keneth-urbizagastegui/S3G4-LAB/S3G4_LAB_rev2.1/03_simulaciones/DMM/AUDITORIA_CLAUDE_S11_1.md

# Auditoría de S11.1 (DMM, bloque 1: bornes y protección)

- Auditor: Claude Code, 7 oct 2026. Ejecutó: Codex. Contrato: `PLAN_SIMULACION_S11_1.md` (§3b, §3c y §7).
- Copia de trabajo: `C:\s11a`. No se ha tocado nada de Codex dentro de `DMM/`. Los scripts de la auditoría están en `DMM/chequeo_claude/` (`comparar_smoke.py`, `auditar_raw.py`, `extrapolar_nunca.py` y `extraer_hojas.py`). El lector `.raw` es propio y no usa `leer_raw_s11_1.py`.
- **Veredicto: el bloque NO se aprueba**, como dice el acta. Los fallos C1, C2 y C3 son físicos. El acta, además, se queda corta en tres puntos: no marca como fallo la TVS (potencia de pulso) ni la PTC (Imax), y C4 no es «orientativo», sino que no se cumple.

## 1. Reejecución

- La copia de `C:\s11a` es idéntica, byte a byte, a `ejecutar_s11_1.py`, `leer_raw_s11_1.py` y los dos `.inc`. Los modelos (OPA2188 y 74HC4051) se copiaron a `C:\s11a\models`, y la ruta se pasó con `S3G4_MODELS`.
- Resultado de `ejecutar_s11_1.py --smoke --keep-raw`: 14/14 casos `ok` en 71 s.
- `comparar_smoke.py`: en los 14 casos se compararon 3974 valores numéricos con `resultados/s11_1_smoke_mixta.csv` y con las mismas filas de `s11_1_campana_mixta.csv`. **Diferencia máxima: 0.** Ningún valor difiere más de 1e-3.
- Recálculo independiente desde el `.raw` con `auditar_raw.py`:

| Caso | Magnitud | Claude (.raw) | Codex |
|---|---|---|---|
| P3, R_S = 100 Ω, apertura a 20 ms, fase 0, 40 Ω | E de la TVS hasta 1 s | 1.8589 J | 1.85903 J (máx. del grupo) |
| P3, R_S = 330 Ω, ídem | E de la TVS / span máx. | 1.8590 J / 20.54 V | 1.85911 J / — |
| P3, R_S = 100 Ω, **nunca** (deck propio: `Brc` = 1) | E de la PTC / E de la TVS / disparo | 50.411 J / 3.2715 J / 35.67 ms | 50.4106 / 3.2715 J (`energias.csv`) / 35.67 ms (máx.) |
| P3 nunca | Extrapolación de 1 a 10 s (PTC / TVS) | 20.065 / 0.643 J | 20.065 / 0.643 J (rechazada) |
| P5, 0.5 Ω, R_S = 100 Ω, fase 0 | Pico de DF08S / I²t hasta 8.3 ms | 386.21 A / 603.68 A²s | 386.213 A / 603.676 A²s |

Todo coincide.

## 2. Netlists frente al plan (§1, §3b y §3c)

- **Valores.** Coinciden con el §1:
  - 3 × 33 kΩ y 3 × 3 MΩ – 900 kΩ – 100 kΩ;
  - 3.3 kΩ + 100 pF, 330 pF y 3 nF;
  - relé con Ron 0.1 Ω, Coff 1 pF y suelta a +3 ms;
  - fusible de 40 mΩ, derivador de 0.100 Ω y 10 MΩ hasta X5;
  - 1 µF por riel y 3 mA de carga total;
  - R_S ∈ {100, 330} Ω y PTC de 40 y 60 Ω.
- **Red.** La fuente es `325.269·sin(2π·60·t + fase)`, es decir, 230 Vrms a 60 Hz. ✔
  - En V/Ω, Rgrid vale 1 µΩ (red ideal, caso pesimista).
  - En el borne A, Rgrid vale 0.5, 1 y 2 Ω.
- **Modelo reducido.** Las páginas citadas se han comprobado:
  - OPA2188, p. 4: ±0.5 V y ±10 mA. ✔
  - 74HC4051, p. 5: VCC de 11 V, ±20 mA de sujeción y ±25 mA de canal. ✔
  - BSS84, p. 2: −50 V, ±20 V, −130 mA, −1.2 A y 300 mW. ✔
  - Las capacidades (OPA p. 5, HC p. 10) y la TLV2372 no se han comprobado una por una.
- **Reparo del modelo reducido.** Las protecciones internas se modelan como diodo ideal con Vfwd = 0.5 V y Ron = 1 Ω. Ese diodo es más «duro» que el BAV199, cuyo modelo tiene IS = 0.8 fA, así que **les roba la corriente a los BAV199 externos** (en P3, I(D2p) ≈ 0 e I(D2n) ≈ 1.3 mA). El reparto entre la protección interna y el BAV199 depende del modelo. Que haya inyección no depende de él (ver §6a).
- **Carga de los rieles en el modelo reducido.** Es solo resistencia entre rp y rn, 3 mA a 9.8 V. Los reguladores no absorben corriente: `REGSUP` es de un solo sentido, como un LDO real.

## 3. P3: estado del relé y de la fuente

Caso de R_S = 100 Ω con apertura a 20 ms:
- **Antes de la apertura**, |V(vin, ptin)| máx. = 0.77 V. Equivale a 7.7 A × 0.1 Ω: el relé está **cerrado** desde t = 0. ✔
- **A partir de t = 23 ms** (20 ms + 3 ms de suelta), I_PTC < 1.3e-7 A y la tensión en los contactos llega a 329.6 V: el relé **se abre**. ✔
- **Fuente.** I(Vsense)(0) = 1.000 mA, que es el estado declarado. Después, I(Vsense) se vuelve negativa (−5.8 mA a 1 ms): es el diodo de cuerpo del BSS84 conduciendo hacia el riel.

## 4. Energías

- Se integran sobre el tiempo simulado real, de 0 a 1 s. La parte extrapolada (de 1 a 10 s) va en columnas separadas. ✔
- **Desviación declarada:** no se corta en el disparo, sino que se simula siempre 1 s. Es aceptable y más conservador.
- **Artefacto en la validación de la extrapolación.**
  - Para el caso «nunca», Codex exige R_PTC ≥ 0.99 MΩ. El propio modelo autorregula en torno a R_PTC ≈ 21 kΩ (θ = 1.25, 10 mA rms).
  - Por eso **las 0/18 extrapolaciones válidas son un criterio inalcanzable**, no una falta de convergencia.
- **Mi extrapolación** (últimos 5 ciclos, dispersión del 5–9 %, así que solo es estimación):

| Pieza | Simulada 0–1 s | Extrapolada 1–10 s | Total en 10 s |
|---|---|---|---|
| TVS | 3.27 J | 0.64 J | 3.91 J (0.071 W medios, frente a 1 W continuo de la p. 2) |
| PTC | 50.4 J | 20.1 J | 70.5 J |
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
