keneth-urbizagastegui/S3G4-LAB/S3G4_LAB_rev2.1/03_simulaciones/DMM/ACTA_S11_1.md

# Acta S11.1 — DMM bloque 1

7 octubre 2026 · Codex · segunda reanudación, contrato PLAN_SIMULACION_S11_1.md §3b–§3c.

**Bloque no aprobado.** La finalización numérica no acredita supervivencia. No se cambiaron piezas ni se simularon remedios.

## Ejecución

Preflight P3: 1/1 ok en 38.044 s. Smoke inicial: 14/14 ok en 67.573 s; smoke tras corregir la carga externa apagada: 14/14 ok en 42.689 s; último smoke de estados con resume: 14/14 ok en 0.033 s, todos conservados por firma. Campaña final con resume: 570 casos, 536 ok, 1969.332 s de pared, diez trabajadores y límite 300 s/caso. `S3G4_MODELS`, `--resume`; prioridad P3, P2, P4, P5, P1, P6, P7. No se reintentaron los casos fallidos con otros ajustes.
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
