keneth-urbizagastegui/S3G4-LAB/hardware/Schematic_PFC-1_2026-07-04/POWER & BATTERY CIRCUITS.png

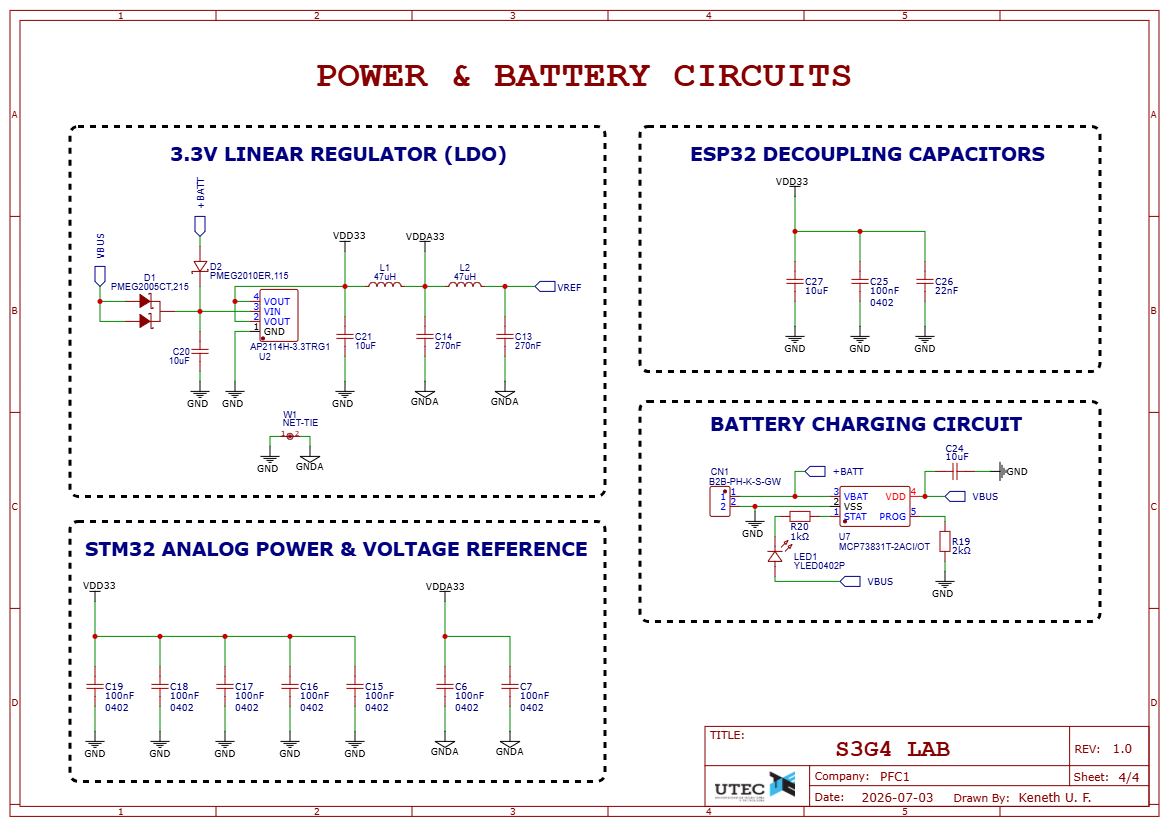
hardware/Schematic_PFC-1_2026-07-04/POWER & BATTERY CIRCUITS.png
