keneth-urbizagastegui/S3G4-LAB/S3G4_LAB_rev2.1/04_esquematicos/S8_CH1/vistas/ch1_1_entrada.png

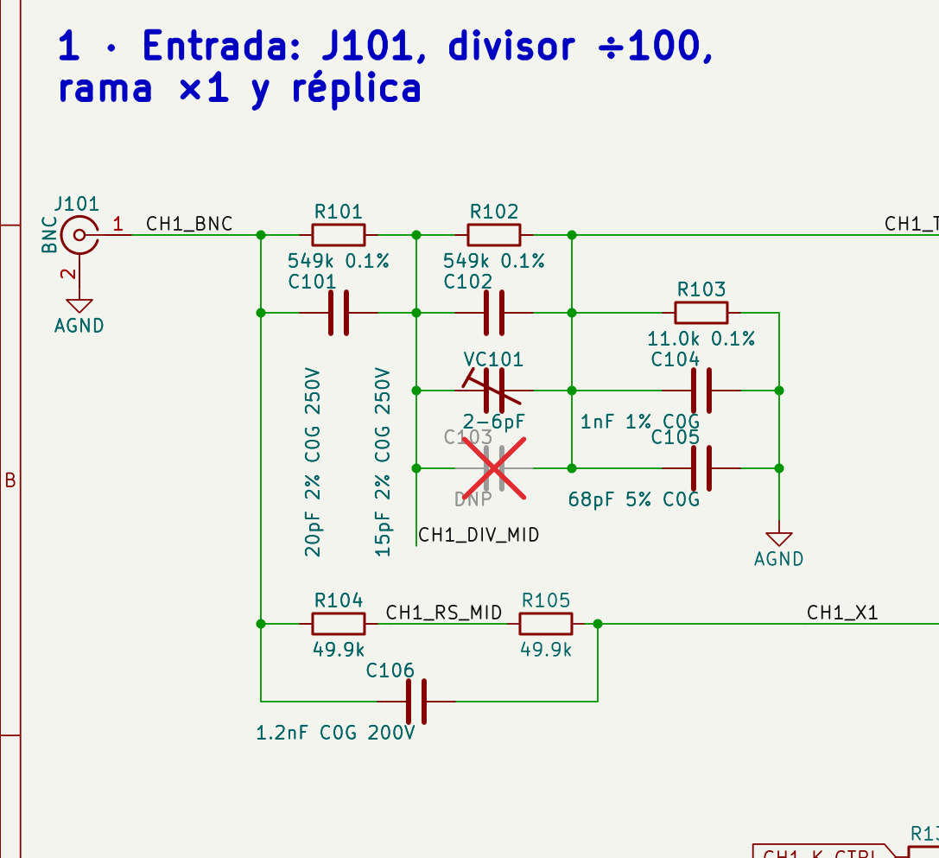
S3G4_LAB_rev2.1/04_esquematicos/S8_CH1/vistas/ch1_1_entrada.png
