keneth-urbizagastegui/S3G4-LAB/S3G4_LAB_rev2.1/04_esquematicos/S10_CH23/vistas/ch2_completa.png

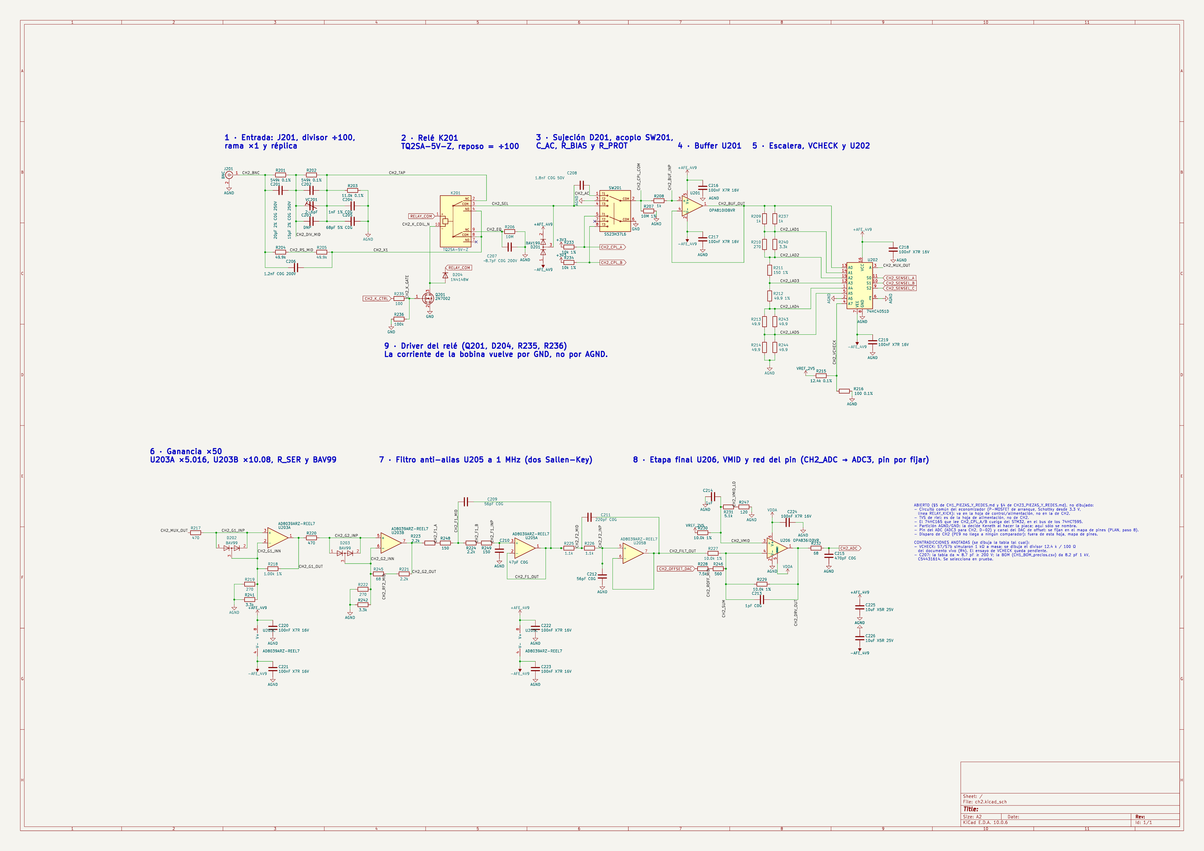
S3G4_LAB_rev2.1/04_esquematicos/S10_CH23/vistas/ch2_completa.png
