keneth-urbizagastegui/S3G4-LAB/TFT_8Bit_Capacitive/test_video_player/plan_antigravity/diseno_ui/referencia/png/AjustesAcercaDe.png

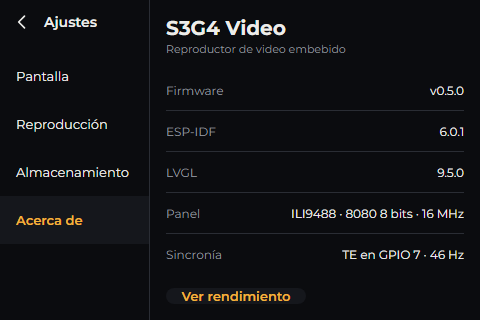
TFT_8Bit_Capacitive/test_video_player/plan_antigravity/diseno_ui/referencia/png/AjustesAcercaDe.png
