keneth-urbizagastegui/S3G4-LAB/S3G4_LAB_rev2.1/03_simulaciones/CH1_entrada/resultados/s1_criterios.csv

criterion | CT1_pF | POS | CPL | value | status
S1-C1 | 20 | 1 | DC | 0.999128 Mohm | PASA
S1-C2 | 20 | 1 | DC | Cin=26.707483 pF; delta=0.540300 pF | PASA
S1-C3 | 20 | 1 | DC | G=0.990260096; error=+0.014289% | PASA
S1-C4 | 20 | 1 | DC | [-0.172068, +0.023425]%; pico=+0.002034 dB | PASA
S1-C5 | 20 | 1 | DC | sobre=0.000000%; e2=-13.841978% | FALLA
S1-C1 | 20 | 1 | AC | 1.000288 Mohm | PASA
S1-C3 | 20 | 1 | AC | G=0.987201435; error=-0.294629% | PASA
S1-C4 | 20 | 1 | AC | fc=8.727515 Hz | PASA
S1-C1 | 20 | 100 | DC | 0.999119 Mohm | PASA
S1-C2 | 20 | 100 | DC | Cin=27.247783 pF; delta=0.540300 pF | PASA
S1-C3 | 20 | 100 | DC | G=0.00990807819; error=+0.000234% | PASA
S1-C4 | 20 | 100 | DC | [-0.153395, +0.040627]%; pico=+0.003528 dB | PASA
S1-C5 | 20 | 100 | DC | sobre=0.000000%; e2=-14.224288% | FALLA
S1-C1 | 20 | 100 | AC | 0.999120 Mohm | PASA
S1-C3 | 20 | 100 | AC | G=0.0098775801; error=-0.307578% | PASA
S1-C4 | 20 | 100 | AC | fc=8.802559 Hz | PASA
S1-C1 | 12 | 1 | DC | 0.999167 Mohm | PASA
S1-C2 | 12 | 1 | DC | Cin=22.747109 pF; delta=0.540305 pF | PASA
S1-C3 | 12 | 1 | DC | G=0.990260096; error=+0.014289% | PASA
S1-C4 | 12 | 1 | DC | [-0.172064, +0.023427]%; pico=+0.002035 dB | PASA
S1-C5 | 12 | 1 | DC | sobre=0.000000%; e2=-10.918397% | FALLA
S1-C1 | 12 | 1 | AC | 1.000348 Mohm | PASA
S1-C3 | 12 | 1 | AC | G=0.987201435; error=-0.294629% | PASA
S1-C4 | 12 | 1 | AC | fc=8.727515 Hz | PASA
S1-C1 | 12 | 100 | DC | 0.999159 Mohm | PASA
S1-C2 | 12 | 100 | DC | Cin=23.287415 pF; delta=0.540305 pF | PASA
S1-C3 | 12 | 100 | DC | G=0.00990806954; error=+0.000146% | PASA
S1-C4 | 12 | 100 | DC | [-0.128443, +0.063479]%; pico=+0.005512 dB | PASA
S1-C5 | 12 | 100 | DC | sobre=0.000000%; e2=-11.314979% | FALLA
S1-C1 | 12 | 100 | AC | 0.999159 Mohm | PASA
S1-C3 | 12 | 100 | AC | G=0.00987757396; error=-0.307639% | PASA
S1-C4 | 12 | 100 | AC | fc=8.802546 Hz | PASA
