keneth-urbizagastegui/S3G4-LAB/hardware/BOM_PFC-1_2026-07-04.csv

ID | Name | Designator | Footprint | Quantity | Manufacturer Part | Manufacturer | Supplier | Supplier Part | Price | Pins | Contributor | JLCPCB Part Class | link
1 | 100pF | C1,C2,C3,C4 | C0603 | 4 | CC0603KRX7R7BB101 | YAGEO(国巨) | LCSC | C519407 | 0.009 | 2 | LCSC | Extended Part
2 | 100nF | C5,C22,C23 | C0603 | 3 | CC0603KRX7R7BB101 | YAGEO(国巨) | LCSC | C519407 | 0.009 | 2 | LCSC | Extended Part
3 | 100nF | C6,C7,C15,C16,C17,C18,C19,C25,C28 | C0402 | 9 | FN15X104K500PKG | PSA(信昌电陶) | LCSC | C525226 | 0.009 | 2 | LCSC | Extended Part
4 | 270nF | C13,C14 | C0402 | 2 | TCC0402X5R274K250AT | CCTC(三环) | LCSC | C5448792 | 0.006 | 2 | lcsc | Extended Part
5 | 10uF | C20,C21 | C0603 | 2 | GRM188R61A106ME69D | muRata(村田) | LCSC | C90053 | 0.099 | 2 | LCSC | Extended Part
6 | 10uF | C24,C27 | C0603 | 2 | CC0603KRX7R7BB101 | YAGEO(国巨) | LCSC | C519407 | 0.009 | 2 | LCSC | Extended Part
7 | 22nF | C26 | C0402 | 1 | FN15X104K500PKG | PSA(信昌电陶) | LCSC | C525226 | 0.009 | 2 | LCSC | Extended Part
8 | 12pF | C29,C30 | C0402 | 2 | CC0402JRNPO9BN120 | YAGEO(国巨) | LCSC | C106201 | 0.003 | 2 |  | Extended Part
9 | 10pF | C31,C32 | C0402 | 2 | CC0402JRNPO9BN100 | YAGEO(国巨) | LCSC | C106199 | 0.003 | 2 |  | Extended Part
10 | 1uF | C33 | C0603 | 1 | FN15X104K500PKG | PSA(信昌电陶) | LCSC | C525226 | 0.009 | 2 | LCSC | Extended Part
11 | B2B-PH-K-S-GW | CN1 | CONN-TH_B2B-PH-K-S | 1 | B2B-PH-K-S-GW | JST | LCSC | C5251182 | 0.148 | 2 | lcsc | Extended Part | https://lcsc.com/eda_search?q=C5251182&%26type=1&ref=editor
12 | PMEG2005CT,215 | D1 | TO-236AB_L2.9-W1.3-P0.95-LS2.3-BR | 1 | PMEG2005CT,215 | Nexperia(安世) | LCSC | C282562 | 0.192 | 3 | LCSC | Extended Part
13 | PMEG2010ER,115 | D2 | SOD-123_L2.6-W1.7-LS3.5-RD | 1 | PMEG2010ER,115 | Nexperia(安世) | LCSC | C82288 | 0.28 | 2 | LCSC | Extended Part
14 | PZ | H2,H4 | HDR-TH_8P-P1.27-V-M-R2-C4-S1.27 | 2 | PZ127V-12-08-0720 | XFCN(兴飞) | LCSC | C541878 | 0.067 | 8 | LCSC | Extended Part
15 | ZX | H3 | HDR-TH_4P-P1.27-V-M-R2-C2-S1.27-2 | 1 | ZX-PZ1.27-2-2PZZ | Megastar(兆星) | LCSC | C41370753 | 0.046 | 4 | lcsc | Extended Part
16 | 47uH | L1,L2 | L0805 | 2 | LQM21DH470M70L | muRata(村田) | LCSC | C2046325 | 0.168 | 2 | lcsc | Extended Part
17 | YLED0402P | LED1 | LED0402-RD | 1 | YLED0402P | YONGYUTAI(永裕泰) | LCSC | C41366936 | 0.016 | 2 | lcsc | Extended Part
18 | 51Ω | R4,R9 | R0603 | 2 | RT0603DRE078K2L | YAGEO(国巨) | LCSC | C863265 | 0.012 | 2 | lcsc | Extended Part | https://lcsc.com/eda_search?q=C863265&%26type=1&ref=editor
19 | 8.2kΩ | R5,R6,R7,R8 | R0603 | 4 | RT0603DRE078K2L | YAGEO(国巨) | LCSC | C863265 | 0.012 | 2 | lcsc | Extended Part | https://lcsc.com/eda_search?q=C863265&%26type=1&ref=editor
20 | 10KΩ | R10 | R0603 | 1 | RT0603DRE078K2L | YAGEO(国巨) | LCSC | C863265 | 0.012 | 2 | lcsc | Extended Part | https://lcsc.com/eda_search?q=C863265&%26type=1&ref=editor
21 | 2.7kΩ | R11,R12,R13,R14 | R0603 | 4 | RT0603DRE078K2L | YAGEO(国巨) | LCSC | C863265 | 0.012 | 2 | lcsc | Extended Part | https://lcsc.com/eda_search?q=C863265&%26type=1&ref=editor
22 | 4.3kΩ | R15,R16,R17,R18 | R0603 | 4 | RT0603DRE078K2L | YAGEO(国巨) | LCSC | C863265 | 0.012 | 2 | lcsc | Extended Part | https://lcsc.com/eda_search?q=C863265&%26type=1&ref=editor
23 | 2kΩ | R19 | R0402 | 1 | RT0402BRE0710KL | YAGEO(国巨) | LCSC | C513708 | 0.025 | 2 | lcsc | Extended Part
24 | 1kΩ | R20 | R0402 | 1 | RT0402BRE0710KL | YAGEO(国巨) | LCSC | C513708 | 0.025 | 2 | lcsc | Extended Part
25 | 5.1kΩ | R21,R22 | R0603 | 2 | RT0603DRE078K2L | YAGEO(国巨) | LCSC | C863265 | 0.012 | 2 | lcsc | Extended Part | https://lcsc.com/eda_search?q=C863265&%26type=1&ref=editor
26 | 10kΩ | R23,R25,R26,R27 | R0402 | 4 | RT0402BRE0710KL | YAGEO(国巨) | LCSC | C513708 | 0.025 | 2 | lcsc | Extended Part
27 | 330Ω | R24 | R0402 | 1 | FRC0402J331 TS | FOJAN(富捷) | LCSC | C2906929 | 0.001 | 2 | lcsc | Extended Part
28 | K1 | SW1,SW2,SW5,SW6 | KEY-SMD_4P-L4.2-W3.2-P2.20-LS4.6 | 4 | SKRPAME010 | ALPSALPINE(阿尔卑斯阿尔派) | LCSC | C19724063 | 0.146 | 4 | lcsc | Extended Part
29 | STM32G473VET6 | U1 | LQFP-100_L14.0-W14.0-P0.50-LS16.0-BL | 1 | STM32G473VET6 | ST(意法半导体) | LCSC | C730122 | 5.285 | 100 | LCSC | Extended Part
30 | AP2114H-3.3TRG1 | U2 | SOT-223_L6.7-W3.5-P2.30-BR | 1 | AP2114H-3.3TRG1 | DIODES(美台) | LCSC | C150716 | 0.21 | 4 | LCSC | Extended Part
31 | ESP32-S3-WROOM-1(N16R8) | U3 | WIRELM-SMD_ESP32-S3-WROOM-1 | 1 | ESP32-S3-WROOM-1-N16R8 | ESPRESSIF(乐鑫) | LCSC | C2913202 | 5.411 | 41 | lcsc | Extended Part
32 | OPA4322AIPWR | U4 | TSSOP-14_L5.0-W4.4-P0.65-LS6.4-TL | 1 | OPA4322AIPWR | TI(德州仪器) | LCSC | C486027 | 1.313 | 14 | lcsc | Extended Part
33 | OPA2322AIDGKR | U5 | VSSOP-8_L3.0-W3.0-P0.65-LS5.0-BL | 1 | OPA2322AIDGKR | TI(德州仪器) | LCSC | C2058180 | 1.059 | 8 | LCSC | Extended Part
34 | I2C Capacitive TOUCHSCREEN, ILI9488 480X320TFT | U6 | COLOR 320X480 TFT TOUCHSCREEN, ILI9488-UNB | 1 | Color Touchscreen |  | PJRC |  |  | 18 | Megascott |  | https://www.pjrc.com/store/display_ili9341_touch.html
35 | MCP73831T-2ACI/OT | U7 | SOT-23-5_L3.0-W1.7-P0.95-LS2.8-BL | 1 | MCP73831T-2ACI/OT | MICROCHIP(美国微芯) | LCSC | C424093 | 0.855 | 5 | LCSC | Extended Part
36 | GSB1C41110SSHR | USB1 | USB-SMD_GSB1C41110SSHR | 1 | GSB1C41110SSHR | Amphenol | LCSC | C34260841 | 0.645 | 16 | lcsc | Extended Part
37 | NET-TIE | W1 | NET-TIE-2.00MM | 1 |  |  |  |  |  | 2 | isabellelimaa
38 | 32.768kHz-7pF | X1 | OSC-SMD_2P-L3.2-W1.5 | 1 | 3131M-32.768DT07NNL | HCI(杭晶) | LCSC | C46598421 | 0.144 | 2 | lcsc | Extended Part
39 | 8MHz-10pF | X2 | CRYSTAL-SMD_4P-L3.2-W2.5-BL | 1 | XC2EL89CMO-114YLC-8M | YXC(扬兴晶振) | LCSC | C20606311 | 0.236 | 4 | lcsc | Extended Part
