keneth-urbizagastegui/S3G4-LAB/S3G4_LAB_rev2.1/03_simulaciones/P4_P7_grueso/resultados/resultados.csv

design | test | measure | value | unit | criterion | pass
P4 | C1 | resumen_criterio | x1=0.9089 Mohm, d100=0.9991 Mohm |  | C1 | FAIL
P4 | C2 | resumen_criterio | x1=21.832 pF, d100=13.878 pF; delta=7.954 pF |  | C2 | FAIL
P4 | C3 | resumen_criterio | peor error=-1.190% |  | C3 | FAIL
P4 | C4 | resumen_criterio | peor planitud=9.419%, perdida1.5MHz=0.142 dB, pico=0.794 dB |  | C4 | FAIL
P4 | C5 | resumen_criterio | 5mV/div=0.366%, 500mV/div=15.826% |  | C5 | FAIL
P4 | C6 | resumen_criterio | 5mV/div=15.54uV (0.311%), 200mV/div=468.44uV (0.234%), 500mV/div=1533.04uV (0.307%) |  | C6 | PASS
P4 | C7 | resumen_criterio | THD=0.0000%, Zin_ef=999.01 kohm |  | C7 | PASS
P4 | C8 | resumen_criterio | low: Rt=16.50V/0.82mW c/u, Rs-base=44.02V/19.38mW, VinAmp=5.98V; safe: Rt=16.50V/0.83mW c/u, Rs-base=0.00V/0.00mW, VinAmp=0.50V |  | C8 | FAIL
P4 | C9 | resumen_criterio | Iclamp_pk peor=3.48mA, VinAmp peor=6.09V |  | C9 | FAIL
P4 | D100 | p4_d100_cin1m | 1.38780273504e-11 | SI
P4 | D100 | p4_d100_zin100 | 999140.222696 | SI
P4 | LOW | p4_low_ac_dhpmax | 0.00347560970113 | SI
P4 | LOW | p4_low_ac_dhpmin | -6.46865814247e-08 | SI
P4 | LOW | p4_low_ac_dlpmax | 0.00347560807131 | SI
P4 | LOW | p4_low_ac_dlpmin | -8.22057515393e-08 | SI
P4 | LOW | p4_low_ac_premax | 6.08832216263 | SI
P4 | LOW | p4_low_ac_premin | -6.08832216263 | SI
P4 | LOW | p4_low_ac_railnmax | 0.00347560807131 | SI
P4 | LOW | p4_low_ac_railnmin | -8.22057444338e-08 | SI
P4 | LOW | p4_low_ac_railpmax | 6.46865743192e-08 | SI
P4 | LOW | p4_low_ac_railpmin | -0.00347560970113 | SI
P4 | LOW | p4_low_ac_rele_d100max | 5.86508070305 | SI
P4 | LOW | p4_low_ac_rele_d100min | -5.85829956457 | SI
P4 | LOW | p4_low_ac_rele_x1max | 0.00034761428833 | SI
P4 | LOW | p4_low_ac_rele_x1min | -0.000348091125488 | SI
P4 | LOW | p4_low_ac_rs_p | 0.598037445785 | SI
P4 | LOW | p4_low_ac_rs_vmax | 347.464734077 | SI
P4 | LOW | p4_low_ac_rs_vmin | -347.464644432 | SI
P4 | LOW | p4_low_ac_rt_p | 0.0618749597336 | SI
P4 | LOW | p4_low_ac_rt_vmax | 350.017815828 | SI
P4 | LOW | p4_low_ac_rt_vmin | -350.017725468 | SI
P4 | LOW | p4_low_ac_tvsmax | 1.74454129365e-07 | SI
P4 | LOW | p4_low_ac_tvsmin | -1.74417749577e-07 | SI
P4 | LOW | p4_low_dc_dhpmax | 0.000439583847765 | SI
P4 | LOW | p4_low_dc_dhpmin | 0.000439583847765 | SI
P4 | LOW | p4_low_dc_dlpmax | -1.19744214544e-11 | SI
P4 | LOW | p4_low_dc_dlpmin | -1.19844871874e-11 | SI
P4 | LOW | p4_low_dc_premax | 5.97911882401 | SI
P4 | LOW | p4_low_dc_premin | 5.97911882401 | SI
P4 | LOW | p4_low_dc_railnmax | -1.19744214544e-11 | SI
P4 | LOW | p4_low_dc_railnmin | -1.19833032386e-11 | SI
P4 | LOW | p4_low_dc_railpmax | -0.000439583847765 | SI
P4 | LOW | p4_low_dc_railpmin | -0.000439583847765 | SI
P4 | LOW | p4_low_dc_rele_d100max | -5.47906452417 | SI
P4 | LOW | p4_low_dc_rele_d100min | -5.47906452417 | SI
P4 | LOW | p4_low_dc_rele_x1max | 4.38690185547e-05 | SI
P4 | LOW | p4_low_dc_rele_x1min | 4.38690185547e-05 | SI
P4 | LOW | p4_low_dc_rs_p | 0.0193783417793 | SI
P4 | LOW | p4_low_dc_rs_vmax | 44.020837307 | SI
P4 | LOW | p4_low_dc_rs_vmin | 44.020837307 | SI
P4 | LOW | p4_low_dc_rt_p | 0.00247499452129 | SI
P4 | LOW | p4_low_dc_rt_vmax | 49.4999457002 | SI
P4 | LOW | p4_low_dc_rt_vmin | 49.4999457002 | SI
P4 | LOW | p4_low_dc_tvsmax | 2.11229593816e-08 | SI
P4 | LOW | p4_low_dc_tvsmin | 2.11228243785e-08 | SI
P4 | PROBE | p4_probe_11p2_bncpk | 11.1852836478 | SI
P4 | PROBE | p4_probe_11p2_iinpk | -1.12011414179e-05 | SI
P4 | PROBE | p4_probe_11p2_salpk | 0.559004128797 | SI
P4 | PROBE | p4_probe_20_bncpk | 19.9737205244 | SI
P4 | PROBE | p4_probe_20_iinpk | -2.00020389564e-05 | SI
P4 | PROBE | p4_probe_20_salpk | 0.998221158981 | SI
P4 | PROBE | p4_probe_40_bncpk | 39.9474372864 | SI
P4 | PROBE | p4_probe_40_iinpk | -4.00040779127e-05 | SI
P4 | PROBE | p4_probe_40_salpk | 1.99643695354 | SI
P4 | PROBE | p4_probe_5_bncpk | 4.99343013109 | SI
P4 | PROBE | p4_probe_5_iinpk | -5.00050973909e-06 | SI
P4 | PROBE | p4_probe_5_salpk | 0.249555453863 | SI
P4 | R10K | p4_r10k_11_bncpk | 10.8909740448 | SI
P4 | R10K | p4_r10k_11_iinpk | -1.09026152434e-05 | SI
P4 | R10K | p4_r10k_11_salpk | 0.544282854421 | SI
P4 | R10K | p4_r10k_20_bncpk | 19.8017711639 | SI
P4 | R10K | p4_r10k_20_iinpk | -1.98229376217e-05 | SI
P4 | R10K | p4_r10k_20_salpk | 0.989604712351 | SI
P4 | R10K | p4_r10k_40_bncpk | 39.6035423279 | SI
P4 | R10K | p4_r10k_40_iinpk | -3.96458752434e-05 | SI
P4 | R10K | p4_r10k_40_salpk | 1.97920417949 | SI
P4 | R10K | p4_r10k_5_bncpk | 4.95044279099 | SI
P4 | R10K | p4_r10k_5_iinpk | -4.95573395692e-06 | SI
P4 | R10K | p4_r10k_5_salpk | 0.247401342 | SI
P4 | R50 | p4_r50_11_bncpk | 10.9994497299 | SI
P4 | R50 | p4_r50_11_iinpk | -1.10103830896e-05 | SI
P4 | R50 | p4_r50_11_salpk | 0.549701274259 | SI
P4 | R50 | p4_r50_20_bncpk | 19.998998642 | SI
P4 | R50 | p4_r50_20_iinpk | -2.00188773662e-05 | SI
P4 | R50 | p4_r50_20_salpk | 0.999456288067 | SI
P4 | R50 | p4_r50_40_bncpk | 39.9979972839 | SI
P4 | R50 | p4_r50_40_iinpk | -4.00377547325e-05 | SI
P4 | R50 | p4_r50_40_salpk | 1.99890721172 | SI
P4 | R50 | p4_r50_5_bncpk | 4.99974966049 | SI
P4 | R50 | p4_r50_5_iinpk | -5.00471934156e-06 | SI
P4 | R50 | p4_r50_5_salpk | 0.249864235929 | SI
P4 | S200 | p4_s200_f3 | 7946756.96317 | SI
P4 | S200 | p4_s200_g100 | 1.23512430637 | SI
P4 | S200 | p4_s200_g100k | 1.23270653 | SI
P4 | S200 | p4_s200_g1m5 | 1.21504899841 | SI
P4 | S200 | p4_s200_gmax | 1.23513347675 | SI
P4 | S200 | p4_s200_gmin | 1.23270653 | SI
P4 | S200 | p4_s200_peak | 1.23513347675 | SI
P4 | S500 | p4_s500_f3 | 9538421.95979 | SI
P4 | S500 | p4_s500_g100 | 0.499891401966 | SI
P4 | S500 | p4_s500_g100k | 0.546973086443 | SI
P4 | S500 | p4_s500_g1m5 | 0.540387583738 | SI
P4 | S500 | p4_s500_gmax | 0.546973086443 | SI
P4 | S500 | p4_s500_gmin | 0.499889438449 | SI
P4 | S500 | p4_s500_peak | 0.547759754213 | SI
P4 | S500 | p4_s500_v200us | 0.749835908413 | SI
P4 | S500 | p4_s500_v20us | 0.769177037382 | SI
P4 | S500 | p4_s500_v2us | 0.868506053161 | SI
P4 | S500 | p4_s500_vsettled | 0.749834358692 | SI
P4 | S5 | p4_s5_f3 | 8034859.48526 | SI
P4 | S5 | p4_s5_g100 | 49.4888742661 | SI
P4 | S5 | p4_s5_g100k | 49.3918160241 | SI
P4 | S5 | p4_s5_g1m5 | 48.6920999209 | SI
P4 | S5 | p4_s5_gmax | 49.4892425546 | SI
P4 | S5 | p4_s5_gmin | 49.3918160241 | SI
P4 | S5 | p4_s5_peak | 49.4892425546 | SI
P4 | S5 | p4_s5_v200us | 0.741954302413 | SI
P4 | S5 | p4_s5_v20us | 0.740021277667 | SI
P4 | S5 | p4_s5_v2us | 0.739566388288 | SI
P4 | S5 | p4_s5_vsettled | 0.742286503315 | SI
P4 | S5V | p4_s5v_f3 | 9257114.1702 | SI
P4 | S5V | p4_s5v_g100 | 0.0499541982119 | SI
P4 | S5V | p4_s5v_g100k | 0.0546591686104 | SI
P4 | S5V | p4_s5v_g1m5 | 0.0539728347297 | SI
P4 | S5V | p4_s5v_gmax | 0.0546591686104 | SI
P4 | S5V | p4_s5v_gmin | 0.0499540019892 | SI
P4 | S5V | p4_s5v_peak | 0.0547371916079 | SI
P4 | SAFE | p4_safe_ac_dhpmax | 8.64562033076e-10 | SI
P4 | SAFE | p4_safe_ac_dhpmin | -8.7508694735e-10 | SI
P4 | SAFE | p4_safe_ac_dlpmax | 8.64559979163e-10 | SI
P4 | SAFE | p4_safe_ac_dlpmin | -8.75084282814e-10 | SI
P4 | SAFE | p4_safe_ac_premax | 3.5355052948 | SI
P4 | SAFE | p4_safe_ac_premin | -3.53550505638 | SI
P4 | SAFE | p4_safe_ac_railnmax | 8.64559979163e-10 | SI
P4 | SAFE | p4_safe_ac_railnmin | -8.7508311708e-10 | SI
P4 | SAFE | p4_safe_ac_railpmax | 8.75086669794e-10 | SI
P4 | SAFE | p4_safe_ac_railpmin | -8.64562643699e-10 | SI
P4 | SAFE | p4_safe_ac_rele_d100max | 2.38418579102e-07 | SI
P4 | SAFE | p4_safe_ac_rele_d100min | -2.38418579102e-07 | SI
P4 | SAFE | p4_safe_ac_rele_x1max | 349.982530594 | SI
P4 | SAFE | p4_safe_ac_rele_x1min | -349.982440948 | SI
P4 | SAFE | p4_safe_ac_rs_p | 6.7344072557e-09 | SI
P4 | SAFE | p4_safe_ac_rs_vmax | 0.0367126464844 | SI
P4 | SAFE | p4_safe_ac_rs_vmin | -0.0367126464844 | SI
P4 | SAFE | p4_safe_ac_rt_p | 0.0618749845241 | SI
P4 | SAFE | p4_safe_ac_rt_vmax | 350.017869949 | SI
P4 | SAFE | p4_safe_ac_rt_vmin | -350.017780304 | SI
P4 | SAFE | p4_safe_ac_tvsmax | 1.0900285119e-09 | SI
P4 | SAFE | p4_safe_ac_tvsmin | -1.08994457904e-09 | SI
P4 | SAFE | p4_safe_dc_dhpmax | -5.49997070456e-12 | SI
P4 | SAFE | p4_safe_dc_dhpmin | -5.50008172687e-12 | SI
P4 | SAFE | p4_safe_dc_dlpmax | -6.49968967537e-12 | SI
P4 | SAFE | p4_safe_dc_dlpmin | -6.50087405782e-12 | SI
P4 | SAFE | p4_safe_dc_premax | 0.499995470047 | SI
P4 | SAFE | p4_safe_dc_premin | 0.499995470047 | SI
P4 | SAFE | p4_safe_dc_railnmax | -6.49968967537e-12 | SI
P4 | SAFE | p4_safe_dc_railnmin | -6.49968967537e-12 | SI
P4 | SAFE | p4_safe_dc_railpmax | 5.5004889532e-12 | SI
P4 | SAFE | p4_safe_dc_railpmin | 5.49871259636e-12 | SI
P4 | SAFE | p4_safe_dc_rele_d100max | 0 | SI
P4 | SAFE | p4_safe_dc_rele_d100min | 0 | SI
P4 | SAFE | p4_safe_dc_rele_x1max | 49.4950492382 | SI
P4 | SAFE | p4_safe_dc_rele_x1min | 49.4950492382 | SI
P4 | SAFE | p4_safe_dc_rs_p | 2.45507681161e-10 | SI
P4 | SAFE | p4_safe_dc_rs_vmax | 0.00495529174805 | SI
P4 | SAFE | p4_safe_dc_rs_vmin | 0.00495529174805 | SI
P4 | SAFE | p4_safe_dc_rt_p | 0.00247500052413 | SI
P4 | SAFE | p4_safe_dc_rt_vmax | 49.50000453 | SI
P4 | SAFE | p4_safe_dc_rt_vmin | 49.50000453 | SI
P4 | SAFE | p4_safe_dc_tvsmax | 3.76143560743e-13 | SI
P4 | SAFE | p4_safe_dc_tvsmin | 3.75588449231e-13 | SI
P4 | X1 | p4_x1_cin1m | 2.18323287956e-11 | SI
P4 | X1 | p4_x1_zin100 | 908917.116238 | SI
P4 | STEP | p4_noise_integrated[1] | 0.000768963690221 | SI
P4 | STEP | p4_noise_integrated[2] | 0.000578580939566 | SI
P4 | STEP | p4_noise_integrated[3] | 0.000766353820581 | SI
P4 | STEP | p4_wc_g100k[1] | 0.546973324706 | SI
P4 | STEP | p4_wc_g100k[2] | 0.546972921011 | SI
P4 | STEP | p4_wc_g100k[3] | 0.546973176428 | SI
P4 | STEP | p4_wc_g100k[4] | 0.546973060805 | SI
P4 | STEP | p4_wc_g100k[5] | 0.546973034953 | SI
P4 | STEP | p4_wc_g100k[6] | 0.546973229412 | SI
P4 | STEP | p4_wc_g100k[7] | 0.546972865835 | SI
P4 | STEP | p4_wc_g100k[8] | 0.546973340368 | SI
P4 | STEP | p4_wc_g100k[9] | 0.546972825387 | SI
P4 | STEP | p4_wc_g100k[10] | 0.546973349263 | SI
P4 | STEP | p4_wc_g100k[11] | 0.546972834469 | SI
P4 | STEP | p4_wc_g100k[12] | 0.546973284982 | SI
P4 | STEP | p4_wc_g100k[13] | 0.546972973532 | SI
P4 | STEP | p4_wc_g100k[14] | 0.546973113597 | SI
P4 | STEP | p4_wc_g100k[15] | 0.546973126541 | SI
P4 | STEP | p4_wc_g100k[16] | 0.546972975228 | SI
P4 | STEP | p4_wc_g100k[17] | 0.546973278268 | SI
P4 | STEP | p4_wc_g100k[18] | 0.54697282956 | SI
P4 | STEP | p4_wc_g100k[19] | 0.546973360913 | SI
P4 | STEP | p4_wc_g100k[20] | 0.54697282518 | SI
P4 | STEP | p4_wc_g100k[21] | 0.546973327881 | SI
P4 | STEP | p4_wc_g100k[22] | 0.546972873083 | SI
P4 | STEP | p4_wc_g100k[23] | 0.546973234834 | SI
P4 | STEP | p4_wc_g100k[24] | 0.546973032431 | SI
P4 | STEP | p4_wc_g100k[25] | 0.546973048826 | SI
P4 | STEP | p4_wc_g100k[26] | 0.546973189919 | SI
P4 | STEP | p4_wc_g100k[27] | 0.546972921996 | SI
P4 | STEP | p4_wc_g100k[28] | 0.546973316692 | SI
P4 | STEP | p4_wc_g100k[29] | 0.546972806727 | SI
P4 | STEP | p4_wc_g100k[30] | 0.546973366704 | SI
P4 | STEP | p4_wc_g100k[31] | 0.546972839544 | SI
P4 | STEP | p4_wc_g100k[32] | 0.546973293081 | SI
P4 | STEP | p4_wc_g100k[33] | 0.546972922897 | SI
P4 | STEP | p4_wc_g100k[34] | 0.546973177024 | SI
P4 | STEP | p4_wc_g100k[35] | 0.546973094459 | SI
P4 | STEP | p4_wc_g100k[36] | 0.546972985611 | SI
P4 | STEP | p4_wc_g100k[37] | 0.546973247565 | SI
P4 | STEP | p4_wc_g100k[38] | 0.546972878149 | SI
P4 | STEP | p4_wc_g100k[39] | 0.546973342531 | SI
P4 | STEP | p4_wc_g100k[40] | 0.546972798588 | SI
P4 | STEP | p4_wc_g100k[41] | 0.546973357493 | SI
P4 | STEP | p4_wc_g100k[42] | 0.546972867669 | SI
P4 | STEP | p4_wc_g100k[43] | 0.546973246701 | SI
P4 | STEP | p4_wc_g100k[44] | 0.546972981253 | SI
P4 | STEP | p4_wc_g100k[45] | 0.546973114721 | SI
P4 | STEP | p4_wc_g100k[46] | 0.546973156192 | SI
P4 | STEP | p4_wc_g100k[47] | 0.546972927366 | SI
P4 | STEP | p4_wc_g100k[48] | 0.546973296423 | SI
P4 | STEP | p4_wc_g100k[49] | 0.546972846055 | SI
P4 | STEP | p4_wc_g100k[50] | 0.546973354318 | SI
P4 | STEP | p4_wc_g100k[51] | 0.546972805608 | SI
P4 | STEP | p4_wc_g100k[52] | 0.54697333384 | SI
P4 | STEP | p4_wc_g100k[53] | 0.546972907987 | SI
P4 | STEP | p4_wc_g100k[54] | 0.546973191215 | SI
P4 | STEP | p4_wc_g100k[55] | 0.546973045039 | SI
P4 | STEP | p4_wc_g100k[56] | 0.546973051327 | SI
P4 | STEP | p4_wc_g100k[57] | 0.546973214219 | SI
P4 | STEP | p4_wc_g100k[58] | 0.546972877249 | SI
P4 | STEP | p4_wc_g100k[59] | 0.54697333391 | SI
P4 | STEP | p4_wc_g100k[60] | 0.546972827441 | SI
P4 | STEP | p4_wc_g100k[61] | 0.546973351349 | SI
P4 | STEP | p4_wc_g100k[62] | 0.546972827433 | SI
P4 | STEP | p4_wc_g100k[63] | 0.546973297084 | SI
P4 | STEP | p4_wc_g100k[64] | 0.546972958266 | SI
P4 | STEP | p4_wc_g100k[65] | 0.546973129595 | SI
P4 | STEP | p4_wc_g100k[66] | 0.546973110849 | SI
P4 | STEP | p4_wc_g100k[67] | 0.546972990299 | SI
P4 | STEP | p4_wc_g100k[68] | 0.546973265328 | SI
P4 | STEP | p4_wc_g100k[69] | 0.546972837981 | SI
P4 | STEP | p4_wc_g100k[70] | 0.546973358066 | SI
P4 | STEP | p4_wc_g100k[71] | 0.546972823292 | SI
P4 | STEP | p4_wc_g100k[72] | 0.546973333726 | SI
P4 | STEP | p4_wc_g100k[73] | 0.546972862913 | SI
P4 | STEP | p4_wc_g100k[74] | 0.546973249266 | SI
P4 | STEP | p4_wc_g100k[75] | 0.546973015727 | SI
P4 | STEP | p4_wc_g100k[76] | 0.546973065161 | SI
P4 | STEP | p4_wc_g100k[77] | 0.546973175178 | SI
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
P4 | STEP | p4_wc_step2us_proxy[180] | 9.57560648244 | SI
P4 | STEP | p4_wc_step2us_proxy[181] | 9.57558954226 | SI
P4 | STEP | p4_wc_step2us_proxy[182] | 9.57557844707 | SI
P4 | STEP | p4_wc_step2us_proxy[183] | 9.57560273682 | SI
P4 | STEP | p4_wc_step2us_proxy[184] | 9.57560230444 | SI
P4 | STEP | p4_wc_step2us_proxy[185] | 9.57558215785 | SI
P4 | STEP | p4_wc_step2us_proxy[186] | 9.5755857327 | SI
P4 | STEP | p4_wc_step2us_proxy[187] | 9.57560687248 | SI
P4 | STEP | p4_wc_step2us_proxy[188] | 9.57559553298 | SI
P4 | STEP | p4_wc_step2us_proxy[189] | 9.57557766005 | SI
P4 | STEP | p4_wc_step2us_proxy[190] | 9.5755960821 | SI
P4 | STEP | p4_wc_step2us_proxy[191] | 9.57560590543 | SI
P4 | STEP | p4_wc_step2us_proxy[192] | 9.57558782776 | SI
P4 | STEP | p4_wc_step2us_proxy[193] | 9.57557951026 | SI
P4 | STEP | p4_wc_step2us_proxy[194] | 9.57560409171 | SI
P4 | STEP | p4_wc_step2us_proxy[195] | 9.57560097315 | SI
P4 | STEP | p4_wc_step2us_proxy[196] | 9.57558083736 | SI
P4 | STEP | p4_wc_step2us_proxy[197] | 9.57558789677 | SI
P4 | STEP | p4_wc_step2us_proxy[198] | 9.57560710179 | SI
P4 | STEP | p4_wc_step2us_proxy[199] | 9.5755938446 | SI
P4 | STEP | p4_wc_step2us_proxy[200] | 9.57557747771 | SI
P7 | C1 | resumen_criterio | fina=0.9998 Mohm, gruesa=0.9998 Mohm |  | C1 | PASS
P7 | C2 | resumen_criterio | fina=18.609 pF, gruesa=18.609 pF; delta=0.000 pF |  | C2 | PASS
P7 | C3 | resumen_criterio | peor error=-0.199% |  | C3 | PASS
P7 | C4 | resumen_criterio | peor planitud=14.881%, perdida1.5MHz=1.429 dB, pico=3.203 dB |  | C4 | FAIL
P7 | C5 | resumen_criterio | 5mV/div=22.276%, 500mV/div=0.091% |  | C5 | FAIL
P7 | C6 | resumen_criterio | 5mV/div=44.52uV (0.890%), 200mV/div=906.04uV (0.453%), 500mV/div=3573.66uV (0.715%) |  | C6 | PASS
P7 | C7 | resumen_criterio | THD=0.0154%, Zin_ef=738.57 kohm |  | C7 | FAIL
P7 | C8 | resumen_criterio | low: rtf=14.71V/0.65mW c/u, rtg=16.58V/0.41mW c/u, VinAmp=5.86V; safe: rtf=14.71V/0.65mW c/u, rtg=16.58V/0.41mW c/u, VinAmp=5.86V |  | C8 | FAIL
P7 | C9 | resumen_criterio | Iclamp_pk peor=0.34mA, VinAmp peor=5.97V |  | C9 | FAIL
P7 | FINA | p7_fina_cin1m | 1.86088159917e-11 | SI
P7 | FINA | p7_fina_zin100 | 999806.927769 | SI
P7 | GRUESA | p7_gruesa_cin1m | 1.86088158845e-11 | SI
P7 | GRUESA | p7_gruesa_zin100 | 999806.927769 | SI
P7 | LOW | p7_low_ac_dhfmax | 0.000341607257724 | SI
P7 | LOW | p7_low_ac_dhfmin | -8.79933423903e-08 | SI
P7 | LOW | p7_low_ac_dlfmax | 0.000341606762959 | SI
P7 | LOW | p7_low_ac_dlfmin | -8.53889829955e-08 | SI
P7 | LOW | p7_low_ac_finomax | 5.96601295471 | SI
P7 | LOW | p7_low_ac_finomin | -5.96601295471 | SI
P7 | LOW | p7_low_ac_gruesomax | 1.76776683331 | SI
P7 | LOW | p7_low_ac_gruesomin | -1.76776683331 | SI
P7 | LOW | p7_low_ac_railnmax | -0.000126810744405 | SI
P7 | LOW | p7_low_ac_railnmin | -0.000999937648885 | SI
P7 | LOW | p7_low_ac_railpmax | 0.000999926938675 | SI
P7 | LOW | p7_low_ac_railpmin | 0.000126815939439 | SI
P7 | LOW | p7_low_ac_rtf_p | 0.0598568092827 | SI
P7 | LOW | p7_low_ac_rtf_vmax | 347.587362766 | SI
P7 | LOW | p7_low_ac_rtf_vmin | -347.587362766 | SI
P7 | LOW | p7_low_ac_rtg_p | 0.0310937372034 | SI
P7 | LOW | p7_low_ac_rtg_vmax | 351.785608411 | SI
P7 | LOW | p7_low_ac_rtg_vmin | -351.785608411 | SI
P7 | LOW | p7_low_ac_tvsmax | 4.89888840605e-08 | SI
P7 | LOW | p7_low_ac_tvsmin | -4.83423221453e-08 | SI
P7 | LOW | p7_low_dc_dhfmax | 3.8282632886e-05 | SI
P7 | LOW | p7_low_dc_dhfmin | 3.8282632886e-05 | SI
P7 | LOW | p7_low_dc_dlfmax | -1.18565894949e-11 | SI
P7 | LOW | p7_low_dc_dlfmin | -1.18577743111e-11 | SI
P7 | LOW | p7_low_dc_finomax | 5.85766458511 | SI
P7 | LOW | p7_low_dc_finomin | 5.85766458511 | SI
P7 | LOW | p7_low_dc_gruesomax | 0.25 | SI
P7 | LOW | p7_low_dc_gruesomin | 0.25 | SI
P7 | LOW | p7_low_dc_railnmax | -0.000500692171045 | SI
P7 | LOW | p7_low_dc_railnmin | -0.000500692171045 | SI
P7 | LOW | p7_low_dc_railpmax | 0.000461798656033 | SI
P7 | LOW | p7_low_dc_railpmin | 0.000461798656033 | SI
P7 | LOW | p7_low_dc_rtf_p | 0.00194854581338 | SI
P7 | LOW | p7_low_dc_rtf_vmax | 44.1423354149 | SI
P7 | LOW | p7_low_dc_rtf_vmin | 44.1423354149 | SI
P7 | LOW | p7_low_dc_rtg_p | 0.00124374996858 | SI
P7 | LOW | p7_low_dc_rtg_vmax | 49.75 | SI
P7 | LOW | p7_low_dc_rtg_vmin | 49.75 | SI
P7 | LOW | p7_low_dc_tvsmax | 2.02145500339e-09 | SI
P7 | LOW | p7_low_dc_tvsmin | 2.02144967432e-09 | SI
P7 | PROBE | p7_probe_11p2_bncpk | 11.2010353794 | SI
P7 | PROBE | p7_probe_11p2_iinpk | -1.12052652293e-05 | SI
P7 | PROBE | p7_probe_11p2_salpk | 0.559545094728 | SI
P7 | PROBE | p7_probe_20_bncpk | 17.4318406963 | SI
P7 | PROBE | p7_probe_20_iinpk | -2.02953059742e-05 | SI
P7 | PROBE | p7_probe_20_salpk | 0.870802033602 | SI
P7 | PROBE | p7_probe_40_bncpk | 31.3229213123 | SI
P7 | PROBE | p7_probe_40_iinpk | -4.09839247512e-05 | SI
P7 | PROBE | p7_probe_40_salpk | 1.56472394848 | SI
P7 | PROBE | p7_probe_5_bncpk | 5.01435371208 | SI
P7 | PROBE | p7_probe_5_iinpk | -5.00036616129e-06 | SI
P7 | PROBE | p7_probe_5_salpk | 0.250489560246 | SI
P7 | R10K | p7_r10k_11_bncpk | 10.8910293579 | SI
P7 | R10K | p7_r10k_11_iinpk | -1.08970439369e-05 | SI
P7 | R10K | p7_r10k_11_salpk | 0.544054687023 | SI
P7 | R10K | p7_r10k_20_bncpk | 19.7613373203 | SI
P7 | R10K | p7_r10k_20_iinpk | -2.38661804814e-05 | SI
P7 | R10K | p7_r10k_20_salpk | 0.987161339581 | SI
P7 | R10K | p7_r10k_40_bncpk | 39.4663238525 | SI
P7 | R10K | p7_r10k_40_iinpk | -5.33676046869e-05 | SI
P7 | R10K | p7_r10k_40_salpk | 1.97150266171 | SI
P7 | R10K | p7_r10k_5_bncpk | 4.95048522949 | SI
P7 | R10K | p7_r10k_5_iinpk | -4.95146312413e-06 | SI
P7 | R10K | p7_r10k_5_salpk | 0.247299417853 | SI
P7 | R50 | p7_r50_11_bncpk | 10.9994497299 | SI
P7 | R50 | p7_r50_11_iinpk | -1.10104197083e-05 | SI
P7 | R50 | p7_r50_11_salpk | 0.549470841885 | SI
P7 | R50 | p7_r50_20_bncpk | 19.9987888336 | SI
P7 | R50 | p7_r50_20_iinpk | -2.42169907396e-05 | SI
P7 | R50 | p7_r50_20_salpk | 0.999023318291 | SI
P7 | R50 | p7_r50_40_bncpk | 39.9972915649 | SI
P7 | R50 | p7_r50_40_iinpk | -5.41551251589e-05 | SI
P7 | R50 | p7_r50_40_salpk | 1.99802732468 | SI
P7 | R50 | p7_r50_5_bncpk | 4.99975013733 | SI
P7 | R50 | p7_r50_5_iinpk | -5.00006151877e-06 | SI
P7 | R50 | p7_r50_5_salpk | 0.249760389328 | SI
P7 | S200 | p7_s200_f3 | 4650699.10136 | SI
P7 | S200 | p7_s200_g100 | 1.24751873943 | SI
P7 | S200 | p7_s200_g100k | 1.08631003153 | SI
P7 | S200 | p7_s200_g1m5 | 1.05844810056 | SI
P7 | S200 | p7_s200_gmax | 1.24752670224 | SI
P7 | S200 | p7_s200_gmin | 1.08631003153 | SI
P7 | S200 | p7_s200_peak | 1.24752670224 | SI
P7 | S500 | p7_s500_f3 | 29517477.7586 | SI
P7 | S500 | p7_s500_g100 | 0.499868838319 | SI
P7 | S500 | p7_s500_g100k | 0.500285127447 | SI
P7 | S500 | p7_s500_g1m5 | 0.528373424711 | SI
P7 | S500 | p7_s500_gmax | 0.500285127447 | SI
P7 | S500 | p7_s500_gmin | 0.499868823347 | SI
P7 | S500 | p7_s500_peak | 0.722811063982 | SI
P7 | S500 | p7_s500_v200us | 0.749803245068 | SI
P7 | S500 | p7_s500_v20us | 0.749944984913 | SI
P7 | S500 | p7_s500_v2us | 0.750488620954 | SI
P7 | S500 | p7_s500_vsettled | 0.749803245068 | SI
P7 | S5 | p7_s5_f3 | 4689770.37936 | SI
P7 | S5 | p7_s5_g100 | 49.9854882187 | SI
P7 | S5 | p7_s5_g100k | 43.5109264142 | SI
P7 | S5 | p7_s5_g1m5 | 42.4026403834 | SI
P7 | S5 | p7_s5_gmax | 49.9858082006 | SI
P7 | S5 | p7_s5_gmin | 43.5109264142 | SI
P7 | S5 | p7_s5_peak | 49.9858082006 | SI
P7 | S5 | p7_s5_v200us | 0.749787211418 | SI
P7 | S5 | p7_s5_v20us | 0.714768224191 | SI
P7 | S5 | p7_s5_v2us | 0.582766233399 | SI
P7 | S5 | p7_s5_vsettled | 0.749787211418 | SI
P7 | S5V | p7_s5v_f3 | 26191584.4216 | SI
P7 | S5V | p7_s5v_g100 | 0.0499519472556 | SI
P7 | S5V | p7_s5v_g100k | 0.0499934296631 | SI
P7 | S5V | p7_s5v_g1m5 | 0.0527727052263 | SI
P7 | S5V | p7_s5v_gmax | 0.0499934296631 | SI
P7 | S5V | p7_s5v_gmin | 0.0499519457598 | SI
P7 | S5V | p7_s5v_peak | 0.0711687236184 | SI
P7 | SAFE | p7_safe_ac_dhfmax | 0.000341607286828 | SI
P7 | SAFE | p7_safe_ac_dhfmin | -9.14490883019e-08 | SI
P7 | SAFE | p7_safe_ac_dlfmax | 0.000341606821166 | SI
P7 | SAFE | p7_safe_ac_dlfmin | -8.77139783029e-08 | SI
P7 | SAFE | p7_safe_ac_finomax | 5.96601295471 | SI
P7 | SAFE | p7_safe_ac_finomin | -5.96601295471 | SI
P7 | SAFE | p7_safe_ac_gruesomax | 1.76776683331 | SI
P7 | SAFE | p7_safe_ac_gruesomin | -1.76776683331 | SI
P7 | SAFE | p7_safe_ac_railnmax | -0.000126814193209 | SI
P7 | SAFE | p7_safe_ac_railnmin | -0.0009999104077 | SI
P7 | SAFE | p7_safe_ac_railpmax | 0.000999855576083 | SI
P7 | SAFE | p7_safe_ac_railpmin | 0.000126819315483 | SI
P7 | SAFE | p7_safe_ac_rtf_p | 0.0598568092826 | SI
P7 | SAFE | p7_safe_ac_rtf_vmax | 347.587362766 | SI
P7 | SAFE | p7_safe_ac_rtf_vmin | -347.587362766 | SI
P7 | SAFE | p7_safe_ac_rtg_p | 0.0310937372034 | SI
P7 | SAFE | p7_safe_ac_rtg_vmax | 351.785608411 | SI
P7 | SAFE | p7_safe_ac_rtg_vmin | -351.785608411 | SI
P7 | SAFE | p7_safe_ac_tvsmax | 4.90038374323e-08 | SI
P7 | SAFE | p7_safe_ac_tvsmin | -4.83617093039e-08 | SI
P7 | SAFE | p7_safe_dc_dhfmax | 3.8282632886e-05 | SI
P7 | SAFE | p7_safe_dc_dhfmin | 3.8282632886e-05 | SI
P7 | SAFE | p7_safe_dc_dlfmax | -1.18565894949e-11 | SI
P7 | SAFE | p7_safe_dc_dlfmin | -1.18577743111e-11 | SI
P7 | SAFE | p7_safe_dc_finomax | 5.85766458511 | SI
P7 | SAFE | p7_safe_dc_finomin | 5.85766458511 | SI
P7 | SAFE | p7_safe_dc_gruesomax | 0.25 | SI
P7 | SAFE | p7_safe_dc_gruesomin | 0.25 | SI
P7 | SAFE | p7_safe_dc_railnmax | -0.000500692171045 | SI
P7 | SAFE | p7_safe_dc_railnmin | -0.000500692171045 | SI
P7 | SAFE | p7_safe_dc_railpmax | 0.000461798656033 | SI
P7 | SAFE | p7_safe_dc_railpmin | 0.000461798656033 | SI
P7 | SAFE | p7_safe_dc_rtf_p | 0.00194854581338 | SI
P7 | SAFE | p7_safe_dc_rtf_vmax | 44.1423354149 | SI
P7 | SAFE | p7_safe_dc_rtf_vmin | 44.1423354149 | SI
P7 | SAFE | p7_safe_dc_rtg_p | 0.00124374996858 | SI
P7 | SAFE | p7_safe_dc_rtg_vmax | 49.75 | SI
P7 | SAFE | p7_safe_dc_rtg_vmin | 49.75 | SI
P7 | SAFE | p7_safe_dc_tvsmax | 2.02145500339e-09 | SI
P7 | SAFE | p7_safe_dc_tvsmin | 2.02144967432e-09 | SI
P7 | STEP | p7_noise_integrated[1] | 0.0022254677289 | SI
P7 | STEP | p7_noise_integrated[2] | 0.00113029947031 | SI
P7 | STEP | p7_noise_integrated[3] | 0.00178636138899 | SI
P7 | STEP | p7_wc_g100k[1] | 0.500285350177 | SI
P7 | STEP | p7_wc_g100k[2] | 0.500284977319 | SI
P7 | STEP | p7_wc_g100k[3] | 0.50028520722 | SI
P7 | STEP | p7_wc_g100k[4] | 0.500285102085 | SI
P7 | STEP | p7_wc_g100k[5] | 0.500285083821 | SI
P7 | STEP | p7_wc_g100k[6] | 0.500285260021 | SI
P7 | STEP | p7_wc_g100k[7] | 0.50028491944 | SI
P7 | STEP | p7_wc_g100k[8] | 0.500285362906 | SI
P7 | STEP | p7_wc_g100k[9] | 0.500284890091 | SI
P7 | STEP | p7_wc_g100k[10] | 0.500285368387 | SI
P7 | STEP | p7_wc_g100k[11] | 0.500284891317 | SI
P7 | STEP | p7_wc_g100k[12] | 0.500285313872 | SI
P7 | STEP | p7_wc_g100k[13] | 0.500285025409 | SI
P7 | STEP | p7_wc_g100k[14] | 0.500285148872 | SI
P7 | STEP | p7_wc_g100k[15] | 0.500285163358 | SI
P7 | STEP | p7_wc_g100k[16] | 0.500285028751 | SI
P7 | STEP | p7_wc_g100k[17] | 0.500285304627 | SI
P7 | STEP | p7_wc_g100k[18] | 0.500284885966 | SI
P7 | STEP | p7_wc_g100k[19] | 0.500285382412 | SI
P7 | STEP | p7_wc_g100k[20] | 0.500284889668 | SI
P7 | STEP | p7_wc_g100k[21] | 0.500285348171 | SI
P7 | STEP | p7_wc_g100k[22] | 0.500284927384 | SI
P7 | STEP | p7_wc_g100k[23] | 0.500285267884 | SI
P7 | STEP | p7_wc_g100k[24] | 0.500285079353 | SI
P7 | STEP | p7_wc_g100k[25] | 0.500285088796 | SI
P7 | STEP | p7_wc_g100k[26] | 0.500285222467 | SI
P7 | STEP | p7_wc_g100k[27] | 0.500284979607 | SI
P7 | STEP | p7_wc_g100k[28] | 0.500285339597 | SI
P7 | STEP | p7_wc_g100k[29] | 0.500284864993 | SI
P7 | STEP | p7_wc_g100k[30] | 0.500285388261 | SI
P7 | STEP | p7_wc_g100k[31] | 0.500284902642 | SI
P7 | STEP | p7_wc_g100k[32] | 0.500285315596 | SI
P7 | STEP | p7_wc_g100k[33] | 0.500284973855 | SI
P7 | STEP | p7_wc_g100k[34] | 0.500285214759 | SI
P7 | STEP | p7_wc_g100k[35] | 0.50028513616 | SI
P7 | STEP | p7_wc_g100k[36] | 0.500285030225 | SI
P7 | STEP | p7_wc_g100k[37] | 0.500285276287 | SI
P7 | STEP | p7_wc_g100k[38] | 0.500284939056 | SI
P7 | STEP | p7_wc_g100k[39] | 0.500285362951 | SI
P7 | STEP | p7_wc_g100k[40] | 0.500284857678 | SI
P7 | STEP | p7_wc_g100k[41] | 0.500285380215 | SI
P7 | STEP | p7_wc_g100k[42] | 0.500284928269 | SI
P7 | STEP | p7_wc_g100k[43] | 0.500285272365 | SI
P7 | STEP | p7_wc_g100k[44] | 0.500285028264 | SI
P7 | STEP | p7_wc_g100k[45] | 0.500285157419 | SI
P7 | STEP | p7_wc_g100k[46] | 0.500285192675 | SI
P7 | STEP | p7_wc_g100k[47] | 0.500284976322 | SI
P7 | STEP | p7_wc_g100k[48] | 0.50028532198 | SI
P7 | STEP | p7_wc_g100k[49] | 0.500284909289 | SI
P7 | STEP | p7_wc_g100k[50] | 0.500285373341 | SI
P7 | STEP | p7_wc_g100k[51] | 0.500284864444 | SI
P7 | STEP | p7_wc_g100k[52] | 0.500285358786 | SI
P7 | STEP | p7_wc_g100k[53] | 0.500284965109 | SI
P7 | STEP | p7_wc_g100k[54] | 0.500285220772 | SI
P7 | STEP | p7_wc_g100k[55] | 0.500285087722 | SI
P7 | STEP | p7_wc_g100k[56] | 0.500285099003 | SI
P7 | STEP | p7_wc_g100k[57] | 0.500285245756 | SI
P7 | STEP | p7_wc_g100k[58] | 0.500284930007 | SI
P7 | STEP | p7_wc_g100k[59] | 0.500285357156 | SI
P7 | STEP | p7_wc_g100k[60] | 0.500284891902 | SI
P7 | STEP | p7_wc_g100k[61] | 0.500285370124 | SI
P7 | STEP | p7_wc_g100k[62] | 0.500284884959 | SI
P7 | STEP | p7_wc_g100k[63] | 0.500285325202 | SI
P7 | STEP | p7_wc_g100k[64] | 0.500285011109 | SI
P7 | STEP | p7_wc_g100k[65] | 0.500285163572 | SI
P7 | STEP | p7_wc_g100k[66] | 0.500285149074 | SI
P7 | STEP | p7_wc_g100k[67] | 0.500285042699 | SI
P7 | STEP | p7_wc_g100k[68] | 0.500285292444 | SI
P7 | STEP | p7_wc_g100k[69] | 0.500284893798 | SI
P7 | STEP | p7_wc_g100k[70] | 0.500285379991 | SI
P7 | STEP | p7_wc_g100k[71] | 0.50028488781 | SI
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
P7 | STEP | p7_wc_step2us_proxy[174] | 44.5225364613 | SI
P7 | STEP | p7_wc_step2us_proxy[175] | 44.5211823368 | SI
P7 | STEP | p7_wc_step2us_proxy[176] | 44.5692920786 | SI
P7 | STEP | p7_wc_step2us_proxy[177] | 44.549129138 | SI
P7 | STEP | p7_wc_step2us_proxy[178] | 44.5108249205 | SI
P7 | STEP | p7_wc_step2us_proxy[179] | 44.5428303118 | SI
P7 | STEP | p7_wc_step2us_proxy[180] | 44.5686533754 | SI
P7 | STEP | p7_wc_step2us_proxy[181] | 44.5343118471 | SI
P7 | STEP | p7_wc_step2us_proxy[182] | 44.5105553788 | SI
P7 | STEP | p7_wc_step2us_proxy[183] | 44.5617857509 | SI
P7 | STEP | p7_wc_step2us_proxy[184] | 44.5594320492 | SI
P7 | STEP | p7_wc_step2us_proxy[185] | 44.5195077355 | SI
P7 | STEP | p7_wc_step2us_proxy[186] | 44.5254048067 | SI
P7 | STEP | p7_wc_step2us_proxy[187] | 44.5701586777 | SI
P7 | STEP | p7_wc_step2us_proxy[188] | 44.5458995576 | SI
P7 | STEP | p7_wc_step2us_proxy[189] | 44.5096382532 | SI
P7 | STEP | p7_wc_step2us_proxy[190] | 44.5474943147 | SI
P7 | STEP | p7_wc_step2us_proxy[191] | 44.567289121 | SI
P7 | STEP | p7_wc_step2us_proxy[192] | 44.5309365686 | SI
P7 | STEP | p7_wc_step2us_proxy[193] | 44.5126239114 | SI
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
