keneth-urbizagastegui/S3G4-LAB/S3G4_LAB_rev2.1/03_simulaciones/CH1_entrada/resultados/s3b_smoke_resumen.md

# ACTA S3b — Protección diferencial de U103A

Código 0; 66 simulaciones; 198.970 s; diez trabajadores; errores 0; advertencias 0.

**Comprobación parcial, sin aceptación.**

## Criterios por variante

| variant | criterion | status | value |
| --- | --- | --- | --- |
| A | S3b-C1 | PARCIAL | A=0.293351027 V; B=3.54773599 V; margen B=0.452264015 V |
| A | S3b-C2 | PARCIAL | 4051=4.92183205 mA; diodo=4.92154377 mA |
| A | S3b-C3 | PARCIAL | 0.414362776 % div; exceso=0 puntos |
| A | S3b-C4 | PARCIAL | perdida=-0.0564674017 dB; pico=8.36227488 dB |
| A | S3b-C5 | PARCIAL | 0.209778228 us; sin recuperar=0 |
| A | S3b-C6 | PARCIAL | THD=0.00696880359 % |
| B | S3b-C1 | PARCIAL | A=0.27569716 V; B=3.53114849 V; margen B=0.468851512 V |
| B | S3b-C2 | PARCIAL | 4051=2.93498421 mA; diodo=2.93473764 mA |
| B | S3b-C3 | PARCIAL | 0.437762372 % div; exceso=0 puntos |
| B | S3b-C4 | PARCIAL | perdida=-0.10888775 dB; pico=8.34901146 dB |
| B | S3b-C5 | PARCIAL | 0.273889195 us; sin recuperar=0 |
| B | S3b-C6 | PARCIAL | THD=0.0069713798 % |
| C | S3b-C1 | PARCIAL | A=0.843716057 V; B=3.55808053 V; margen B=0.441919466 V |
| C | S3b-C2 | PARCIAL | 4051=4.20645493 mA; diodo=4.20620817 mA |
| C | S3b-C3 | PARCIAL | 0.40897479 % div; exceso=0 puntos |
| C | S3b-C4 | PARCIAL | perdida=0.00761783682 dB; pico=2.26364871 dB |
| C | S3b-C5 | PARCIAL | 0.0389307967 us; sin recuperar=0 |
| C | S3b-C6 | PARCIAL | THD=0.00696660508 % |
| D | S3b-C1 | PARCIAL | A=0.81693407 V; B=3.54581219 V; margen B=0.454187808 V |
| D | S3b-C2 | PARCIAL | 4051=2.51729876 mA; diodo=2.51708861 mA |
| D | S3b-C3 | PARCIAL | 0.423488991 % div; exceso=0 puntos |
| D | S3b-C4 | PARCIAL | perdida=0.00135053348 dB; pico=2.23800053 dB |
| D | S3b-C5 | PARCIAL | 0.058273699 us; sin recuperar=0 |
| D | S3b-C6 | PARCIAL | THD=0.00696683892 % |

## B0 y controles previos

| variant | gain_dc | minus3_Hz | peak_db | loss_2m_db |
| --- | --- | --- | --- | --- |
| A | 4.9994399002305325 | 32188525.934162885 | 8.362274876563157 | -0.07012093101245019 |
| B | 4.999119267339638 | 24164396.555408146 | 8.349011457770875 | -0.12507944520366396 |
| C | 4.99951024473808 | 63749811.20987373 | 2.263648708221728 | -0.009578955476671504 |
| D | 4.999245297085557 | 48548974.21639818 | 2.238000527893525 | -0.016415504927390676 |

| noise_model | noise_315m_uV | noise_315m_pct_div | noise_10m_pct_div |
| --- | --- | --- | --- |
| original | 32.216909315093915 | 0.6443381863018783 | 1.149459410737834 |
| sheet | 19.80647642774755 | 0.39612952855495104 | 0.7048881882269603 |

## Por escala y variante

| variant | scale_V_div | POS | tap | s3_gain_dc | s3_loss_2m_db | s3_peak_db | bnc_loss_2m_db | bnc_peak_db | noise_315m_uV | noise_315m_pct_div | noise_10m_pct_div |
| --- | --- | --- | --- | --- | --- | --- | --- | --- | --- | --- | --- |
| A | 0.005 | 1 | 0 | 50.058225173931326 | -0.05646740170275716 | 6.351323578749085 | -0.051000665268815 | 6.089563585591458 | 20.718138776684093 | 0.41436277553368184 | 0.8082597483322209 |
| A | 0.5 | 100 | 0 | 50.05822517400261 | -0.05646740171448801 | 6.351323578490829 | -0.049952314984737345 | 6.0885791959231605 | 2064.793524014416 | 0.4129587048028832 | 0.8054754198245062 |
| B | 0.005 | 1 | 0 | 50.0550371508126 | -0.10888775011951161 | 6.876053547126071 | -0.10342101431277198 | 6.721549436740769 | 21.888118597844485 | 0.4377623719568897 | 0.9678091442320202 |
| B | 0.5 | 100 | 0 | 50.05503715088387 | -0.10888775013070591 | 6.876053546667596 | -0.10237266403307549 | 6.72053793982469 | 2182.026187898519 | 0.4364052375797038 | 0.9651417694812996 |
| C | 0.005 | 1 | 0 | 50.05897108345057 | 0.007617836815923631 | 1.7846534609948827e-05 | 0.013084546222654987 | 1.7283477930359653e-05 | 20.44873951644427 | 0.40897479032888545 | 0.7309845817805799 |
| C | 0.5 | 100 | 0 | 50.05897108352222 | 0.007617836820067502 | 1.7846534608020177e-05 | 0.014132896496639945 | 1.7791430291650624e-05 | 2037.7951605545984 | 0.4075590321109197 | 0.7281011187174928 |
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
| NONE | 0.005 | 25 | 0.0037697987525384057 |  |  |
| NONE | 0.005 | 70 | 0.004445636571875623 |  |  |
| NONE | 0.2 | 25 | 9.407459134319519e-05 |  |  |
| NONE | 0.2 | 70 | 0.00011096643423181113 |  |  |

Archivos protegidos: 21318; cambios detectados: [].

## Método y dudas sin resolver

Fuentes completas leídas: encargo y contrato S3b; plan, acta y auditoría S3;
plan/acta/auditoría S2b; decisiones del 3 oct; revisión de entrada §6 E11–E15
y documento vivo C.3–C.6. No se modifican entregables previos ni modelos.
El ejecutor importa S3 sin escribirlo y reutiliza su lista de conexiones;
ch1_comun_s3b.inc incluye ch1_comun_s3.inc, que incluye S2b. Sólo se inserta
R_SER y dos diodos en sentidos opuestos entre IPA e IMA. CPCB sigue en COMMON.
VIA mide la corriente total que sale del común del 4051; VOUT101 mide toda la
corriente de salida del OPA810, incluida la escalera. Los sensores son fuentes
ideales de 0 V. U103A/B se miden en sus pines IPA/IMA, IPB/IMB.
Ocho SWI1 hc_tnomi reales, sin proxy. Modelos originales en AC/DC/TRAN/OP;
sólo NOISE usa AD8038_ltspice_ruido_hoja.sub. B0 es U103A aislada con
1 kohm paralelo 10 pF de carga como comprobación S3; su barrido llega a 1 GHz
para localizar -3 dB; el pico contractual se comprueba también en B1 a 100 MHz.
B1 informa función S3 OUT/BI y completa OUT/BNC; C4 mantiene el criterio S3
(pérdida de la parte añadida), sin ocultar la pérdida BNC. Rsource=50 ohm
en B1/B2/B5/B6; enlace ideal BNC en B3/B4 para imponer exactamente el estímulo.
Ruido inoise referido a Vsrc, integración del cuadrado de 1 Hz a 3.15/10 MHz
con interpolación del extremo, mismo método que S3. B3 -40 a +40 V, 50 mV;
extremos y número de puntos verificados; .meas y raw contrastados.
B4 flancos 10 ns, ancho 10 us, amplitud máxima 4.5 V; paso global máximo
0.5 ns comprobado en raw. Recuperación desde el FINAL del flanco descendente
a +/-25 mV del punto inicial; se busca última violación, no primer cruce;
30 us de registro, sin redefinir el objetivo por la cola. B5 amplitud del
estímulo calculada desde AC de la misma variante para 2 Vpp; armónicos 2–9,
20 ciclos coherentes y 65536 puntos interpolados, método inmutable de S3.
B6 .op real: extraído del raw, sin inventar una .meas TRAN con otro estado.
Offset añadido = (OUT protegido - OUT S3 sin protección) / 0.25 V por división.

1. No hay hoja local de BAT54S Vishay. El modelo contractual BAT54 de standard.dio
declara Iave=300 mA; el chequeo numérico C2 de A/B usa su mitad, 150 mA,
pero su estatus es CONDICIONAL hasta verificar IF continuo de la pieza dual
en su hoja. La hoja local onsemi BAT54T1G da 200 mA (mitad 100 mA), otra pieza
y otro encapsulado: NO se atribuye ese rating a BAT54S. Sin descargas.
BAV199 Nexperia p2 IF=160 mA con un diodo, 140 mA con ambos: se usa 70 mA,
conservador. 4051 p5 ISW=25 mA, criterio mitad 12.5 mA. Nota de esa página:
caída Y→Z >0.4 V puede sacar corriente de VCC; se informa como limitación
del criterio de corriente sin rediseñar la red. OPA810 p6 a +/-5 V: 52 mA
mín./75 mA típ. de drive lineal con VO=2.65 V, 100 mA típ. en cortocircuito;
son condiciones diferentes de B3, no un máximo absoluto ni garantía a saturación.
2. AD8038 simplificado no representa Ib real de 400 nA ni su deriva; B6 muestra
la contribución del par simétrico y de la resistencia en ESTE modelo, no
predice offset absoluto de placa. No se inyecta Ib artificial fuera del contrato.
BAT54 y BAV199 con mismo modelo en ambos sentidos tampoco incluyen mismatch.
3. BAV199 TT=1.023 us de fabricante; su recuperación puede dominar B4 aunque
proteja bien en DC. El modelo no simula destrucción ni temperatura de unión.
4. S3 conserva CS/CEQ derivados de S2b, no los valores resumidos 1.5 nF/12 pF;
no se retoca ningún valor. Documento vivo aún tiene candidatos/red/ruido antiguos;
mandan decisiones 3 oct y contratos S3/S3b. No se resuelven contradicciones.
5. Se respeta la recuperación aceptada de aproximadamente 0.6 ms tras conducción
de BAV199 de entrada: no se repite ese ensayo. Rieles ideales de S3 no validan
riel real ni prueba física. Sin selección de variante ni diseño S4.
CSV deterministas ordenados, .cir y .log retenidos; raw regenerable eliminado.
