keneth-urbizagastegui/S3G4-LAB/S3G4_LAB_rev2.1/03_simulaciones/CH1_entrada/resultados/s4_resumen.md

# ACTA S4 — OPA836 a 3.3 V, offset y VMID

Código 0; 199 simulaciones; 1869.041 s; diez trabajadores; errores 0; advertencias 0.

Intentos técnicos=204; fallidos/abortados iniciales=4; casos exitosos reutilizados con deck verificado=198.

## Criterios por variante

| variant | criterion | status | value | inherited |
| --- | --- | --- | --- | --- |
| M1-C0 | S4-C1 | FALLA | error G lineal=0.000262292304%; NL F0 completo=53.0660187% FS; offset +5.21090445/-4.85499123 div | True |
| M1-C0 | S4-C2 | FALLA | por debajo 0=0.484858466 V; exceso VDDA=0.485626199 V | True |
| M1-C0 | S4-C3 | FALLA | I=0.235293868 mA /0.43; exceso VS+-0.7=0.623434622 V; dif=0.682288059 V /1 | True |
| M1-C0 | S4-C4 | FALLA | S4 perdida=-0.0923969266 dB; pico=1.50369681; cadena pico=1.77212954e-05, perdida=0.585181126 dB | False |
| M1-C0 | S4-C5 | PASA | rec=0.221204365 us; sin recuperar=0 | False |
| M1-C0 | S4-C6 | INFORMADO | VMID durante max=0.00174761752 V; despues max=0.0017376428 V | False |
| M1-C0 | S4-C7 | FALLA | THD=10.1696882% | False |
| M1-C0 | S4-C8 | PASA | ruido=0.386022706% div; escalas=12/12 | False |
| M1-C1 | S4-C1 | FALLA | error G lineal=0.000262292304%; NL F0 completo=53.0660187% FS; offset +5.21090445/-4.85499123 div | False |
| M1-C1 | S4-C2 | FALLA | por debajo 0=0.484858466 V; exceso VDDA=0.485626199 V | False |
| M1-C1 | S4-C3 | FALLA | I=0.235293868 mA /0.43; exceso VS+-0.7=0.623434622 V; dif=0.682288059 V /1 | False |
| M1-C1 | S4-C4 | PASA | S4 perdida=0.0814283515 dB; pico=0; cadena pico=1.77212687e-05, perdida=0.758999632 dB | False |
| M1-C1 | S4-C5 | PASA | rec=0.22847365 us; sin recuperar=0 | False |
| M1-C1 | S4-C6 | INFORMADO | VMID durante max=0.00174720754 V; despues max=0.00173728179 V | False |
| M1-C1 | S4-C7 | FALLA | THD=9.90984885% | False |
| M1-C1 | S4-C8 | PASA | ruido=0.380349233% div; escalas=12/12 | False |
| M2-C0 | S4-C1 | FALLA | rango F1 +5.21090467/-4.85755013 div; F0 ganancia/NL solo M1 | True |
| M2-C0 | S4-C2 | FALLA | por debajo 0=0.48519571 V; exceso VDDA=0.485194101 V | True |
| M2-C0 | S4-C3 | FALLA | I=0.279889903 mA /0.43; exceso VS+-0.7=0.435138017 V; dif=0.687226582 V /1 | True |
| M2-C0 | S4-C4 | FALLA | S4 perdida=-0.0923969266 dB; pico=1.50369681; cadena pico=1.7743711e-05, perdida=0.585181446 dB | False |
| M2-C0 | S4-C5 | PASA | rec=0.220717898 us; sin recuperar=0 | False |
| M2-C0 | S4-C6 | PASA | interferencia=1.13881104e-07 div | True |
| M2-C0 | S4-C7 | FALLA | THD=10.1507028% | False |
| M2-C0 | S4-C8 | PASA | ruido=0.3860236% div; escalas=12/12 | False |
| M2-C1 | S4-C1 | FALLA | rango F1 +5.21090467/-4.85755013 div; F0 ganancia/NL solo M1 | False |
| M2-C1 | S4-C2 | FALLA | por debajo 0=0.48519571 V; exceso VDDA=0.485194101 V | False |
| M2-C1 | S4-C3 | FALLA | I=0.279889903 mA /0.43; exceso VS+-0.7=0.435138017 V; dif=0.687226582 V /1 | False |
| M2-C1 | S4-C4 | PASA | S4 perdida=0.0814283515 dB; pico=0; cadena pico=1.77436782e-05, perdida=0.758999944 dB | False |
| M2-C1 | S4-C5 | PASA | rec=0.228355618 us; sin recuperar=0 | False |
| M2-C1 | S4-C6 | PASA | interferencia=1.13881104e-07 div | False |
| M2-C1 | S4-C7 | FALLA | THD=9.89135732% | False |
| M2-C1 | S4-C8 | PASA | ruido=0.380350141% div; escalas=12/12 | False |

Valores derivados de resistencias: A_IN=1, A_OFF=1.24069478908, NG=3.24069478908, VMID ideal=0.858502954695 V, centro ideal=1.23127756534 V.

**Ecuación medida en región lineal:** V_ADC=2.78557477274 -0.999997377077·V_in -1.24069153483·V_DAC. Centro real=1.2347103542 V; rango de offset real=+1.30272611158/-1.21374780743 V (+5.21090445/-4.85499123 div).

## ISOAC: Comprobación aislada AC

| cf | scope | gain_dc | minus3_Hz | adc_minus3_Hz | amp_minus3_Hz | amp_peak_db | amp_loss_2m_db |
| --- | --- | --- | --- | --- | --- | --- | --- |
| C0 | iso |  |  | 5649671.985998263 | 19606006.474795558 | 1.50369680699552 | -0.09239692660717734 |
| C1 | iso |  |  | 4415340.387445749 | 10822354.918378957 | 0.0 | 0.0814283514514757 |
| C0 | follower | 0.9999992077266439 | 66253934.9190769 |  |  |  |  |

## ISODC: Comprobación aislada DC

| vdac_V | esd | adc_min_V | adc_max_V | diff_at_neg3p9_V | diff_at_pos3p9_V | ip1_current_peak_A | im1_current_peak_A |
| --- | --- | --- | --- | --- | --- | --- | --- |
| 0.2 | 0 | 0.0062719743198296875 | 3.291250708262074 | -0.926549062569995 | 0.4037193114693435 | 6.8250349637258875e-06 | 1.5889589709745364e-05 |
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
| F7 | M2 | 1.25 | -1 | ramp | 1 | 5.0000311361748715e-06 | 0.0010041384938716444 | 0.0005887157314125707 | 0.0005887157314125707 | 5.000013219056358e-06 | 0.0010111966285422963 | 4.146425549649491e-07 | 0.0001658186331948004 | 8.978693018709438e-05 |
| F7 | M2 | 2.3 | -1 | ramp | 1 | 5.000016948642385e-06 | 0.0010040236566238026 | 0.0005897438170757306 | 0.0005897438170757306 | 5.000013219056358e-06 | 0.0010111952364686581 | 4.1464255496497404e-07 | 0.00016581863319480207 | 0.00018669392593320656 |
| F7 | M2 | 0 | -3.9 | off | 1 | 5.000050491135416e-06 | 5.000050491135416e-06 | 5.000002354667793e-06 | 5.000002354667793e-06 | 5.000050450412307e-06 | 5.000050450412307e-06 | 1.0459921272482702e-06 | 1.0459921272482702e-06 | 0.0001408359822950959 |
| F7 | M2 | 0 | -3.9 | off | 1 | 5.0000504269279756e-06 | 5.0000504269279756e-06 | 5.000001828080944e-06 | 5.000001828080944e-06 | 5.000027138619205e-06 | 5.000027138619205e-06 | 0.00020906513790586414 | 0.00020906513790586414 | 0.00011532758431142477 |

Archivos protegidos=22075; cambios=[].

## Método y límites de interpretación

Fuentes: ENCARGO_CODEX_S4 y PLAN_SIMULACION_S4 completos; plan/acta/auditoría
S3b, plan/acta/auditoría S3; DECISIONS del 3 oct; revisión entrada §6 E16;
canal rápido bloques 7 y 9; G473 P14/P15; models/LEEME y OPA836 SLOS712J
pp.8 y 26. Sin descargas. Diez trabajadores incluso en controles.
S3b incluido sin cambios. BAV99HY y PROTECT_BAV99 copiados textualmente de
y_b3_g_s00_pos1_tap0_cpldc_nomi_bipolar_t25.cir; 470 ohm en ambos AD8039.
Se retiene RLOAD=1k y CLOAD=10p de S3b porque el contrato prohíbe cambiar
la cadena delante; era una carga sustituta de S4 en S3. Esta ambigüedad
se deja anotada: S4 se suma a ella, no se elimina silenciosamente.
OPA836 seis nodos, PD unido a VDDA. Sensores ideales de 0V miden corriente
TOTAL de cada entrada, incluyendo diodos diferenciales añadidos. DESD es
suposición contractual (Is=1e-15 N=1 Rs=10), no pieza ni validación física.
F1/F4 se repiten con el macro sin diodos para cuantificar la dependencia.
M2 siempre tiene tres S4 reales; entradas de CH2/3=0, DAC2/3=1.25 V.
Sólo NOISE usa AD8038_ltspice_ruido_hoja.sub; modelos intactos.
R_ADC68/C_ADC470p más C_SH5p estático. Sin filtro S5 ni kickback S6.

F0 incluye todas las 51 posiciones -1.25..1.25 por DAC; se informa la
no linealidad del barrido completo, incluida saturación, además de ajuste
lineal restringido al intervalo ideal 0.2..3.1V. C1 no oculta el recorte.
Rango de offset medido a Vin=0 respecto del centro a DAC1.25, no una
extrapolación ideal. F0 es M1-C1 por contrato; M1-C0 hereda su continua.
C1 de M2 usa el rango medido directamente en F1 a Vin=0; F0 no mide
ganancia/no linealidad de M2. F1/F7/F4 sólo C1; C0 hereda
C2/C3/C6 según el cruce definido en 2.3, no un transitorio C0 de arranque.
F2 aislada M1; M2 hereda esa respuesta aislada, pero su cadena se simula.
F2 separa O1 (antes del RC, cargada por él) y ADC1 (pin después del RC).
Frecuencias 200 puntos/década; pérdida positiva respecto de AC a1Hz;
pico hasta100MHz. Controles aislados hasta1GHz para localizar -3dB.
F1 -5..5V, 10mV, extrema por raw y .meas independientes.
F4 -3.9..3.9V sostenido con DAC extremos y nominal, variación respecto
de CH1=0 en el mismo circuito; sin redefinir la línea base por otro macro.
F3 flancos10ns, pulso10us, dt<=1ns, recuperación desde FINAL del flanco
de bajada hasta permanecer en +/-25mV del punto inicial; ventana30us.
Si no recupera se informa censura, no se toma el último valor como cero.
F5 seno2MHz, amplitud de fuente calculada desde F2 de la misma variante
para2Vpp en pin ADC; offset0,+/-2div, DAC calculado desde RF/ROFF.
THD armónicos2..9, 20ciclos coherentes, rejilla65536; se informa recorte.
F6 integra ONOISE en el PIN de1Hz a3.15MHz (no inoise/BNC), cuadrado
por trapecios con extremo interpolado; porcentaje respecto de0.25V/div.

F7(a) VDDA=0, +/-5 presentes, Vin=+/-3.9, DAC=0. Como el plan no fija
VREF apagada, se prueban VREF=0 y2.5V sin decidir su secuencia real.
F7(b) rampa VDDA0..3.3 en1ms; suposición explícita VREF sigue
VDDA*2.5/3.3; DAC sigue VREF en proporciones0.2/2.5,1.25/2.5,2.3/2.5.
La alimentación <2.5V está FUERA del rango recomendado del macro/hoja.
Resultados de arranque/apagado son diagnóstico del macro, no garantía
de silicio. Se comprueba ADC frente a VDDA instantánea, no sólo3.3V.
M2 usa .nodeset calculado desde resistencias y estímulo como estimación
inicial de Newton; no fuerza tensiones finales ni modifica componentes.
En F7 todos los DAC están a0V apagados; DAC2/3 siguen VREF/2 en rampa.
F6 M2 toma1/2 usa gminsteps=25 y srcstepmethod=1 para inicializar
el mismo circuito: source stepping0 se detuvo en esos cuatro casos.
Se conservan los intentos fallidos; --resume verifica cada deck exitoso
antes de reutilizarlo. La reejecución en copia se hace completa.
Consumo por sensor de alimentación por amplificador; RT es demanda de
VMID a VREF, no incluye ADC/DAC ni ruido real de REF3325/DAC idealizados.
Valores medios en barrido son medias de puntos, no consumo temporal.

Contradicciones no resueltas: E16 pide rizado sample-and-hold0.1LSB,
pero el contrato usa DAC con buffer continuo y no aporta modelo S/H;
no se certifica rizado. La ecuación positiva en la guía de CH1 es previa
a la sumadora inversora de este contrato. El rango ideal +/-5.21div no
asegura igual rango REAL con recorte contra masa. Ganancia de ruido3.24
no permite inferir63MHz de ancho de banda con resistencias10k y parásitas;
se mide. BAV99 de Nexperia se simula con modelo Rohm contractual.
Fuentes ideales no evalúan el power path, impedancia real ni REF/DAC
apagados. Sin selección M1/M2 o C0/C1, ni modificaciones a valores.
El intervalo0..VDDA de C2 es seguridad del pin; la conversión útil es
0..VREF+=2.5V. S4 no modela saturación de códigos del ADC, y el offset
con señal puede superar VREF incluso si permanece por debajo de VDDA.
CSV ordenados/deterministas; decks y logs retenidos; raw regenerables
se eliminan después de análisis correcto. Error eléctrico es válido;
código0 sólo indica campaña completa, no aceptación.

## Reproducción

Desde CH1_entrada: `python ejecutar_s4.py --controls`, luego
`python ejecutar_s4.py --smoke` y `python ejecutar_s4.py`.
En una copia, fijar S3G4_MODELS a la ruta Windows de
Simulation_LTSpice/models antes de ejecutar. S3G4_LTSPICE permite
indicar otro ejecutable LTspice instalado. No hay dependencias descargadas.
