keneth-urbizagastegui/S3G4-LAB/S3G4_LAB_rev2.1/03_simulaciones/CH23_entrada/resultados/s9_resumen.md

Código **0**; **14451 ejecuciones nativas de referencia**, **4313/4313 casos lógicos**, **6074.026 s** de sesiones finalizadas de campaña (sin huellas iniciales ni sesiones interrumpidas), 10 trabajadores, semilla 2026100371. Histórico: 14462 intentos terminados registrados, 17 fallidos de depuración; suma de tiempos de procesos paralelos 58811.348 s, no tiempo de pared. Interrupciones en console/diario. Código 0 significa ejecución completa, no aprobación eléctrica. Cambios protegidos: [].

La ejecución completa original devolvió código 1 tras 5989.700 s: detectó modificaciones externas de STATE.md y DECISIONS.md, conservadas con huellas antes/después en `S9/campaign/guard_concurrencia_2026-10-04/`. CH1 y modelos permanecieron idénticos. El código actual corresponde a reanudación y revisión de una nueva ventana sin modificar esos archivos; se reutilizan los mismos resultados.

Auditoría Codex: código 0, 14409 decks y 4313 casos verificados; 0 errores. Auditoría externa de Claude pendiente.

| criterio | A | B |
| --- | --- | --- |
| S9-C1 | 0.005 V/div MC: 500/500 (100.0%); 0.05 V/div MC: 500/500 (100.0%); 0.5 V/div MC: 500/500 (100.0%); 5.0 V/div MC: 500/500 (100.0%) — PASA | NO EVALUADA: detenida por K0 (modelo incompatible con hoja) |
| S9-C2 | 0.005 V/div MC: 500/500 (100.0%); 0.05 V/div MC: 500/500 (100.0%); 0.5 V/div MC: 500/500 (100.0%); 5.0 V/div MC: 500/500 (100.0%) — PASA | NO EVALUADA: detenida por K0 (modelo incompatible con hoja) |
| S9-C3 | 0.005 V/div MC: 500/500 (100.0%); 0.05 V/div MC: 500/500 (100.0%); 0.5 V/div MC: 500/500 (100.0%); 5.0 V/div MC: 500/500 (100.0%) — PASA | NO EVALUADA: detenida por K0 (modelo incompatible con hoja) |
| S9-C4 | 0.005 V/div MC (100): 100/100 (100.0%); 0.5 V/div MC (100): 100/100 (100.0%); 12 escalas nominales: 12/12 (100.0%) — PASA | NO EVALUADA: detenida por K0 (modelo incompatible con hoja) |
| S9-C5 | 0.005 V/div MC: 500/500 (100.0%); 0.05 V/div MC: 500/500 (100.0%); 0.5 V/div MC: 500/500 (100.0%); 5.0 V/div MC: 500/500 (100.0%) — PASA | NO EVALUADA: detenida por K0 (modelo incompatible con hoja) |
| S9-C6 | K4 compartido, P/Z/R, dos frecuencias: 6/6 (100.0%) — PASA | NO EVALUADA: detenida por K0 (modelo incompatible con hoja) |
| S9-C7 | 36 barridos deterministas, rieles extremos: 36/36 (100.0%) — PASA | NO EVALUADA: detenida por K0 (modelo incompatible con hoja) |
| S9-C8 | recuperaciones nominales sin BAV199: 0/10 (0.0%) — FALLA | NO EVALUADA: detenida por K0 (modelo incompatible con hoja) |
| S9-C9 | 0.005 V/div MC: 484/500 (96.8%); 0.05 V/div MC: 488/500 (97.6%); 0.5 V/div MC: 484/500 (96.8%); 5.0 V/div MC: 488/500 (97.6%) — PASA | NO EVALUADA: detenida por K0 (modelo incompatible con hoja) |
