keneth-urbizagastegui/S3G4-LAB/TFT_8Bit_Capacitive/test_video_player/plan_antigravity/11_paquete_F6a_it4.md

# 11 — F6a iteración 4: lógica de pantallas, capas y botones (17/09/2026)

> Rama `video-player/fase-6`, desde `1ecbabf`. Antes de F6b. Viene de la prueba de Keneth con el dedo
> y de la revisión del auditor sobre `main/ui_glue/actions.c`, `main/main.c` y `main/player.c`.
> **Aprobado por Keneth en la it3:** aspecto de la barra (salvo L6), controles de golpe, reproducir,
> anterior/siguiente, ±10 s, aleatorio y repetir (salvo L4), EEZ con Checks = 0. **No lo rompas.**
>
> Recordatorio: en la it3 se revirtió un re-anclaje PTS a 60 ms que anulaba los descartes
> (`informes/FASE_6a.md` §6). Umbrales y métricas intocables.

## Modelo de navegación (lo que debe quedar)

```
             ┌──────────── tocar tarjeta ─────────────┐
             │   (si hay posición guardada:            │
             │    hoja «Continuar / Desde el principio»)│
             ▼                                          │
  scr_player ──── ‹ atrás (PAUSA y guarda posición) ──▶ scr_library
      │  ▲                                              │  ▲
      │  └──── fin de video con repetir OFF ────────────┘  │
      │                                                    │
      └── cola (F6a: aviso «Próximamente»; F6b: scr_queue)  └── ajustes (aviso en F6a)
  Capas de scr_player: osd_top + osd_bottom (auto-ocultar), ovl_lock, toast.
  Capa de scr_library: hoja «reanudar», toast.
```
Reglas:
- **El video solo se pinta en el panel si la pantalla activa es `scr_player`.** Nada fuera de
  `scr_player` puede fijar un `video_rect` distinto de `{0,0,0,0}`.
- **Al salir de `scr_player` el video se pausa** (y se guarda la posición). Al volver con la misma
  tarjeta, se reanuda donde estaba.
- Un único punto de verdad para la vista: `ui_glue_set_view_mode()`. `action_open_library`,
  `action_play_index` y `ui_glue_init` lo usan; nadie más llama a `loadScreen`/`lv_screen_load` ni a
  `lcd_bus_set_video_rect` directamente.

## Defectos

### L1 — La biblioteca «vuelve al video» a los 3 s (CAUSA ENCONTRADA)
`action_open_library` pone la vista en biblioteca pero **no pausa el video** ni desactiva el auto-ocultar
de la OSD. A los 3 s, `ui_glue_tick` llama a `ui_glue_set_osd_visible(false)`, que manda
`PCMD_SET_VIDEO_RECT {0,0,480,320}` y `lcd_bus_set_video_rect(0,0,480,320)`: **el video vuelve a
pintarse encima de la biblioteca**, aunque la pantalla activa sea `scr_library`.
Arreglo: auto-ocultar y `ui_glue_set_osd_visible` solo actúan con la vista en `scr_player`; al abrir
la biblioteca, `PCMD_PAUSE` + guardar posición. Criterio: quedarse 60 s en la biblioteca sin que
aparezca video (log `VIEW` cada cambio) y confirmación de Keneth.
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
