keneth-urbizagastegui/S3G4-LAB/ai-context/journal/2026-10-08-codex-s13.md

# S13 — Codex

Inicio: 2026-10-08 19:39:24 (America/Lima, hora de creación del diario). Agente: Codex.

Encargo: ejecutar PLAN_SIMULACION_S13.md y ESTUDIO_BLOQUE3.md con c1 y las decisiones indicadas en el contrato. Sin modificar piezas, archivos anteriores, modelos, 01_diseno, STATE ni DECISIONS; sin descargas. MCP s3g4-context no conectado: fuentes locales y context-mode genérico para análisis.

Estado: trabajo de simulación terminado. Cierre documental: 2026-10-08 20:22 (America/Lima).

## Fuentes y cambios

Leídos AGENTS, START y STATE (solo lectura), PLAN_SIMULACION_S13 y ESTUDIO_BLOQUE3 íntegros, decks/scripts del estudio, PLAN/ACTA_S11_4, ACTA_S12d, ENCARGO_CODEX_S11_1, LEEME de modelos y ejecutores/includes de S11.4 y sus dependencias. Autoridad para los valores elegidos: contrato S13 del usuario; ninguna decisión permanente nueva.

Creado en S3G4_LAB_rev2.1/03_simulaciones/DMM: comun/dmm_bloque3.inc, ejecutar_s13.py, analizar_s13.py, ACTA_S13.md, directorio S13 de trazas/decks/cachés y resultados/s13_*.csv/json. Diez trabajadores, límite de 900 s, smoke y resume por firma. STATE y DECISIONS no se actualizaron por la prohibición expresa del encargo. No se modificaron piezas, firmware, 01_diseno, models ni archivos de campañas anteriores. No hubo descargas ni pruebas físicas.

## Evidencia y pruebas

- Preflight P43 convergente; confirmación final con --preflight --resume: 1/1, reutilización por firma, 0.015 s.
- Smoke definitivo: 10/10 completos, 182.413 s.
- Campaña: 502/502 completos, cero errores, 10 reutilizados y 492 lanzamientos nuevos, 1252.115 s. Smoke+campaña: 1434.528 s (23 min 54.528 s), 502 estados únicos. Los preflights/smokes de depuración interrumpidos quedan fuera: no se conservó un historial íntegro de sus tiempos/lanzamientos.
- Distribución: C2 210 (100 Monte Carlo, 80 AC, 15 asiento, 15 térmicos); C1 216 (144 ESD,72 de60V); C3 6; C5 54; C6 12; diodo adicional C7 4. C4 es cálculo de seis rangos, no LTspice.
- C1: R1 0.4837 W/pieza continuo, TVS0.3907W, R_S0.02845W, zéner0.01449W, sujeción continua4.8595mA, rieles10.5692V, BAT54 inversa14.5887V, BSS84 Vds19.707V. ESD358.465V/pieza: rating de trabajo200V no demuestra impulso; pendiente curva HoCR2512. Modelo reducido S11.4, no certificado del lazo P43 durante ESD.
- C2: 97/100 con margen≥0.3V,97/100 con corriente inicial±1%; PM mínimo74.445°, asiento máximo77.84% del límite. SWI1 tiene Ron efectiva178–246Ω, fuera del ideal60–130Ω del estudio: limitación de modelo documentada. Deriva de pasivos RSS217ppm frente a suma lineal399ppm; no se declara garantía determinista300ppm.
- C3: cierre máximo30.558µs, apertura0.298µs,2transiciones por caso sin rebotes. P41/umbral real pendientes. Seis FIND .meas al instante final fallan por redondeo; RAW completo y medidas de respuesta extraídas correctamente de la traza, notas separadas.
- C4: peor garantizado91.266% de tolerancia; proxy calibrado78.124%, por debajo de100/85%. INL2.1/3.2LSB de hoja; curva medida ausente.
- C5:4/18 combinaciones pasan deriva de corriente,2/18 al invertir el divisor. Fallos de1nA marginales de criterio;10nA incompatibles en el supuesto inyectado. No se cambió nada.
- C6: P34 funciona en el modelo con umbral conservador16cuentas, ruido±3 y X2×10.1; a60V se cambia a×1 para leer. ADC ideal y puerta de fuente ordenadaOFF; secuencia EN/INH real pendiente. P33 excluida. No se escribió firmware.
- Diodo:1.00194mA a0.65V;99.900/99.881/99.841µA a3.0/3.2/3.6V con riel4.8V; lectura X2×10.1. DUT de tensión fija como S11.4, no curva de LED concreto.

## Clasificación y pendientes

P43 completo falló numéricamente en el frente ESD (xb2:D17); se retuvo el modelo reducido de S11.4 en C1, y el completo en C2. Apagado extremo del macromodelo TLV2372 tampoco convergía: C6 representa la condición ordenadaOFF, con BSS84/BAT54 y las rutas de lectura. Son límites de modelo, no daños físicos demostrados. Sin persecución de fallos marginales ni cambio de componentes.

Pendientes del prototipo/hojas: fugas de4051/TVS/BAV199 y limpieza/guarda, curva ADC5 y linealización, P41/COMP/DAC, capacidad real de TVS/cables, MPN BSS138/BSS84, curva de impulso HoCR2512 y GDT real, secuencia EN/INH. Acta con tabla C1–C6, lista de piezas y dudas; no se registra aprobación del bloque ni acuerdo nuevo. Sincronización local del contexto al cierre mediante context.mjs sync.
