keneth-urbizagastegui/S3G4-LAB/ai-context/journal/2026-10-08-codex-s12c.md

# S12c — Codex — 8 oct 2026

Sesión abierta para ejecutar PLAN_SIMULACION_S12c.md: confirmación sin toma ÷10. Hora de apertura registrada por el manifiesto de ejecución. No hay hardware conectado ni descargas. MCP s3g4-context/context-mode no disponible; consulta local de fuentes rectoras. STATE.md y DECISIONS.md están protegidos por la instrucción expresa del usuario.

Leídos AGENTS.md, START.md, STATE.md, contratos S12c/S12b/S12, encargo S11.1, estudio y actas/auditorías S12/S12b. Preceden los cambios S12c: X1 a COM, 20 V por X2 ×10.1 (91k/10k conservados), un único buffer X0, CD(ON) repartida y corriente de conducción de pinza para E8. Las métricas de modelo no prueban IEC ni fabricación.

Hora de apertura del archivo: 2026-10-08 12:26:07 -05:00 (ctime local). Se usa la habilidad SPICE como guía de interpretación; el contrato específico sustituye su flujo de extracción KiCad y no requiere esquema ni descargas.

Preparación y smoke: se corrigieron la retirada del main al importar S12b, una expresión de capacidad capturada por el sustituidor de parámetros y la inserción de .save sobre .ends. No afectan archivos previos. Smoke ampliado inicial 15/15 en 98.095 s; incluyó 50 Vrms, lazo Ron400 y X2×10.1. La campaña inicial se detuvo al comprobar 10 procesos atascados en el punto DC del SWI1 (modelo sólo transitorio); se adoptó UIC para transitorios NXP con intervalo de preacondicionamiento intacto, y se repite smoke/campaña con firma nueva. Se conservarán sólo métricas válidas con los decks finales, sin presentar intentos preliminares como cumplimiento.

Hallazgos preliminares: presupuesto X0 0.6nA →3.162 cuentas; X2/20V fuga agregada tolerable≈0.866nA. Mux dentro de rieles en smoke a50Vrms, pero entrada del buffer X0≈5.53V durante sujeción (contradicción con modo común±4.9V). Nuevo20V deja≈2.12cuentas a1.5ms y≈0.14a3ms; informar ambas esperas heredadas, sin alterar firmware ni piezas. CD(ON) repartida sólo en casos de lazo.

Estado: ejecución; evidencia final, pruebas y pendientes se completarán al cerrar.

## Cierre — 2026-10-08 13:42 −05:00 — Codex

Creado dmm_bloque2c.inc y ejecutar_s12c.py a partir de S12b, sin toma/clamp/100Ω/buffer X1;X1 aCOM,20V porX2×10.1,OPA2192doble paraX0+A. Conservadas piezas,modelos yfuentes. Añadidos analizar_s12c.py,verificar_s12c.py yverificar_s12c_extra.py;ACTA_S12c.md yresultados s12c_* documentan evidencia,contradicciones yBOM pendiente.

Pruebas:smoke15/15 en91.8916s;campaña1215/1215 finales,10trabajadores,900s/caso,prioridadE3,E8,E2,E1,E6,E5,E4,E7. Inicial1490.3851s;reparaciones189.4263+127.1958+39.4896s,total1846.4968s de fases principales. Dos recuperacionesOPA2188 requerían inicializaciónDC coherente sinUIC;seis intentos fallidos antes del resultado final quedan contabilizados. No se cambiaOPA2192 final. Reanálisis prueba deckguardado idéntico yconserva firmas anteriores;corrige el RMS de entrada sobrescrito por .meas yla inferenciaIV equivocada de la pinzaTI.

13comprobaciones adicionales:4válidas,9agotaron900s. DosE3 con100ns ydosE8 con corrientes de interruptoresTI son válidos;otrosE3 quedan inconclusos. Tiempos de verificadores900.3921/900.2154s,solapados. Total1228estados intentados=1219válidos+9inconclusos;1234lanzamientos desde el smoke definitivo incluyendo6reintentosE4. Preparación previa separada arriba.

Hallazgos finales sustituyen las cifras preliminares: E1P95conjunto0.15067%/0.25053%;50Vrms nominalsin recorte modelado,E5PMmín43.598°,E4recuperación15.52µs,E7máx0.03595cuentas,E8pinzamáx2.99773mA<5mA. PinzaTI±50Vdirecta0.432264mA concuerda con separacióncapacitiva a5.66nA;no aplicarIV0.5V/1Ωdelmodelo reducido alTI.

E2/20V no cumple4cuentas con1.85nA agregados:presupuesto8.044,SPICE7.496. Fuga tolerableX2≤0.8656nA en20V y9.6567nA en50V;X0máxteórico0.8040nA en200mV condecisión≤0.6nA. E3entradaX0buffer5.5244V no cumpleliteral±4.9V. A100ns,20V/borne0/0pC conserva1.81309cuentas a1.5ms y0.10814a3ms;5pC baja0.69256/0.10037. No dar por físicos todos los excesos gruesos:4excesos pequeños de rielsin convergencia fina;no se aprueban tampoco. No se altera espera defirmware ni se inventa acuerdo por3ms.

E6régimen cumple;impulso8kV por3.3k:1112.32V/2.321µJ,RT1.5M556.54V/40.77nJ. FaltanMPN/curvas/ΔR≤1%. Capacitor330pF47.681V, ratingpendiente. CSVimpulsos1628filas ycapacitores740filas. Consumo nominaldoble≈2mA es estimación delmodelo,sin medida delbloque completo. PCB,hardware,IEC,Ib/fuga real yacoplo deldoble siguenpendientes.

Validación de integridad:167fuentes protegidasSHA256sin cambios;1215firmas/decks y nombres.meas coinciden con estado real. Evidencia s12c_integridad_final.json. STATE.md/DECISIONS.md intactos por instrucción explícita. No descargas,no firmware,no01_diseno,noS11/S12/S12b editados. Diario cerrado;S12c ejecutado/documentado,sin conformidad general de diseño. Se sincroniza la memoria local al finalizar.
