keneth-urbizagastegui/S3G4-LAB/ai-context/journal/2026-10-08-codex-s12b.md

# S12b — Codex — 2026-10-08

Sesión abierta para PLAN_SIMULACION_S12b.md. Lectura de AGENTS, START, STATE, contrato S12b y fuentes de S12; entorno local de ENCARGO_CODEX_S11_1. Sin hardware ni descargas. MCP s3g4-context/context-mode no expuesto: se usa buscador local y análisis con salida reducida.

Restricciones expresas: no editar S11.x/S12, 01_diseno, models, STATE ni DECISIONS. Esta instrucción prevalece sobre la actualización genérica de STATE. Cada resultado nuevo se guarda bajo S12b y resultados/s12b_*.

Trabajo en curso: seguidores OPA2192 en X0/X1, campaña E3→E8→E2→E1→E6→E5→E4→E7; diez trabajadores, límite 900 s por caso, smoke y resume. Las 3.3 kΩ mantienen valor y se describen como antipulso sin inventar referencia/rating.

Pendientes: construir, smoke, campaña, acta con contradicciones y evidencia, cierre del diario y sync local.

## 10:16 Lima — ejecución

Implementados include y ejecutor aislados. **1191 casos previstos** (800 E1, 48 E3, 150 E8, 148 E6 y otros); el recuento inicial1291 fue una suma manual incorrecta, corregida por `len(cases())`. Se conserva el cálculo/calibración de S12 mediante carga de su código en un namespace propio; S12 no se escribe. Nombres de .meas de protección incorporan el estado S11.4 completo y la cadena/tau nuevos.

Incidencias de desarrollo: punto de operación extremo no convergente (dos intentos interrumpidos); `solver=normal` heredado es inválido, corregido a `norm`; rampa de entrada y 20 ms de preacondicionamiento para E3. Error de inserción de `.save` en `.ends` corregido antes de campaña. Se conservan los logs. Smoke final 11/11, 112.4439833 s; prueba auxiliar anterior de entradas inversoras 11/11. El smoke final es el que precede a `--resume` de campaña.

E8 usa ±10 mA absolutos de OPA2192, SBOS620E p6, por lo que el umbral contractual es 5 mA. Modelo reducido de entrada: pinza ±0.5 V con Ron 1 Ω, Cin 6.4 pF y C diferencial 1.6 pF; IV supuesto sin limitación artificial de corriente. Modelo TI de transferencia de los dos buffers con alimentación aislada en la prueba de protección para mantener la contabilidad de rieles heredada. Se miden también sus entradas inversoras. No certifica daño ni silicio.

Smoke muestra 5.70 mA en entrada de buffer con ESD −4 kV: fallo del criterio E8 bajo el modelo. Presupuesto conservador E2 de 200 mV: 4.189 cuentas a 0.85 nA de fuga de entrada del buffer (dos reservas de deriva Vos); fuga límite calculada 0.804 nA. Pendiente confirmación de toda la campaña y acta.

## Ajustes numéricos y contradicción de consumo

Dos campañas preliminares de E3 se interrumpieron para resolver coste y exactitud, sin continuar con una firma mezclada. A 100 ns, primeros diez casos terminan sin errores (314–364 s por caso en paralelo, frente a ≈80 s individual). Se conserva `S12b/e3_referencia_paso100ns.json` para nueve referencias a100ns; una fila de smoke ya es a1µs y se excluye del contraste por su elapsed<100s.

A1µs global aparecieron picos4.9069/4.9030V en X0 saturado con5pC; las referencias a100ns dan4.8966/4.8972V. Se añade una fuente de tiempo **desconectada del circuito físico**, con breakpoints cada100ns entre20.9 y21.1ms. No es una pieza de diseño. Smoke del caso sensible−20V/5pC: X0=4.896598282V, frente a4.896598319V de100ns; recupera el veredicto dentro del riel. Smoke final de esta versión:11/11 en50.5285527s.

Contradicción heredada de S12: `Riqother` conserva el total contractual3mA, pero los OPA actualizados a2×1mA más TLV2×550µA yHC16µA suman3.116mA; resulta una resistencia negativa. En el reducido **S12b solamente** se elimina esa rama residual no física; con los buffers nuevos el presupuesto de ICs es5.116mA a9.8V. No se modifica S12 ni se añade/cambia una pieza física. La exposición eléctrica se sigue señalando como aproximación.

La duración por encima de rating se calcula con interpolación lineal de la señal firmada y cruces de±rating (también correcto si una muestra cambia de signo).

## 12:01 Lima — cierre, Codex

Campaña1191/1191 válida: E1=800,E2=12,E3=48,E4=8,E5=8,E6=148,E7=2,E8=150,C2=6,C3=7,Q0=2. Smoke de la versión final11/11,17.036s (10reutilizados). Fases válidas:1625.140s previa,1391.217s campaña final,11.103s reparación±50V,33.353s reauditoría; suma3060.813s. Cuatro verificaciones auxiliares326.427s. No incluye intentos de desarrollo ni auditorías previas; no confundir ejecuciones válidas con conformidad eléctrica.

E2 usa21plateaus20ms y media final2ms para evitar OP extremo; se incluyen fuga OFF deYn2 sobreX1 y entrada delbufferX1 sobreX2. Dos E8±50V tenían señales de corriente sin guardar: se repitieron con `.save` explícito. Reauditoría reusaRAW únicamente si deck exacto coincide con el actual, conservando historial de firmas.1191fichas finales válidas; ningún archivo deS12/S11 se escribe.

Resultados enACTA_S12b yCSV/JSON: E1p95conjunto0.180711%/0.248881%; E2presupuesto200mV4.188685cuentas y fuga límite0.804034nA a23°C condicional; E3canales no seleccionados≤4.896546V pero4/28fallos de error absoluto±50V/X2; E4recuperación≤15.5184µs; E5mínimo38.4594° falla40°; E6Rc hasta1111.430V sin curva/rating confirmado; E7≤0.0359458cuentas; E8ESD≤22.031969mA y48/144fallos del umbral5mA.

Verificaciones100ns: pico grueso4.907789V baja4.896918V; pico corriente grueso10.312440mA baja2.147622mA para+50V/X0/0pC. No se usan artefactos gruesos para afirmar exceso físico. El fallo de asentamientoX2 permanece a100ns. ESD usa modelo reducido de pinza no validado y corriente total incluye desplazamiento; no demuestra daño ni certificaciónIEC.

Ficheros nuevos: include/ejecutorS12b,analizador,refrescador,reparador±50V,verificador,ACTA_S12b,deck/log/RAW/fichasS12b,resultadoss12b_* y este diario.64fuentes protegidas verificadasSHA256 sin cambios. STATE/DECISIONS preservados por instrucción expresa. Sin descargas, hardware ni cambios de piezas. Pendientes: auditoría independiente, prototipo, modeloIV/pinzas, aireIEC, dispersión/fugas garantizadas yMPN/curvas de impulsoRc/capacitores. Se sincroniza memoria local al cierre; no se registra ninguna propuesta como decisión aceptada.
