keneth-urbizagastegui/S3G4-LAB/ai-context/journal/2026-10-08-codex-s12.md

# S12 — Codex — 2026-10-08

Sesión iniciada en la raíz del proyecto. Contrato: PLAN_SIMULACION_S12.md.
Se respetan las exclusiones explícitas: S11.x, 01_diseno, models, STATE y DECISIONS.
MCP s3g4-context/context-mode no expuestos; se usan fuentes locales y análisis con salida acotada. Sin descargas.

Fuentes leídas: AGENTS, START, STATE (arranque), plan S12, ESTUDIO_BLOQUE2, encargo S11.1, bloque1 HTML, decisiones DMM 7/8 oct, modelos y ejecutores S11.4 (solo lectura).
Contradicción: HTML bloque1 conserva divisor 3×3M/900k y etiqueta 630V; prevalece contrato S12 6×1.5M/910k y 2kV.
Validación OPA2192 pendiente: seguidor, Ib, GBW, modo común; orden declarado IN+ IN− VCC VEE OUT, OPAx192 TI versión 1.7 (26-08-2022).

08:00 local, prechequeo: LTspice 26.0.2, seguidor converge; Vout(1V)=0.999999225V, Vout(4.5V)=4.499999046V. Ib(0)=5.05675pA, Ib(4V)=24.8452pA (27°C por defecto; etiqueta t25 incorrecta detectada, se corregirá). Hoja SBOS620E pp8–9: Ib típico 5pA/máximo20pA a25°C; máximo5nA en toda temperatura; entrada −0.1V/+0.1V fuera de rieles, GBW10MHz. −3dB cerrado16.769MHz no se identifica con cruce de lazo; pendiente medir éste. Primer deck mezclaba DC/AC, LTspice lo rechazó; separado y repetido, sin interpretar la corrida fallida.
Yageo RT1206 hoja C728673 p5: trabajo200V/sobrecarga400V; p8 ensayo sobrecarga5s, no certificación IEC ESD.
TMUX4053 hoja SCDS445E p10: Ron60Ω típ/400Ω máx a±5V y25°C; fuga0.3nA típ/100nA máx (ensayo24V); p11 Con10pF a±5V. Se usa modelo paramétrico, sin afirmar garantía de fuga1nA.

Validación repetida a25°C explícitos: Ib(0)=5.06075pA, Ib(4V)=24.8492pA; seguidor1V=0.999998808V y4.5V=4.499998569V. −3dB cerrado16.769MHz. Se conserva la discrepancia con el GBW de hoja y se mide el lazo por separado.
Implementados comun/dmm_bloque2.inc y ejecutar_s12.py. Un caso E4 del frontal converge. AC usa equivalente Ron/C de hoja, porque SWI1 es solo transitorio. RAW complejo dispone de lector propio: el lector S11 se limita a datos reales.
Incidencias de smoke: mezcla inicial AC/DC; expansión de .if no admitida por LTspice; sustitución de .end alcanzaba .ends, corregida con anclaje; V(x2,0) en .meas sin guardar V(0), cambiado por V(x2). Todas quedan como errores del banco, no fallos del circuito.
SWI1 no converge al conmutar con flancos1ns/20ns; se probó gear/alt y cshunt1f numérico. Caso autocero converge con trap/normal, flancos1µs y apertura antes del cierre (2µs), 148.28s de ejecución. Estos estímulos son supuesto del banco, no dato garantizado del HCT4051. Recuperación final200mV:21.5µs hasta media cuenta.
E2 distingue MC resistivo de10000 muestras y presupuesto de fuga agregado COM (se duplica/10°C, supuesto). LSB referido al nodo seleccionado; no confundir cuenta del borne20V/50V con la salida de A. Límite200mV≈0.866nA si se reservan derivaVos máximaSOIC y fugaTMUX típica; no garantía de fabricación.

## Cierre — 2026-10-08 08:42:36 -05:00, Codex

Campaña principal:927/927 ejecuciones válidas,976.339s,1reutilizado. Smoke10/10,163.504s. Complemento GDT+MOV aprobado:148/148,268.307s,1reutilizado; smoke1/1,12.316s. Las campañas se solaparon. Total1075casos de campaña; intentos de banco y validaciones previas no están en ese total. Límite900s y10trabajadores; sin timeout en campañas finales.

Evidencia: comun/dmm_bloque2.inc; ejecutar_s12.py; ejecutar_s12_e6_actual.py; S12/ y S12/e6_actual/ (cir/log/raw/json); resultados/s12_*.csv/json; ACTA_S12.md. Sintaxis Python comprobada y927RAW reanalizados; también10smoke. No se relanzó LTspice para corregir el análisis.

Corrección importante del propio banco: un tiempo de asiento respecto a una cola equivocada no prueba adquisición correcta. E3 parecía pasar; las ondasX1/X2 terminan2.79254/4.87857V frente a2.01798/0.49950V. Ahora se rechazan explícitamente (7677/43834cuentas), sin afirmar causalidad en silicio. Posible relación con X0 no seleccionado fuera de riel y falta de fidelidad del SWI1; pendiente de cualificación. X0 sí asienta:22.50/20.29µs (200mV/2V). También se corrigió media cuenta en retorno de ganancia a×1: recuperaciónE5máxima11.45µs, no7.6µs.

Resultados: E1p95conjunto0.20825% (cal0.05%)/0.27093% (cal0.1%), con hipótesis AC pequeño. E2 falla200mV con1nA:4.008cuentas modelo/4.552presupuesto. Fuga tolerable23°C:0.866/9.657/1.046/9.657nA para200mV/2V/20V/50V, condicionada a las reservas. E3 fallaX1/X2. E4 modeloOPA2192sin puntosengañosos y18.66/22.63µs recuperación, con umbralOL supuesto. E5 falla:40.46° en×1cornerRTMUX400Ω (ruta401Ω); nominal49.11°. E6 falla vigente:558.07V por1.5MΩ a+8kV yGDT100ns, frente400V;3.3kΩ ve1115.39V sinrating definitivo. E7autoceroindependiente0.02708/0.004495cuentasrms.

Contradicción adicional: modelo reducido S11.4 tiene GDT solo; cadena aprobada7oct esGDT+MOV. Se ensayan ambas sin editar fuentes históricas. C(v)efectivaSWI1≈0.886…0.900pF contrasta con25pF dehoja; no se usa como sustituto ni para aprobarE3. THD20kHz2Vpk0.01837%; consumoX0≈10.3mW, no delDMM entero.

No se cambiaron piezas ni fuentes rectoras. **No aceptación de S12.** Pendientes: auditoría; cualificar el mux completo/sobreexcursión; Ron/C/fase delTMUX; fuga/Ib18…28°C; driver/OL/controlreal; datos de pulso de amortiguación y GDT. STATE y DECISIONS permanecen excluidos por instrucción expresa. Se solicita sync local de este diario y fuentes; MCP sigue sin exponerse en la sesión.

Sync local comprobado:273fuentes indexadas,0retiradas y0ausentes. Sin descargas. Se repite sync tras registrar esta evidencia y hora de cierre.
