keneth-urbizagastegui/S3G4-LAB/ai-context/journal/2026-10-07-codex-s11-4.md

# S11.4 — Codex

Inicio del diario: 2026-10-07 21:42:52 America/Lima (CreationTime local). Agente: Codex.

Encargo: confirmación final del bloque 1 DMM según PLAN_SIMULACION_S11_4.md. Leídos AGENTS, START, STATE (sólo lectura), contrato y referencias precedentes. MCP s3g4-context/context-mode no expuestos; se usa búsqueda local y análisis acotado. Sin descargas.

Protegidos por instrucción actual: S11.1–S11.3, 01_diseno, models, STATE y DECISIONS. No se actualizarán estos dos últimos aunque AGENTS lo prescribe en general.

Plan: include final con GDT, ejecutor derivado de S11.3; smoke y T2,T1,T3,T4,T5; acta con D1–D7. Datos sin hoja local se marcarán como supuestos. No se infiere ensayo físico ni aprobación.

## Avance, 22:03 America/Lima

- Include final y ejecutor derivados en lectura de S11.3; sin RX2 físico, RX0/RX1=100 Ω, Rs=2.7 kΩ y bloqueo BAT54 de standard.dio.
- GDT: catálogo sin hoja local; DC420/780 V, impulso1000 V compartido, C0.5 pF. Arco20 V+1 Ω, mantenimiento10 mA y tiempo1 ns asumidos. Primer control reveló conducción parcial sin arco; corregida la memoria y repetido. Smoke preliminar invalidado; su T5 fue interrumpido. No se cambió solver.
- Smoke definitivo:9/9 ok,287.202 s. Confirmación223 estados:144 T2,16 T1,18 T3,36 T4,9 T5. Campaña --resume en curso; T1–T4 completos,8 T5 aún integrando,el noveno reutilizado por firma.
- Evidencia vigente:resultados/s11_4_campaign_audited.csv y s11_4_findings.json; sólo firmas actuales. D1/D2 incompletos por ratings de pulso ausentes; D3:325.269 V frente a336 V,sin arco. D4:1.177005 mA frente a10 mA. D5 compliance de fuente:3.606262 V con riel−2%; DUT a3.5 V:98.084527 µA. D7:10.569051 V frente a11 V.
- Contradicción BAT54: pieza elegida Nexperia; modelo solicitado LTspice identificado Vishay. No se descarga modelo sustituto. Otras incertidumbres conservadas en el acta.

## Cierre, 2026-10-07 22:13 America/Lima

- Confirmación terminada: **223/223 válidos, 0 timeout**, 853.807 s de pared; 214 invocaciones nuevas y 9 reutilizadas del smoke por firma. Smoke+campaña=1141.009 s (19 min 1.009 s). Historial: 233 invocaciones terminadas ok y una preliminar interrumpida; 234 lanzamientos. La duración completa del smoke interrumpido no consta y no se inventa.
- Los nueve T5 integran directamente 12 s. **D6 no se acredita:** X0≤27.943987 ms; N2 alimentado≤0.129069 ms, pero seis N2 apagados siguen derivando al terminar 2 s, con variación final de hasta 1.407976 mV/100 ms y nivel ~−45.36 mV. La salida heredada 2.0 s es censura, no tiempo de recuperación. Se corrige la interpretación en el CSV de criterios/acta, sin modificar el solver ni reensayar remedios.
- **Bloque no aprobado:** D1/D2 no certificados por ratings de pulso/sobrecarga ausentes; ESD Rohm≤543.070 V y Rprot≤366.030 V superan márgenes de trabajo. Relé abierto≤38.594 V frente a1200 V, condicionado al GDT supuesto. D3,D4,D5(fuente),D7 cumplen en modelo; no se declara cumplimiento físico.
- ESD: ambos extremos DC420/780 V tienen casi el mismo resultado porque comparten dato de impulso1000 V, sin tolerancia de impulso dada. Retardo1 ns, arco20 V+1 Ω y mantenimiento10 mA son supuestos sin hoja. No es generador RLC IEC calibrado.
- Acta cerrada: `S3G4_LAB_rev2.1/03_simulaciones/DMM/ACTA_S11_4.md`; incluye D1–D7, corrientes reales LED/silicio, ESD min/max, energías simuladas/extrapoladas, lista final, contradicciones y pendientes. Modelo: `comun/dmm_bloque1_final.inc`; ejecutor: `ejecutar_s11_4.py`; consolidación: `analizar_s11_4.py`; evidencia: `resultados/s11_4_campaign_audited.csv`, criterios/diodo/ESD/esfuerzos y findings JSON.
- Validación final: 223 filas firmadas, 0 ausentes/stale, 7 criterios, sin marcadores pendientes en acta; comprobación V²/R de energía del smoke y nombres .meas/estados únicos. Git rastreado limpio; sin captura completa de hashes iniciales, no se certifican cambios concurrentes ajenos.
- No se modificaron S11.1–S11.3, 01_diseno, models, STATE ni DECISIONS; no hubo descargas, ensayo físico ni cambios de firmware/PCB.

Pendientes: hoja/ratings de pulso de cada MPN, respuesta real del GDT, modelo BAT54 del fabricante elegido, referencia/recuperación N2 apagado y fugas reales. No se registra propuesta como acuerdo. Estado: **cerrado**, con limitaciones técnicas abiertas. Sincronización local a continuación, sin editar STATE/DECISIONS.

Sync local completado: 265 fuentes indexadas, 0 retiradas, 0 ausentes. Se repite después de esta anotación y de la precisión final de D6 en el acta para dejar ambas fuentes actualizadas.
