keneth-urbizagastegui/S3G4-LAB/ai-context/journal/2026-10-07-codex-s11-3.md

# S11.3 — Codex

- Inicio: 2026-10-07 19:43:13 America/Lima (creación del diario), agente Codex.
- Encargo: simulación de cierre DMM bloque 1 O4; contrato PLAN_SIMULACION_S11_3.md.
- Restricciones: no modificar S11.1/S11.2, 01_diseno, models, STATE.md ni DECISIONS.md; sin descargas; cambios de piezas limitados a R_X0/R_X2.
- MCP s3g4-context/context-mode no expuestos en esta sesión: consulta por herramienta local y fuentes rectoras.
- Preflight: R3 +60 V DC, relé cerrado, fuente 1 mA, riel -2 %, modelo reducido: convergió, 1.923 s LTspice / 1.991 s pared (19:46 hora local). Dos intentos previos fallaron por generación de deck (reemplazo de .ends y falta de salto de línea), corregidos sin cambiar solver ni piezas.
- Contradicción: DECISIONS prescribe sujeción de N2 a COM; contrato S11.3 prescribe ambos rieles. Se ejecuta el contrato actual y se conserva la diferencia.
- Modelo TVS: restaurada la ley continua exacta de S11.1 (TVRD y TVKNEE calculados desde la hoja pp2–3; fuga lineal 5 µA/12 V, supuesto pesimista). El primer smoke con el traslado discontinuo terminó 4/7 ok y 3 timeout, 312.009 s; se excluye de la evaluación.
- Smoke corregido: 7/7 ok, 274.353 s; R7 integra 12 s y retira tensión a 10 s, con 2 s de observación. No se cambiaron tolerancias ni solver. La extracción posterior añade esfuerzos de puente/capacitores y corriente real del DUT, sin modificar ese circuito.
- Campaña: 630 casos previstos, prioridad R3/R6/R2/R5/R1/R7/R3b, 10 trabajadores, 300 s/caso. R_X0/R_X2: referencia sin resistencia (1 µΩ numérico) y ensayo 100/100 Ω, sin adoptar la variante.
- Campaña parcial: R3 144/144 ok y R6 216/216 ok. Span R3 10.497647 V; ESD 10.673145 V. Con 100 Ω en X0/X2, X1 sigue alcanzando 11.832 mA en aire a 8 kV; no se modifica R_X1 ni se adopta una variante.
- Incidencias de R1: seis nombres de .meas llevan '+' por cargas 2e+06/2e+07 y LTspice los rechaza; el extractor heredado divide ppm por fuente=0 en los 36 casos de tensión. Se corregirá sólo generación/extracción de R1 tras finalizar la campaña en curso, conservando los intentos. No se cambiará solver ni circuito.
- Cierre: 2026-10-07 20:40:58 America/Lima, agente Codex. Acta escrita en S3G4_LAB_rev2.1/03_simulaciones/DMM/ACTA_S11_3.md; ejecutor ejecutar_s11_3.py, extractor analizar_s11_3.py e include comun/dmm_bloque1_o4.inc.
- Correcciones completadas: nombres .meas seguros, división por cero con fuente apagada y signo de corriente absorbida por DUT; sólo generación/extracción, sin cambio de solver ni piezas. R1 queda 54/54 válido. Se conservan los intentos y CSV iniciales; resultado definitivo resultados/s11_3_campaign_audited.csv y s11_3_hallazgos.json.
- Evidencia final: 630 estados, 621 válidos y nueve timeout R7 tensión antes de retirada a 10 s. R3 144, R6 216, R2 18, R5 162, R1 54, R7 nueve ohmios y R3b 18 válidos. Historial 717 invocaciones: 661 ok, 12 timeout (tres preliminares excluidos), ocho errores sintácticos, 36 errores del extractor corregidos.
- Tiempos pared: campaña inicial 1422.777 s; correcciones R1 143.690 s y DUT 124.257 s; smoke válido 274.353 s, adicionales 7.278/4.607 s. Integraciones R7 válidas completas hasta 12 s, sin extrapolación.
- Conclusión: bloque no aprobado. C1/C3/C6 fallan, C2/C8 pasan en modelo, C4 sin certificación, C5 informativo, C7 parcial. Diodo 1 mA: DUT 0.527647–0.562716 mA a 0.65 V; 100 µA: compliance de fuente 3.046638–3.241967 V. R3b Rohm 1.068445 J/100 ms y 21.914220 W pico; no hay modelo destructivo para afirmar qué rompe ni cuándo.
- Pendientes: nueve R7 tensión, ratings/MPN de pulso, modelo físico de sujeción y fuga, especificación BZT, selección RX0/RX2 y validación física. No se convierten propuestas en decisiones aceptadas.
- Protección: hashes agregados iniciales (~19:50) y finales iguales en S11.1/S11.2, models y STATE/DECISIONS. Agregado de 01_diseno distinto; dmm_bloque1.html tiene modificación a 20:01:37. Ninguna operación propia escribió ese directorio; autoría desconocida, sin revertir. STATE y DECISIONS no se editan por prohibición expresa.
- Sincronización local completada: node tools/ai-context/context.mjs sync, salida 260 fuentes indexadas, cero retiradas, ninguna faltante; sin descarga. Verificación de entrega: CSV definitivo de 630 filas y tabla de ocho criterios en el acta.
