keneth-urbizagastegui/S3G4-LAB/ai-context/journal/2026-10-07-claude-auditoria-s11-2.md

# 2026-10-07 — Claude (Opus) — auditoría S11.2 (DMM bloque 1, O2)

- Cambio: nueva `S3G4_LAB_rev2.1/03_simulaciones/DMM/AUDITORIA_CLAUDE_S11_2.md` y scripts en `DMM/chequeo_claude/s11_2/`. No se tocaron archivos de Codex, STATE, DECISIONS, modelos ni hojas.
- Evidencia: smoke reejecutado en C:\s112, 5/5, diferencia 0 en 894 valores; recálculo propio desde .raw (Q3, Q5, Q6, Q1) coincide.
- Hallazgos: no aprobado. Físicos: ESD sobre O2 (V_GS = I·R_LIM; HBM clase 0), C3 vía compensación del divisor (x1), ventana R_LIM inexistente (725 vs 1125 Ω), Tj a 70 °C ≈126 °C con Zth(10 s)≈155 K/W + rizado (no 135.7), C6 a 100 µA por D_blk. Criterio mal puesto: C8 por pico (I²t 6.6 % de 166 A²s), C2 en Q3/Q4 (span 10.68 V cumple). C6 a 1 mA es informativo.
- Pendientes: C7 sin dato; decisión de Keneth sobre TVS/sujeción de puerta, D_blk y R_LIM por banda.
