keneth-urbizagastegui/S3G4-LAB/ai-context/journal/2026-10-07-codex-s11-2.md

# S11.2 — Codex — diario abierto 2026-10-07 18:05:44 America/Lima

- Encargo: ejecutar PLAN_SIMULACION_S11_2.md, sin modificar S11.1, diseño, models, STATE ni DECISIONS.
- Inicio: lectura de AGENTS, START, STATE y contrato. MCP s3g4-context/context-mode no disponible; se emplean fuentes locales y buscador local.
- Q0 antes de seguir: BSS126 Infineon rev2.1 p1: 600 V, 0.5 W, Tj150 C, ID admisible21 mA (NO IDSS max); p2 IDSS>=7 mA sin típico/máximo, VGS(th)=-2.7/-2/-1.6 V a8uA, Ron320 típico/700 máximo a3mA y VGS0, RthJA250 K/W; p3 Ciss21/Coss2.4/Crss1 pF típicos; p4 SOA y Zth; p6 deriva gráfica Vth aprox -3.7mV/C, Ron no lineal. No modelo del fabricante encontrado en models.
- Modelo previsto: MOS nivel1 ajustado IDSS y umbral a8uA, RD para Ron a3mA; capacidades constantes p3, diodo cuerpo p3, BV600 V mediante avalancha explícita (no certifica energía). Deriva aproximada de gráficas, sin garantías ni auto calentamiento eléctrico. IDSS21 mA solo sensibilidad, no máximo de hoja.
- R_LIM: ninguna garantizable. Aproximación Shockley exige R<=700.374 ohm para >=1.3mA con IDSS7mA/Vp1.6; IDSS sin cota superior exige R>=1125 ohm para <=2.4mA con Vp2.7. Se usa R=700 ohm SOLO diagnóstico; no elección válida de diseño. Corrección umbral a8uA se comprobará en Q0.
- GBU808 local Diodes DS21227 rev8 p2: IFSM200A e I2t166A2s (8.3ms), VF1V a4A, 800V. Contradice 175A/127A2s del rediseño; se conservan ambas cifras, comparaciones con hoja local.
- Littelfuse216 p2: 3.15A,250Vac,1500A corte, Rfría nominal0.0368ohm, I2t fusión nominal6.7A2s; p1 tiempos IEC; p2 curva promedio. Se mantiene Rfusible contractual0.04ohm; k1/2/3 es supuesto de arco. No se simula limitación de pico del arco.
- Q3 previo convergió: 1/1 ok, ejecución30.732s, pared31.425s, caso IDSS7mA/Vth-1.6V/0C/riel-2%/fase0. Raw completo hasta1s, relé cerrado todo el tiempo; corriente1.30683mA, span10.4246V. Potencias periódicas FET1/2=0.130677/0.134135W; Tj estimada32.67/33.53C con250K/W. Dispersión últimos5ciclos<0.046%. Se autoriza seguir según contrato; no es aprobación física.
- Q0 verificado en LTspice:12/12 ok, pared2.721s; a25C los cuatro casos dan IDSS7/21mA, I(Vth)=8.00173uA y Ron699.99985..699.99998ohm. 21mA sigue siendo sensibilidad supuesta.
- Smoke:5/6 ok en308.949s, Q7 timeout300.691s. Su raw llega a11s (2,800,219puntos), pero el proceso no cerró en300s; conserva status timeout y no se promueve a ok. Q3 previo ok permanece como condición para campaña. No se cambian ajustes del simulador.
- Campaña inicial lanzada18:17; detenida18:22 aproximadamente para corregir dos defectos del ejecutor, con registro de intentos conservado: I(*) no guarda corrientes jerárquicas (las columnas cero no eran evidencia); fusible ideal sin histéresis tenía impulsos numéricos después de abrir. Se añaden .save jerárquicos y switch Schmitt con histéresis2mA2s y apertura en q=6.7*k. No se cambian piezas ni topología ni parámetros del solver. Nuevas firmas; smoke corregido en marcha (Q3/Q5/Q4/Q1/Q6). Q7 original queda timeout, no se cambia su integración11s.
- Smoke corregido final:5/5 ok en41.419s (Q3/Q5/Q4/Q1/Q6). .save I(Xinst:Dhi) guarda26corrientes; I(D:Xinst:Dhi) no era sintaxis válida (diagnóstico verificar_save.cir). Q5 abre0.769081ms, qfinal6.700159A2s y después<0.651nA: impulsos eliminados. Corriente puente107.50A en fase0 (frente100A del margen). Q3 corregido completo34.094s antes de relanzar. Smoke intermedio41s aproximadamente; todos los intentos quedan en s11_2_attempts.jsonl.
- Cierre numérico 2026-10-07 19:12 America/Lima: campaña498 casos en2563.108s,486ok y12Q7timeout300s;5reutilizados con firma actual. Q3/Q5/Q4/Q1/Q6 completos. Q7 tuvo ventana de extracción vacía; no se publica recuperación0 ni se aprueba C7. Dos prefijos vistos independientemente aún en marcha llegaban8.041797/7.975390s, antes de retirar red a10s. El raw11s del primer smoke no es evidencia de la versión final.
- Auditoría de apertura:53/53ok en156.407s, decks idénticos, diferencias de pico/I2t puente0. Las162aperturas quedan registradas; intervalo total20.307us–4.013857ms, después<0.651nA. GBU808 pico423.592A e I2t10.9303A2s: falla100A, pasa83A2s dentro del modelo de arco supuesto.
- Evidencia final: ACTA_S11_2.md, Q0_BSS126_MODELO_S11_2.md, S11_2_REPRODUCCION.md, include O2, modelo BSS126 de ingeniería, ejecutor y auxiliares; resultados/s11_2_campaign_audited.csv y tablas BSS126/borneA/ESD.559intentos registrados por ejecutor (546ok/13timeout), más12Q0 y53auditoría=624ejecuciones registradas, aparte de diagnósticos/procesos interrumpidos. Campaña final no mezcla versiones previas.
- Hallazgos: R_LIM700ohm sólo diagnóstico, sin resistencia garantizable; IDSS21mA sólo sensibilidad. IlimQ3 hasta2.568752mA, P FET2=0.262652W, Tj135.659C. Inyección riel+5.831mA Q3/+5.884mA Q4 frente3mA. Q1 a100uA3.374266–3.576939V y a1mA1.270904–1.523384V. ESDsinTVS hastaVDS2897.871V,VGS1592.008V,span11.174V yclampHC.431992A: no aprobado. C5 informativo,C7no certificado; C1/2/3/4/6/8fallan.
- Integridad: hashes agrupados de STATE,DECISIONS,6archivos01_diseno,94models y14fuentesS11.1 coinciden con captura18:44. Ninguno editado. No descargas ni hardware ni remedios simulados. MCPs3g4-context apareció conectado tras la compactación; consultas de cierre usan sourceS3G4/sorttimeline. Pendientes: auditoría externa, datos IDSSmáximo/modelo garantizado, hojas zéner/resistencias/derivador, arco real y recuperación física; no son decisiones aceptadas.
- Diario cerrado. Se sincroniza la memoria mediante context.mjs sync; STATE y DECISIONS permanecen intactos por instrucción explícita del encargo.
