keneth-urbizagastegui/S3G4-LAB/ai-context/journal/2026-10-07-codex-s11-1.md

# S11.1 — Codex — 7 octubre 2026

Inicio: sesión del 7 octubre 2026 (America/Lima). Contrato leído íntegro: PLAN_SIMULACION_S11_1.md. Alcance: bloque 1 del DMM; no modificar STATE.md, DECISIONS.md, diseño, modelos ni otros canales. Sin descargas.

MCP s3g4-context/context-mode no expuestos en esta sesión: recuperación mediante CLI local y procesamiento de salidas acotadas. P0 precede a las simulaciones. No se ha ejecutado todavía ninguna prueba.

Pendientes: fuentes rectoras, hojas y ajuste térmico PTC; implementación, smoke, campaña, acta y cierre.

## Reanudación — 7 octubre 2026

Keneth detuvo la primera campaña por tiempos límite. Releídos íntegros el diario, el plan incluido §3b y el encargo antes de modificar el ejecutor. Se aplicará red de 60 Hz, PTC de 40/60 Ω, simulación hasta disparo o 1 s y extrapolación explícita hasta 10 s; ESD de 10 µs con paso ≤1 ns inicialmente. Se conservan P0 y resultados ok compatibles mediante --resume. Orden: P3, P2, P4, P5, P1, P6, P7. C4 sigue orientativo por falta de curva térmica. MCP de contexto no expuesto; se usa CLI local. No se modifican STATE.md ni DECISIONS.md por prohibición expresa del contrato.

## P0 antes de continuar

Hojas presentes: ptctl.pdf (Vishay 29070), SMAJ12CA.pdf (Diodes DS19005), y las restantes del contrato. ptctl.pdf p.1: PTCTL4MR500SBE = 50 Ω ±20 %, 600 Vrms/DC, Int 50 mA a 70 °C, It 140 mA a 25 °C, máximo 1 s a 1 A, Imax 1 A a Vmax. No existe curva de disparo ni R(T) ni enfriamiento en sus 3 páginas técnicas (p.4 es aviso legal). Contradicción: el plan indica 35 Ω mínimos. Se conserva 35 Ω contractual; no se cambia el valor para ocultar la contradicción.

Modelo térmico provisional, sin ajuste a curva inexistente: coordenada normalizada theta; dtheta/dt = P/Ecrit - theta/tau. R(theta) por tramos: Rfrio hasta theta=1, aumento exponencial a 1 MΩ entre 1 y 1.4, saturación a 1 MΩ. Se define disparo al inicio del aumento, theta=1. Se impone equilibrio a 140 mA y disparo a 1 s con 1 A constante: G=Rfrio*(0.14 A)^2; Ecrit=-G/log(1-(0.14/1)^2); tau=Ecrit/G. La elección del aumento y Rcaliente no está respaldada por la hoja. Solo reproduce el punto máximo 1 A/1 s y el umbral supuesto; NO identifica masa térmica física, temperatura ni recuperación garantizada. Se calcularán los parámetros por Python. El resultado PTC será orientativo y C4 no podrá certificarse aunque un transitorio converja.

P0 adicionales: TVS p.2: 400 W pulso no repetitivo, 1 W continuo con terminal a 75 °C; p.3: 12 V standoff, 13.3–14.7 V a 1 mA, 19.9 V a 20.1 A, fuga máxima 5 µA a 12 V (no garantiza la fuga a 4 V). BAV199 p.2: 75 V DC/85 V repetitivo, 140 mA ambos cargados, 250 mW; p.3: 5 nA máx a 75 V/25 °C, no límite específico a 4 V. TQ p.6: 125 Vac de conmutación, 1000 Vrms aislamiento contactos abiertos (no equivalente a conmutar 230 Vac), suelta máx 4 ms sin diodo frente a 3 ms contractual. DF08S p.2: 800 V, 50 A/8.3 ms, I²t 10.4 A²s solo t<8.3 ms. Falta MPN/hoja de resistencias, capacitores, fusible y derivador: sus márgenes de energía no se certifican por formato.

## Evidencia del relanzamiento — campaña en curso

Matriz de 546 casos: P3 216, P2 18, P4 72, P5 18, P1 108, P6 96, P7 18. Red 60 Hz; PTC parametrizada 40/60 Ω, con Ecrit y G recalculados para cada extremo. Red hasta 1 s, paso 50 µs; ESD 10 µs con paso 1 ns. Resume verifica las firmas originales de P1 de tensión compatibles; red a 50 Hz se repite.

Smoke completo final: 3/14 ok, 84.065 s, diez trabajadores, límite 60 s; salida 1. P5 termina, P4 falla numéricamente y los demás representantes agotan límite. El fallo dominante de P3 sucede al buscar el punto de operación, antes del transitorio; acortar el tiempo simulado no lo resuelve. Pruebas de uic (fallo en nodos internos TI), nodeset, regularización de rieles, gshunt y gmin no resolvieron el problema y se descartaron. El include final conserva los rieles originales y solo cambia la función RPTC para recibir RCOLD. Modelos parciales input/external siguen marcados como diagnósticos, sin sustituir al completo.

Prueba de integración con raw sintético: 6 J integrados en 1 s + 54 J extrapolados = 60 J, y un raw incompleto no extrapola. Campaña completa en ejecución con --resume, diez trabajadores y límite 30 s/caso, prioridad contractual. Los 216 P3 agotaron límite, sin transitorio válido ni tiempo de disparo.

Primer P5 completo (60 Hz, fase cero, riel 0.98): DF08S por diodo ≈386.203 A pico e I²t≈603.659 A²s hasta 8.3 ms; derivador 15.5376 J simulados en 10 ms; span local ≈21.6932 V. Ambas R_S coinciden. Son resultados del modelo, cuyo ajuste del DF08S a 1 A no valida extrapolación a cientos de amperios. No hay energía extrapolada en ese ensayo corto. El acta recogerá las limitaciones y el bloque no se dará por aprobado.

Pendientes de cierre: terminar campaña, generar CSV de energías/acta y resumir cobertura. P7 auxiliar usa retirada a 1 s y observación hasta 2 s, sin estado inicial validado tras 10 s extrapolados; no certifica C7. Tampoco se implementó corte dinámico exacto al disparo ni régimen caliente aparte: cualquier caso que converja debe comprobarse antes de considerar cumplido §3b.

## Segunda reanudación — 7 octubre 2026

Releídos íntegros el diario, el plan con §3c y el encargo antes de tocar modelos o ejecutor. Keneth detuvo la campaña por ausencia de convergencia inicial de P3 y fallos numéricos de P4. Se prepararán modelos reducidos de protección/capacidad/consumo para P2–P7, conservando completos solo en P1; límite 300 s/caso y P5 con 0.5/1/2 Ω. Se exige convergencia de un P3 antes del smoke y campaña; si falla se detiene y se levanta acta. Se mantienen 60 Hz, PTC 40/60 Ω y separación de energía simulada/extrapolada. Sin descargas, cambios de piezas ni remedios. MCP s3g4-context y context-mode no disponibles; recuperación local. STATE.md y DECISIONS.md quedan fuera por prohibición expresa vigente.

### Modelo reducido y comprobación previa (14:06 America/Lima)

`comun/dmm_reducido_s11_1.inc`: OPA2188 pp.4/5/6 (±10 mA, diodos a rieles, 9.5 pF común/6 pF diferencial, 415 µA por canal); TLV2372 pp.8/11/13 (±10 mA, margen ±0.2 V, 8 pF, 550 µA a 5 V por canal, usado como aproximación a 9.8 V); 74HC4051 pp.1/5/9/10 (60 Ω típico, ±20 mA sujeción, 25 mA canal, 16 µA a 10 V, 5/25 pF). Diodos con Ron=1 Ω aproximado, sin limitar artificialmente corriente. BSS84 p.2: 24.6/4.7/2.8 pF típicos y diodo de cuerpo; NO hay diodos de puerta a rieles especificados, no se inventan. Fuente P43 abstraída por fuente de corriente con cumplimiento; terminales TLV de sentido a ms/msource, sin resolver el lazo real. No certifica el lazo TLV ni transferencia/recuperación OPA. Carga equivalente total 3 mA entre rieles incluye consumo de los integrados y residual, sin doble cuenta. Resistencias equivalentes también consumen con riel apagado: aproximación, no caracterización de alimentación inversa.

Comprobación obligatoria P3: `s11_1_preflight_mixta.csv/json`, 1/1 ok, 38.044 s, límite 300 s. R_S 100 Ω, PTC 40 Ω, riel 0.98, fase cero, fuente 1 mA y apertura efectiva 23 ms. Gmin automático encontró el punto inicial; raw completo hasta 1 s. No se reintentó con ajustes del simulador. Se autoriza técnicamente seguir al smoke; esto no es aceptación eléctrica del bloque.

Smoke §3c: 14/14 ok, 67.573 s, diez trabajadores, 300 s/caso, salida 0; `segundo_smoke.log` y `s11_1_smoke_mixta.csv/json`. P4 ahora completa. Primer P3 alcanza 24.117 V entre rieles (fallo del límite contractual 11 V), sin disparo antes de abrir a 23 ms. TVS: 1.85886 J integrados en 1 s + 0.0000707162 J estimados hasta 10 s (apertura ya producida; comprobación periódica válida en este modelo). Campaña mixta lanzada con --resume y S3G4_MODELS, diez trabajadores, límite 300 s y prioridad P3/P2/P4/P5/P1/P6/P7. Solo firmas actuales ok se conservan; reuso legado desactivado.

Verificación auxiliar: `validar_relanzamiento_s11_1.py` pasa con 570 casos únicos, tres impedancias P5, 60 Hz, extremos PTC y paso ESD; integración sintética 6 J + 54 J = 60 J y rechazo de raw incompleto. Se consultaron decisiones D1–D8/B2, H §3 ①–②, §5 y §7, plan/acta S2b. H todavía describe DF10S y P42: prevalece DF08S/B2 del contrato actual, sin editar H.

Durante campaña: casos P3 sin apertura disparan, pero RPTC al segundo queda en transición (≈14–22 kΩ para los primeros R_S=100 Ω), con potencia y rieles todavía variando; la extrapolación es rechazada. No presentar estas estimaciones rechazadas como energía total a 10 s. Sigue pendiente el corte dinámico exactamente al disparo y un régimen caliente separado; el ejecutor conserva el límite de 1 s y el acta debe declarar esta desviación, no dar por cerrado C4. La masa térmica y el enfriamiento siguen sin validación de hoja.

### Corrección de carga apagada — 14:43 America/Lima

Se detectó que `Riqother` (residuo de carga externa de 1.054 mA a 9.8 V) seguía conectada en P4, contra §1.4 «sin carga». Se detuvo únicamente el Python de esta campaña (PID 25044) y sus LTspice hijos, sin tocar otros procesos. Primer tramo de campaña: aproximadamente 2102 s de pared, por CreationTime del log y hora de parada. No fue un cambio del simulador ni un remedio de protección: se corrigió el estado apagado del banco.

El generador elimina `Riqother` solo con POWER=0; mantiene las resistencias equivalentes de consumo de los integrados exigidas por §3c. Las netlists encendidas quedan byte por byte iguales; comprobada la firma actual del P3 inicial. Se repite smoke con resume: P4 debe recalcularse, los otros representantes se conservan solo por firma exacta. P3 216/216 y P2 18/18 ya completos mantienen sus firmas. Los P4 anteriores con carga externa residual NO son resultados válidos de esta campaña corregida; el resumen final se hará exclusivamente con el CSV y firmas actuales. Los intentos se conservan para trazabilidad.

Smoke corregido: 14/14 ok, 42.689 s, salida 0 (`segundo_smoke_corregido.log`), conservando 12 casos por firma exacta y recalculando 2 P4. Campaña corregida en `segundo_campana_corregida.log`, mismo orden y límite de 300 s. Tabla de picos por pin HC/OPA: se derivarán de Vexceso y la IV del clamp reducido (Vf=0.5 V, Ron=1 Ω), sin sumar máximos no simultáneos. La medida de inyección heredada solo suma BAV externos. No se dará por validada una corriente total por riel a partir de esa suma incompleta.

### Corrección del estado de relé en P1 — 15:01 America/Lima

Los primeros P1 de fuga revelaron un error heredado: opening=0 abría el relé a los 3 ms y desconectaba el DUT antes de la lectura final. Se detuvo el ejecutor de campaña PID 4952 y sus hijos, tras aproximadamente 1006 s adicionales (hora/CreationTime del log). Se cambió solo P1 diodo/fuga a opening=100 (no abre): los 36 casos afectados tienen nuevas firmas y deben repetirse; los resultados con apertura a 3 ms se excluyen de C5/C6. No se cambió el circuito de protección ni los ajustes del simulador. P2/P3/P4/P5 y P1 de tensión conservan netlist y firma. Smoke de estados: 14/14 conservados por firma con resume, salida 0.

Ya había cuatro P1 de tensión agotados a 300 s. Al relanzar con resume solo se conservan ok, como pide §3c; esos fallos podrán repetirse con los mismos ajustes, no con ajustes distintos ni remedios. Los intentos previos quedan registrados. P5 cerrado ya completo: 36/36; picos por diodo de 386.213/196.709/92.7964 A e I²t hasta 8.3 ms de 603.676/153.149/32.5599 A²s para 0.5/1/2 Ω, ambos R_S. Todos exceden máximos de la hoja; ajuste IV a 1 A no validado a cientos de amperios.

## Cierre — 2026-10-07 15:47:46 -05:00 — Codex

Campaña final terminada: 570 casos, 536 ok, 33 timeout y 1 fallo numérico, salida 1. Todos los fallos son P1 (74/108 ok). P3 216/216, P2 18/18, P4 72/72, P5 42/42, P6 96/96 y P7 18/18 completos. Diez trabajadores, 300 s/caso, S3G4_MODELS y resume por firma exacta. Última ejecución 1969.332 s; acumulado aproximado de campaña 5077.332 s (84.62 min), más preflight/smokes. Se excluyen los P4 con carga residual externa y los P1 diodo/fuga con apertura a 3 ms. No se ajustó el simulador para los casos fallidos.

Verificación final: 570 firmas actuales comprobadas, nombres únicos y relé P1 de diodo/fuga permanentemente cerrado. Se corrigió el lector raw: 34 P1 ok tienen el último punto entre 0.10 y 8.72 µs después del stop y cubren el intervalo; no son prefijos incompletos. CSV `s11_1_campana_auditada.csv` conserva la clasificación anterior en raw_endpoint_exact y anota raw_overrun_s; ninguna medida numérica cambió. 536/536 ok cubren su endpoint. Energías integradas sobre el intervalo observado real, incluido ese pequeño excedente en P1. Prueba sintética pasa: 6 J simulados + 54 J extrapolados, prefijo abortado sin extrapolar, y excedente temporal cubierto clasificado completo. Importación en ruta corta C:/S11 con S3G4_MODELS verificada sin lanzar LTspice; raíz del proyecto y decks físicos sin cambios.

Resultados: C1–C3 fallan en ambos R_S. Span máximo P2–P4: 24.2002 V (100 Ω) / 20.7141 V (330 Ω). Apagado: 9.08277 V sin cuerpo y 6.24358 V con cuerpo, dentro del modelo resistivo; los máximos de rp/rn no son simultáneos. PTC dispara entre 33.8135 y 77.9019 ms en los casos que lo alcanzan; apertura efectiva a 23 ms no llega al disparo. C4 permanece orientativo: falta curva térmica, corte exacto en θ=1 y régimen caliente validado. Los 72 P3 sin apertura no tienen extrapolación válida. Los 144 P3 que abren sí cumplen la comprobación periódica de extrapolación del modelo. P7 es diagnóstico 1 s + 1 s, sin estado tras 10 s ni enfriamiento de hoja: C7 no certificado.

C5 falla en el modelo de fuga lineal de TVS: máximos ≈735230 ppm a 0.2 µA y ≈409827 ppm a 1 µA; no son fuga real garantizada a 4 V. C6 supera 3.5 V en los casos completos: mínimos 4.11264 V (100 Ω, 4/6 completos) y 3.90401 V (330 Ω, 1/6), corriente fuente ≈0.995 mA, no exactamente 1 mA. No se certifica el criterio completo ni se oculta la cobertura faltante.

P5: tabla DF08S por diodo en el acta y `s11_1_df08s.csv`, con ambos R_S y 0.5/1/2 Ω. Energía máxima del derivador en 10 ms: 19.5787/6.81903/2.57721 J simulados, sin extrapolación; I²t del derivador = E/0.100 Ω, sin rating de hoja disponible. X5 con fusible abierto: corriente máxima por Rwarn ≈31.997 µA y tensión pico ±5.49652 V. IV del DF08S solo ajustada a 1 A; no validada a cientos de amperios. No se eligió una nueva protección ni un R_S.

Entregados: ACTA_S11_1.md, modelo reducido citado, ejecutor/lector corregidos, resumir_s11_1.py, P0 ampliado y CSV de campaña/auditoría, energía separada, pines reducidos, pieza más cargada por caso y DF08S. Diario cerrado documentalmente; bloque NO APROBADO. Pendientes explícitos en el acta: curvas/rating/fuga no disponibles, cumplimiento del tramo exactamente hasta disparo y estado de recuperación a 10 s, modelos sin caracterización de daño/latch-up/alimentación inversa y lazo TLV/P43 abstracto. No se tocaron STATE.md, DECISIONS.md, diseño, modelos del fabricante, firmware ni otros canales. Después del cierre se sincroniza la memoria con el CLI local, sin MCP disponible.
