keneth-urbizagastegui/S3G4-LAB/ai-context/journal/2026-10-07-claude-dmm-34401a.md

# R9 Agilent 34401A: anatomía (7 oct 2026, Claude Opus 5.5)

Referencia 9 de 9 del estudio del DMM. Con ella terminan las referencias; lo siguiente es la síntesis.

## Cambio

- Página nueva `S3G4_LAB_rev2.1/02_referencias/dmm_34401a.html` → https://claude.ai/artifact/Gd8rGXutjjVU3zHBf2p9LY.
- Scripts `herramientas/calc_dmm_34401a.py`, `draw_dmm_34401a.py` (dibujos `ohmios` y `alterna`, 0 solapes) y `build_dmm_34401a.py`.
- Actualizados `ARTEFACTOS.md`, `herramientas/LEEME.md`, el plan (7b hecho), STATE, el diario de retomada y la memoria.

## Evidencia

- `research_and_tests/Agilent_34401A/34401A_Service_Guide.pdf` (Keysight, ed. 9, 2014): especificaciones (pp. 20–23), teoría (pp. 100–115), autopruebas (pp. 128–132) y esquemas vectoriales (pp. 157–160) renderizados por zonas.
- **Leído en los esquemas:**
  - HI: descargador E100 en serie con RV100 ∥ C109 de 10 nF ∥ 2 MΩ;
  - corriente: RV102, F101 de 3 A, F102 de 7 A y el puente CR100 con U110 haciendo de bootstrap a través de R150 (10 kΩ) y R151 (316 Ω);
  - fuente de ohmios: IREF = 7 V / 40 kΩ (o 400 kΩ) en 28.57 kΩ, U201B fuerza la misma caída sobre 5 k / 50 k / 500 k / 1 M, U101E con fuerza y sentido, JFET Q202, escalera Q203–Q210 polarizada por Q211 y R203–R206 de 196 kΩ, y CR202;
  - ganancia: 180 k / 18 k / 2 k con tomas elegidas por U101C hacia la puerta del FET;
  - alterna: C301 de 0.22 µF, 2 × 500 kΩ, R304 de 200 kΩ, C302 de 1.8 pF, C304 de 6.8 pF + R313 de 6.19 kΩ, y C306 de 5.6 pF con el pie movido por U303 desde el AD7524.
- **74HC4051 (Nexperia, rev. 12, p. 10):** Csw de 25 pF en el común y 5 pF por canal; fuga en apagado de ±0.1 µA por canal (25 °C) y ±1 µA (−40 a 85 °C).
- **LCSC:** MMBTA92 C20069146 (300 V, preferente, 0.029 USD); 1N4007W C18199088 (1 kV, preferente, 0.009 USD).

## Cifras propias (calc_dmm_34401a.py)

- Corrientes de ohmios de 1 mA a 0.5 µA. La lectura de ohmios no cambia con la deriva de la referencia (es ratiométrica).
- Alterna: con un 1 / 2 / 5 % de desajuste de τ en ÷10 con τ = 60 µs, el error a 20 kHz es de −0.9 / −1.7 / −4.2 %.
- Rechazo de 60 Hz: 16 dB integrando 20 ms, 40 dB con 16.67 ms (±1 %) y 40 dB con 100 ms para 50 y 60 Hz.
- Autocero: al volver de X3, salto del 33 % en ÷10 y del 4.8 % en ÷100; hasta 1 cuenta en 0.79 y 0.43 ms.
- Fuga en la toma ÷10: 0.3 cuentas en el 34401A, 8.5 con el OPA2188 (máx.) y ~1000 con el 74HC4051 (máx.).

## Propuestas (sin aplicar)

- **P38** Autocero con tiempo de asiento y precarga.
- **P39** Corrección de alterna por firmware.
- **P40** Integración ligada a la red de 60 Hz.
- **P41** Autoprueba al encender.
- **P42** Protección de la fuente de ohmios con semiconductores, frente a la PTC de P30.

## Correcciones registradas

- Sección H §3: la fuga «unos nA» del 4051 no está garantizada.
- La red de Perú es de 60 Hz.

## Pendientes

- La síntesis: las nueve referencias, la lista P17–P42 para Keneth, la revisión de la sección H y el encargo S11.
- Se pueden adelantar en el banco la INL del ADC5 (P36) y la fuga del 74HC4051 (P37).
