keneth-urbizagastegui/S3G4-LAB/ai-context/journal/2026-10-07-claude-plan-referencias-dmm.md

# Plan de estudio de referencias del DMM (7 oct 2026, Claude Opus 5.5)

- Pedido de Keneth: estudiar a fondo las referencias del DMM como se hizo con el osciloscopio, una página por referencia, buscar más en internet y sin módulos.
- Inventario local:
  - Micro-DMM: 399 MB, unas 35 variantes de placa y firmware Arduino;
  - TIDA-01012: guía de 75 p y esquemático de 6 p;
  - HydraMeter 0.4: KiCad de 6 hojas, PDF, código y bitácora de hackaday;
  - Analog_: dos artículos de ADI sobre 7.5 dígitos.
- EEWorld 77845: el texto se leyó con el navegador integrado. Es un STM32F1 con el ADC interno, LM324 + CD4052, MAX4080 + relés y ohmios por divisor con MOSFET; ≈ 1 % frente a un UT71C. Solo trae el diagrama de bloques y fotos, sin esquemático.
- En la web: TIDA-00879 (MSP430F6736 con ΣΔ interno, archivos de diseño en ti.com), EEVblog 121GW (esquemático publicado; protección con HRC + TVS + PTC + MOV + puente) y el Open Source Multimeter de Martin (STM32F1, EmbedBlog; repositorio por localizar).
- No se descargó nada. Plan escrito en `S3G4_LAB_rev2.1/06_plan/PLAN_REFERENCIAS_DMM.md`.
