keneth-urbizagastegui/S3G4-LAB/ai-context/journal/2026-10-06-claude-s10-esquema-ch23.md

# 2026-10-06 — Claude Code (Sonnet 5.5, Konnect) — S10 esquema CH2/CH3

- **Cambio:** `ch2.kicad_sch`, `ch3.kicad_sch` y dos símbolos de hoja en `s3g4.kicad_sch` (rama `ai/s10-ch23-esquema`, commits 7a0ef73, 1cbd594, 9afa016; sin push). Antes se commiteó la raíz guardada por Keneth (88151ab).
- **Evidencia:** `S10_CH23/INFORME_S10.md`, `s10_ch23.net`, `erc_s10.json`, `s10_ch2/3.pdf`, `vistas/`.
- **Pruebas:** `verificar_ch23.py` código 0 (89/87/87, 0 diferencias); ERC 31 = 7+9+15 sin otros tipos; comprobador de textos 0 solapes en las tres hojas.
- **Pendientes:** Keneth abre/guarda ch2 y ch3 en KiCad (limpia la ruta de instancia obsoleta de ch2) y rellena cajetín; auditoría de Claude; dudas del informe (C207 8.7 vs 8.2 pF, RFILT1 −0.84 %). No se tocó firmware, PCB ni CH1.
