keneth-urbizagastegui/S3G4-LAB/ai-context/journal/2026-10-03-0210-codex-s2-ch1.md

# 2026-10-03 02:10 America/Lima — Codex: S2, protección de CH1

Agente: Codex. Encargo actual de Keneth: cumplir ENCARGO_CODEX_S2.md y
PLAN_SIMULACION_S2.md íntegros, sin confirmaciones ni límite de sesión.
Fuentes: START/STATE y AGENTS; planes S1/S1b/S2, actas S1/S1b y auditorías
Claude de S1/S1b/P4-P7; DECISIONS 2/3 oct; revisión de entrada §4/§6 y
documento vivo C.6/G.3/G.5/G.6; LEEME de modelos; hojas locales OPA810 p.4,
AD8065 p.9/21 y BAV199 p.2. No descargas ni ensayos físicos.

## Cambio

Nuevos entregables en `S3G4_LAB_rev2.1/03_simulaciones/CH1_entrada/`:
- `comun/ch1_comun_s2.inc`: P4b con parámetros derivados de CJ real,
  BAV199 Nexperia sin .ENDS huérfano; envoltorios con orden correcto para
  OPA810/AD8065, rieles de entrega unilateral y cargas/descargas del contrato.
- `ejecutar_s2.py`: pool de 10 desde el primer lote, --smoke separado,
  umbrales en LIMITS, CSV deterministas, conservación de .cir/.log y lectura
  de .raw antes de eliminarlo. Código distinto de cero por error de simulación,
  no por fallos de criterio eléctrico.
- `S2/` con netlists, logs, reproducibilidad y verificador independiente.
- 12 CSV `resultados/s2_*.csv`, manifiesto JSON, resumen y `ACTA_S2.md`.

## Evidencia y pruebas

Smoke válido: 21 simulaciones, código 0, sin errores/advertencias, 35.789 s.
Campaña: 119 simulaciones, código 0, sin errores/advertencias, 61.026 s.
Reejecución: 119, código 0, sin errores/advertencias, 61.264 s; 12 CSV idénticos
byte a byte. Verificador código 0: 119 estados únicos, 5068 medidas etiquetadas
con estado real; paso E7 ≤0.1 ns, contraste de 0.05 ns con cambio máximo
0.147 %. 19839 archivos protegidos sin cambios; hashes en
`S2/verificacion_entrega.json`, ligada al manifiesto y a los dos códigos fuente.

OPA810: C1 falla (ΔCin 2.839881 pF y error de ganancia 0.536898 %), C2 falla
(R_EQ 99.012 V frente a 75 V reducidos; C_S 94.256 V frente a 80 V), C3 y
C6 fallan (excursión sobre riel de hasta 1.688 V; BAV cerca de 24 A vs
4 A/1 µs), C4/C5/C7/C8 pasan en los modelos del alcance declarado.
C4: rieles 4.975668–4.980100 V. C5, referencia sin macro encendido:
sin descarga 0.449344 V, 10k 0.170160 V, 100Ω 0.00310446 V.
C7: 0.076053 mV referido a BNC. C8: THD 0.000003581 % y BAV 0.002707 µA.
E8 OPA810 (+40/−40): ±5mV en 1002.727/1007.045 µs; ±0.5mV en
1311.927/1355.045 µs, frente a objetivo orientativo de 10 µs.

AD8065 pasa C1 (ΔCin 1.483685 pF) y C7 (0.403697 mV); no corrige C2/C3/C6.
Su diferencial llega a 4.00243 V frente a 1.8 V de máximo. E8 (+40/−40):
±5mV en 1015.705/992.912 µs y ±0.5mV en 1558.405/1247.112 µs; el modelo
declara no representar overload recovery, por lo que no demuestra esos
tiempos del silicio. Comparación completa por estado en s2_segunda_fuente.csv.

## Dudas y pendientes

- Se conserva CIN_BUF explícita de 5pF por contrato además de la capacidad
  interna del macro; C_SEL_EST contractual no incluye toda esa carga real.
- C_EQ recibe unos 99 V, pero su rating está sin definir. R/C no tienen MPN
  con autoridad para pulse rating/derating térmico. No se han elegido piezas.
- Macro OPA810 apagado conserva fuentes internas y llega a invertir rieles.
  Se conservó la variante REAL y se añadió OFF_LOAD_ONLY con 1MΩ por riel;
  C5 se evalúa en esa referencia, sin afirmar seguridad de la entrada del
  buffer sin alimentación. Es una limitación de simulación, no una decisión
  de modificar hardware.
- La red ESD 150pF/330Ω de descarga por contacto, sin inductancias/arco,
  no reproduce la subida IEC ni valida ±8kV en aire. La energía integrada de
  entrada no tiene rating admisible de fabricante. No se certifica supervivencia.
- TVS genérica y cargas agregadas más consumo del macro son las del contrato;
  sus aproximaciones se explican en el acta. AD8065 no modela distorsión ni
  recuperación de sobrecarga.
- Auditoría Claude y decisiones sobre los fallos eléctricos quedan pendientes.

No se tocaron S1/S1b, modelos, chequeo_claude, firmware, PCB ni documentos de
diseño. Se respetó la prohibición expresa del encargo de cambiar STATE.md y
DECISIONS.md; no se registraron propuestas como acuerdos. El MCP específico
s3g4-context no estaba conectado; se usó el buscador local y context-mode
genérico para análisis. Se sincroniza el diario con context.mjs sync.
