keneth-urbizagastegui/S3G4-LAB/ai-context/journal/2026-10-03-0247-codex-s2b-ch1.md

# 2026-10-03 02:47 -05:00 — Codex — S2b de la entrada CH1

Agente: Codex. Encargo: `ENCARGO_CODEX_S2b.md`; contrato:
`PLAN_SIMULACION_S2b.md`, en `S3G4_LAB_rev2.1/03_simulaciones/CH1_entrada/`.
No se modifica STATE ni DECISIONS por prohibición expresa del encargo.
MCP s3g4-context y herramientas context-mode ausentes en esta sesión; se
consultó el buscador local `node tools/ai-context/context.mjs search` y las
fuentes puntuales completas, procesando las salidas con Python.

## Cambio

Archivos nuevos: `comun/ch1_comun_s2b.inc`, `ejecutar_s2b.py`, `S2b/` con
netlists/logs y verificador, `resultados/s2b_*.csv`, resúmenes y `ACTA_S2b.md`.
Se reutilizan auxiliares de ejecutar_s2.py sólo en memoria, sin editar S2.
CIN_BUF=0; C_SEL_EST usa capacidad común de hoja: OPA810 2.5pF y OPA828 9pF.
Se recalculan sólo CB/CS/CEQ autorizados; los límites de R_EQ/C_EQ/C_S pasan
a 200V. No se ajustan piezas tras observar fallos ni se eligen protecciones.

Generador pasivo propio de dos ramas RLC, calibrado en LTspice sobre 2ohm
antes de E7b/c. Aire: mismo generador con resistencia serie de 300ohm.
I2t independiente por diodo con integral sobre 2ms y control a 4ms;
contraste .meas/raw, ventana de primeros 100ns comprobada sobre el raw.
E9 se repite también con OPA810 para comparar ambos buffers en los mismos
estados. Segunda fuente OPA828 local, sin descargar ni modificar modelos.

## Evidencia y pruebas

- Smoke final: código 0, 26 simulaciones, 0 errores/advertencias, 18.544s.
- Campaña: código 0, 120 simulaciones, 0 errores/advertencias, 69.206s,
  pool de 10 trabajadores, un hilo por LTspice.
- Verificador: código 0; 120 estados únicos, 5270 nombres de medidas;
  máximo paso observado de primeros 100ns: 26.667ps, menor que 50ps.
- Copia en ruta temporal distinta con S3G4_MODELS: código 0, 120 simulaciones,
  50.931s; los 14 CSV completos coinciden byte a byte. Evidencia:
  `S2b/verificacion_entrega.json` y logs de reejecución.
- 20179 archivos protegidos, ningún cambio detectado; incluye S1/S1b/S2,
  modelos, chequeo_claude, STATE y DECISIONS. Nada de firmware ni PCB.
- Generador 4kV: 14.985868A, subida 0.805105ns, I30 7.926374A, I60 4.046079A.
  A 8kV: 29.971736A, 0.805105ns, 15.852747A y 8.092158A. Los cuatro puntos
  cumplen en ambos niveles. I30/I60 desde el cruce inicial del 10%; también
  se conservan medidas desde cierre del switch.

## Resultados y pendientes

OPA810: C1/C2/C4/C5 pasan según el contrato; C3 falla en continuo, con
100Vpk/1kHz, POS1/AC: la entrada supera el riel en 0.838447V, frente a 0.5V.
Esto contradice la atribución de la auditoría S2 de ese exceso sólo a ESD;
se conserva el hallazgo y no se cambia el circuito.

I2t máximo por diodo con OPA810 (unidades 10^-6 A²s): ±4kV contacto,
DHP 3.413014 y DLP 3.413015; ±8kV contacto, DHP 13.673702 y DLP 13.673701;
+8kV aire, DHP 6.964604 y DLP 4.861422e-7. Límite reducido: 8 por diodo.
OPA828: ±4kV 3.587430/3.587491, ±8kV 14.374942/14.375008,
+8kV aire 7.320702/4.878234e-7. Todos los estados individuales en CSV.

OPA828 tiene diferencial dentro de su hoja en los estados medidos, pero falla
C1 (Cin 30.879–31.297pF, error de ganancia 0.541745%) y C3 (0.544754V fuera
del riel). Se informa la comparación, sin decidir segunda fuente comercial.

Pendientes: auditoría de Claude; macro apagado no validado; C5 del plan usa
±7V para OPA810 incluso apagado, mientras su hoja pide min(7V, span de rieles).
En apagado se mide exceso diferencial sobre ese span de 0.606629V. Por tanto
el pase contractual C5 no valida supervivencia física. Falta rating de pulso
de piezas concretas y ensayo IEC real; aire +8kV es orientativo y no cubre
la polaridad negativa del requisito. Cuatro puntos de calibración no fijan
de forma única la impedancia de la pistola. C.6 aún conserva ratings/valores
antiguos; no se editó para resolver la contradicción.

Incidencias del ejecutor corregidas: parámetro CBUF_EST duplicado en el primer
smoke; contraste relativo de I2t casi nulo en el diodo inactivo. Se documenta
piso absoluto de 1ppm del límite de C5, sin cambiar estímulos o piezas.
Tras la verificación se añadieron sólo explicación de resultados, lectura y
documentación; CSV y configuración numérica no se cambiaron.
