keneth-urbizagastegui/S3G4-LAB/ai-context/journal/2026-10-03-claude-s3-u103.md

# 2026-10-03 — Claude Code: elección de U103 y encargo S3 de CH1

## Cambio

- **U103 = AD8039** (decisión de Keneth, `DECISIONS.md` 3 oct) y **E12 relajado a ≤ 0.45 %** de división.
- Escritos `S3G4_LAB_rev2.1/03_simulaciones/CH1_entrada/PLAN_SIMULACION_S3.md` y `ENCARGO_CODEX_S3.md`, con el patrón de S2b: 10 trabajadores, `--smoke`, `S3G4_MODELS`, sin tocar entregables anteriores. Criterios S3-C1…C8 sobre E11–E15.
- **Codex no se ha lanzado.** Falta la §0 del plan.

## Evidencia

- Búsqueda en LCSC de dobles con GBW ≥ 90 MHz (pcbparts, 54 resultados). Con alimentación de ±5 V y stock útil quedan AD8039, AD8056, ADA4896-2, LM6172, LMH6643, THS4082 y ADA4851-2. Los de 5.5 V de alimentación máxima (GS8052, OPA2836, OPA2357…) no sirven con ±5 V.
- **Hoja del LM6172 (TI, descargada):** a ±5 V el ancho de banda unitario es 70 MHz, con −3 dB a ×2 de 75 MHz (D) y diferencial ±10 V. A ±15 V llega a 100 MHz. **No cumple el GBW ≥ 100 MHz de CH1** con nuestros rieles.
- Las hojas de ADI no se pueden descargar desde aquí: analog.com y Mouser devuelven HTML o una descarga del navegador, y el espejo de LCSC sólo da una página. Las cifras del AD8039 y del AD8056 son las de LCSC/pcbparts y las que recuerdo de la hoja; **sin verificar**.
- Ruido de C.5 a 5 mV/div en CH1 (toma 1, 3.15 MHz de ancho de ruido; OPA810 6.3 nV/√Hz + R_PROT + Ron del 4051 de 70 Ω + U103A + U103B/5.02):

| U103 | R_PROT / red | Delante (nV/√Hz) | U103 (nV/√Hz) | % div |
|---|---|---|---|---|
| LM6172 | 1 k / 1 k | 7.6 | 11.9 | 0.50 |
| AD8039 | 1 k / 1 k | 7.6 | 9.0 | **0.42** |
| AD8039 | 470 / 499 | 7.0 | 8.6 | 0.39 |
| AD8056 | 1 k / 1 k | 7.6 | 7.2 | 0.37 |
| AD8056 | 470 / 499 | 7.0 | 6.7 | 0.34 |
| ADA4896-2 | 1 k / 1 k | 7.6 | 4.6 | 0.31 |

  Con un U103 ideal, el suelo es ≈ 0.27 %: lo pone el buffer. Para 0.35 % hace falta en ≤ 5.6–6.4 nV/√Hz, y eso sólo lo dan piezas de 6 mA o de Ib alto.
- El ruido propio del ADC (0.16–0.24 %) se suma en cuadratura. 0.42 % rms equivale a ≈ 0.2 px rms con 40 px por división.

## Pruebas

Sólo el cálculo de ruido (Python) y la lectura de la hoja del LM6172. Ninguna simulación.

## Pendientes

1. **Keneth:** dejar el macromodelo del AD8039 en `Simulation_LTSpice/models/AD8039/` y su hoja en `datasheet - componentes/AD8038_8039.pdf`. Si puede, también la hoja del 74HC4051 de Nexperia.
2. **Claude:** comprobar el modelo (nodos, −3 dB a ×5.02 y ×10.09, excursión, diferencial de 4 V), completar la tabla §2.2 del plan, anotar el modelo en `models/LEEME.md` y lanzar Codex.
3. **Riesgo:** si la diferencial máxima del AD8039 es baja (≈ ±1.8 V, como el AD8065) o la hoja no la permite en saturación, S3-C7 fallará. Entonces habrá que decidir entre limitar con resistencias en serie y cambiar de pieza. Se ve en E14.
4. Actualizar U103 en C.6 del documento vivo (`rediseno_afe_rev21.html`) y C.5 con la cifra de 0.42 %, junto con el resultado de S3.

## Continuación (13:20–13:40): modelos comprobados y S3 lanzado

- Keneth dejó la hoja del AD8039, la del 74HC4051 y el paquete HCMOS de Nexperia. El "modelo" del AD8039 era el `.asc` de ejemplo de ADI. El subcircuito real está en `ADI.lib` de LTspice: lo extraje a `Simulation_LTSpice/models/AD8039/AD8038_ltspice.sub` y moví el `.asc` a esa carpeta.
- Hoja del AD8039: **diferencial máxima ±4 V** (p. 5), salida ±4 V con 2 kΩ, 8 nV/√Hz, 600 fA/√Hz, 1.0 mA por amplificador.
- Comprobación (`S3G4_LAB_rev2.1/03_simulaciones/CH1_entrada/chequeo_claude/s3_*.cir`): la ×5 con 4.02 k / 1 k, 1 pF y 10 pF tenía +3.7 dB de pico. **Keneth eligió R_G = 249 Ω** (1.00 k / 249 y 2.26 k / 249, sin pico). En saturación, la diferencial de la ×5 llega a 4.28 V: Keneth decidió **medirla en E14** antes de elegir la protección.
- SWI1 de Nexperia: cierra con el control a nivel bajo; RON de 69–125 Ω entre 0 y ±4 V.
- Plan §0/§1/§2.2 actualizado, `models/LEEME.md` ampliado y DECISIONS ampliado.
- **Codex S3 lanzado a las 13:36** (PID 20000, gpt-6.1-sol medium). Respuesta final en el scratchpad de la sesión de Claude: `codex_s3_final.txt`.

## Auditoría de S3 (15:10–16:10)

- Codex terminó: 245 simulaciones, código 0. Mi reejecución en ruta corta da **14/14 CSV idénticos**.
- Ruido: el modelo `AD8038` de LTspice da 16 nV/√Hz (la hoja, 8). Con una copia de auditoría con `en=4n` (8.04 nV/√Hz), E12 da **0.30–0.40 %** en las 12 escalas (control 0.644 % con el original, igual que Codex).
- Los 551 µs de E14 a 200 mV/div son la descarga de C_S tras conducir los BAV199 (τ ≈ 150 µs). Los amplificadores se recuperan en 20–38 ns.
- **Barrido estático propio** (`chequeo_claude/s3_e14/sobrecarga_5mV_dc.cir`): la diferencial de U103A llega a **4.10 V** con |BNC| ≥ 4.92 V a 5 mV/div. E14 no lo veía porque 10 × FS da siempre 0.2 V en U103A (error de mi plan). Un primer intento en transitorio con ±40 V se atascó en convergencia y lo paré.
- E15: `SWI1` no converge al conmutar; el glitch sin inyección de carga no es concluyente.
- Pendientes de Keneth en `AUDITORIA_CLAUDE_S3.md` §8.

## S3b (16:00)

- Keneth: protección opción (a) y ≈ 0.6 ms aceptados (DECISIONS).
- Nuevo `Simulation_LTSpice/models/AD8039/AD8038_ltspice_ruido_hoja.sub` (`en=4n`, 8 nV/√Hz), sólo para `.noise`.
- `PLAN_SIMULACION_S3b.md` y `ENCARGO_CODEX_S3b.md`: 4 variantes (470 Ω / 1 kΩ × BAT54S / BAV199); límites con `.dc` y transitorio hasta ±4.5 V; criterios de diferencial ≤ 2 V, 4051 ≤ 12.5 mA y ruido ≤ 0.45 %. BAV199 entra como comparación, aunque Keneth eligió Schottky.
- Codex S3b lanzado a las 16:01 (PID 10352).

## Auditoría de S3b (17:00)

- Codex: código 0, 162 simulaciones, 10/10 CSV idénticos en su reejecución. Ninguna variante pasa todo: BAT54S tiene pico (+8 dB en U103A sola) y BAV199 es lento (1.1 µs, con +2.2 dB en U103A sola).
- Mi comprobación (`chequeo_claude/s3b/`): el control C reproduce a Codex. **BAV99 (Rohm BAV99HY) con 470 Ω pasa todo:** +0.33 dB, 0.41 %, 0.69 V, 4.4 mA y 50 ns. Recomendado: C2500.
- Abierto: U103B con 3.56 V frente a ±4 V (11 % de margen).
- Keneth pregunta por separar la alimentación (jack de 9–12 V con power path) de la comunicación USB. Respondido como propuesta para la sección G, sin decidir.

## Cierre (17:15)

- Keneth: sí a 470 Ω + BAV99 en U103A, **también en U103B**, y la propuesta del jack de 9–12 V para la sección G.
- Variante G comprobada (`chequeo_claude/s3b/y_*.cir`): diferencial de U103B de 3.56 → 0.68 V; sin pico; ruido 0.41 %; recuperación < 50 ns.
- Pendiente: actualizar C.5 (0.30–0.41 %) y C.6 (AD8039, redes de 249 Ω, R_SER y BAV99) en `rediseno_afe_rev21.html`. Luego S4.

## Documento vivo y S4 (17:30)

- `rediseno_afe_rev21.html`: C.4 (callout con el resultado de S3), C.5 (resultado del ruido: 0.30–0.41 %) y C.6 (U103 = AD8039; R_F/R_G de 249 Ω; nuevas filas R_SA/R_SB y D_A/D_B con BAV99) y la tabla del BOM. Republicado en el mismo enlace como **versión 15**: el publicado era HEAD (30 sep) más el envoltorio de publicación; el local lo contenía todo.
- Keneth: P8 a 3.3 V, offset por el DAC del G473 con buffer y OPA836.
- Hoja del OPA836 descargada (`datasheet - componentes/opa836.pdf`): **diferencial máxima de 1 V, 0.85 mA de entrada** y diodos internos entre las entradas (p. 26). En saturación, la corriente del nodo sumador va a VMID: por eso hay dos variantes (M1, divisor por canal; M2, seguidor común).
- `PLAN_SIMULACION_S4.md` y `ENCARGO_CODEX_S4.md` escritos, sin lanzar: falta el modelo de TI (SLOM218/219).

## S4 lanzado (17:15)

- Keneth autorizó la descarga del modelo del OPA836: TI SLOM218 → `Simulation_LTSpice/models/OPA836/opa836_a.lib` (6 nodos, con Vnot_pd).
- Comprobación (`chequeo_claude/s4/`):
  - ruido de 4.74 nV/√Hz;
  - ganancia −1.000, centro de 1.235 V y offset de +5.2 / −4.9 div (recortado en 0 V);
  - pin del ADC entre 0.004 y 3.29 V;
  - **pico de +1.5 dB a 11 MHz**, que C_F = 1 pF elimina;
  - **el modelo no trae los diodos de entrada**.
- Plan actualizado: variantes C0/C1 de C_F y diodos `DESD_OPA836` como suposición de modelado.
- Codex lanzado a las 17:15 (PID 5768).

## Auditoría de S4 (19:30)

- Codex hizo F0–F7 (199 simulaciones, código 0) y se quedó sin cupo de ChatGPT («usage limit», 18:34) antes de su respuesta final, su diario y su reproducción.
- Mi reejecución en `Temp\claude\s4a` da los mismos valores (diferencia relativa ≤ 4·10⁻¹⁴). Los CSV no son idénticos byte a byte por el orden de columnas (`--resume`) y por mi registro dentro de la carpeta vigilada.
- Hallazgos:
  - la no linealidad del acta es un error de cálculo (mi ajuste da < 1 µV);
  - el 10 % de THD viene de un caso mal planteado en mi plan (offset de −2 div más 8 div de señal);
  - F7 muestra ±0.49 V en el pin con el AFE encendido y VDDA apagado → regla de secuencia con EN del LM27762;
  - C_F = 1 pF quita el pico de +1.5 dB;
  - M1 basta;
  - offset de +5.21 / −4.85 div.
- Pendiente de Keneth: las cuatro decisiones de §6 de `AUDITORIA_CLAUDE_S4.md`.

## S5 lanzado (19:00)

- Keneth aceptó las cuatro decisiones de S4 (C_F, M1, secuencia y offset de −4.85 div) y eligió para el filtro **U105 = AD8039 doble** (dos Sallen-Key).
- Mi cálculo previo (scipy, con los polos fijos de 4.98 y 10.8 MHz) a 4.5 MHz: Bessel 16 dB / 0.3 % de sobreimpulso; intermedio 21 dB / 2.9 %; Butterworth 30 dB / 9.4 %.
- `PLAN_SIMULACION_S5.md` y `ENCARGO_CODEX_S5.md`: criterios de −3 dB en 2.0 MHz ± 10 %, Monte Carlo (≥ 95 %), sin rebote, subida de 175 ns ± 20 %, ruido ≤ 0.45 % y recuperación ≤ 1 µs.
- Codex lanzado a las 19:00 (PID 18504). Se le pidió abrir el diario al principio, por el corte de cupo de S4.

## Auditoría de S5 (20:15)

- Codex: código 0, 708 simulaciones; mi reejecución da 13/13 CSV idénticos byte a byte.
- Resultados:
  - BE: −3 dB en 1.82 MHz, 17.5 dB, Monte Carlo 67.5 % → falla;
  - TR: 1.95 MHz, 22.6 dB, 3.2 %, pasa todo;
  - BU: 1.92 MHz, 30.9 dB, 8.8 %, recuperación 1.08 µs → falla.
- Causa del corte bajo: redondeo E12 (BE con Q = 0.500) y un 4–6 % de pérdida de la cadena real.
- Reescalado comprobado (`chequeo_claude/s5/`): TR con 1.11 k / 499 Ω → 2.011 MHz y 21.7 dB.
- Carga ficticia de 1 kΩ ∥ 10 pF en U103B heredada de S3: se quita en S7.

## S6 lanzado

- Keneth: filtro TR reescalado; su verificación queda para S7.
- `PLAN_SIMULACION_S6.md`:
  - modelo del ADC con C_S = 5 pF, C_pad = 5 pF y R_SW deducida (≈ 825 Ω) y barrida {400, 825, 1500 Ω};
  - ventana de 67.3 ns, 307.7 ns por ADC y 153.8 ns de desfase;
  - estado previo P/Z/R;
  - el error se mide contra una copia sin carga y se descompone en parte lineal y no lineal;
  - margen de fase del OPA836.
- Mi estimación: a 2 MHz a fondo de escala, unos 2–3 mV (≈ 4 LSB), casi todo lineal. E18 (≤ 0.5 LSB) probablemente falla tal cual; se separa con S6-C3/C4.

## Auditoría de S6

- Codex: código 0, 67 simulaciones; mi reejecución da 11/11 CSV idénticos.
- C1, C3, C4 y C5 pasan: residuo no lineal de 0.0009 LSB, −0.043 dB y margen de fase del OPA836 de 77.9° (U105, 61–62°).
- C2 (E18) da 86.6 LSB, pero es el retraso de R_SW·C_S: el error de 26.7 / 52.8 / 93.9 mV con 400 / 825 / 1500 Ω equivale a 2.1 / 4.2 / 7.5 ns = R_SW · 5 pF. Retraso puro, igual en los dos ADC. **Mi criterio E18 estaba mal planteado**; los criterios válidos son el no lineal y la ganancia.
- Si C_S se descargara antes de cada muestra (Z/R), el error en continua sería de hasta 5.3 mV como ganancia y offset; se mide en placa.

## S7 y revisión completa (21:15–22:00)

- S7 lanzado a las 21:16 (PID 14292), con criterios de integración S7-C1…C9 y la tabla de calibración por escala.
- Revisión completa (`REVISION_CLAUDE_CH1.md`):
  - escalas a 0.249 V/div (−0.2 a −0.6 %);
  - Zin de 999.27 kΩ en las dos posiciones;
  - ruido total de 0.41–0.45 %;
  - consumo de 7.7 mA por riel y canal.
- Hallazgos R1–R6. El más importante: **C_S = 1.17 nF y C_EQ = 8.7 pF en todas las simulaciones desde S2b, pero C.6 dice 1.5 nF y ≈ 12 pF.**
- Datos de hoja comprobados:
  - OPA810: 3.7 mA, Vos 715 µV en SOT-23, 200 V/µs;
  - REF3325: ±5 mA;
  - LM27762: VFB ±1.5 %;
  - 74HC4051: VCC − VEE recomendado ≤ 10 V.

## S7 auditado y S7b lanzado (22:41)

- S7: 8/9 criterios. −3 dB en 2.007 MHz, 0.25–0.32 % de ruido y Monte Carlo 100 % / 96 %. Las protecciones con ±40 V están dentro (diferencial ≤ 0.88 V; pin de 0.007 a 3.29 V). Codex no hizo reproducción; la mía queda pendiente.
- Keneth: R1 sí, R2-A (±4.9 V) y el criterio «que funcione»: tolerancias reales y ≥ 95 % de placas.
- `PLAN_SIMULACION_S7b.md`:
  - Monte Carlo de 500 casos con R ±1 %, C ±5 %, rieles ±2 %, VREF ±0.2 % y offsets de hoja;
  - ajuste del trimmer;
  - protecciones con los rieles en sus extremos;
  - criterios de 2 MHz ± 15 %, pico ≤ 1 dB y ruido ≤ 0.5 %.
- Lanzado a las 22:41 (PID 7504).

## Sincronización de la memoria (22:50)

- `node tools/ai-context/context.mjs sync` fallaba: S7 de Codex creó `S7/reorder_validation/a/resultados`, más hondo que el límite de 5 niveles de `sync.mjs`.
- Arreglo pequeño: `sync.mjs` admite `excludeDirs` en cada regla, y `ai-context/index.json` excluye en `S3G4_LAB_rev2.1` las carpetas de salida de simulación (`generados`, `reorder_validation`, `smoke`, `controles`, `diagnostico`). La sincronización vuelve a funcionar.

## S7b sin cupo de Codex (23:10)

- Codex escribió `ejecutar_s7b.py` y la verificación previa: con ±4.9 V y C_S 1.2 nF, K1 da 2.008 MHz y 0.32 % a 5 mV/div; trimmer en rango en 8/10 placas del reparto inicial. Se quedó sin cupo («usage limit» hasta el 4 oct a las 00:00) durante la prueba rápida.
- Claude lanza con el mismo script la prueba rápida (`--resume`) y la campaña. Los registros van en `Temp\claude\s7b_logs` (fuera de la comprobación de ficheros protegidos). La auditoría tendrá en cuenta que esta vez ejecutó Claude.
- Keneth preguntó por CH2/CH3 a 1 MHz: la misma cadena, con el filtro TR escalado (sección 1 ≈ 2.49 kΩ y sección 2 ≈ 1.10 kΩ, mismos C; ≈ 25 dB a 2.47 MHz), muestreo de 2.5 ciclos (48 ns) por comprobar y disparo de CH2/CH3 todavía abierto. Propuesto un S9 corto después de S7b.

## Índice de la memoria compartida acotado (4 oct, ~02:20)

- Keneth aprobó acotar el índice. Antes había 233 fuentes, cerca del límite de 250 de `sync.mjs`.
- `tools/ai-context/sync.mjs`: nueva opción `excludeFiles` (expresiones regulares sobre el nombre del fichero) en cada regla de `ai-context/index.json`; el límite sube de 250 a 400.
- `ai-context/index.json`, regla `S3G4_LAB_rev2.1`: excluye `ENCARGO_CODEX_*.md`, `RESPUESTA_FINAL_*.md` y `*_resumen.md` (repetidos en los planes y las actas). Ya excluía las carpetas de salida (`generados`, `reorder_validation`, `smoke`, `controles`, `diagnostico`).
- Resultado: 195 fuentes indexadas, 38 retiradas y 0 ausentes. `verify.mjs` pasa sus 12 comprobaciones.
- Pendiente opcional: juntar los diarios de cada mes cerrado.

## S7b terminado (4 oct, 02:31)

- Codex, reanudado, reparó la convergencia (punto a punto, tiempo límite y reintento) y terminó: 4 416 / 4 416 casos y 0 errores finales.
- Resultados: C1–C4 al 100 %, C6/C7 al 100 % y C8 ≈ 97 %. **C5 (trimmer) en el 83.2 %**: necesita de 0.9 a 7.8 pF con la mediana en el centro. Causa: el trimmer en paralelo con media capacidad de arriba (sensibilidad ¼) y Cb al ±5 %.
- LCSC: no hay trimmer de 3–10 pF; JZ300 (5.5–30 pF) a 4.4 USD con 123 ud.
- Propuestas A–D en `AUDITORIA_CLAUDE_S7b.md`; recomendada A (tolerancias de 1–2 % y un hueco DNP).
- Reproducción de muestra pendiente.

## S7c (4 oct, ~02:50)

- Keneth eligió la opción A. Claude hizo S7c como Monte Carlo analítico (20 000 placas) con la misma fórmula de S7b; la validación da 81.2 % frente a 83.2 % de Codex.
- Solución con piezas de LCSC: Ct1 20 pF ±2 % 250 V (C3845779); Ct2 fijo 15 pF ±2 % 250 V (C3836120; no hay 16 pF ±2 % de alta tensión); Cb 1 nF ±1 % (C507408) + 68 pF ±5 %. Trimmer necesario de 3.47 a 4.95 pF: 100 % en rango. Hueco DNP en paralelo con Ct2 como seguro.
- Detalle: C.6 decía «1 nF + 68 pF» con Ct2 de 16 pF, lo que suma 1068 pF frente a los 1088.5 pF de la fórmula; con Ct2 de 15 pF vuelve a quedar centrado.
- **CH1 cerrado en simulación** (S0–S7c). Pendiente: documento vivo, reproducción de muestra de S7/S7b, S8 y S9.
