keneth-urbizagastegui/S3G4-LAB/ai-context/journal/2026-10-03-codex-s3-1504.md

# S3 CH1 — ejecución Codex

- Fecha: 2026-10-03, inicio aproximado 13:38, registro 15:04, America/Lima (UTC−05).
- Agente: Codex. Encargo vigente: `S3G4_LAB_rev2.1/03_simulaciones/CH1_entrada/ENCARGO_CODEX_S3.md`; contrato `PLAN_SIMULACION_S3.md`.
- Alcance: simulación S3 de hardware rev. 2.1, continuación de S2b. Sin pruebas físicas, firmware ni cambios de diseño. El encargo prohíbe editar STATE y DECISIONS; se respeta esa excepción explícita.

## Cambios y fuentes

Nuevos `comun/ch1_comun_s3.inc` (incluye S2b), `ejecutar_s3.py` (LTspice, diez trabajadores, smoke y S3G4_MODELS), auxiliares de repetición E15, verificación y respuesta final, decks/logs S3, CSV/JSON, ACTA y respuesta final. Se leyeron completos el encargo, plan y sus fuentes rectoras: S2b/acta/auditoría, decisiones de 3 oct, §6 de revisión CH1, C.3–C.6 del rediseño, LEEME de modelos, modelos y decks Claude. Hojas locales AD8038_8039 Rev. G, OPA810 y 74HC_HCT4051 Rev. 12. No descargas.

Se corrigieron exclusivamente condiciones del banco: fuente ideal del pulso E14 para que llegue al nivel contractual; ventana de recuperación de 1 ms, con reloj aislado que garantiza pasos de 0,5 ns durante el pulso y primeros 5 µs; objetivo de recuperación igual al equilibrio inicial, no a la cola; estímulo E15 con ganancia DC E11 y offset E11b para +2 div. No se ajustaron escalera, amplificadores, resistencias ni compensaciones.

## Evidencia y pruebas

- Smoke: código 0, 52 casos, 268,312 s; versión anterior a la última corrección de offset E15, validada luego en sus 168 casos completos.
- Campaña final: 245 casos únicos (243 utilizables y dos diagnósticos nativos fallidos de compatibilidad SWI1), código 0, sin errores/advertencias de campaña. Fase completa 765,637 s más repetición E15 270,377 s: 1036,014 s y 413 intentos en estas fases finales; no es el tiempo total de la sesión ni incluye exploraciones previas.
- U103A/B aislados: ganancia 4,999745/10,011555; −3 dB 85,201/32,481 MHz. Tomas derivadas de 997,7 Ω y comprobadas; RON nativo −2/0/+2 V: 71,66/69,13/75,04 Ω; control activo bajo.
- C1/C2/C5 cumplen; C3 es informativo (error máximo 0,956279 %). C4 falla: 0,644338 % div frente a 0,45 %. C6 falla: 551,21675 µs frente a 1 µs, 200 mV/div y ambas polaridades. Todos los E14 terminan recuperados en la ventana.
- C7 falla bajo el límite estricto VS±0,5 V del OPA810: exceso del riel 0,919680 V, corriente 2,186270 mA <10 mA, diferencial 4,362027 V <7 V. AD8039A/B diferencial pico 0,059170/0,614658 V <±4 V y entradas comunes dentro de rieles. La auditoría S2b admite la excursión con corriente limitada: contradicción conservada, no se adopta una decisión nueva.
- SWI1 nativo colapsa el paso al conmutar incluso aislado, con evidencia de ocho pasos consecutivos <1 fs. Reemplazo permitido sólo E15: RON100 Ω, CY5 pF y CZ25 pF, sin inyección real de carga. Ambas etiquetas de proceso usan 100 Ω en esta aproximación.
- E15: 168 casos, seis permutaciones con desfase 10 ns y cambio simultáneo; asentamiento máximo 0,093255 µs, glitch 5,28057e−6 div, 28 casos con indicios de saturación, llegada a +0,5 V dentro de 1,7 µV. C8 cumple sólo en esa aproximación.
- Diagnósticos nativos de ruido: AD8039 16,18 nV/√Hz a 100 kHz frente a 8 de hoja; OPA810 5,77 nV/√Hz. Modelos intactos; no se corrige artificialmente el ruido. La falla del modelo no demuestra por sí sola falla física.
- Comprobación por SHA256: 20562 archivos protegidos sin cambios durante la fase final. Modelos, entregables S1/S1b/S2/S2b, chequeo_claude, STATE y DECISIONS intactos.

## Reproducción independiente

Completada a las 15:16 UTC−05 en `C:\Users\Keneth\AppData\Local\Temp\s3-replay-20261003\rev\sim\CH1_entrada`, con S3G4_MODELS. Código 0, 245 casos, 700,7408813 s, diez trabajadores; sin errores/advertencias de campaña. **14/14 CSV idénticos byte a byte y 8/8 fuentes idénticas**; hashes y rutas en `resultados/s3_reproducibilidad.json`.

La primera comparación tenía todos los valores de los 245 casos iguales; dos archivos diferían sólo en orden de columnas, porque la recarga parcial omitía una clave vacía de corte en los casos AC. Se corrigió el auxiliar para conservar claves vacías y se restauró el orden original de esa columna sin alterar ningún campo medido. Evidencia en `resultados/s3_serializacion.json`. Los diagnósticos/exploraciones quedan identificados en S3/README.md y no alimentan aceptación.

## Pendientes

Auditoría Claude del paquete ejecutado. Validación física del ruido y consumo, modelo de conmutación/inyección de carga y tiempos reales del 4051, criterio de excepción de corriente OPA810. El contrato impone 30 ns/20 ns, pero la hoja local no declara esos tiempos así; se documenta sin resolver. El límite de estímulo 40 V no fuerza saturación en todas las escalas altas. No se declara S3 aceptado ni hardware ensayado.
