keneth-urbizagastegui/S3G4-LAB/ai-context/journal/2026-10-03-codex-s7-integracion.md

# S7 — integración CH1

- Agente: Codex, 2026-10-03, America/Lima. Diario abierto a las 21:17:39 (CreationTime del archivo).
- Encargo: ENCARGO_CODEX_S7.md y PLAN_SIMULACION_S7.md; integración de valores decididos, sin remedios ni descargas.
- Inicio: leídos START.md, STATE.md, encargo y contrato completos. MCP s3g4-context no disponible; acceso por CLI local y fuentes puntuales. STATE.md y DECISIONS.md protegidos por instrucción específica.
- Fuentes: auditorías S1, S1b, S2, S2b, S3, S3b, S4, S5 y S6 leídas completas; decisiones del 3 oct, revisión de entrada §6 (E19), LEEME de modelos y fuentes de S2b–S6 consultadas. G.3 todavía cuenta un amplificador de filtro, mientras S5 fija dos para CH1; contradicción anotada.
- Comprobación rápida (3 simulaciones, código 0, 5.44 s): 5 mV/div, corte 2.0070859 MHz, ganancia -49.498308; 0.5 V/div, corte 2.0068175 MHz, ganancia -0.49532661; reposo, pin 1.2309724 V, canal 63.92855 mW. Diez trabajadores disponibles desde el inicio. Primer intento rechazado por nombres de medidas con guion en mc-1; corregidos a mcnom, sin cambios eléctricos.
- Evidencia: S7/s7_quick.json. Primer smoke: 42 simulaciones, 27 procesadas correctamente, código 1, 806.264 s; errores de implementación en los 6 MC (redefinición de parámetros) y 9 offsets (barrido DC de un solo punto). Corregido sin cambios de valores: MC por instancia con copias de la misma topología y offset medido en 0 V de un barrido de ±1 nV. Seis comprobaciones puntuales de MC/offset corregidos pasan. Repetición completa de smoke en marcha.
- Primer smoke, J7: SFDR mínimo 107.4494 dB, residuo no lineal máximo 0.0056064 LSB rms; amplitud muestreada de 1.99016–1.99437 Vpp para 2 Vpp en el pin. Son resultados de macromodelo sin ruido/quantización ADC, no medición de silicio.
- Hallazgos conservados: FRONT_S2B deriva CS=1.1691034 nF, CEQ=8.6676517 pF, CB=1.0885401 nF, frente a 1.5 nF y aproximadamente 12 pF citados en resúmenes. Se mantiene el include intacto. La corriente capacitiva del BAV199 no equivale a conducción directa; la clasificación de J6 se hace por polarización directa >0.4 V.
- Protección verificada en primer smoke: SHA256 de 12404 archivos, ninguno cambiado. Código 1 no implica fallo eléctrico.
- Segunda ejecución smoke: 38 ensayos iniciales pasan sin errores de ejecución, pendientes los cuatro J7. Estructura validada por verificar_s7.py --structure: conexiones heredadas de FRONT_S2B y 66 tolerancias independientes por realización, incluyendo desacoplos de riel. J6 sin conducción de entrada: 0.5484–0.6978 us. J8: centros de 2.5336985 V y 0.0207729 V, con centro nominal 1.2309724 V; rango útil +5.21/-4.84 div. S7-C8 conserva el fallo literal de linealidad en los nueve puntos por recorte del último, ya aceptado en S4; no se redefine como lineal sólo quitando ese punto.
- Segunda ejecución smoke terminada: 42/42 simulaciones correctas, 787.9295 s; código 1 exclusivamente por cambios externos de STATE.md (21:41:28) y DECISIONS.md (21:41:19). Codex no escribió esos archivos. Se leyeron las nuevas entradas: decisiones de ±4.90 V y C_S 1.2 nF/C_EQ ≈8.7 pF, tolerancias reales y ≥95 % de placas, con S7b pendiente. Se conserva S7 congelado en su contrato ±5 V y FRONT_S2B sin cambios; no se traslada la decisión nueva a la campaña en curso. Evidencia de smoke: S7/s7_smoke_run.json y s7_smoke_registro.json; primer intento conservado en s7_initial_smoke_*.
- Campaña completa iniciada con el estado documental actualizado como línea base para la comprobación de integridad. Se guardan los SHA256 antes y después en S7/campaign/. No se omiten cambios futuros ni se atribuyen a Codex sin evidencia.
- J5: las escalas de 10 mV/div y 200 mV/div no encontraban el punto inicial de -40 V tras varios niveles de source stepping; se interrumpieron sólo esos procesos propios, verificando PID y línea de comando, y se mantuvo el registro de error. Prueba Gmin de dos casos tampoco dio una solución rápida. La continuación desde 0 V resuelve 200 mV/div; para 10 mV/div, reducir el paso de 50 mV a 1 mV resuelve las dos polaridades (hasta ±40 V). El ejecutor ya permite dos barridos desde 0, fusión de 80001 puntos y --resume para completar sólo esos dos casos. No se modificó un componente ni un modelo. Los JSON de diagnóstico de medias barridas no se usan en el acta: sus etiquetas genéricas de extremos pertenecían al analizador del barrido completo; los decks/.meas describen los estados reales.
- Campaña completa: 12/12 ganancias DC pasan con error entre -0.8276 y -1.1733 %. Ruido de las 12 escalas: 0.25242–0.32182 % de división. Monte Carlo de 600 ejecuciones en curso, sin errores de ejecución hasta el último control.
- Cierre, 2026-10-03 22:38–22:40 America/Lima, agente Codex: campaña original de 690 intentos terminó con 688 casos válidos y dos inicializaciones J5 interrumpidas (código 1, 2268.1285 s). Se conservó íntegra en S7/s7_attempt1_run.json, s7_attempt1_registro.json y s7_attempt1_data.json. Reparación DC: cuatro ejecuciones nativas, código 0, 203.2102 s, hashes protegidos invariantes; se obtuvo en paralelo mientras terminaba la campaña.
- Consolidación con --resume: importó sólo los dos casos J5 faltantes tras comparar los SHA256 de fuentes/modelos y decks. Resultado código 0, 690 casos completos, 694 ejecuciones nativas acumuladas (692 válidas y dos intentos interrumpidos), 2275.5371 s de pared para campaña y consolidación. La reparación paralela está dentro de ese intervalo. Smoke/diagnósticos conservan tiempos separados. Evidencia final S7/s7_run.json, s7_registro.json, s7_completed_data.json; no faltan J1–J9.
- Comprobación final verificar_s7.py --reorder, código 0: conexiones y valores correctos; 66 variables físicas independientes por realización; cobertura y CSV fijos; extremos J5; aperturas de 4096 muestras; 12404 archivos protegidos sin cambios; 20 CSV byte-idénticos entre orden normal, invertido y entrega. Primer control de orden detectó que save_results mutaba filas usadas en informes; corregido trabajando con copias, regenerado con --reports-only sin repetir LTspice y verificación completa repetida correctamente.
- Resultados: S7-C1…C7 y C9 pasan; C8 falla literal por recorte del punto VDAC=2.3 V, con linealidad interior y rango +5.2109/-4.8408 div. Monte Carlo: 300/300 dentro de banda en 5 mV/div y 288/300 en 0.5 V/div; once realizaciones de la segunda escala tienen pico >0.5 dB (máximo 0.66145 dB), informado por separado del criterio C2. Subida 182.063–182.142 ns; J5 pin ADC 0.006878–3.288984 V; J6 recuperación máxima 0.697757 us sin conducción directa BAV199; J7 SFDR mínimo 107.449 dB y residuo máximo 0.0056064 LSB rms. Canal: 63.92855 mW en reposo y 66.31747 mW con seno de 2 MHz. Fuentes: CSV resultados/s7_*, ACTA_S7.md y RESPUESTA_FINAL_S7.md.
- Pendientes explícitos: auditoría de Claude y placa; límites de macromodelos (diodos OPA836 supuestos, BAV99 Rohm/Nexperia y ADC idealizado); discrepancias de parámetros derivados y recuento G.3; S7b para las decisiones concurrentes de ±4.90 V, C_S=1.2 nF y tolerancias reales. No se eligieron remedios ni se modificaron modelos, firmware, PCB, S1–S6, chequeo_claude, STATE o DECISIONS. El MCP s3g4-context apareció disponible al cierre y se consultó; al inicio se usó la alternativa CLI autorizada.
- Sincronización: la CLI rechazó la profundidad de S7/reorder_validation/a/resultados (código 1). Se usa la alternativa explícita ctx_index por archivos en s3g4-context, con etiquetas S3G4/ruta_relativa, para el diario, scripts, include y entregables narrativos; no se altera el sincronizador ni las fuentes protegidas.
