keneth-urbizagastegui/S3G4-LAB/ai-context/journal/2026-10-04-codex-s9.md

# S9 — Codex, 4 octubre 2026

Inicio: 2026-10-04, America/Lima. Encargo: ENCARGO_CODEX_S9.md y PLAN_SIMULACION_S9.md, CH2/CH3 a 1 MHz, variantes A AD8039 y B LM6172. Sin decisión de variante ni remedios.

Se leen START/STATE y fuentes rectoras. MCP s3g4-context y herramientas context-mode no expuestos en esta sesión; se usa búsqueda local context.mjs y análisis local con salida reducida. No se pide repetir contexto.

Archivos protegidos: CH1_entrada, models, STATE.md y DECISIONS.md. Sólo diario propio y entregables CH23_entrada. Sin descargas ni prueba física.

Pendiente inicial: K0 hoja/modelo LM6172; luego preflight K1 y distribución de diez placas antes de campaña, smoke, campaña completa, acta y sincronización.

## K0 — 09:53 Lima

Hoja local SNOS792E diciembre 2024 extraída y citada en ACTA_S9. Pinout validado con 9 ejecuciones: +IN −IN V+ V− OUT. Seguidor offset2.986mV, Ib1.219/1.200µA, consumo1.698/1.696mA a±4.9V frente a2.2mA por amplificador de hoja. BW seguidor181.984MHz frente130MHz; cruce unitario inferido112.851MHz frente70MHz. Modelo funcional pero no fiel a su tabla de±5V: se conserva la incertidumbre paraB.

Ruido nativo6.587nV/√Hz a100k y51.496nV/√Hz a1MHz: ruido artificial de resistencias internas, no ruido de entrada de hoja. Copia propia fuera de models: núcleo con resistencias noiseless y en11n/in1p blancos (tabla±5V,p8). Validación11.03684nV/√Hz en ambas frecuencias. Los intentos de sintaxis noiseless en D/Q fueron rechazados y no se usan. Núcleo con sólo R noiseless deja <0.004nV/√Hz. Se conservan diagnósticos.

Preflight inicial detectó sintaxis de selección condicional no soportada porLT26; se cambia sólo el generador, con una instancia seleccionada al emitir el deck. Solución inicial heredada de MC0 S7b como .loadbias (recomendación, nunca tensión impuesta), necesaria frente a source stepping lento; se vuelve a resolver todo con los valores reales. Datos K1 y reparto de diez casos pendientes antes de campaña.

## Preflight cerrado — antes de campaña

Código0, 98 ejecuciones nativas contabilizadas en barrido/preflight (incluye filas reutilizadas), 52.147s de ejecución sin tiempo de huellas; 26367 protegidos sin cambios. E96 elegidoA: F1=2370Ω/F2=1100Ω; se aplica igualB. B no necesita reoptimización (1.0285MHz nominal dentro±10%).

| Variante | EscalaV/div | −3dBHz | Pico dB | A1.73dB | A2.47dB | Ganancia con signo |
| --- | --- | --- | --- | --- | --- | --- |
| A | .005 | 1001223.864 | .0000174184 | 13.664136 | 25.227570 | −49.4798894 |
| A | .5 | 1000876.997 | .0000177126 | 13.667279 | 25.230712 | −.495142291 |
| B | .005 | 1028519.771 | .0000174158 | 13.340218 | 24.975542 | −50.0148393 |
| B | .5 | 1028177.606 | .0000177104 | 13.343359 | 24.978683 | −.500495414 |

MC10: riel+4.824809…4.990171V; magnitudriel−4.814335…4.950163V; VREF2.499191…2.503873V. VO101−.633324…+.385192mV; VOA−2.310457…+2.830759mV; VOB−.397372…+2.981115mV; VOFA−2.822422…+1.354050mV; VOFB−2.339762…+2.958981mV; VO836−.382992…+.357366mV. Fuentes dentro límites. Componentes/factores y semilla2026100371 guardados en S9/preflight/s9_mc_10*.csv; mismo reparto enA/B. No se vuelve a certificar trimmer.

Smoke lanzado después de registrar este preflight; campaña aún no lanzada.

## Depuración del smoke

Smoke inicial:48casos,42finalizados,102invocacionescontabilizadas,354.554s,código1. B falló en transitorios por límite deiteraciones enmux. DECISIONS cambióexternamente paraañadir S8/desacoplo/cuerpoBNC, sin incidenciaencontratoS9; Codexnoescribióesearchivo. Seconserva concurrency, noseatribuyecambioaesteagente.

Reintentoitl4=1000 completó B positivo .2V:1.113631µs, dosadvertenciasenintervalodepicosegundos. A recupera1.331497…1.414448µs en smoke (falloeléctricoC8). B negativosseguíanconpasopatólogicoenmux, sin terminar. Ensayosnuméricosnormal/trapynormal/gearagotaron90s; nosemuevenpiezas.

Gmin1e−12 enB negativo .2V (mismonetlist/stimulus, gear/alt,itl4=1000):completoen49.577s,sinadvertencias, recuperación1.357288µs. K0 comparó gmin1e−12 frente1e−16 enseguidor0/±.1V:Ib cambia≤0.814pA,Vout≤40.020pV; quedanfilasens9_k0_gmin.json. Regularizaciónnumérica sólotransitorioB; AC/DC/ruido/K0 mantienen1e−16. Noesunremedioeléctrico.No seañade cshunt ni pieza.

Seinterrumpió elproceso propio21228 y sus3LTspice, queestabanenpasospatológicos; archivosdefallos/transitoriospreservadosenS9/smoke_historico_gmin16/. Elsmokefinal se reanuda conCSVdurables. Corriente LM6172 deK6 ahora medidaenRINA/RINB delcore; VIA/VIB soncorrientedelaredconBAV99, no pin. Los barridos±40/±100 llevan límite enID, evitando colisiones deestados.

## Corrección de la puerta K0 antes de la campaña completa

La condición literal del punto 3 del encargo manda detener B si el modelo no cuadra con la hoja. El consumo y el ancho nativo no cuadran; por tanto B se detiene y las pruebas posteriores ya ejecutadas se conservan sólo como diagnóstico. La interpretación anterior de continuar con una limitación no cumplía esa condición y se corrigió. No se sustituye ni corrige el modelo nativo. La copia de ruido fuera de models queda validada, sin usarla para aprobar B.

Diagnóstico numérico final de B: abstol=1e−10/gmin=1e−12 resolvió −40 V en 28.438 s, recuperación 1.412050 µs; −0.2 V en 24.912 s, 1.358298 µs, frente 1.357288 µs con abstol=1e−12. No se convierte en un remedio de circuito. Proceso propio 22956 y su LTspice se interrumpieron; los registros se conservan.

Smoke A: código 0, 27/27 casos lógicos, 63 ejecuciones nativas, 374.169 s acumulados de sesiones reanudadas; protegidos sin cambios. Auditoría de 59 decks: código 0, sin errores. Se corrigió el auditor para excluir decks históricos de calibración anteriores, sin alterar resultados. Campaña A completa lanzada con diez trabajadores y salida en S9/campaign_console.log. MCP s3g4-context disponible después de compacción; consulta vigente realizada, fuentes autoactualizadas.

2026-10-04 10:45 Lima: K1 completo A, 12 escalas; K3 completo, 12 escalas. Para tomas sin bias histórico (4/5/10), el generador conserva una copia propia de las recomendaciones .nodeset de toma 0 y permuta los nodos iniciales de la rama SWI1, D/C y código hacia la toma real. No impone nodos ni cambia fuentes/componentes; Newton vuelve a resolver el circuito. Ensayo toma 4 terminó nativamente en 1.807 s. Reanudación de campaña completó las tres tomas pendientes. El primer ensayo de extracción posterior dio AttributeError porque ac_metrics no existe; no fue un error de simulación y el registro nativo dio código 0. Las interrupciones de procesos propios 13700/2376/13148 y los timeouts anteriores se conservan en native_history y console. No se tocó CH1.

2026-10-04 10:59 Lima: K4 completo, 18 casos. Todos los seis casos R_SW=825 Ω cumplen C6 con el modelo idealizado. Monte Carlo AC lleva más de 1000/2000 casos; cohorte de 5 mV/div completa: f3 916034.878…1071758.211 Hz, pico máximo 0.01379254 dB, atenuación mínima 23.85616 dB. C1/C2/C3 pasan 500/500 en esa escala. Ruido/gain/posición y otros criterios pendientes de campaña, no inferidos. Runner --preflight/--optimize también respeta la puerta K0; los datos B anteriores permanecen sólo históricos. No se simulará B nuevamente fuera de K0 sin un modelo que cumpla la puerta.

2026-10-04 11:06 Lima: MC AC 2000/2000 completo; C1/C2/C3 pasan en 500/500 por cada escala (.005/.05/.5/5 V/div). Extremos globales de esos 2000 resultados sobre las mismas 500 placas: f3 913493.404…1078944.669 Hz, atenuación a 2.47 MHz mínima 23.84808890 dB. K4 R_SW=825 Ω: seis casos, SFDR mínima 142.6447036 dB, residual no lineal máximo 0.0004886712 LSB rms. MC ruido >125/200, sigue continua/posición; no se declaran cerrados los otros criterios.

MC ruido cerrado: 100/100 placas en .005 y .5 V/div cumplen C4, máximo 0.2439585743 %div (AFE); el nominal de las doce también cumple. Continua primera cohorte .005 V/div: 500/500 C5, error de ganancia −4.367324…+1.978273 %; 484/500 C9 (96.8 %), mínimo posición positiva/negativa 4.294670/4.477508 div. C9 supera 95 % pero hay 16 placas individuales que fallan. Las otras cohortes OP siguen ejecutándose con seis puntos independientes, timeout 60 s y un reintento; no se adelanta su fracción final.

Continua .05 V/div cerrada: C5 500/500, C9 488/500 (97.6 %). Continua .5 V/div cerrada: C5 500/500, C9 484/500 (96.8 %). La última cohorte activa es 5 V/div, ya >125 casos. LSB de S6 comprobado en ejecutar_s6: 2.5/4096 = 0.6103515625 mV; medio LSB 0.30517578125 mV. ln(2¹³) del cálculo R_SW es asentamiento a medio LSB, no ADC de 13 bits.

Se archivaron seis archivos históricos K4 de nomenclatura anterior en S9/smoke_historico_k4_nombre/, preservándolos. Auditoría smoke posterior: código 0, 59 decks/27 casos, sin errores. Los archivos individuales B previos se separan en S9/smoke_historico_B_K0/; checkpoint y tablas activos son A. No se elimina evidencia ni se mezclan diagnósticos B con campaña.

## Continuación S9-B — nueva sesión, 4 octubre 2026

Encargo vigente: ENCARGO_CODEX_S9_B.md, leído completo junto con PLAN_SIMULACION_S9.md, ENCARGO_CODEX_S9.md, ACTA_S9.md y este diario. A terminada: no repetir ni modificar sus resultados. Keneth aclara que el código 1 original vino de modificaciones de Claude a STATE/DECISIONS durante A. Se conserva ese registro histórico.

MCP s3g4-context y context-mode no expuestos en esta conexión; búsqueda local context.mjs utilizada. Sin descargas, confirmaciones ni cambios a STATE/DECISIONS/CH1/modelos originales. Primero copia mínima LM6172 a ±4.9 V y K0; sólo si cumple todos los márgenes se habilita B. No se adopta variante.

### K0 y preflight B ajustada — antes de campaña

Copia comun/lm6172_hoja.lib, derivada de la copia de ruido de S9: C1 100→200 pF; GPWR 0.0014→0.001913; resistencias internas noiseless y fuentes blancas 11 nV/√Hz/1 pA/√Hz independientes en las entradas. Entrada y saturación National intactas. Prueba inicial con C1=215 pF: ×10 6.668 MHz pero seguidor 93.829 MHz, insuficiente; corregida a 200 pF. No se rehace topología ni se añade polo.

K0 final: 8 simulaciones, código 0, 1.848 s; ×10 7.196743 MHz (=71.96743 MHz inferidos), seguidor 101.067259 MHz y pico 0.008607 dB; consumo +2.211235/−2.209468 mA; ruido 11.036838…11.036840 nV/√Hz de 10 kHz a 1 MHz. Offset 2.986006 mV; Ib 1.218954/1.200027 µA; salida +3.460945/−3.362725 V con 1 kΩ a ±5 V. Dentro de todos los márgenes del encargo. SHA256 528255c3715877f0668bbd35548ca9401ff2906b6079d9e5433ec79af62c8d6b. La copia no es un modelo validado por TI; el consumo se ajusta a esta alimentación, no a toda su gama.

Runner nuevo ejecutar_s9_b.py importa el motor S9 sin cambiarlo, usa sólo B, directorios S9/B_hoja y s9b_*; no reejecuta K4 ni escribe resultados A. --resume exige registros/CSV completos y mismo hash de modelo. Preflight código0,22/22 simulaciones,21.765s,26403 protegidos sin cambios. Mismo filtro A: RFILT1=2370Ω y RFILT2=1100Ω; no necesita reoptimización. Nominal 5mV/div: f3=1026275.098Hz, pico0.000017416dB, A2.47=25.574232dB, ganancia−50.0148393. 0.5V/div: f3=1025943.384Hz, pico0.000017710dB, A2.47=25.577374dB, ganancia−0.500495414. MC10 emparejado con A, semilla2026100371, f3=971270.920…1061724.317Hz. Las diez realizaciones y offsets son los mismos registrados arriba para A. Smoke lanzado; campaña aún no lanzada.

### Refinamiento del ruido de corriente — copia definitiva

La prueba adicional K0 con 100 kΩ noiseless midió 1.183329 pA/√Hz: había ruido residual de corriente de National además de las fuentes añadidas. Se conserva su topología y se reduce la fuente externa a sqrt(1²−(1.183328643756²−1))=0.774425 pA/√Hz. RINP/RINM=27454.902706Ω; GINP/GINM=1/R. Es corrección de ruido, no cambio de Ib/offset/entrada/saturación. K0 definitivo mide +0.998656/−0.990918 pA/√Hz a10kHz; 11.036838nV/√Hz de10k a1MHz; resto de K0 igual. Diez simulaciones, código0,2.235s. LT ejecuta a25°C (tnom27°C), dato confirmado en log; se corrige la nota anterior. Hash definitivo4fb5d82e3319553113ba8ff7c8ff5bc4b7fa65e9a13b59dea2173140fe90d31b.

El smoke con ruido anterior se interrumpió sólo en procesos propios (Python8128 y LT9532/22552) y se conserva en S9/B_hoja/smoke_hist_ruido_inicial; preflight anterior en preflight_hist_ruido_inicial. No se reutiliza en la campaña definitiva. Nuevo preflight22/22,código0,30.840s,26403 protegidos sin cambios. El nuevo smoke usa para transitorios la solución nominal propia de B como recomendación inicial .loadbias, igual que el método de reintento previsto; Newton vuelve a resolver, no se impone tensión. Campaña pendiente del smoke definitivo.

### Smoke definitivo cerrado y campaña B lanzada

Smoke código0,25/25 casos,57 ejecuciones nativas,304.549s,10 trabajadores; 26403 archivos protegidos sin cambios. Auditoría final código0,57 decks/25 casos,0 errores. Una comprobación de auditoría previa se lanzó antes de finalizar el proceso y detectó tres casos aún pendientes; no era un fallo de simulación, quedó reemplazada por la auditoría tras el cierre completo.

Recuperaciones del smoke: +0.2/−0.2V en5mV/div,1.389981/1.417311µs; +40/−40V en0.5V/div,1.454257/1.466870µs. Fallan C8 frente1µs, con saturación/recuperación heredadas de National, no silicio. Consumo de canal109.103273mW, corriente +10.803533/−10.801916mA. No se elige remedio.

Se amplió K0 sin cambiar el modelo con dos puntos de excursión a±4.9V (además de los de±5V): cumple,12 simulaciones. La puerta mantiene el hash definitivo. Campaña completa B lanzada con --resume, salida fuera de la carpeta vigilada en TEMP/s9b_campaign_console.log. Prioridad y casos según encargo; K4 reutilizado de A, no reejecutado. Resultados nuevos s9b_*, campaña S9/B_hoja/campaign; A permanece de sólo lectura.

### Reanudación numérica y primera cohorte AC cerrada

Se interrumpió sólo el runner propio23944 y sus diez LTspice para preferir la recomendación nominal de B también en AC/ruido/OP cuando aún no existe la de la placa propia. Se conservaron303 casos AC completos; --resume recuperó sus CSV/JSON y dejó1697 pendientes. Se guarda lock del modelo al comienzo para impedir reanudar con otra copia. No cambia componente, estímulo ni tolerancia; .loadbias sólo recomienda Newton. Consolas en TEMP/s9b_campaign_console_resume.log y anterior. Intentos interrumpidos sin registro final no se confunden con fallos eléctricos ni se cuentan como intentos terminados.

Diagnóstico aparte comprobar_numerica_s9_b.py: mismos casos MC0/200 en5mV/div con gmin1e−12 frente1e−16. Diferencia máxima f3=0.197Hz, pico0.000001691dB, atenuación0.000001782dB, ganancia0.000010909. No aceleró (8.817/9.287s frente7.416/7.175s), no se aplica a campaña. Se corrigió antes de ejecutar el diagnóstico la inicialización de filtros que buscaba IDs2490Ω en vez de2370Ω; sin incidencia en campaña. Evidencia resultados/s9b_numerica.json.

Cohorte AC5mV/div completa500/500: C1/C2/C3 cumplen todos. f3=941057.665…1097227.498Hz; pico máximo0.013826602dB; atenuación2.47MHz mínima24.19229495dB. Smoke nominal offset−0.173559V, DAC centrado1.110111V y posición+4.51667/−4.93535div. La fracción poblacional de C9 todavía no se ha medido; no se infiere del nominal. Campaña sigue con las otras cohortes.

### 4 octubre, checkpoint AC/ruido y continua en curso (Codex)

MC AC completo2000/2000: C1/C2/C3 pasan500/500 por escala. Extremos globales f3=938606.293…1102889.510Hz; pico máximo0.239067892dB; atenuación2.47MHz mínima24.18236738dB. Ruido MC completo100/100 por escala:5mV/div0.274278537…0.298749481%div,0.5V/div0.274297960…0.298972099%div; C4 pasa en ambas y en12 nominales. Continúa MC OP, sin fallos de campaña. C5/C9 todavía pendientes.

Diagnóstico adicional de convergencia OP (comprobar_op_s9_b.py), mismo MC0/DAC2.3V: srcstepmethod1 tarda38.263s y da exactamente el mismo pin0.015087257063V; gminsteps100 agota60s y se termina sólo su proceso propio. No se aplica ninguna opción a la campaña. Son diagnósticos numéricos, excluidos de aceptación y del contador de campaña. La guía nominal transformada a jerarquía MC también se probó en MC0/200 AC (s9b_numerica_biasmc.json): diferencias ≤5.2e−8Hz y ≤2.6e−12 de ganancia, sin aceleración sustancial; no se cambia otra vez el método de campaña.

ACTA_S9 conserva A y agrega un bloque identificado S9_B_CODEX_BEGIN/END con K0 definitivo y límites, para no perderlos durante la campaña. El informe final sólo sustituirá ese bloque propio y conservará texto añadido por otro agente fuera de él. Scripts de auditoría revisan selección B/hash, valores realizados, offsets, seis OP y extremos. Pendientes: completar OP y K6/K2/K8, auditoría final, repetición de smoke con el generador definitivo, tablas finales y sync.

### 2026-10-04, checkpoint OP de 5 mV/div (Codex)

Primera cohorte OP completa: 500/500 ganancia dentro de ±5%, 500/500 offset centrable; C9 pasa267/500 (53.4%). DAC de centrado0.938942…1.271681V, recorrido positivo mínimo3.671130div y negativo mínimo4.904176div. No se confunde centrado con recorrido±4.5div. Restan las otras tres cohortes y las pruebas finales; no se selecciona variante ni remedio.

Diagnósticos propios OP finalizados: gmin1e−12 tarda35.422s y cambia el pin sólo−1.005e−8V; OP escalonado de seis estados tarda47.385s y reproduce exactamente ganancia, centro, DAC y posición, sin ventaja temporal. No se adopta ninguno (resultados/s9b_numerica_op_gmin12.json y s9b_numerica_op_stepped.json). Campaña mantiene seis OP individuales y ajustes numéricos originales. El MCP s3g4-context vuelve a estar disponible; consulta timeline/source S3G4 recupera las fuentes vigentes.

### 2026-10-04 17:25−05:00, cambio externo de criterio C8 (Codex)

Comprobación intermedia de231 archivos protegidos por hash: sólo DECISIONS.md difiere del snapshot de la campaña; mtime16:21:44.673−05:00. Su entrada S9 incorpora criterio vigente C8≤2µs, autoridad Keneth («lo que te parezca») registrada por Claude. PLAN_SIMULACION_S9.md y ACTA histórica conservan1µs. Conforme a la precedencia del proyecto, el informe B aplicará2µs, señalará el conflicto y reevaluará en memoria las medidas de A para la tabla vigente, sin modificar ningún resultado de A. Los fallos C8 narrados antes pertenecen al límite histórico1µs, no al vigente. No se repite ninguna simulación por este cambio de umbral. La metadata original preservará el eventual código1 por guard externo; no se oculta ni se confunde con fallo eléctrico. STATE/DECISIONS no se editan en esta sesión.

### 2026-10-04 17:35−05:00, segunda cohorte OP cerrada (Codex)

50mV/div: ganancia500/500, centro compensable500/500, recorrido±4.5div287/500 (57.4%, C9 falla). DAC0.965698…1.268201V; posición positiva mínima3.807424div y negativa4.902146div. Las otras dos cohortes continúan. Comprobación intermedia completa mediante el mismo guard de campaña:26403 archivos, sólo cambia DECISIONS.md; CH1, modelos originales y resultados de A intactos. Referencia smoke final guardada en resultados/s9b_smoke_baseline{,_meta}.json para comparar al repetir sólo B con el generador definitivo. Pendientes permanecen: OP restante, K6/K2/K8, auditoría, informe y sync.

### 2026-10-04 18:06−05:00, tercera cohorte OP cerrada (Codex)

0.5V/div: ganancia500/500, centro compensable500/500, recorrido±4.5div267/500 (53.4%, C9 falla). DAC0.938935…1.271674V; posición positiva mínima3.671094div y negativa4.904179div. Empieza5V/div. Ningún fallo nativo observado en el último checkpoint; no se repite A ni se selecciona variante. Pendientes: última cohorte OP, K6/K2/K8, smoke del generador definitivo, auditorías, tablas y sync.
