keneth-urbizagastegui/S3G4-LAB/ai-context/journal/2026-09-30-claude-entorno-kicad10-ia.md

# Entorno KiCad 10.0.6 + IA para la rev 2.1

- Fecha: 2026-09-30, noche.
- Agente: Claude Code (Sonnet 5.5).
- Pedido de Keneth: configurar, paso a paso, el entorno del informe «KiCad 10.0.6 + IA» (kicad-happy, Konnect, plugins de fabricación, MCP de componentes y SPICE) para dejar Altium y diseñar la rev 2.1 en KiCad.
- Rama de trabajo: `ai/prueba-konnect` (creada desde `rev2.1`).

## Cambio

- **Entorno:** `C:\Program Files\KiCad\10.0\bin` añadido al PATH de usuario; `uv` 0.12.21 instalado con winget. Ya estaban Git, Python 3.12, Java 21, `gh` y `claude`. Node no se instaló (no hace falta).
- **KiCad:** API IPC habilitada (Preferencias → Complementos), intérprete Python de KiCad 3.11.5.
- **Plugins del PCM:** Interactive Html BOM 2.12.0, Fabrication Toolkit **5.3.0** (la 5.3.1 corrige «duplicate footprint» de KiCad 10; el PCM no ofreció otra) y KiKit plugin 1.6.0.
- **KiKit backend:** `pip install --user kikit` con el Python de KiCad → 1.8.1, en `Documents\KiCad\10.0\3rdparty\Python311\site-packages`. Resuelve el aviso «KiKit installation not found». `kikit.exe` queda fuera del PATH.
- **Claude Code:** plugin `kicad-happy` 2.2.1 (alcance usuario). MCP de alcance usuario: `pcbparts` (HTTP, https://pcbparts.dev/mcp) y `ltspice` (`ltspice-mcp` 0.6.1 ya instalado con uv). LTspice está en `AppData\Local\Programs\ADI\LTspice`.
- **Konnect 0.12.1:** no está en el catálogo del PCM; se instaló con «Instalar desde archivo» usando `konnect-pcm-v0.12.1-windows.zip` (15,1 MB, SHA-256 coincide con el digest de la release de GitHub). MCP de alcance proyecto en `S3G4_LAB_rev2.1/04_esquematicos/kicad/.mcp.json` (pendiente de que Keneth lo apruebe al abrir `claude` en esa carpeta).
- **Esqueleto del proyecto** `S3G4_LAB_rev2.1/04_esquematicos/kicad/`: `.gitignore`, `AGENTS.md`/`CLAUDE.md` con reglas para IA, `s3g4.kicad_dru` (vacío a propósito), `lib/s3g4.pretty/`, `lib/3d/` y el proyecto `s3g4` creado por Keneth en KiCad.
- Commits en `rev2.1`: `890ed1a` (esqueleto) y `a880570` (MCP de Konnect).

## Evidencia y pruebas

- `kicad-cli version` = 10.0.6; ERC del esquemático vacío: 0 violaciones; DRC del PCB vacío: 1 (`invalid_outline`, sin contorno en Edge.Cuts, esperable).
- Konnect, hablado por stdio sin pasar por el cliente MCP: `initialize` correcto (0.12.1), 21 herramientas base, 21 toolsets bajo demanda (incluye `pcb_board`, `verification`, `design_review`, `manufacturing`). `get_installation_info` ve KiCad 10.0.6, `kicad-cli` y el socket IPC. `get_project_info` y `get_board_info` (vía IPC, `source: ipc`) leen el proyecto `s3g4`. Ningún archivo cambió.
- `get_layer_list` falla con «No (layers) section» porque el `.kicad_pcb` recién creado no tiene sección de capas; es esperable hasta que se guarde con contenido.
- El PCB nuevo es de **2 capas de cobre**. Las 4 capas y el stackup son decisión de Keneth y se fijan a mano en KiCad (Configuración de la placa); Konnect no debe tocar el stackup.
- Keneth aprobó el servidor `konnect` en una sesión de `claude` abierta en `04_esquematicos/kicad/`; desde ahí Claude cargó `pcb_board` y `get_board_info` devolvió 2 capas de cobre, 0 redes, `source: ipc`. Solo lectura.
- Pruebas de humo (hablando por MCP directamente; las herramientas no estaban cargadas en la sesión de escritorio):
  - `ltspice` 0.6.1: filtro RC 10 kΩ/10 nF con LTspice real; `analyze_results`/`bode_filter` mide fc = 1587,7 Hz (teórico 1591,5 Hz, −0,24 % con 20 pts/década) y −19,96 dB/dec. Solo opera dentro del directorio desde el que arranca; arrancado en `03_simulaciones/` dejó `ltspice-mcp.toml` y `.ltspice-mcp/` (borrados; reaparecerán si se usa ahí).
  - `pcbparts` 3.4.3 (14 herramientas): `jlc_search` TPL7407LADR → C2149826, SOIC-16, 1053 en stock, 0,40 USD, extended; OPA313IDBVR → C2057303, SOT-23-5, 635 en stock, 0,47 USD, extended (datos de ese momento, no vigentes).
  - `kicad-happy` 2.2.1: `analyze_schematic.py` y `analyze_pcb.py` procesan el proyecto vacío sin errores; no aportan hallazgos hasta que haya diseño.

## pcb-inspector (instalado, sin MCP)

- Instalado con `uv tool install` desde el `.whl` de la release **v0.1.0** (06/09/2026) de `github.com/takzen/pcb-inspector` (MIT), no desde `main`. Ejecutable: `C:\Users\Keneth\.local\bin\pcb-inspector.exe`.
- **El README y el informe dicen `uv pip install pcb-inspector`, pero ese nombre no existe en PyPI (404).** No instalar por nombre: si alguien lo registra más adelante sería otro paquete. El extra `[live]` del README tampoco existe en v0.1.0; `kicad-python` ya viene como dependencia normal.
- Prueba: `version` detecta `kicad-cli` 10.0.6; 7 reglas registradas; `drc` sobre `s3g4.kicad_pcb` da 1 crítico (`invalid_outline`, el mismo de `kicad-cli`); `analyze`, 0 hallazgos. El repo no cambió.
- **No usar `check` ni `vision` sin decidirlo:** la capa de visión envía imágenes de la placa a un proveedor externo. No hay ninguna API key configurada, así que hoy no puede hacerlo. Para auditar, usar `drc` y `analyze`.
- No se registró como servidor MCP de Claude Code (`pcb-inspector mcp --transport stdio`); se hará cuando exista una placa.

## Pendientes

1. Decidir número de capas y stackup; dibujar el contorno (Edge.Cuts).
2. Escribir las reglas DRC reales (clearance/creepage de la entrada según RF-xx) y las clases de red en `s3g4.kicad_dru`.
3. Decidir el punto de partida del diseño: importar la rev 2.0 desde Altium como referencia o dibujar la rev 2.1 desde cero (RF-01…RF-19).
4. No probado aún: escritura con Konnect. Incidencia #610 (`set_active_layer` puede dejar la placa ilegible en 10.0.6): no usar esa herramienta.
5. Elegir una sola herramienta de BOM/CPL para JLCPCB: Fabrication Toolkit 5.3.0 (instalado) o JLCPCB Tools de Bouni (no instalado). No tener las dos.
6. Remoto privado en GitHub (`gh auth login` pendiente) y KiBot en CI con la imagen `dev_k10` anclada; ambos dependen de que haya placa.
7. Opcional: añadir `Scripts` de KiKit al PATH.
