keneth-urbizagastegui/S3G4-LAB/ai-context/journal/2026-10-08-codex-s12d.md

# S12d — Codex — 2026-10-08

Inicio: lectura de AGENTS.md, START.md, STATE.md y contrato PLAN_SIMULACION_S12d.md con sus fuentes encadenadas. Encargo: confirmación corta E2/E3/E5/E8, OPA4192 (buffers X0/X2, A y seguidor libre a masa), 10 kΩ ante buffers. Sin descargas ni cambios de piezas fuera del contrato.

MCP s3g4-context y context-mode no expuestos; respaldo local y fuentes puntuales. STATE.md y DECISIONS.md son solo lectura por orden expresa, que prevalece sobre la regla general de memoria. Se preservan campañas previas, 01_diseno y modelos.

Contradicciones iniciales: DECISIONS cita ±100 nA de fuga del mux, mientras S12d exige fuga ON ±0.4 µA a 25 °C; se aplica S12d. DECISIONS indica 3 ms en X2 y entre paréntesis 1.5 ms con buffer; se aplica 3 ms. Ganancia llamada ×10 es realmente ×10.1 (91k/10k). No se interpreta el modelo monocanal como evidencia de acoplo interno del cuádruple.

Estado: implementación y pruebas pendientes. El cierre añadirá evidencia, duración, resultados y pendientes.

Preparación 16:30–16:40 -05:00: include/ejecutor derivados de S12c en memoria; 234 casos (E2 24, E3 56, E5 4, E8 150), 10 trabajadores y timeout 900 s. E2 aplica ON agregado ±0.4 µA a 25 °C en COM, con ley térmica heredada ×2/10 °C (supuesto), y ±0.6 nA a 23 °C ante ambos buffers. No se duplica el ON por canal. Presupuesto conservador preliminar ~4.4 cuentas en 200 mV y 20 V, límite de fuga ~0.50 nA; pendiente de contraste SPICE.

Preparación: primer build falló por eliminar también el guard dentro del string del cargador heredado; corregido a rsplit del guard final. Smoke preliminar 7 casos: 6 válidos/1 error en 74.259 s. Error de generador al sustituir .end dentro de .ends de protección; corregido con expresión anclada, sin tocar fuentes anteriores. Segundo smoke 7/7 válido en 99.755 s. Se añadió comprobación AC con el evento X3→señal y se corrigió el nombre físico heredado rx100_none_none a rx10000_none_10000. Smoke definitivo en marcha tras fijar fuentes; las fases preliminares no se confunden con la campaña definitiva.

Integridad inicial: 18286 archivos protegidos (fuentes previas, includes, resultados previos excepto RAW/log/net, modelos y 01_diseno; STATE/DECISIONS), SHA256 agregado 9645fd7ea830a00c9186f3d923924b4f998e57b5275c75ae948ce549b2a0fada. Se verificará la misma selección al cierre.

Smoke definitivo: 7/7 válidos, 96.808 s, iniciado 16:40:29 -05:00. Campaña posterior --resume en ejecución. E2 completado 24/24: deriva nominal máxima ~3.9 cuentas; presupuesto conservador ~4.4 en 200 mV/20 V. Clasificación marginal: criterio/presupuesto y supuestos térmicos, sin fallo físico demostrado ni margen de fabricación validado. No se buscan decimales ni se cambian piezas.

Campaña inicial completa: 234/234 válidos, 1238.672 s, inicio16:42:17 -05:00, siete reutilizados del smoke. E3/E5/E8 cumplen. Verificación posterior:234 decks exactos y234 firmas, pero226/234 prefijos .meas correctos; los ocho AC conservaban kind=zero del constructor heredado. Se corrige solo el prefijo .meas, sin modificar circuito, y se reejecutan ocho casos para que también los logs identifiquen el estado real. Las226 fichas con deck idéntico se revalidan/re-firman conservando historial de firma. CSV/JSON iniciales conservados en s12d_campaign_inicial.*; smoke inicial también conservado.

Integridad protegida: la primera selección final incluyó por error el nuevo comun/dmm_bloque2d.inc (su nombre no contiene s12d). Al excluir ese archivo autorizado, vuelve a18286 y al SHA256 inicial9645fd7ea830a00c9186f3d923924b4f998e57b5275c75ae948ce549b2a0fada. Ninguna fuente protegida cambió.

## Cierre — 2026-10-08 17:10 -05:00 — Codex

Corrección de trazabilidad terminada: ocho reejecuciones válidas en 239.510 s; 226 decks idénticos conservados con historial. `analizar_s12d.py` sale 0: 234/234 válidos, 234 decks exactos, 234 firmas y 234 nombres .meas reales. Hash final protegido igual al inicial, 18286 archivos. Evidencia en resultados/s12d_integridad.csv, s12d_protegidos.json, s12d_resumen.json y CSV/JSON de campaña; acta ACTA_S12d.md cerrada.

Resultados: E2 nominal máximo 3.92 cuentas, TC de ganancia p95 máximo 235 ppm; presupuesto 4.44 en 200 mV/20 V, fuga externa conservadora ≈0.50 nA por entrada a 23 °C. E3 DC≤0.42 cuentas, AC≤0.13, riel del mux≤4.900 V y pinza después del arranque≤40.1 µA. E5 PM mínimo 43.6°. E8 máximo 0.461 mA (+8 kV, apagado, buffer X2), 150/150 bajo 5 mA. E1/E4/E6/E7 heredados, no repetidos; E6 continúa con calificación de impulso pendiente.

Contabilidad: 234 estados finales; 242 lanzamientos desde el smoke definitivo, porque se repitieron 8 para nombres .meas. Smoke 96.808 s + campaña 1238.672 s + corrección 239.510 s =1574.991 s (26 min 15 s); campaña + corrección 24 min 38 s. Incluidos los dos smokes preliminares: 256 lanzamientos y 1749.005 s (29 min 09 s) de fases medidas. Cero timeouts en las fases definitivas; un error de generador en preparación, registrado arriba.

Conclusión: encargo ejecutado y documentado. E3/E5/E8 cumplen el modelo. E2 es marginal de criterio/presupuesto; no demuestra cierre con margen en ≥95% de fabricación. No hay cambio nuevo de piezas ni decisión inventada. Pendientes: auditoría independiente, Ib/fuga/Vos reales a 18…28 °C, acoplo del cuádruple, IV de pinzas/GDT/ESD aire, MPN/curvas/ΔR y ensayo físico cuando exista PCB. STATE/DECISIONS permanecen sin editar por orden expresa. Sincronización local completada: 289 fuentes indexadas, 0 retiradas, ninguna ausente; se vuelve a sincronizar esta nota final.
