keneth-urbizagastegui/S3G4-LAB/ai-context/journal/2026-10-02-1925-codex-s1-ch1.md

# S1 — entrada pasiva P4b de CH1

- Fecha/hora: 2026-10-02 19:25, America/Lima (UTC−05:00).
- Agente: Codex, modelo elegido por Keneth; no se aplica la recomendación de modelo del encargo.
- Encargo vigente: `S3G4_LAB_rev2.1/03_simulaciones/CH1_entrada/ENCARGO_CODEX_S1.md` y su contrato `PLAN_SIMULACION_S1.md`, leídos enteros. Auditoría P4/P7 leída; fuentes de diseño y memoria S3G4 consultadas.

## Cambio

Construidos en `S3G4_LAB_rev2.1/03_simulaciones/CH1_entrada/`: include P4b, bancos E1–E4 de LTspice, ejecutor Python, acta, resumen corto de entrega, resultados CSV y manifiestos. Se ejecutaron las medidas nominales, barrido físico de CCOMP, Monte Carlo de 200 muestras con ambas CT1 y todos los estados E1/E2, E3 MC en POS1, y sensibilidad de 19 factores en ambos extremos. Valores derivados mediante `.param`/Python; las piezas de compensación permanecen nominalmente fijas durante las tolerancias. No se seleccionan ajustables ni se cambian valores para que pase un criterio.

Sólo se escribieron la carpeta CH1_entrada y este diario. Por instrucción explícita del encargo, no se editan STATE ni DECISIONS. Tampoco se editan fuentes de diseño, chequeo_claude, P4/P7, firmware, PCB ni esquemáticos. Las modificaciones ajenas que ya estaban presentes no se revierten.

## Evidencia y pruebas

- Ejecución final de `python S3G4_LAB_rev2.1/03_simulaciones/CH1_entrada/ejecutar_s1.py`: código **0**; **494 simulaciones**, **23 796 medidas**, **0 simulaciones con error y 0 con advertencia**. LTspice local 26.0.2, Windows.
- Dos campañas completas: `s1_resultados.csv` y `s1_resultados_primera.csv` son idénticos byte por byte; **2868 filas y 0 diferencias**. La reejecución final añade generación automática de ACTA y rangos MC, parámetros explícitos de sonda y control de que estén todas las medidas declaradas; no cambia los valores medidos.
- Auditoría de nombres de las 23 796 medidas: POS/CPL/CT1 coinciden con las instancias reales, sin discrepancias.
- Verificación independiente por análisis nodal AC: 32 comparaciones, diferencia relativa máxima **2.2167965374464416e-6** frente a LTspice, con capacidad de unión calculada a −5 V.
- Convergencia temporal: paso máximo de 200 ns frente a 50 ns; cambio máximo del error a 2 µs **3.8154953715618944e-5 puntos porcentuales**; cambio del sobreimpulso 0.
- En desarrollo se corrigieron la implementación de contactos para evitar directivas condicionales rechazadas por LTspice y el lector de `.meas` (cruces WHEN y una cabecera Options parecida a una medida). Las cifras anteriores corresponden a la campaña final, sin esas incidencias.

## Hallazgos

- Nominalmente pasan S1-C1, C2, C3 y C4 en los casos aplicables. **Falla C5** en ambos POS y ambas CT1: CCOMP óptimo físico ensayado = **0 pF**; error a 2 µs entre −10.918397 % y −14.224288 % de la altura del escalón. Sobreimpulso nominal = 0.
- E4: peor ΔCin **4.141175691224982 pF**, `mc_059`, CT1=12 pF, DC. Peor desviación a 1 MHz **−8.677442213281806 %**, `mc_095`, POS100, CT1=12 pF, DC.
- Sensibilidad individual: domina **CIN_BUF** para el desplazamiento de ΔCin (3 pF: ΔCin=2.5011595438109246 pF, desplazamiento +1.9608598855704327 pF), y **COFF_RELE** para 1 MHz (0.5 pF, POS100/CT1=12 pF: −6.980299692538927 %, desplazamiento −6.99741480295375 puntos porcentuales). Los peores casos MC combinan varias variaciones, no se atribuyen a una única pieza.
- Dudas, sin resolver: estimación CJO frente a capacidad polarizada; redondeos/chequeo simplificado frente al contrato; contabilidad COFF_SW; Ron/fugas de contactos no especificados; convenciones de compensación/medición de E3 y límite CCOMP=0; estados y correlaciones de E2/E4; contradicción entre decidir ajustables en E4 y prohibirlo en §7. Detalle en ACTA_S1 y RESPUESTA_FINAL_S1.

## Pendientes

Auditoría de Claude sobre la entrega S1 y sus dudas. No se ejecutan S2–S8, ensayos físicos de ±100 V/ESD ni decisiones de ajustables. Esto no es una aceptación del diseño por Keneth.

## Sincronización

Este diario y las fuentes de entrega se indexan mediante MCP **s3g4-context** con prefijo `S3G4/`, sin modificar el índice de fuentes ni los archivos compartidos STATE/DECISIONS.
