keneth-urbizagastegui/S3G4-LAB/ai-context/journal/2026-10-02-2115-codex-s1b.md

# S1b — trimmer, sonda compensable y C_EQ seleccionado en prueba

- Agente: Codex.
- Apertura: 2026-10-02 21:15, America/Lima.
- Fuentes rectoras: `S3G4_LAB_rev2.1/03_simulaciones/CH1_entrada/ENCARGO_CODEX_S1b.md`, `PLAN_SIMULACION_S1b.md`, `PLAN_SIMULACION_S1.md`, `ACTA_S1.md` y `AUDITORIA_CLAUDE_S1.md`; revisión de entrada CH1 y auditoría P4/P7 consultadas.
- Encargo vigente: completar A con 200 casos en cada uno de R1/R2/R3 y B con 200 casos en el menor rango que cumpla C6. No cambiar valores de diseño, no modificar STATE/DECISIONS ni entregables S1.

## Cambios y evidencia de implementación

Se crean `comun/ch1_comun_s1b.inc`, `ejecutar_s1b.py`, netlists y registros bajo `S1b/`, resultados `s1b_*` y acta propia. C_SEL_EST usa CJ polarizada y dos COFF_SW; CT2 se separa en CT2F derivado y CTRIM. Los criterios usan medidas LTspice, con búsqueda de trimmer/CTIP verificada en el circuito completo. Los componentes de compensación sólo reciben su propia tolerancia durante el MC.

Se conserva semilla 20261003, muestras A comunes a los tres rangos, resolución de CTRIM ±0.1 pF y selección CEQ por bisección LTspice a 1 MHz y redondeo E24. Se amplía E1 de las campañas a DC/AC/GND y se mide E3 de B antes y después de seleccionar CEQ. GND es informativo.

E3 usa una fuente numérica PWL aislada para forzar pasos reales ≤2 ns durante los 5 µs posteriores al flanco. Cada .raw se comprueba antes de eliminarlo; fuera de esa ventana, máximo 100 ns. Nominal contrastado con 2 ns globales y convergencia con 1 ns global. Fuente cuadrada ±1 V, 1 kHz, subida 5 ns, 50 Ω; sonda 9 MΩ ∥ CTIP y cable 80 pF, sin CCOMP.

## Incidencias de ejecución

La primera sesión se cortó por un límite externo después de una prueba de humo correcta; esa evidencia no certifica los 200 casos. En la continuación, la muestra A/c022/R2 alcanzó el timeout interno de 300 s. Se retiró ese límite y se confirmó `solver=alt` (Alternate) con la misma netlist, sin modificar componentes. La ejecución completa se reinició uniformemente con Gear/Alternate y un proceso LTspice por defecto para evitar problemas de concurrencia. Los intentos parciales no cuentan como campaña completa.

## Estado al abrir este diario

Ejecución completa en curso. No hay todavía resultado final ni decisión de trimmer comercial. El acta y los CSV finales deberán distinguirse explícitamente del humo (`smoke=false`, 200 casos por campaña). Pendientes: completar A/B, verificar cobertura, registrar valores C1…C9/topes/selección CEQ, cerrar este diario e indexar fuentes.

No se han conectado placas ni repetido ensayos físicos. No se certifican ±100 V/ESD ni amplificadores reales; S2 y la auditoría de Claude siguen pendientes.

## Continuación: paralelización solicitada por Keneth

Keneth informa que detuvo deliberadamente la ejecución y pide un pool de 10 trabajadores. Se implementa ThreadPoolExecutor: todos los casos/rangos de A comparten el pool; B espera el rango que cumpla C6. Las búsquedas dentro de cada caso permanecen secuenciales. Las respuestas se reúnen por orden de envío (campaña/rango/caso), no por orden de finalización. Fallos de caso y de simulación quedan registrados sin cancelar los demás casos; el código de salida sigue siendo 1 por error, no por fallo eléctrico.

Prueba del pool con un fallo inyectado: las cuatro tareas terminan y las tres respuestas válidas conservan el orden, aun terminando en orden inverso. Smoke secuencial: 104 simulaciones, código 0, cero errores/advertencias. El primer smoke paralelo mostró competencia entre instancias: cada LTspice solicitaba hasta 12 hilos. Se detuvo sólo ese proceso y sus hijos, y se fija `.options threads=1` en cada instancia; no modifica componentes ni ajustes eléctricos. Fuente primaria: respuesta de Mathias Born (ADI), 2025-07-14, https://ez.analog.com/design-tools-and-calculators/ltspice/f/q-a/592257/option-to-limit-the-maximum-number-of-threads . No se descargan archivos ni se cambia la configuración global de LTspice.

Se repiten ambos smokes con un hilo interno por instancia y se comparan los CSV byte a byte antes de lanzar la campaña completa. La semilla permanece 20261003. La cola finalmente intercala caso/rango para que R1/R2/R3 avancen juntos; se conservan los índices originales para reunir respuestas por campaña/rango/caso. Se detuvo el primer arranque completo para aplicar esta intercalación y se repitió el smoke paralelo antes del arranque definitivo.

## Cierre — 2026-10-02 22:43, America/Lima

Campaña completa concluida con 10 trabajadores y un hilo LTspice interno por instancia: 200 A en cada uno de R1/R2/R3 y 200 B en R1. Código de salida 0; 9 375 simulaciones, cero errores, advertencias o casos fallidos. Tiempo de ejecución completo: 2 047.451 s (34.124 min). El smoke secuencial tardó 96.586 s y el paralelo definitivo 61.975 s: los 14 CSV son idénticos byte a byte, 104 simulaciones por variante, código 0 y sin incidencias. Copias y evidencia bajo `S1b/smoke_secuencial`, `S1b/smoke_paralelo` y `S1b/paralelizacion_verificacion.json`.

ACTA_S1b.md y los 14 CSV/JSON/resumen s1b_* se regeneraron con datos completos (`smoke=false`). Todos los criterios C1…C9 pasan. C1: 0.999128…1.000287 MΩ; C2: Cin 26.292419…26.691674 pF, Δ 0.399255 pF; C3: error 0.324191 %; C4: planitud 0.239715 %, pico 0.001353 dB, corte 8.802472 Hz; C5: sobreimpulso 0.017252 %, |e2| 0.338975 %, convergencia máxima 4.070e-7 pp. C6: máximos R1/R2/R3 0.376486/0.375144/0.382238 %, topes 0/200 en los tres. R1 (2–6 pF) es el mínimo que cumple, sin seleccionar una pieza comercial. C7: |ΔCin| máximo 1.414737 pF; C8: sobreimpulso máximo 0.505098 %, |e2| máximo 1.500587 %; C9: error Zin máximo 0.256254 %, planitud ×1 máxima 0.293357 %.

B informativa: |ΔCin| antes 0.012508…3.474681 pF (mediana 1.087545); después de E24 0.000542…0.962840 pF (mediana 0.263917). Hubo 29/200 topes; planitud ÷100 máxima 2.644086 % antes y 2.648992 % después. Se conservan todos los casos. Reparto E24 en pF: 7.5×4, 8.2×14, 9.1×28, 10×41, 11×41, 12×46, 13×24, 15×2.

Verificación independiente: 6 006 filas con claves únicas y cobertura completa DC/AC/GND en ambos POS; orden MC por campaña/rango/caso; .cir/.log presentes para las 9 375 simulaciones. 131 499 nombres de medidas contrastados con POS/CPL/RANGO reales. Los 9 375 logs confirman un hilo interno. Las 1 003 ventanas finas cumplen ≤2 ns; máximo observado 1.066639 ns. El ejecutor comprueba que 993 archivos protegidos conservaron su hash. Evidencia ligada al manifiesto por SHA-256 en `S1b/verificacion_campana_completa.json`.

No se cambian valores primarios de diseño ni se adoptan decisiones permanentes. Se mantienen las dudas del acta: tolerancias de producción supuestas, dos COFF_SW en la estimación frente a su retorno explícito, banda C9 no definida y elecciones metodológicas de CTIP/resolución/correlaciones. Pendientes externos al encargo: auditoría de Claude, caracterización del prototipo, selección comercial de trimmer y S2 con modelos/protecciones reales. Este diario y las fuentes de entrega se indexan en s3g4-context; STATE/DECISIONS quedan intactos por instrucción explícita del encargo.
