keneth-urbizagastegui/S3G4-LAB/ai-context/journal/2026-10-03-1619-codex-s3b.md

# S3b — protección diferencial de U103A

- Agente: Codex, sesión iniciada el 3 oct 2026, UTC−05 (America/Lima).
- Encargo: `S3G4_LAB_rev2.1/03_simulaciones/CH1_entrada/ENCARGO_CODEX_S3b.md` y contrato `PLAN_SIMULACION_S3b.md`.
- Registro inicial a las 16:19; cierre de simulación y reproducción a las 16:32.

## Alcance y fuentes

Leídos START/STATE, AGENTS, encargo/plan S3b, plan/acta/auditoría S3,
plan/acta/auditoría S2b, decisiones del 3 oct, LEEME de modelos y rev 2.1,
PLAN general, revisión de entrada §6 y documento vivo C.3–C.6.
No están disponibles los MCP s3g4-context/context-mode: se informó y se
consultó `node tools/ai-context/context.mjs search "S3b U103A 3 oct"`.
Las salidas grandes se procesan localmente y se devuelven hallazgos.

El encargo prohíbe modificar STATE/DECISIONS y entregables anteriores:
prevalece esa prohibición específica. Este diario no registra una selección
de variante ni una decisión nueva. No hubo descargas ni ensayos físicos.

## Cambios propios

En CH1_entrada: `comun/ch1_comun_s3b.inc` incluye S3 y añade únicamente
las redes R_SER + diodos antiparalelo BAT54/BAV199; `ejecutar_s3b.py`
reutiliza S3 sin editarlo, con diez trabajadores en todos los lotes,
`--smoke`, `--controls` y `S3G4_MODELS`. Genera S3b/, CSV y acta nuevos.
Sensores ideales de 0 V miden corriente del común y toda la salida OPA810.
Auxiliares nuevos: `generar_respuesta_s3b.py` y
`verificar_reproduccion_s3b.py` (copia temporal de ruta corta).

## Evidencia previa

- Controles: código 0, 6 casos, 16.017 s. Ruido sin protección:
  corregido 0.39612952855495104 % div; original 0.6443381863018783 % div.
- B0 A/B/C/D: picos 8.3623/8.3490/2.2636/2.2380 dB con carga aislada.
- Smoke: código 0, 66 simulaciones, 198.970 s, cero errores/advertencias;
  21318 archivos protegidos, cero cambios.
- No existe hoja local BAT54S Vishay: C2 A/B queda condicional al verificar
  IF de la pieza dual; no se confunde Iave=300 mA del modelo ni la hoja de
  BAT54T1G onsemi con una hoja BAT54S. BAV199 usa mitad de 140 mA.
- B6 del AD8038 simplificado no incluye Ib real/deriva ni mismatch del par.

## Cierre

Campaña completa terminada: código 0, 162 simulaciones, 449.605 s,
diez trabajadores, cero errores y advertencias; 21318 archivos protegidos,
ningún cambio. Cobertura contrastada desde los decks y CSV:
B0=4, B1=48, B2=50 (incluidos dos controles), B3=8, B4=24, B5=8, B6=20.
Temperaturas, relé, tomas, modelo de ruido y estados .meas coherentes;
todo SWI1 nativo. B3 completo de −40 a +40 V, 1601 puntos por caso,
con picos raw contrastados contra .meas. B4 hasta ±4.5 V y paso ≤1 ns.

Resultados: C1 y C3 pasan todas; C2 pasa C/D y queda condicional A/B por
la hoja BAT54S ausente; C4 falla todas por los picos de B0. En la cadena
B1 C/D no tienen pico relevante y A/B sí (6.3513/6.8761 dB).
C5 pasa A/B (0.276770/0.359135 µs); falla C/D (1.108423/1.155029 µs,
excesos 0.108423/0.155029 µs). C6 pasa todas. Ninguna pasa todo;
no se elige variante ni se rediseña S4.

Ruido máximo A/B/C/D: 0.414363/0.437762/0.408975/0.423489 % div.
Tabla B3 por escala, B6 por temperatura y offset añadido frente a S3:
`ACTA_S3b.md`, `resultados/s3b_*.csv` y `RESPUESTA_FINAL_S3b.md`.
El offset añadido máximo absoluto de B6 es 1.952973e−5 div, variante B
a 70 °C/5 mV/div; no certifica el offset real del AD8039.

Reproducción completa: código 0, 162 simulaciones, 549.250 s, diez
trabajadores. Copia: `C:\Users\Keneth\AppData\Local\Temp\s3b-replay-tkyf8n48\rev\sim\CH1_entrada`,
S3G4_MODELS apuntando a los modelos locales de sólo lectura.
Los 10 CSV coinciden byte a byte; las fuentes de simulación comparadas
también coinciden. SHA256 y ruta en `resultados/s3b_reproducibilidad.json`.
Sin cambios en los archivos protegidos de la reproducción.

Entregados B0–B6, acta, CSV, ejecutor y respuesta final solicitada.
Pendientes de ingeniería: ninguna variante cumple todo bajo el contrato
B0+B1; hoja BAT54S para cerrar C2 A/B; auditoría de Claude y decisión
de Keneth. No se convierte ningún resultado en aceptación de hardware.
Se sincroniza el índice con `node tools/ai-context/context.mjs sync`.
