keneth-urbizagastegui/S3G4-LAB/ai-context/journal/2026-10-03-codex-s5.md

# S5 — filtro anti-alias CH1

- Agente: Codex. Inicio del diario: 2026-10-03T19:01:09-05:00 (America/Lima, hora de creación del archivo).
- Encargo: `S3G4_LAB_rev2.1/03_simulaciones/CH1_entrada/ENCARGO_CODEX_S5.md`; contrato: `PLAN_SIMULACION_S5.md`.
- Se leen fuentes rectoras antes de implementar. MCP s3g4-context y context-mode no disponibles en esta conexión; alternativa local.
- Alcance: síntesis BE/TR/BU y campaña LTspice G0–G6 con diez trabajadores. Sin elegir candidato, cambiar polos fijos ni S1–S4, modelos, STATE o DECISIONS. Sin descargas.
- Estado: trabajo de simulación terminado; selección de candidato y auditoría de Claude pendientes.

## Síntesis y controles iniciales

- Cálculo scipy de prototipos BE/TR/BU reproducido: A(3.25 MHz)=8.35436/10.89480/17.12185 dB; A(4.5 MHz)=16.04133/21.44658/29.67545 dB. Coincide con §2 del contrato.
- Archivos nuevos: `sintesis_s5.py`, `ejecutar_s5.py`, `comun/ch1_comun_s5.inc`; únicamente S5.
- Síntesis: C2 E12 de 47–220 pF, C1 redondeado E12 y R E96 499–2490 Ω; minimiza error de Q, luego f0. Sección Q bajo primero.
- G0 inicial: código 0; seis simulaciones aisladas, diez trabajadores, 6.074 s, cero errores/advertencias y cero archivos protegidos cambiados. Modelo real desplaza f0; se informa ajuste de biquad, no se retocan piezas.
- `--smoke` en curso. Se conservan RLOAD1k/CLOAD10p heredados y 5p del muestreo estático; la ambigüedad de la carga sustituta se documenta sin resolverla.

## Smoke completo y campaña

- Smoke: código 0; 57 simulaciones; 334.692 s; cero errores/advertencias; protegidos sin cambios. Valores parciales: BE corte 1.821–1.822 MHz; TR 1.951 MHz; BU 1.917 MHz. BU recuperación 1.08148 µs, por encima de 1 µs. Monte Carlo smoke sólo tres casos por candidato: no aceptación.
- Se corrigieron etiquetas de G0 para indicar escala/POS/toma no aplicables; se añadió pico aislado hasta 200 MHz y C5 considera escalón y cuadrada. No se modificó el circuito integrado ni la síntesis. `sintesis_s5.py` ahora ejecuta sus seis comprobaciones LTspice automáticamente: código 0; 5.643 s.
- Campaña completa lanzada: 708 casos previstos, diez trabajadores, prioridad G1/G2/G3/G5/G6/G4; semilla 20261003, 200 casos independientes por candidato con factores pareados entre candidatos.

## Campaña completa terminada

- Código 0; 708 simulaciones; 624.939 s; diez trabajadores; cero errores y advertencias según lector de logs; 11439 archivos protegidos comprobados, sin cambios.
- BE: C1 y C3–C8 pasan; C2 falla con 135/200 (67.5 %) en 1.8–2.2 MHz.
- TR: C1–C8 pasan; C2 da 199/200 (99.5 %).
- BU: C1–C7 pasan; C8 falla por recuperación 1.08147861 µs (límite 1 µs), con diferencial 0.123698631 V (límite 2 V).
- No se eligió candidato ni se retocaron piezas/polos después de medir.
- Acta y CSV completos generados. Reproducción completa en curso en `C:/Users/Keneth/AppData/Local/Temp/s5codex20261003/CH1_entrada`, con S3G4_MODELS a los originales. Se añade `verificar_s5.py` para comparar CSV byte a byte y contrastar estados/valores Monte Carlo contra decks.

## Cierre — 2026-10-03T19:41:32-05:00

- Reproducción completa: código 0; 708 simulaciones; 548.763 s; diez trabajadores; cero errores/advertencias y protegidos sin cambios.
- Verificador: código 0; 13/13 CSV idénticos byte a byte; 708 decks auditados sin discrepancias. Evidencia y SHA256: `resultados/s5_reproducibilidad.json`.
- Smoke actualizado sin repetir circuitos integrados idénticos: 57 casos finales; 51 reutilizados con deck verificado; 6 G0 ejecutados de nuevo; 63 intentos nativos acumulados; 346.855 s acumulados. El historial inicial se conserva en JSON. Los estados no aplicables de G0 están corregidos en todos los decks activos.
- Archivos finales: scripts de síntesis/ejecución/verificación S5, include S5, decks/logs en S5, 13 CSV completos y manifiestos en resultados/s5_*, acta, resumen y RESPUESTA_FINAL_S5.md. Acta/resumen incluyen prueba de reproducción.
- Dudas sin resolver: E17 antiguo (BU5º) frente al contrato S5 (4º activo); carga sustituta RLOAD1k/CLOAD10p retenida; polo S4 ideal frente a macro real; retardo medido desde1kHz, no0Hz; ruido de referencias/DAC idealizado y límites del modelo de entrada AD8039.
- No se modificó firmware/PCB, S1–S4, modelos, STATE ni DECISIONS. No hubo descargas ni selección de candidato. Pendientes: auditoría de Claude y decisión de Keneth.
- Memoria local sincronizada con `node tools/ai-context/context.mjs sync`: código 0, 209 fuentes indexadas, cero ausentes. Se repite la sincronización tras registrar esta evidencia.
