keneth-urbizagastegui/S3G4-LAB/ai-context/journal/2026-10-03-codex-s6.md

# S6 — Codex

Inicio: 2026-10-03 (America/Lima). Agente: Codex.

Encargo: ENCARGO_CODEX_S6.md y PLAN_SIMULACION_S6.md. Campaña ADC
entrelazado con circuito fijo S4 y filtro TR reescalado sólo para H3.
MCP s3g4-context/context-mode no expuestos; se usa lectura local acotada.
No cambiar STATE, DECISIONS, modelos, S1–S5 ni chequeo_claude.

Estado al inicio: lectura de fuentes obligatorias, H0 y construcción de
herramientas nuevas con diez trabajadores, antes de ejecutar simulaciones.
Las actas previas son evidencia histórica, no ensayos físicos actuales.

20:28 Lima: fuentes obligatorias leídas. H0: RSW=824.8045133903614ohm;
LTspice confirma ventana67.3076923077ns, período307.692307692ns,
desfase153.846153846ns. Seis controles, código0,8.145s. Primer intento
detectó limitación del lector heredado: TRIG/TARG usa nombre=valor;
se añadió lectura de ese formato sólo en runnerS6. No fallo eléctrico.
Creado includeS6, analisis_s6.py y ejecutar_s6.py con10 trabajadores.
Pendientes smoke/campaña, controles de precisión y reproducibilidad.

20:38 Lima: smoke corregido código0,25simulaciones,177.251s;
auditoría25decks/4672muestras sin defectos. Se corrige análisis del cierre
enZ/R: límite izquierdo de tracking, no interpolación a través del reset5fs.
Se corrige punto de inyecciónU105 a salida para incluir ambas rutasSK;
retorno por dos inyeccionesTian/Middlebrook. PM: OPA83677.930°,
U105A60.681°/U105B61.730°. Smoke inicial178.960s archivado como diagnóstico
previo a estas correcciones; no se usa como resultado eléctrico final.
En curso campaña67simulaciones H1/H2/H4/H3, con piezas sin cambios.

20:49 Lima: campaña principal terminada, código 0, 67 simulaciones,
455.122 s; cero errores/advertencias y cero cambios protegidos.
Auditoría de 67 decks, 55 casos de muestreo y 30,400 muestras sin defectos;
ambos ADC: ventana 67.3076923 ns y período 307.6923077 ns.
C1/C3/C4/C5 pasan. C2 falla: 52.829068 mV máximos (86.555145 LSB),
37.355809 mV rms; lineal −0.042571 dB y −3.021645°, residuo mucho menor.
Se entregan ACTA_S6.md y 11 CSV de campaña, más resumen/manifest.

Precisión: 4 simulaciones nuevas a paso 0.25 ns, código 0, 149.486 s;
máximo cambio de error pico 0.822544 µV. Criterios sin cambio.
SFDR H3 cargado cambia +0.352 dB; SFDR de H2 sin carga y Z aumenta
20–30 dB al bajar el paso: suelo numérico, no rendimiento de silicio.
Reproducción de 67 simulaciones en ruta corta iniciada con S3G4_MODELS.
Pendiente en ese momento: comparación byte a byte, cierre y sync.

Cierre de ejecución (3 oct, noche, Lima): reproducción completa código 0,
67 simulaciones, 436.704 s; 11/11 CSV idénticos byte a byte. Auditoría de
la copia: 67 decks y 30,400 muestras sin defectos. Huellas en
`CH1_entrada/resultados/s6_reproducibilidad.json`; precisión en
`s6_precision.json`. Acta y resumen incluyen ambos controles.
Respuesta solicitada en `CH1_entrada/RESPUESTA_FINAL_S6.md`.
Sin modificaciones de circuito, modelos, S1–S5, chequeo_claude, STATE
ni DECISIONS. El resultado no se marca como acuerdo ni como aprobación
de C2. Pendiente externo: auditoría de Claude y caracterización real;
sin remedio seleccionado. Trabajo autorizado terminado.

20:58 Lima: `node tools/ai-context/context.mjs sync` terminó con código 0:
217 fuentes indexadas, cero ausentes. Entregables comprobados: 67 decks
de campaña, 25 de smoke y 4 de precisión; ACTA y resumen idénticos.
Se vuelve a sincronizar esta última anotación. Diario cerrado.
