keneth-urbizagastegui/S3G4-LAB/ai-context/journal/2026-10-03-codex-s7b.md

# S7b — Codex

Inicio: 2026-10-03 (America/Lima). Agente: Codex.

Encargo: ejecutar ENCARGO_CODEX_S7b.md y PLAN_SIMULACION_S7b.md. Lectura inicial de AGENTS, START, STATE y contrato realizada. MCP s3g4-context no disponible; se consultan fuentes locales. Se preservan STATE, DECISIONS, modelos, entregables anteriores y chequeo_claude. No se descarga nada.

Lecturas: contratos S7b/S7, acta S7, revisión CH1, auditorías S1–S6 y complementarias, decisiones del 3 oct, E19, includes y ejecutor S7; LEEME de modelos. Hoja local OPA836 SLOS712J pp.10/12: máximo offset ±400 µV a 25 °C; no se descargó nada.

Implementación nueva: comun/ch1_comun_s7b.inc y ejecutar_s7b.py. Diez trabajadores desde preflight, perfiles preflight/smoke/campaign separados, S3G4_MODELS heredado del ejecutor base, CSV con columnas fijas. Circuitos S7 importados sólo en memoria; entregables anteriores no editados.

Verificación previa: 19 simulaciones completadas, código 0 tras corregir el parser de sufijos SI (confundía CT2F con sufijo f al evaluar la dispersión; ninguna topología eléctrica afectada). Evidencia en S7b/preflight/. K1 5 mV/div: 2.007647 MHz, 182.058 ns, ruido 0.321644 %div, ganancia DC −49.498204; 0.5 V/div: 2.006843 MHz, 182.086 ns, 0.321823 %div, −0.495325568. Pico <0.00002 dB. Reparto MC de diez placas guardado, semilla 2026100371: trimmer 8/10 dentro del rango. Se comunicaron números antes de campaña.

Pendiente: smoke, campaña K1/K3/K2/K5/K4, acta, cierre y sincronización. No hay ensayos de placa ni aceptación nueva.
