keneth-urbizagastegui/S3G4-LAB/ai-context/journal/2026-10-04-2135-codex-pausa-s9b.md

# S9-B — pausa solicitada y entrega de contexto

Fecha: 4 octubre 2026, 21:35, America/Lima (UTC−05:00). Agente: Codex.

## Instrucción vigente del usuario

Keneth pidió parar la tarea **cuando termine la corrida actual** y dejar constancia suficiente para otra IA. Esta pausa sustituye la continuación automática anterior. No lanzar la continua corregida, nuevas campañas ni adoptar una variante hasta que el usuario retome el trabajo.

## Alcance y fuentes

Este frente es **S9, CH2/CH3 del AFE rev. 2.1**, no firmware de producción, no banco físico ni CH1. Carpeta de trabajo: `S3G4_LAB_rev2.1/03_simulaciones/CH23_entrada/` (las rutas siguientes son relativas a ella).

Consultar `PLAN_SIMULACION_S9.md`, `ENCARGO_CODEX_S9_B.md`, `ACTA_S9.md`, `ai-context/DECISIONS.md`, `ai-context/journal/2026-10-04-codex-s9.md` y `ai-context/journal/2026-10-05-claude-retomar-s8b-s9b.md`. El bloque B del acta aún dice «en curso»; este diario recoge el cierre de ejecución, **no una aceptación final**.

## Campaña principal terminada

La reanudación `ejecutar_s9_b.py --resume` terminó el 4 oct a las **21:28:09, Lima** (2026-10-05T02:28:09Z). Metadatos preservados en `S9/B_hoja/campaign/s9b_meta.json`:

- 4 295 / 4 295 casos ejecutados correctamente; 14 391 simulaciones nativas contabilizadas; diez trabajadores; semilla 2026100371.
- Tiempo de esa reanudación: 2 854.1365833 s (≈47.6 min), no tiempo total de todas las sesiones históricas.
- Código de salida **1**, por el guard de archivos protegidos: detectó cambio externo en `ai-context/STATE.md`. Los casos terminaron todos; no interpretar ese código como fallo eléctrico ni borrar la evidencia. El cambio detectado precede a las ediciones de memoria de esta sesión.
- Filtro A/B: 2.37 kΩ y 1.10 kΩ. K4 heredado de A, sin repetirlo.
- Modelo propio ajustado `comun/lm6172_hoja.lib`; SHA256 `4fb5d82e3319553113ba8ff7c8ff5bc4b7fa65e9a13b59dea2173140fe90d31b`. No modificar el original del fabricante.

Auditoría estructural `verificar_s9_b.py` ya ejecutada por el coordinador: **código 0, cero errores**, 14 391 decks y 4 295 casos esperados/encontrados. Evidencia: `S9/B_hoja/campaign/s9b_auditoria_codex.json`; etapa guardada en `resultados/s9b_cierre.json` (16.288 s). Esto verifica generación y resultados, **no equivale a auditoría independiente ni aceptación de todos los criterios funcionales**.

Distribución de casos: K1 12, K3 12, K5AC 2 000, K5NOISE 200, K5OP 2 012 (2 000 MC + 12 nominales), K6 36, K6REC 10, K2 12, K8 1. Los resultados de A permanecen como referencia, sin repetir A.

## Hallazgos y limitaciones que siguen abiertos

- AC Monte Carlo: C1/C2/C3 pasan 500/500 por escala. f3 global 938606.293–1102889.510 Hz; pico máximo 0.239067892 dB; atenuación mínima a 2.47 MHz 24.18236738 dB (checkpoint previo y resultados preservados).
- Ruido: 100/100 por cada una de las dos escalas MC; ≈0.274–0.299 % de división. No confundir con aceptación del canal completo.
- Continua **original sesgada**: en las cuatro cohortes la ganancia dentro de ±5 % y el centro compensable pasan 500/500. El recorrido ±4.5 div (C9) pasa **267/500, 287/500, 267/500, 287/500**, respectivamente a 5 mV/div, 50 mV/div, 0.5 V/div y 5 V/div. Estas cifras no son el resultado corregido.
- El LM6172 de National conserva +2.986 mV de offset nativo y el MC añade ±3 mV: hay doble contabilización. Queda pendiente repetir **sólo las cuatro cohortes de continua B** con offset total bien contado; no repetir AC, ruido, A ni K0 por ello.
- Recuperación medida de los diez casos K6REC: 1.389981–1.466870 µs. Comparar con **C8 vigente ≤2 µs**, registrado en DECISIONS el 4 oct; los documentos históricos que dicen 1 µs conservan el criterio antiguo. Saturación, protección y recuperación del macromodelo siguen sin validación contra silicio.
- La copia LM6172 ajustada no está validada por TI; ruido blanco sin curva 1/f, sin dispersión de GBW/Ib/temperatura. El ajuste de consumo corresponde a esta alimentación. No certificar hardware ni autonomía.
- No se ha elegido LM6172 frente a AD8039. Sigue pendiente la comparación final, auditoría de Claude y consumo G.3/G.4. Conservar las contradicciones ya registradas entre S7b/S7c y la base U105; no resolverlas por suposición.

## Cómo se efectuó la pausa

Al recibir la instrucción, la campaña principal ya había acabado. El coordinador externo había auditado B e iniciado una repetición `ejecutar_s9_b.py --smoke`.

Para impedir el siguiente lanzamiento automático se verificó la identidad por línea de comandos y se detuvieron **sólo** el Codex externo PID 11660 y `finalizar_s9_b.py --wait-pid 6756` PID 14228. La envoltura PID 15148 ya no existía al comprobarla. Se dejó terminar el smoke PID 20496 y sus LTspice, sin interrumpir sus simulaciones. No se detuvieron servidores MCP ni otras tareas.

El pipeline `finalizar_s9_b.py` contiene pasos posteriores que **no deben ejecutarse automáticamente durante la pausa**: auditar/comparar smoke, correr OP corregida, auditarla y generar informe.

**Smoke terminado a las 21:34:04, Lima** (mtime de `S9/B_hoja/smoke/s9b_meta.json`, 2026-10-05T02:34:04Z): código 0, **25/25 casos**, 57 simulaciones nativas, 333.506009 s, sin cambios en los 26 403 archivos protegidos. Mismo hash de modelo. El diario nuevo de pausa no pertenece al conjunto protegido del smoke. La auditoría de este smoke repetido y la comparación numérica con baseline **quedan pendientes**; no confundirlas con la auditoría del smoke anterior ni con la auditoría de la campaña principal.

**Comprobación de procesos a las 21:35, Lima:** ningún `ejecutar_s9*`, `finalizar_s9*`, Codex externo `codex_s9b2_final` ni LTspice ligado a `S9/B_hoja` activo. Directorio `S9/B_hoja/op_corregido` ausente. **Tarea pausada efectivamente**, no campaña incompleta ni trabajo final aceptado. Las anotaciones históricas «en curso» quedan superadas por este punto de retomada.

## Retomada concreta (cuando Keneth la solicite)

1. Leer este diario y STATE actual. Comprobar ausencia de procesos S9 y archivos vigentes; no reutilizar PIDs históricos como identidad.
2. Consultar `S9/B_hoja/campaign/s9b_meta.json`, `s9b_checkpoint.json`, `s9b_auditoria_codex.json`, guard antes/después y `resultados/s9b_cierre.json`. No relanzar la campaña principal: ya está completa.
3. Auditar el smoke final y compararlo con `resultados/s9b_smoke_baseline.json` usando la lógica de comparación en `finalizar_s9_b.py` (tolerancias absoluta/relativa 1e−9). El coordinador se detuvo antes de registrar esa etapa, por lo que su JSON de cierre puede seguir mostrando sólo la primera auditoría.
4. Revisar `ejecutar_s9_b_op_corregido.py`: desplaza +2.986e−3 V los parámetros de fuentes `VOA`, `VOB`, `VOFA`, `VOFB`, equivalente al signo efectivo −2.986 mV. Verificar signo y requisito antes de ejecutar. Genera sólo seis OP por placa, 500 placas × cuatro escalas, misma semilla/pasivos/rieles. Destino separado `S9/B_hoja/op_corregido/`; `--resume` conserva lo completado. Al comprobar la pausa, ese directorio **no existía**.
5. Ejecutar la continua corregida sólo tras reanudar; después `verificar_s9_b_op_corregido.py`. Auditor empareja los seis decks con los originales restaurando las cuatro fuentes, sin simular A.
6. `informar_s9_b.py` exige 2 000 casos corregidos y auditoría correcta; todavía no ejecutado. Debe cerrar sólo el bloque propio B de ACTA, preservar texto ajeno, tabla A/B con criterio C8 vigente y explicación del guard. Revisar la inspección estática del modelo AD8038 prevista en ese script: la evidencia aún no está emitida, no presentar esa conclusión como comprobada hoy.
7. Auditoría independiente y decisión de Keneth sobre variante; después actualizar consumo/documentos pertinentes, STATE/diario y sincronizar contexto. S8b sigue separado, sin modificar ni unir su rama en esta pausa.

## Evidencia adicional y conservación

Consolas actuales en `%TEMP%`: `s9b_campaign_console_resume_20261004b.log`, `s9b_cierre_pipeline.log`, `s9b_cierre_verificar_s9_b.log`, `s9b_cierre_ejecutar_s9_b.log`. Los CSV, JSON, decks, hashes y resultados esenciales están en el proyecto, no dependen de conservar TEMP. `resultados/s9b_smoke_baseline{,_meta}.json` guarda la referencia anterior.

La copia de trabajo contiene cambios previos de otras sesiones (documentos, memoria y scripts). No se ha hecho commit, push, reset ni limpieza. No se ha modificado firmware, PCB, esquema, parámetros de banco ni modelos para pausar. No hay pruebas físicas nuevas. Se añade un punto de pausa en STATE sin reemplazar su contenido anterior; no hay decisión permanente de diseño nueva que añadir a DECISIONS. `node tools/ai-context/context.mjs sync` terminó con código 0: 216 fuentes indexadas, ninguna ausente. Consulta posterior en MCP **s3g4-context**, `sort: timeline`, recuperó este diario y la instrucción de pausa. Se sincroniza de nuevo esta anotación final antes de entregar.
