keneth-urbizagastegui/S3G4-LAB/ai-context/journal/2026-10-04-codex-s7b-reanudacion.md

# S7b — reanudación por Codex

Inicio: 2026-10-04, America/Lima. Fuentes: diario 2026-10-03-codex-s7b, REANUDACION_S7b de Claude, contratos S7b/S7, acta S7, revisión CH1, decisión del 3 oct y LEEME de modelos. START y STATE consultados. MCP s3g4-context conectado.

Solicitud: reparar convergencia numérica sin alterar circuito, tiempo límite por simulación, repetir smoke y completar campaña. Se preservan modelos, entregables previos, STATE y DECISIONS conforme al contrato específico.

Diagnóstico inicial: K2DC usa barrido anidado con saltos DAC de 1.05 V y gminsteps=0. Claude documentó diez errores y dos procesos colgados. Se ensaya separar los tres ajustes DAC, activar ayudas numéricas y limitar cada proceso. Pendiente: validar, campaña, acta y cierre.

00:13 aprox.: separar ajustes y activar gmin no resolvió los casos. Continuación desde cero por sí sola tampoco. Evidencia nueva: `S7b/bias_check/`, mc0 escala 50 mV/div. AC converge en 15.23 s; `.savebias internal` + `.loadbias` permite los cuatro recorridos DC (ganancia positiva/negativa desde cero y DAC desde 1.25 a ambos extremos en pasos 5 mV) en 0.86–1.07 s. Son recomendaciones `.nodeset`, no restricciones permanentes; ver ayuda local LTspice 26 `savebias--saveoperatingpointtodi.htm` y `loadbias--loadapreviouslysolvedd.htm`. Ningún valor eléctrico ni modelo cambia.

Control de procesos: Popen sin pipes, espera acotada y taskkill /T /F al vencer. Se detectaron procesos retenidos tras subprocess.run(capture_output); experimentos propios detenidos por ruta. Límites: 120 s AC/DC/ruido; 600 s protecciones; 900 s transitorios, porque logs históricos exitosos documentan hasta 281 s K3 y 635 s transitorio. Primer reinicio smoke detenido durante arranque para aplicar límites válidos; smoke original preservado en smoke_20261003. Se reinicia completo.

00:14 aprox.: verificación forzada `S7b/verificar_timeout.py`: límite 2 s, terminación en 2.16 s, sin proceso propio restante. Smoke nuevo registra 28 éxitos/28 ejecutados, sin errores en ese checkpoint. Se añade persistencia parcial cada 50 casos y progreso por caso para la campaña, además de orden estable de filas auxiliares CSV. Consultada guía kicad-happy:spice para interpretación; se conservan los bancos y macromodelos del contrato, sin KiCad ni modelos sustitutos.

Durante smoke: evaluación independiente de la distribución completa (sin LTspice) confirma 500 realizaciones distintas, semilla 2026100371 y límites de rieles/VREF/offset respetados. Trimmer requerido 0.9069…7.8043 pF, percentiles 2.5/97.5 % 1.5195/7.1131 pF; 416/500 (83.2 %) dentro de 2–6 pF. C5 falla por cálculo de ajuste; no se cambia ningún valor para remediarlo. Pendiente confirmar con entregables de campaña. K1 y K3 ±40 del nuevo smoke completos sin errores; ±100 todavía en ejecución.

Smoke: 58 casos (K1/K3/K2 AC/ruido) nuevos completados, 781.97 s registrados hasta ese checkpoint, sin errores nativos. Los 48 recorridos K2DC terminaron pero el agregador intentó concatenar el eje `vsrc` con barridos cuyo eje es `vdac` (KeyError); corregido para concatenar exclusivamente V(BNC), V(PIN), V(DAC). Se reanuda el mismo smoke desde sus 58 éxitos, repitiendo K2DC y haciendo K4. Los estados en nombres de las medidas explicitan ahora fuente cero/dirección y rango DAC reales.

Smoke cerrado: código 0; 80/80 casos lógicos; 128 ejecuciones nativas registradas; 890.3135 s acumulados en checkpoints (14.84 min); diez trabajadores; 13319 archivos protegidos y cero cambios. Hay además 48 recorridos K2DC del intento abortado por agregador, preservados como logs, fuera de ese contador de checkpoint. Las doce combinaciones K2DC válidas convergen y C8 pasa en las tres placas del smoke. K4 terminó los diez casos. Evidencia `S7b/smoke/s7b_checkpoint.json`, `s7b_registro.json`, CSV.

Campaña completa iniciada después de smoke código 0: 4416 casos lógicos previstos; 10452 ejecuciones nativas previstas sin reintentos (K3 dos polaridades; K2DC cuatro recorridos). 500 placas emparejadas en cuatro escalas, subconjunto de ruido de 100 en dos escalas, semilla fija. Checkpoints parciales cada 50 casos y estado breve por caso. Pendiente: cierre de campaña, comparación/protección, acta y respuesta final.

Campaña K1: AC y DC nominales completos en las doce escalas. Cortes 2.006204…2.007647 MHz; pico máximo 0.000017714 dB; error de ganancia DC −1.1733…−0.8276 %. J2 tuvo seis fallos de arranque del 4051 (time step too small/iteration limit) en escalas adicionales que smoke no cubre. Diagnóstico `S7b/tran_check`: dos casos resueltos con bias AC de la misma escala + itl4=1000, manteniendo excitación, paso máximo y tolerancias; 22.35/39.27 s, subidas 182.114/182.110 ns. Se implementa reintento automático registrado y opción --resume --retry-numerical para pendientes. La campaña ya iniciada sigue con su código cargado; se repararán sólo los fallidos por reanudación tras terminarla, preservando registros y éxitos. Sin modificaciones eléctricas.

K1 completo en primera pasada: 161/170 casos válidos, nueve pendientes (6 J2, 3 J8). Límite de 120 s actuó en los J8 difíciles. Verificado reintento automático J2 en `S7b/auto_retry_check`: código 0, 182.11371664 ns; conserva advertencias/intento previo de arranque bajo hijos. Verificado J8 20 mV/div, DAC 0.9875 V en `S7b/offset_retry_check`: código 0, dos ejecuciones (guía AC + recorrido DAC), centro 1.239939802 V. J8 usa paso calculado ≤5 mV para llegar exactamente a cada tensión solicitada. Se añade reintento automático J8 y posibilidad de aplicarlo directamente a pendientes por --resume --retry-numerical. Campaña entra en K3; no se detiene.

2026-10-04 01:01 (Lima): K3 ±40 primera pasada, 18/20 casos válidos; dos pendientes en 20 V/div, rieles +4.80/−5.00 y +5.00/−5.00, agotaron 600 s tras fallo de source stepping inicial. Campaña entra K3E5 ±100 (DC y AC). Se prepara reintento con guía AC del mismo estado y rieles exactos, presupuesto itl1/itl2=1000, preservando paso 1 mV/extremos. Diagnóstico en `S7b/protection_retry_check` en curso. Se añaden checkpoints atómicos para nuevas ejecuciones/reanudación; la primera pasada en curso conserva su código cargado anterior.

2026-10-04 01:07 (Lima): diagnóstico K3 reintentado +4.80/−5.00 V, 20 V/div, completo con código 0 y cuatro ejecuciones (guía nominal, guía exacta y dos barridos); ADC 0.744161512…1.733114512 V, seis etapas analizadas. Las recomendaciones no fijan tensiones en la solución final. K3E5 lleva 8/16 éxitos a 01:08, cero errores en ese bloque. Los once casos pendientes de primera pasada siguen identificados para reanudación.

2026-10-04 01:12 (Lima): K3E5 cerrado, 16/16 éxitos. Checkpoint: 195 casos válidos, 240 ejecuciones nativas, 2525 s registrados. Once pendientes numéricos anteriores (9 K1 + 2 K3). Inicia K2 AC de 2000 casos; primeros 28 sin error. Se conservan 500 placas emparejadas y el subconjunto de ruido prescrito.

2026-10-04 01:31 (Lima): arranque frío K2 empezó a fallar en escala 50 mV/div. Se valida guía numérica en placa mc499/50 mV/div (`S7b/warm_mc_check/comparison.json`): frío 44.328 s, guiado 3.256 s; diferencia −3 dB 1.676e−6 Hz, pico 7.010e−12 dB, ganancia 3.938e−12 V/V y rechazo 7.027e−12 dB. No se cambian circuito, distribución, semilla ni tolerancias; la guía sólo inicializa Newton y se liberan los nodos.

Se captura checkpoint válido y se detiene únicamente el árbol del ejecutor propio para cargar el método corregido. `preservar_reinicio.py` conserva snapshot, comprobación original de protegidos y logs de los 18 intentos entre checkpoints (8 nativos terminados sin espectro durable, 10 interrumpidos); todos cuentan como ejecuciones y se repetirán. No se aceptan mediciones perdidas. Evidencia `S7b/restart_snapshot.json`, `S7b/campaign_before_warm_restart/harvest.json`. Checkpoint tras cosecha: 838 éxitos, 908 ejecuciones nativas, 3704.727 s registrados. Siete K2 fallidos previos + once pendientes K1/K3; 18 intentos cosechados también pendientes. Se reanuda `python ejecutar_s7b.py --resume --retry-numerical` con diez trabajadores, guías por escala y checkpoints atómicos. Pendiente completar todos los casos, acta, auditoría de archivos y respuesta final.

2026-10-04 01:49 (Lima): AC MC completo 2000/2000; ruido 200/200. C1/C2 pasan 500/500 en cada una de cuatro escalas; C3 100/100 en cada una de dos escalas. Extremos AC globales 1.819301…2.171390 MHz, pico máximo 0.243221 dB; ruido 0.307499…0.335959 %div. C6 ya tiene 36 casos válidos tras recuperar los dos fallidos. K2DC en ejecución sin errores nuevos; todos los errores previos tienen último intento válido.

Revisión de informes detecta un error de adaptación J8: el analizador heredado usaba y[1] suponiendo tres puntos de entrada, pero en reintentos el eje es DAC. La simulación y su medida .meas del extremo son correctas. Por ejemplo, DAC 0.9875 V mide 1.55947639556 V en el log, no el 1.239939802 V intermedio citado antes. Corregido analizador nuevo para el extremo exacto y reconstrucción de las tres filas J8 reintentadas a partir de medidas nativas. Al terminar esta ejecución cargada anterior hay que ejecutar --reports-only con código actualizado, que además guarda el checkpoint corregido. Ganancia, offset y C8 MC usan analizador distinto y no están afectados. Pendiente cierre/QA.

2026-10-04 02:08 (Lima), Codex: K2DC guardado 1050/2000, sin errores nuevos. Escalas 5 mV/div y 50 mV/div completas, ganancia 500/500 en ambas; margen C8 484/500 y 488/500 respectivamente. No se extrapola aún el resultado a las dos escalas pendientes. QA de protección confirma 36 casos con seis etapas cada uno (216 filas). Se conserva el requisito de regenerar informes tras finalizar, para incorporar los tres extremos J8 nativos corregidos.

2026-10-04 02:27 (Lima), Codex: K2DC completo 2000/2000 sin errores nuevos. Ganancia C4 500/500 en cada escala, error global −4.573899…+2.862849 %. Offset compensable en 2000/2000; margen ±4.5 div C8: 484/500, 488/500, 484/500, 488/500; cumplimiento simultáneo en las cuatro escalas 481/500 (96.2 %). K4 en curso. Creado `S7b/verificar_cierre.py` para auditar cobertura completa, medidas finitas, seis etapas por protección, extremos J8 contra .meas nativos, monotonicidad DAC y hashes de la copia protegida anterior al reinicio. Pendientes K4, regeneración y auditoría final.

## Cierre — 2026-10-04 02:31, America/Lima — Codex

Campaña completa, código 0, 4416/4416 casos lógicos, 10496 ejecuciones nativas y 6912.067 s (115.201 min) de tiempo acumulado registrado, diez trabajadores. Las ejecuciones cuentan intentos fallidos/repetidos y los preservados en el reinicio; diagnósticos y smoke quedan separados. Cero errores finales. Historial conservado: 36 intentos lógicos fallidos o sin resultado durable, todos recuperados, incluidos los 18 preservados entre checkpoints. Un caso final J2 cuadrada/50 mV/div conserva 69 advertencias de relajación automática del solver al arranque, t ≈1.16e−14 s; no se cambiaron tolerancias explícitas del netlist. No se omiten advertencias ni se afirma ausencia de ellas.

`python ejecutar_s7b.py --reports-only` terminó con código 0 y corrigió los tres extremos J8 de las medidas nativas, conservando checkpoint. `python S7b/verificar_cierre.py` terminó con código 0, PASS: 500 placas emparejadas, 100 muestras de ruido por escala prescrita, 216 filas de protección, 15 CSV, valores finitos y columnas sin duplicados; tres J8 coinciden exactamente con .meas y las nueve posiciones de cada escala son monótonas. Auditoría durable: `S7b/campaign/s7b_auditoria_cierre.json`. Comparación con la copia protegida ORIGINAL anterior al reinicio: 13319 archivos, cero cambios. No quedan procesos LTspice de S7b activos.

C1/C2: 500/500 en las cuatro escalas; C3: 100/100 en ambas; C4: 500/500 en las cuatro; C5 FALLA, 416/500 (83.2 %), trimmer requerido 0.906933…7.804264 pF, P2.5/P97.5 1.519531/7.113128 pF. C6: 36/36 casos deterministas; C7: 10/10 sin conducción BAV199, recuperación máxima 0.671635626 µs; C8: 96.8/97.6/96.8/97.6 % por escala y 96.2 % simultáneamente. C6/C7 no se presentan como Monte Carlo poblacional. ADC 0.006878…3.288984 V, alimentación real máxima 4051 9.954115 V. Consumo total simulado 62.724264 mW reposo /65.065475 mW seno; limitación del consumo OPA810 de macromodelo conservada.

Entregados `ACTA_S7b.md`, `RESPUESTA_FINAL_S7b.md`, `resultados/s7b_*.csv` y registro completo. Resumen final incluye tablas C1–C8, doce escalas K1, extremos/P2.5/P97.5 de MC, trimmer, protecciones, tiempo, código, advertencias, método y dudas. Sin cambios eléctricos para reparar convergencia; sin remedios de diseño ni decisiones de aceptación. STATE, DECISIONS, modelos, entregables anteriores y chequeo_claude permanecen intactos conforme al contrato. Pendientes técnicos declarados: insuficiencia del trimmer C5, discrepancia C_EQ 8.7/8.67 pF, límites de modelos/offset/temperatura/ESD y verificación física; no bloquean la entrega de esta simulación y no se resuelven fuera del encargo. Se sincronizan las nuevas fuentes y el diario en s3g4-context.
