keneth-urbizagastegui/S3G4-LAB/TFT_8Bit_Capacitive/test_video_player/CHANGELOG.md

# Registro de versiones — Reproductor de video S3G4

Una entrada por etiqueta, con las cifras **medidas** de esa versión (no estimadas). Detalle por fase en
`plan_antigravity/informes/` y datos en bruto en `plan_antigravity/mediciones/`.

Leyenda: **presentados** = fotogramas que llegan de verdad al panel · **descartes** = fotogramas que el
reloj de reproducción salta por llegar tarde, sobre el total · ambos con la pantalla completa.

---

## `vp-v0.7` — Interfaz nueva en EEZ Studio (F6a) · 17/09/2026
- **Interfaz rehecha en EEZ Studio** (reemplaza a la UI provisional): reproductor, biblioteca y
  pantalla sin videos, con los 25 iconos del diseño, tildes en las fuentes y 0 errores en EEZ.
- Botones del reproductor probados con el dedo por Keneth: reproducir/pausa, anterior/siguiente,
  ±10 s, barra de progreso, repetir (off/todo/uno), aleatorio, atrás (pausa y va a la biblioteca).
- Biblioteca con miniaturas, tarjetas no compatibles y hoja «Continuar / Desde el principio».
- Los controles aparecen de golpe (una sola ventana de envío sincronizada con TE).
- Ya no se queda colgada con un video que no se ve: vuelve a la biblioteca.
- Rendimiento: **descartes 0,18 % / 0,19 %** (controles ocultos / visibles), ~30 fps.
- Corregido en auditoría: un cambio que anulaba los descartes (el 0 % era falso).
- **Pendiente para F6b:** cola, fin de video sin repetir, tarjeta de bloqueo, mejoras de repetir uno,
  y la línea vertical al final.

## `vp-v0.6` — Biblioteca dinámica y posición guardada · 16/09/2026
- **Los videos se leen de la tarjeta**, sin lista en el código: título y subtítulo del `.json`,
  miniatura del `.jpg`. Escaneo de 4 videos en 0,8 s. Un quinto video aparece sin recompilar.
- **Formatos no compatibles** detectados por contenido, con su motivo, sin colgar la placa
  (probado con ficheros truncados y de otra resolución).
- **Posición guardada en NVS**: al reiniciar vuelve al mismo video, con hasta 5 s de pérdida.
- Rendimiento intacto: **29,3–30,0 fps**, **descartes 0,31 %**.
- Código muerto movido a `legacy/`.

## `vp-v0.5` — Sincronía con el panel y fin del corte diagonal · 16/09/2026
- **Presentados: 29,4–30,0 fps** sin controles · **29,6–30,0** con controles · **descartes 0,10 %**.
- **Sin corte diagonal**, confirmado por Keneth. Causa: escribíamos perpendicular al barrido del panel.
  Solución: **videos girados en origen** (320×480, `transpose=1`) y panel en orientación nativa
  (`MADCTL 0x48`), con **una sola ventana por fotograma**.
- Sincronía con la señal **TE** del panel (cable del pin 22 de JP1 al GPIO 7) y refresco del panel
  a **44,6 Hz** (`FRMCTR1 = {0x80,0x12}`), sin parpadeo.
- **La microSD ya no se cuelga al reiniciar en caliente**: CMD12 y pulsos de reloj antes de montar.
  20 de 20 reinicios aleatorios con el video en marcha.
- Descartado: girar dentro del chip (F5c), 27,8 fps.

## `vp-v0.4` — E/S de la microSD y lector adelantado · 15/09/2026
- **Presentados: 30,01 fps** sin controles · **30,02** con controles · **descartes 0,00 %** (0 de 2100).
- Lector de la tarjeta en el núcleo 0 con 3 huecos en PSRAM: el hilo de video ya no espera (0,1 ms).
- Frecuencia de la microSD fijada en 20 MHz: a 26 y 40 MHz no monta (0 de 10 intentos, error 0x108).
- PSRAM a 80 MHz. Búfer JPEG que crece hasta 128 KB. Índice `idx1` sin tope fijo.
- **Pendiente:** la prueba de extracción en caliente nunca llegó a ejecutarse.

## `vp-v0.3` — El video se pinta directo en el panel · 15/09/2026
- **Presentados: ~29,5 fps** sin controles · **~29,4** con controles (antes 13 y 7).
- Decodificación por franjas de 16 líneas: mientras el bus envía una, la CPU decodifica la siguiente.
- LVGL deja de tocar la zona del video; su repintado se recorta alrededor.
- **Descartes 1,53 %**, por encima del 1 % permitido: causa localizada en picos de lectura de 25 ms.

## `vp-v0.2` — Reloj de reproducción y cadencia · 15/09/2026
- Tick del sistema a 1 ms y reloj basado en la marca de tiempo del video, con descarte de tardíos.
- El video pasa a ir **a velocidad natural**, confirmado en la placa.
- **Pero solo 13 de cada 30 fotogramas llegaban a la pantalla**: el cuello de botella era LVGL.
- Corregido el toque en pantalla completa (el lienzo no era pulsable).

## `vp-v0.1` — Concurrencia y respuesta táctil · 15/09/2026
- Cola de comandos entre interfaz y reproductor; ninguna llamada a LVGL fuera de su tarea.
- Táctil en tarea propia: lectura de 0,7–0,9 ms y como mucho 10 ms de antigüedad (antes iba a remolque
  del dibujado del video).
- 20 cambios de pista y 50 saltos seguidos sin desincronizar el título.

## `vp-v0.0` — Instrumentación y línea base · 15/09/2026
- Se separa por primera vez **decodificados** de **presentados**: el acta decía 30 fps y en pantalla
  llegaban **15,1–15,4** (8,2 con la barra visible).
- Inventario de los AVI de la tarjeta: los 4 están a 30 fps, 480×320, 4:2:0, con 7,7–12,8 KB por
  fotograma.

## `vp-v0.0-base` — Punto de partida · 15/09/2026
- Código tal como lo entregó Antigravity, más el plan de trabajo y la revisión.

---

## En curso (sin etiquetar)

- **F6b** — cola, ajustes, gestos, estadísticas, bloqueo y marquesina.
