keneth-urbizagastegui/S3G4-LAB/hardware/Schematic_PFC-1_2026-07-04.pdf

PB11 50 | PB12 51 PB13 52 PB14 53 PB15 54 PD8 55 PD9 56 PD10 57 PD11 58 PD12 59 PD13 60 PD14 61 PD15 62 VSS 63 VDD 64 PC6 65 PC7 66 PC8 67 PC9 68 PA8 69 PA9 70 PA10 71 PA11 72 PA12 73 VSS 74 VDD 75 PA13 76 PA14 77 PA15 78 PC10 79 PC11 80 PC12 81 PD0 82 PD1 83 PD2 84 PD3 85 PD4 86 PD5 87 PD6 88 PD7 89 PB3 90 PB4 91 PB5 92 PB6 93 PB7 94 PB8-BOOT0 95 PB9 96 PE097 PE198 VSS 99 VDD 100 | VDD33 MCU CORE & MISC

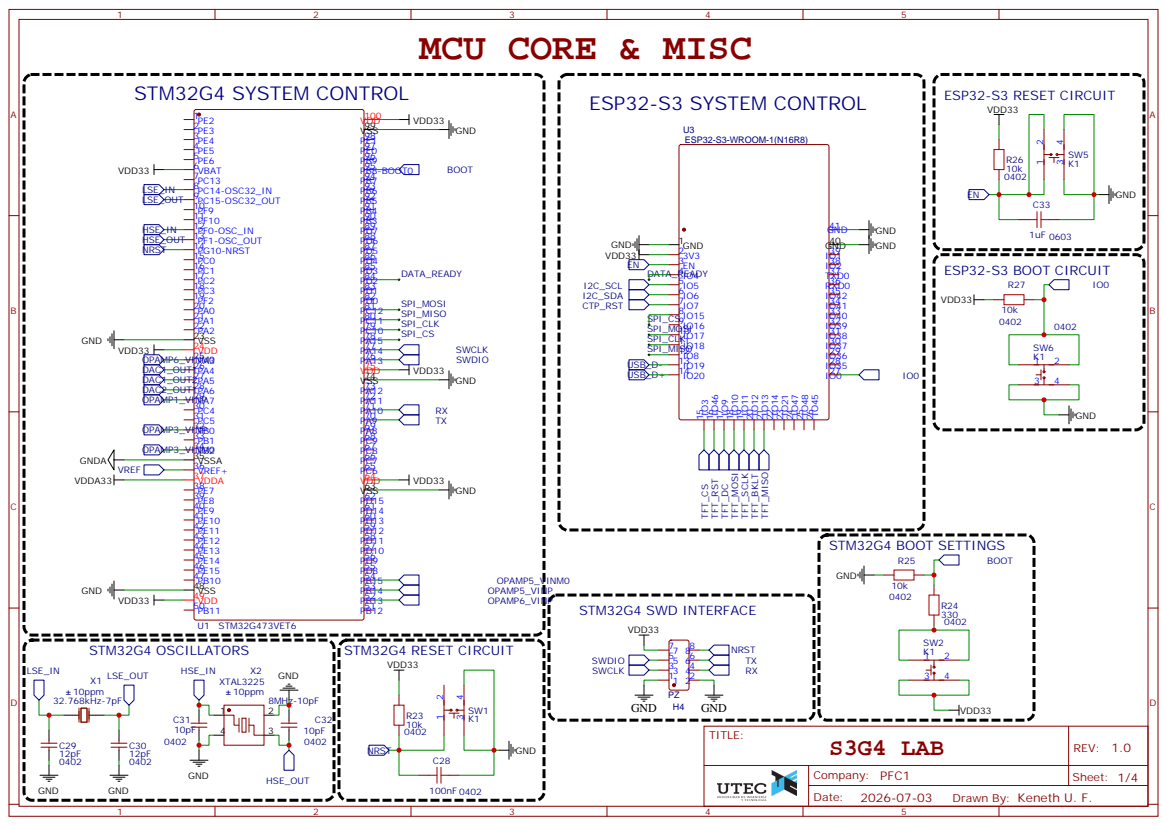
[picture p37: page 1]

# POWER & BATTERY CIRCUITS

3.3V LINEAR REGULATOR (LDO) | ESP32 DECOUPLING CAPACITORS

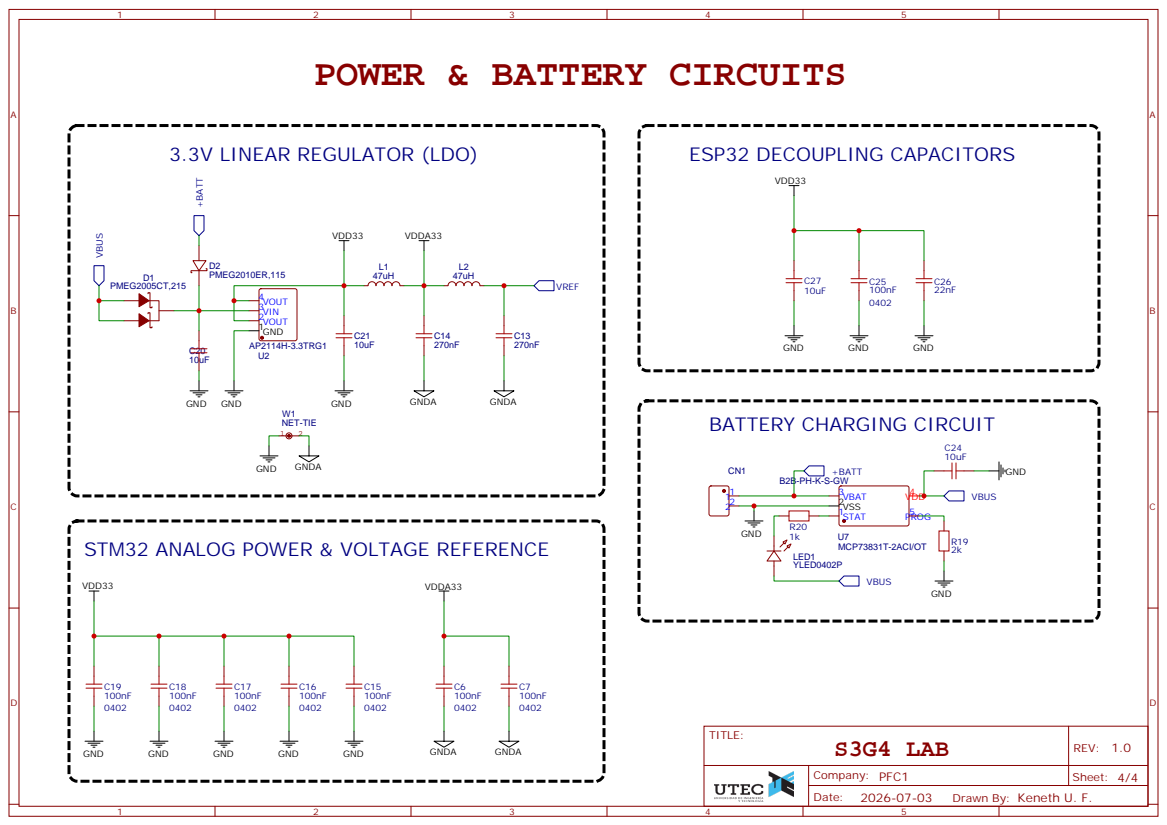
[picture p38: page 2]

STM32 ANALOG POWER & VOLTAGE REFERENCE

# SIGNAL ACQUISITION & FUNCTION GENERATION

# OSCILLOSCOPE ATTENUATOR & BUFFER

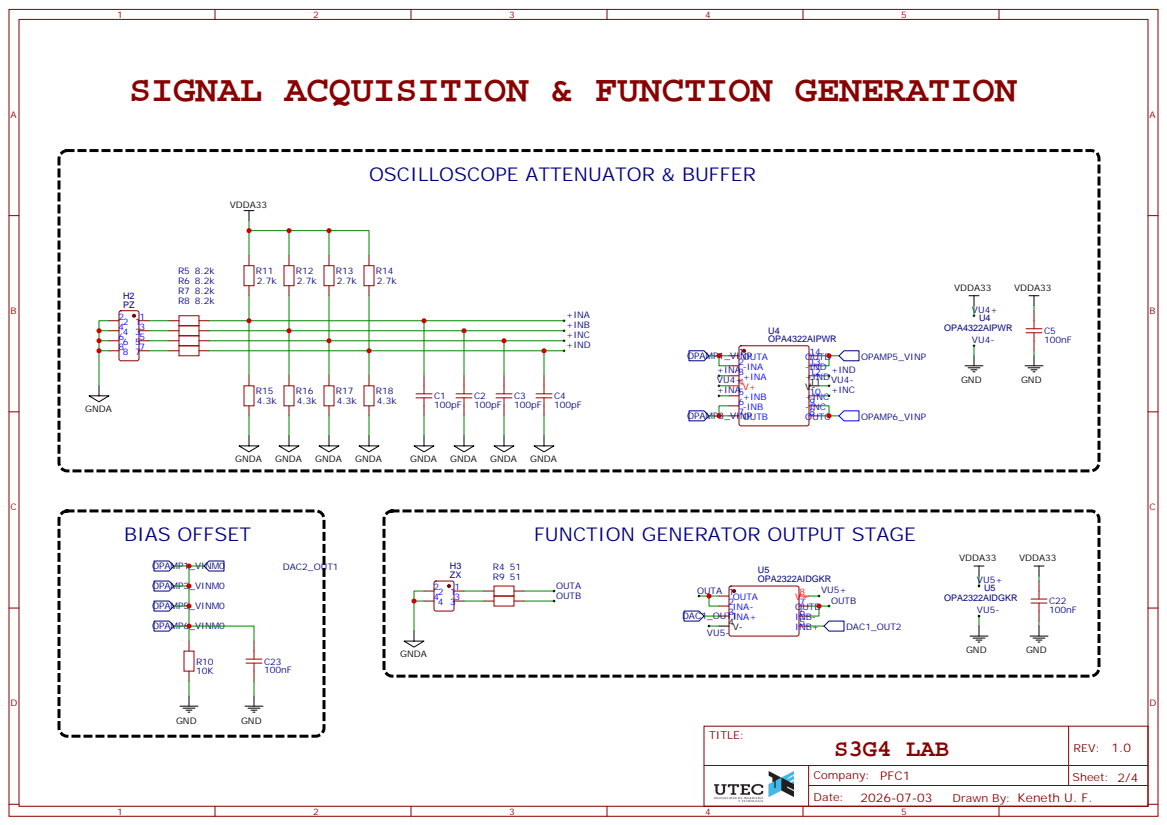
[picture p39: page 3]

+INC 10 V-11 +IND 12 -IND 13 OUTD 14
+IND

## COLOR 320X480 TFT Capacitive TOUCHSCREEN, ILI9488 FT6236

# DISPLAY & USER INTERFACE

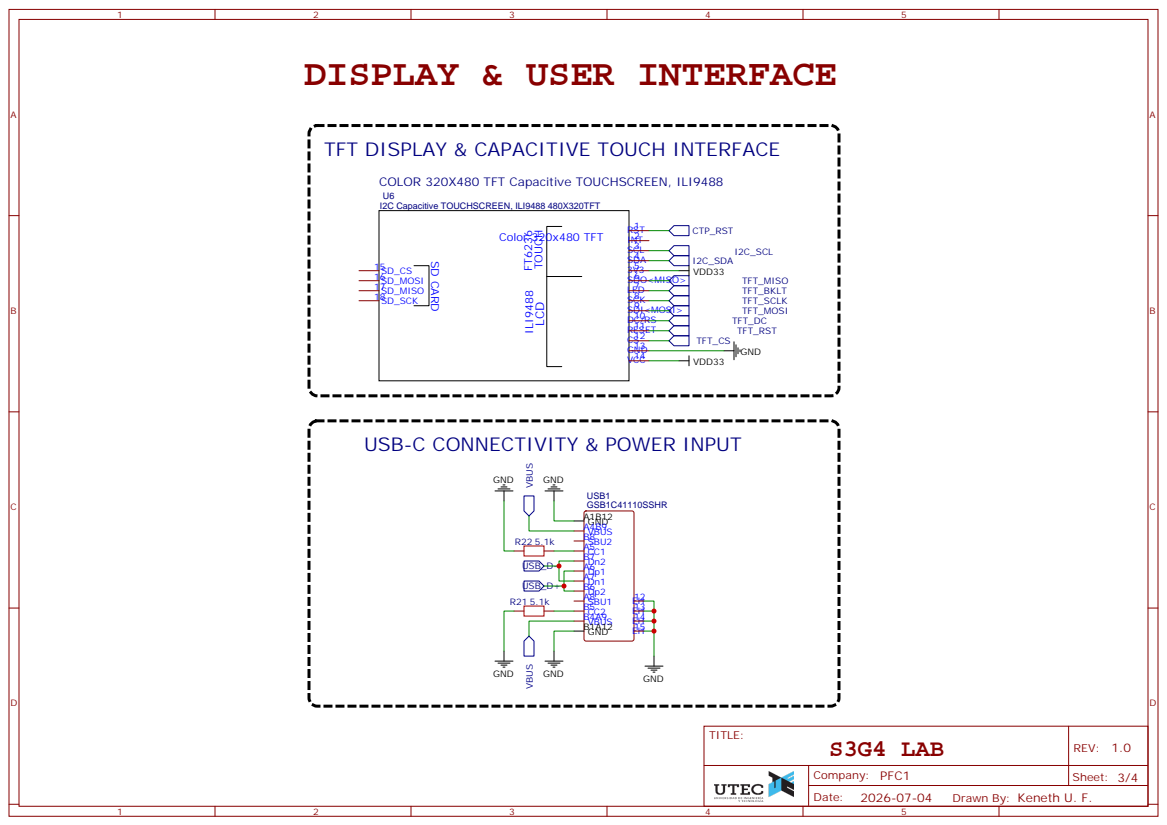
[picture p40: page 4]

TFT DISPLAY & CAPACITIVE TOUCH INTERFACE

USB-C CONNECTIVITY & POWER INPUT
