keneth-urbizagastegui/S3G4-LAB/S3G4_LAB_rev2.1/04_esquematicos/S10_CH23/s10_ch3.pdf

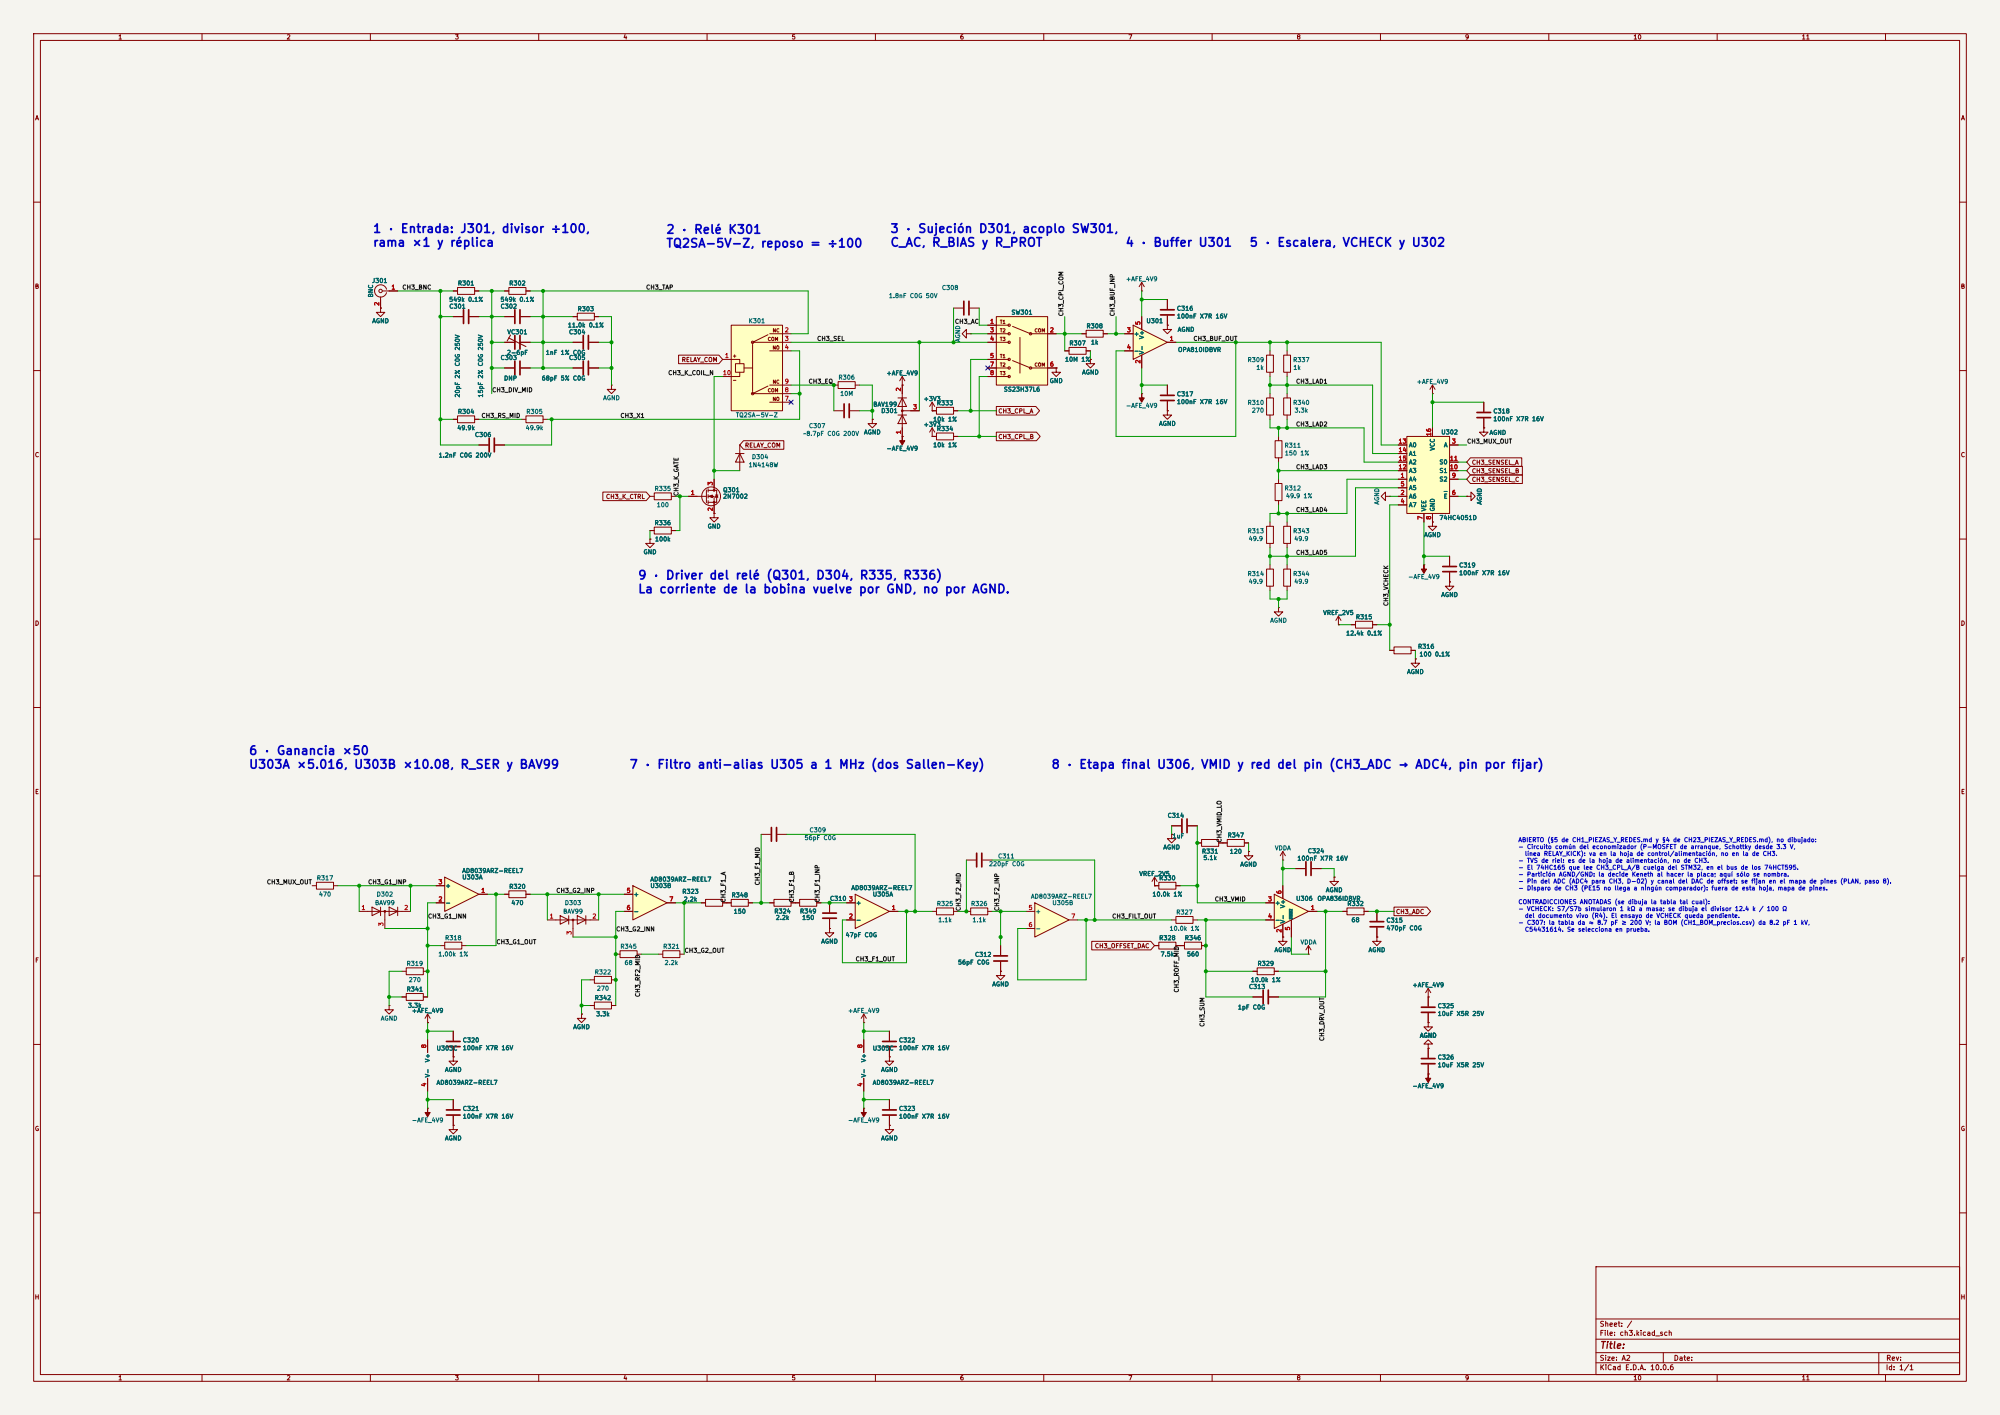
[picture p42: page 1]

T3 1 T1 T2 | COM

9 · Driver del relé (Q301, D304, R335, R336)
La corriente de la bobina vuelve por GND, no por AGND.

8 · Etapa final U306, VMID y red del pin (CH3_ADC → ADC4, pin por fijar)

ABIERTO (§5 de CH1_PIEZAS_Y_REDES.md y §4 de CH23_PIEZAS_Y_REDES.md), no dibujado: - Circuito común del economizador (P-MOSFET de arranque, Schottky desde 3.3 V, línea RELAY_KICK): va en la hoja de control/alimentación, no en la de CH3. - TVS de riel: es de la hoja de alimentación, no de CH3. - El 74HC165 que lee CH3_CPL_A/B cuelga del STM32, en el bus de los 74HCT595. - Partición AGND/GND: la decide Keneth al hacer la placa; aquí sólo se nombra. - Pin del ADC (ADC4 para CH3, D-02) y canal del DAC de offset: se fijan en el mapa de pines (PLAN, paso 8). - Disparo de CH3 (PE15 no llega a ningún comparador): fuera de esta hoja, mapa de pines. CONTRADICCIONES ANOTADAS (se dibuja la tabla tal cual): - VCHECK: S7/S7b simularon 1 kΩ a masa; se dibuja el divisor 12.4 k / 100 Ω

del documento vivo (R4). El ensayo de VCHECK queda pendiente. - C307: la tabla da ≈ 8.7 pF ≥ 200 V; la BOM (CH1_BOM_precios.csv) da 8.2 pF 1 kV, C54431614. Se selecciona en prueba.

Size: A2 | Rev:
KiCad E.D.A. 10.0.6 | Id: 1/1
