keneth-urbizagastegui/S3G4-LAB/S3G4_LAB_rev2.1/04_esquematicos/S8_CH1/s8_ch1.pdf

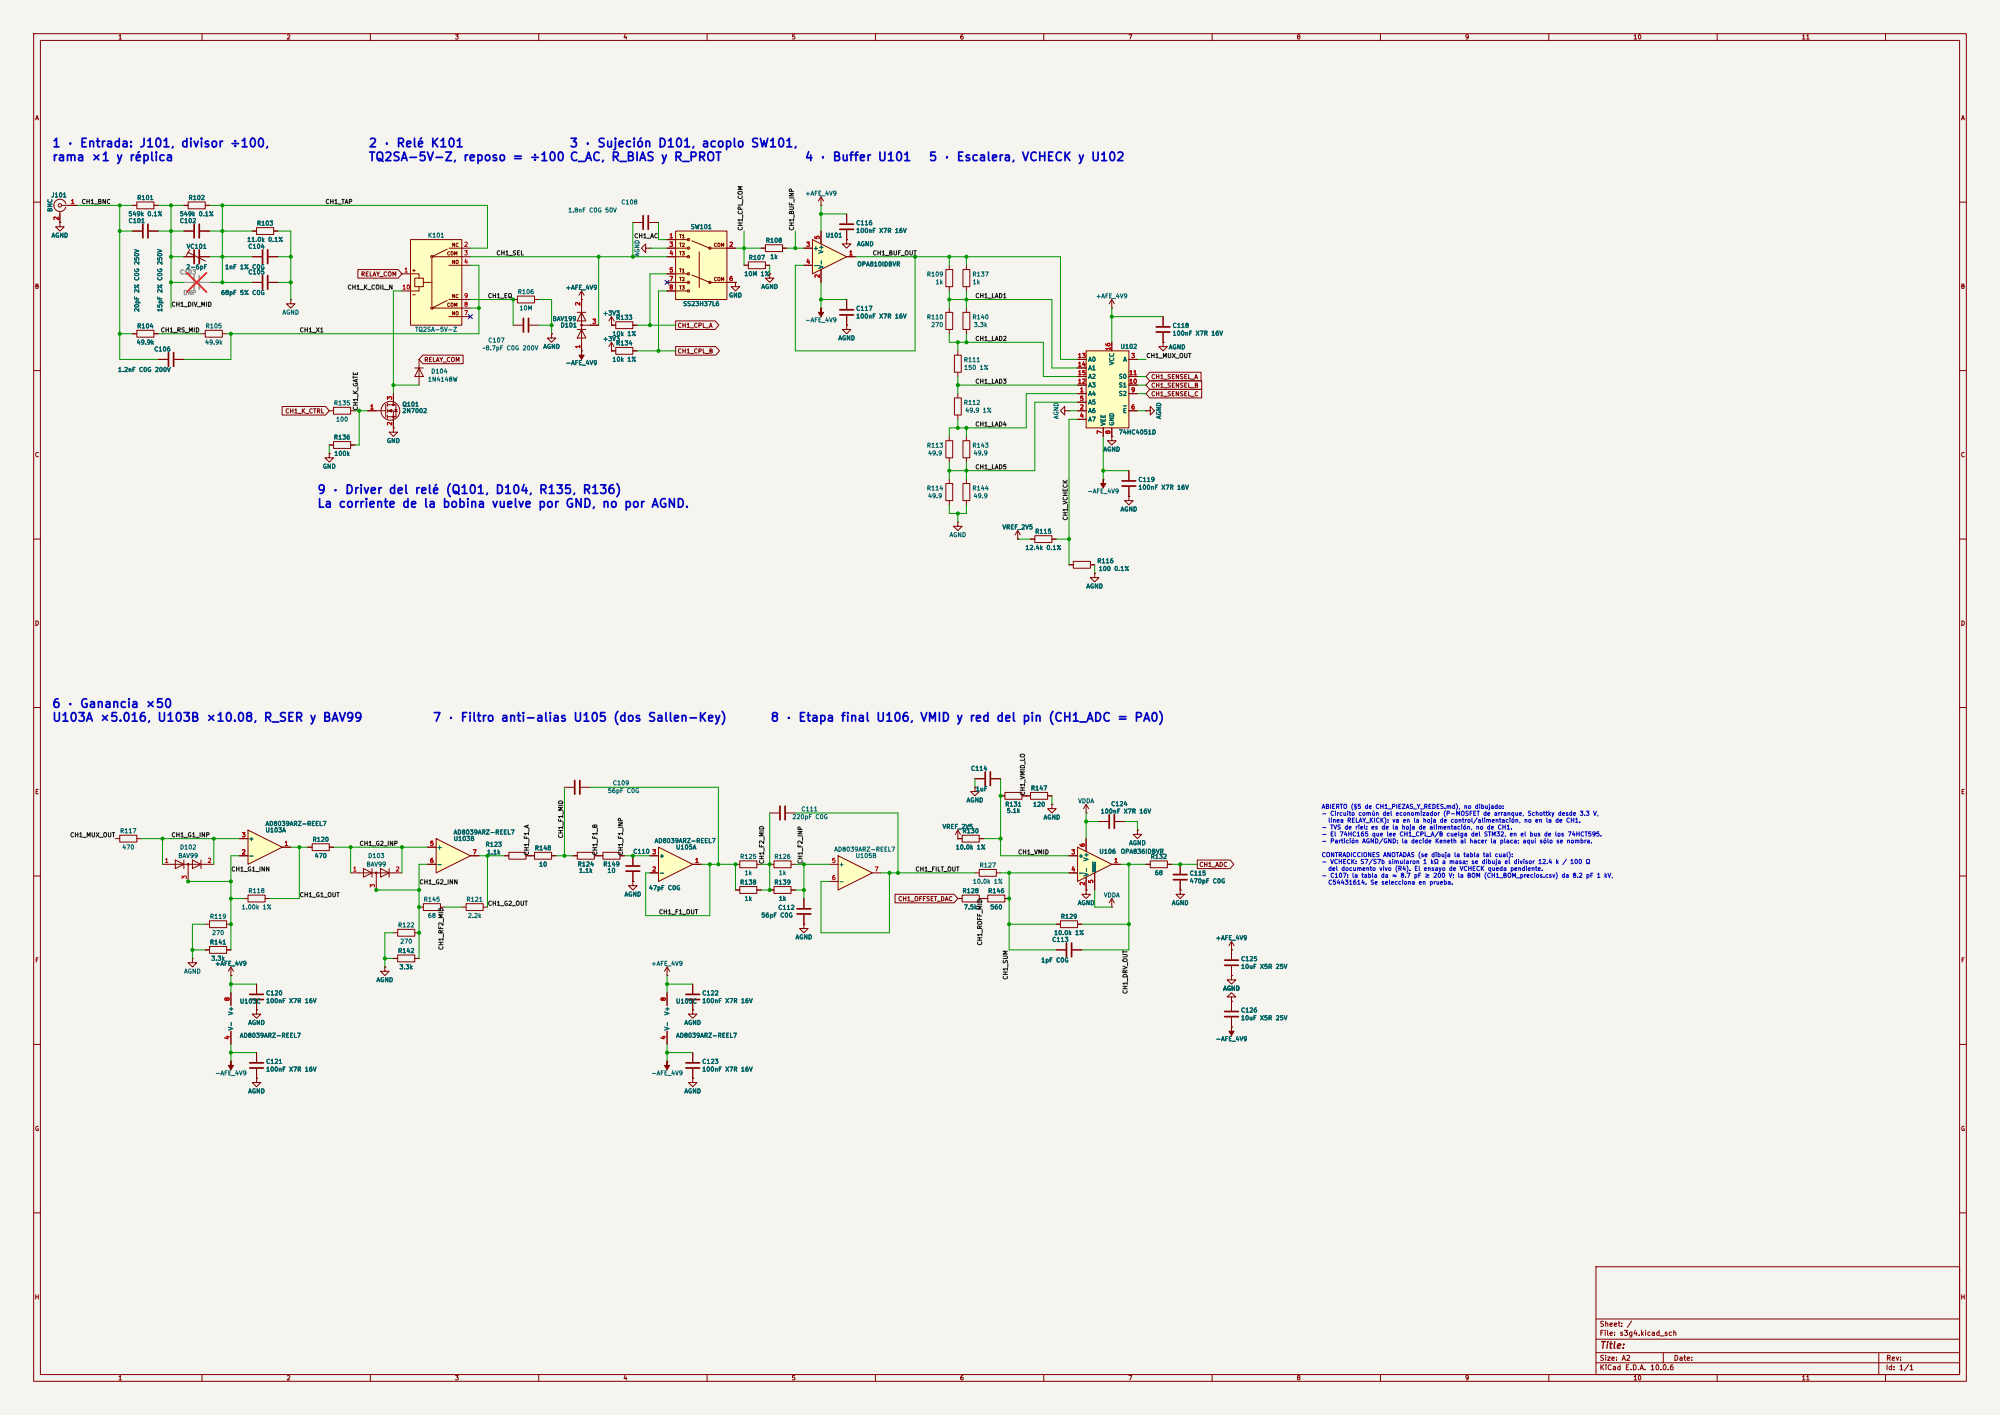
[picture p43: page 1]

GND
9 · Driver del relé (Q101, D104, R135, R136)
La corriente de la bobina vuelve por GND, no por AGND.

ABIERTO (§5 de CH1_PIEZAS_Y_REDES.md), no dibujado: - Circuito común del economizador (P-MOSFET de arranque, Schottky desde 3.3 V, línea RELAY_KICK): va en la hoja de control/alimentación, no en la de CH1. - TVS de riel: es de la hoja de alimentación, no de CH1. - El 74HC165 que lee CH1_CPL_A/B cuelga del STM32, en el bus de los 74HCT595. - Partición AGND/GND: la decide Keneth al hacer la placa; aquí sólo se nombra. CONTRADICCIONES ANOTADAS (se dibuja la tabla tal cual): - VCHECK: S7/S7b simularon 1 kΩ a masa; se dibuja el divisor 12.4 k / 100 Ω

del documento vivo (R4). El ensayo de VCHECK queda pendiente. - C107: la tabla da ≈ 8.7 pF ≥ 200 V; la BOM (CH1_BOM_precios.csv) da 8.2 pF 1 kV, C54431614. Se selecciona en prueba.

Size: A2 | Rev:
KiCad E.D.A. 10.0.6 | Id: 1/1
