keneth-urbizagastegui/S3G4-LAB/S3G4_LAB_rev2.1/04_esquematicos/kicad/ch2.kicad_sch

## KiCad design S3G4_LAB_rev2.1/04_esquematicos/kicad/ch2.kicad_sch (2026-10-07, an earlier design)

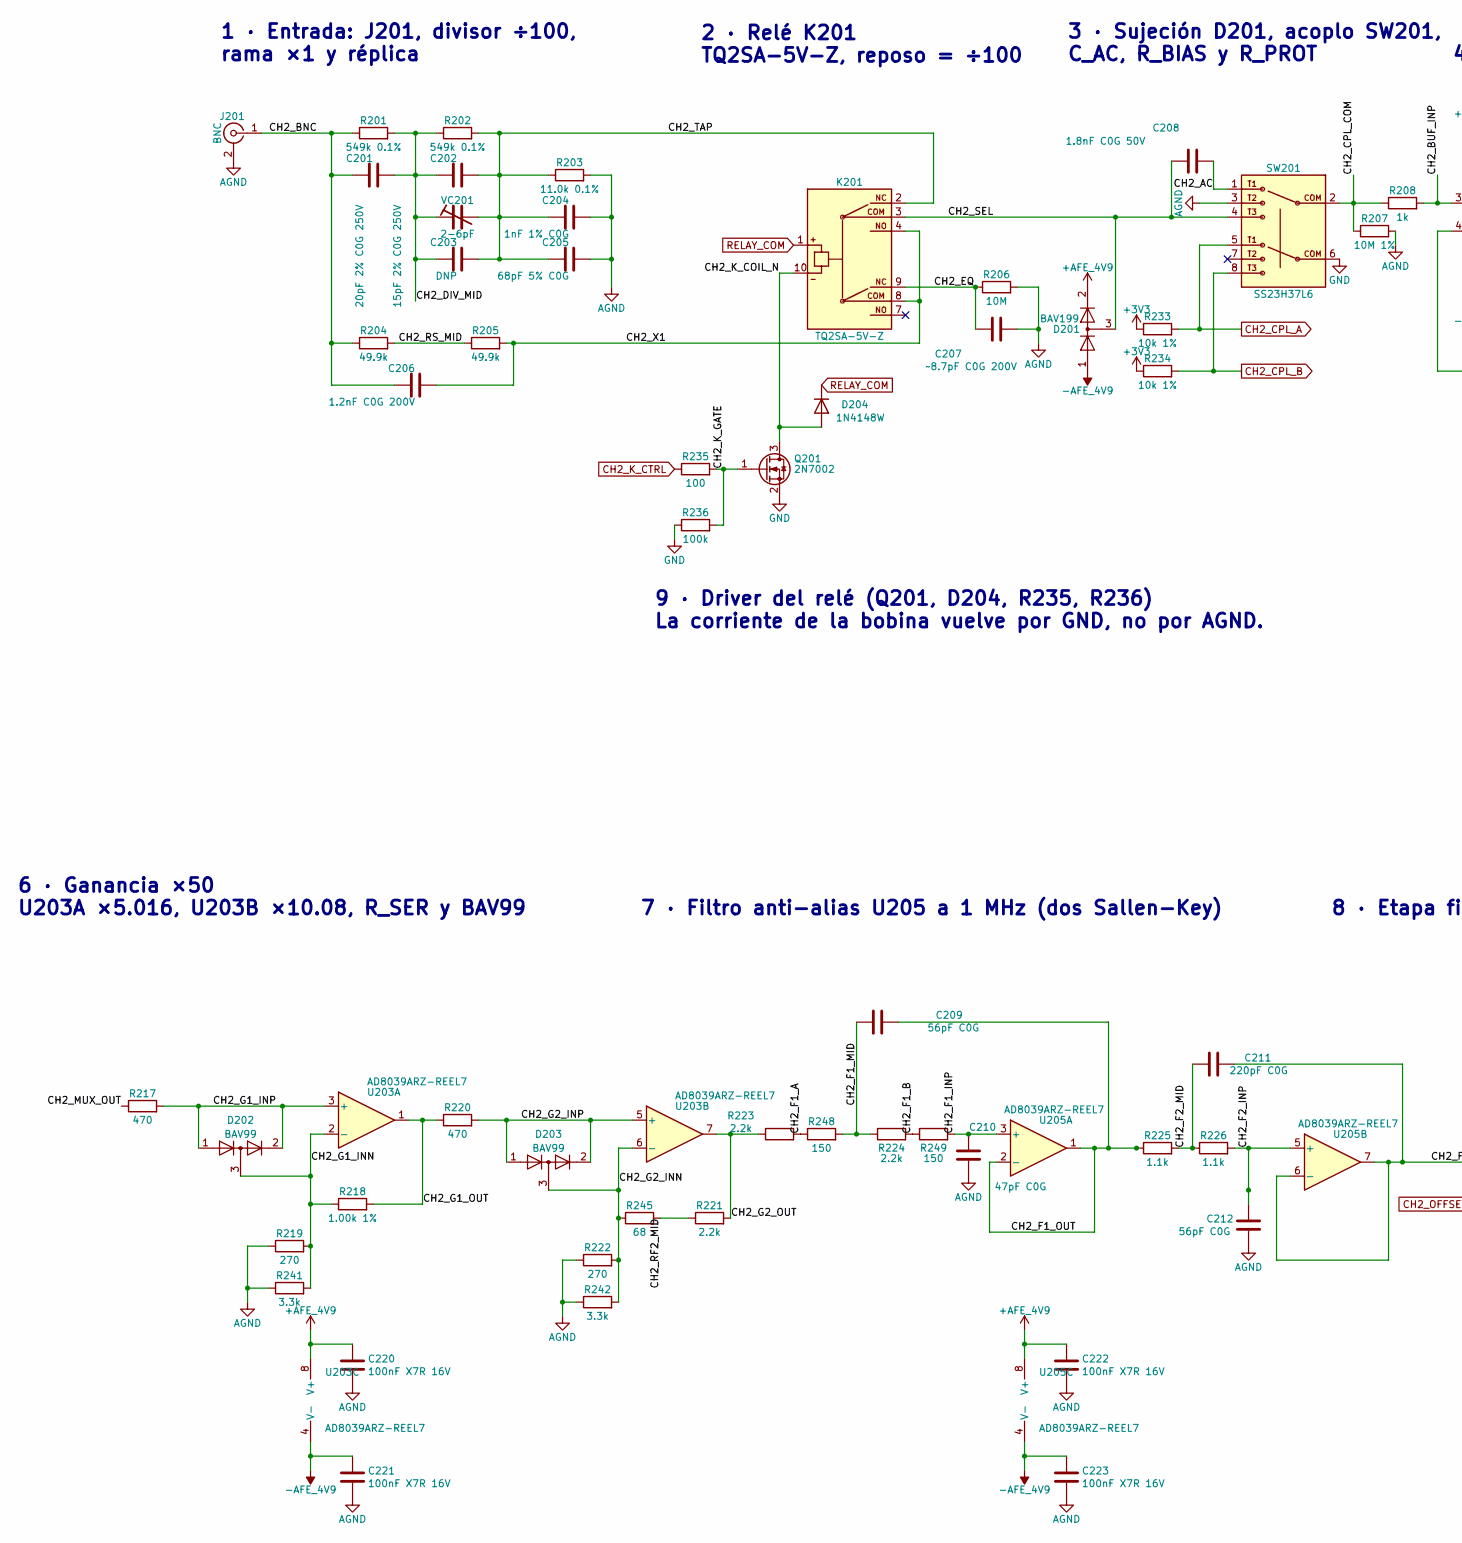
[picture p44: schematic ch2.kicad_sch, part in row 1, column 1]

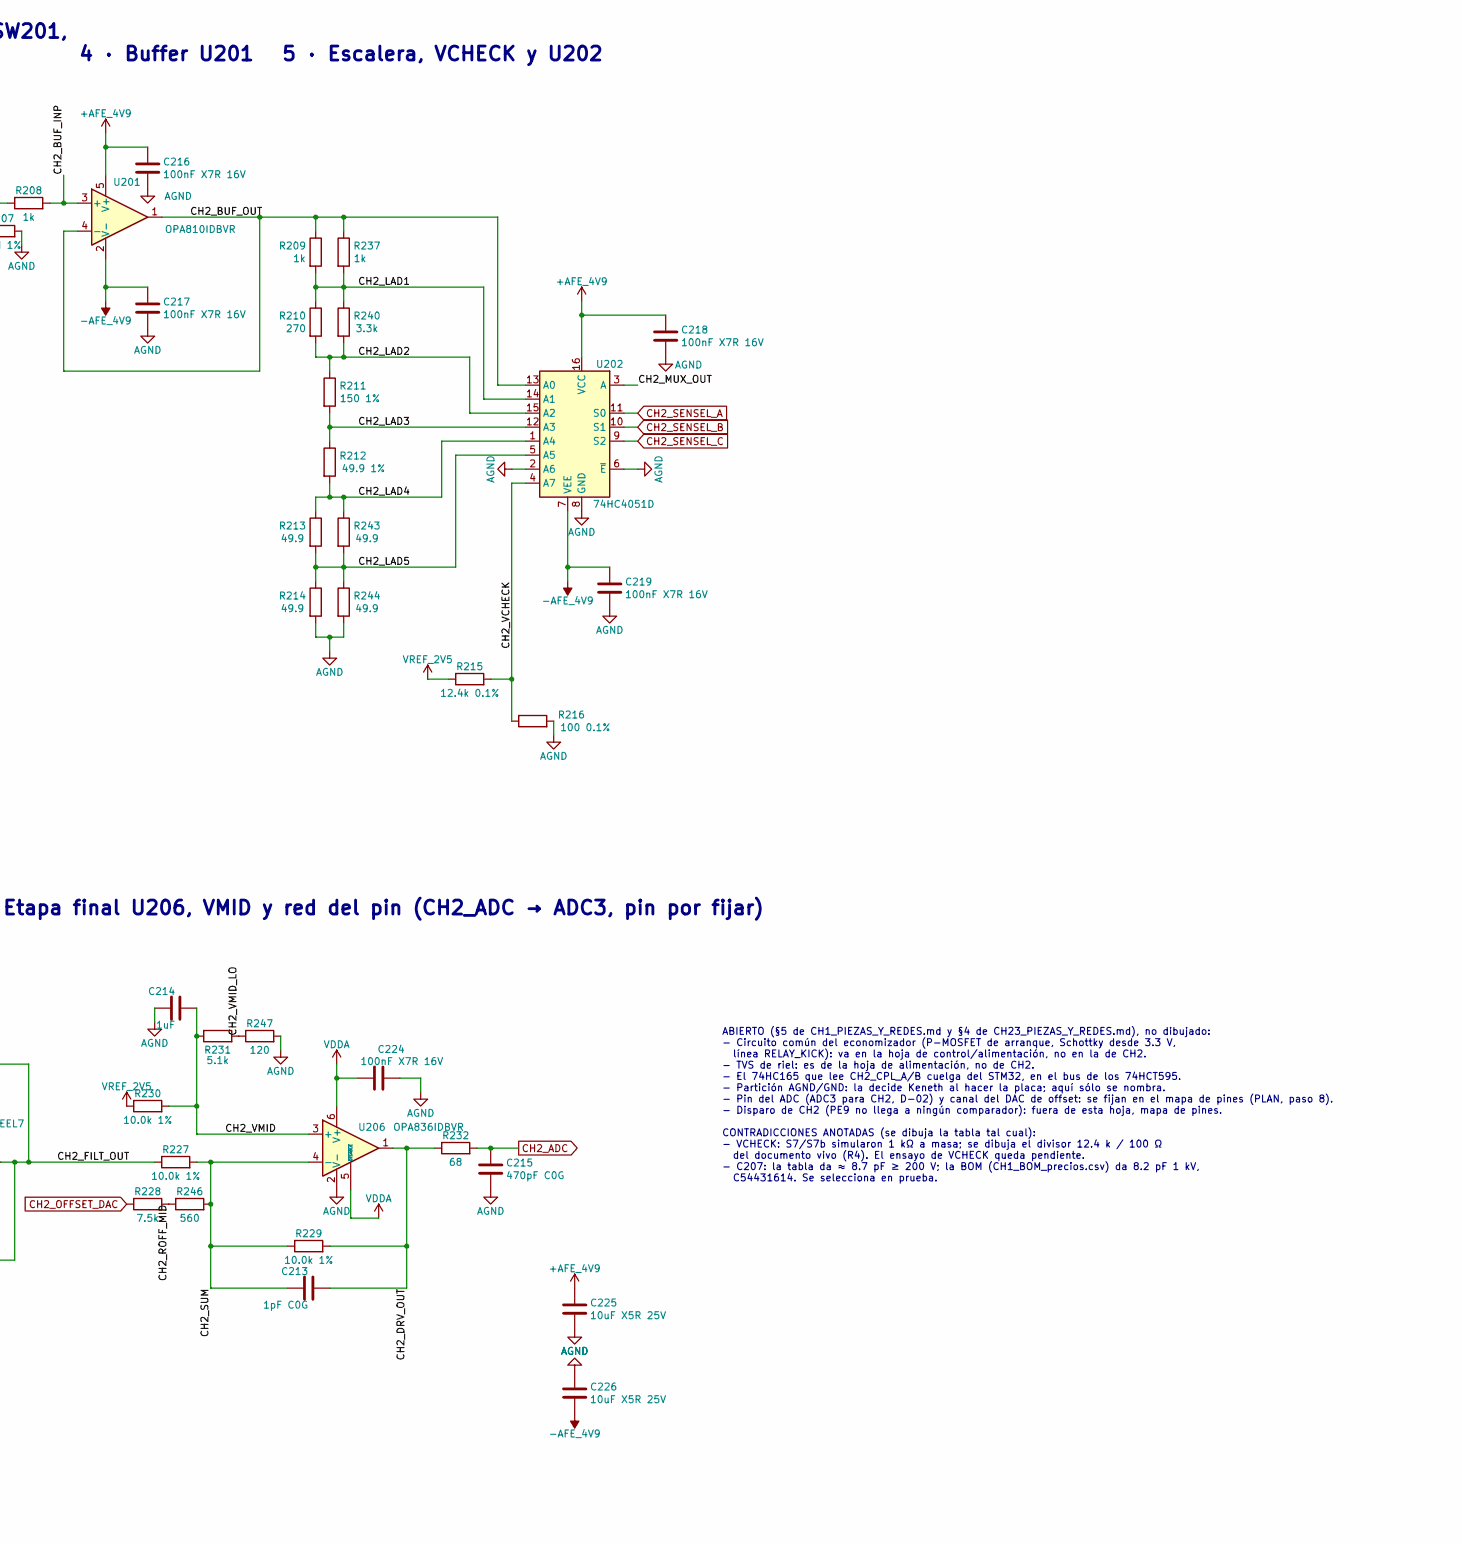
[picture p45: schematic ch2.kicad_sch, part in row 1, column 2]

Parts:
C201: 20pF 2% C0G 250V; C_0603_1608Metric; LCSC C3845779
C202: 15pF 2% C0G 250V; C_0805_2012Metric; LCSC C3836120
C203: DNP; C_0603_1608Metric
C204: 1nF 1% C0G; C_0603_1608Metric; LCSC C507408
C205: 68pF 5% C0G; C_0603_1608Metric; LCSC C28262
C206: 1.2nF C0G 200V; C_1206_3216Metric; LCSC C3851387
C207: ~8.7pF C0G 200V; C_1206_3216Metric; LCSC C54431614
C208: 1.8nF C0G 50V; C_0603_1608Metric; LCSC C97878
C209, C212: 56pF C0G; C_0603_1608Metric; LCSC C39148
C210: 47pF C0G; C_0603_1608Metric; LCSC C1671
C211: 220pF C0G; C_0603_1608Metric; LCSC C388907
C213: 1pF C0G; C_0603_1608Metric; LCSC C5137611
C214: 1uF; C_0603_1608Metric; LCSC C15849
C215: 470pF C0G; C_0603_1608Metric; LCSC C36252
C216, C217, C218, C219, C220, C221, C222, C223, C224: 100nF X7R 16V; C_0402_1005Metric; LCSC C1525
C225, C226: 10uF X5R 25V; C_0805_2012Metric; LCSC C15850
D201: BAV199; SOT-23; MPN BAV199; LCSC C40919
D202, D203: BAV99; SOT-23; MPN BAV99; LCSC C2500
D204: 1N4148W; D_SOD-123; MPN 1N4148W; LCSC C81598
J201: BNC; BNC_Kinghelm_KH-BNC50-3511_Horizontal; MPN KH-BNC50-3511; LCSC C2837587
K201: TQ2SA-5V-Z; Relay_Panasonic_TQ2SA_SMD; MPN TQ2SA-5V-Z; LCSC C22686
Q201: 2N7002; SOT-23; MPN 2N7002; LCSC C8545
R201, R202: 549k 0.1%; R_1206_3216Metric; MPN RT1206BRD07549KL; LCSC C870790
R203: 11.0k 0.1%; R_0805_2012Metric; MPN RT0805BRD0711KL; LCSC C865156
R204, R205: 49.9k; R_1206_3216Metric; LCSC C18017
R206: 10M; R_1206_3216Metric; LCSC C26119
R207: 10M 1%; R_0603_1608Metric; LCSC C7250
R208, R209, R237: 1k; R_0603_1608Metric; LCSC C21190
R210, R219, R222: 270; R_0603_1608Metric; LCSC C22966
R211: 150 1%; R_0603_1608Metric; LCSC C22808
R212: 49.9 1%; R_0603_1608Metric; LCSC C23185
R213, R214, R243, R244: 49.9; R_0603_1608Metric; LCSC C23185
R215: 12.4k 0.1%; R_0402_1005Metric; MPN RT0402BRE0712K4L; LCSC C853011
R216: 100 0.1%; R_0402_1005Metric; LCSC C332259
R217, R220: 470; R_0603_1608Metric; LCSC C23179
R218: 1.00k 1%; R_0603_1608Metric; LCSC C21190
R221, R223, R224: 2.2k; R_0603_1608Metric; LCSC C4190
R225, R226: 1.1k; R_0603_1608Metric; LCSC C22764
R227, R229, R230: 10.0k 1%; R_0603_1608Metric; LCSC C25804
R228: 7.5k; R_0603_1608Metric; LCSC C23234
R231: 5.1k; R_0603_1608Metric; LCSC C23186
R232, R245: 68; R_0603_1608Metric; LCSC C27592
R233, R234: 10k 1%; R_0603_1608Metric; LCSC C25804
R235: 100; R_0603_1608Metric; LCSC C22775
R236: 100k; R_0603_1608Metric; LCSC C25803
R240, R241, R242: 3.3k; R_0603_1608Metric; LCSC C22978
R246: 560; R_0603_1608Metric; LCSC C23204
R247: 120; R_0603_1608Metric; LCSC C22787
R248, R249: 150; R_0603_1608Metric; LCSC C22808
SW201: SS23H37L6; SW_Slide_DP3T_XKB_SS23H37; MPN SS23H37L6; LCSC C883267
U201: OPA810IDBVR; SOT-23-5; MPN OPA810IDBVR; LCSC C2833513
U202: 74HC4051D; SOIC-16_3.9x9.9mm_P1.27mm; MPN 74HC4051D; LCSC C9386
U203, U205: AD8039ARZ-REEL7; SOIC-8_3.9x4.9mm_P1.27mm; MPN AD8039ARZ-REEL7; LCSC C96525
U206: OPA836IDBVR; SOT-23-6; MPN OPA836IDBVR; LCSC C111589
VC201: 2-6pF; C_Trimmer_SEHWA_STC3MA06_3.2x4.5mm; LCSC C22468120

Connections:
+3V3: R233.1, R234.1
+AFE_4V9: C216.1, C218.1, C220.1, C222.1, C225.1, D201.2 (A), U201.5 (V+), U202.16 (VCC), U203.8 (V+), U205.8 (V+)
-AFE_4V9: C217.1, C219.1, C221.1, C223.1, C226.2, D201.1 (K), U201.2 (V-), U202.7 (VEE), U203.4 (V-), U205.4 (V-)
AGND: C204.2, C205.2, C207.2, C210.2, C212.2, C214.1, C215.2, C216.2, C217.2, C218.2, C219.2, C220.2, C221.2, C222.2, C223.2, C224.2, C225.2, C226.1, J201.2 (Ext), R203.2, R206.2, R207.2, R214.2, R216.2, R219.1, R222.1, R241.1, R242.1, R244.2, R247.2, SW201.3 (T2), U202.2 (A6), U202.6 (~E), U202.8 (GND), U206.2 (V-)
CH2_AC: C208.2, SW201.1 (T1)
CH2_ADC: C215.1, R232.2
CH2_BNC: C201.1, C206.1, J201.1 (In), R201.1, R204.1
CH2_BUF_INP: R208.2, U201.3 (+)
CH2_BUF_OUT: R209.1, R237.1, U201.1, U201.4 (-), U202.13 (A0)
CH2_CPL_A: R233.2, SW201.5 (T1)
CH2_CPL_B: R234.2, SW201.8 (T3)
CH2_CPL_COM: R207.1, R208.1, SW201.2 (COM)
CH2_DIV_MID: C201.2, C202.1, C203.1, R201.2, R202.1, VC201.1
CH2_DRV_OUT: C213.2, R229.2, R232.1, U206.1
CH2_EQ: C207.1, K201.9 (NC), R206.1
CH2_F1_A: R223.2, R248.1
CH2_F1_B: R224.2, R249.1
CH2_F1_INP: C210.1, R249.2, U205.3 (+)
CH2_F1_MID: C209.1, R224.1, R248.2
CH2_F1_OUT: C209.2, R225.1, U205.1, U205.2 (-)
CH2_F2_INP: C212.1, R226.2, U205.5 (+)
CH2_F2_MID: C211.1, R225.2, R226.1
CH2_FILT_OUT: C211.2, R227.1, U205.6 (-), U205.7
CH2_G1_INN: D202.3 (K), R218.1, R219.2, R241.2, U203.2 (-)
CH2_G1_INP: D202.1 (K), D202.2 (A), R217.2, U203.3 (+)
CH2_G1_OUT: R218.2, R220.1, U203.1
CH2_G2_INN: D203.3 (K), R222.2, R242.2, R245.1, U203.6 (-)
CH2_G2_INP: D203.1 (K), D203.2 (A), R220.2, U203.5 (+)
CH2_G2_OUT: R221.2, R223.1, U203.7
CH2_K_COIL_N: D204.2 (A), K201.10 (-), Q201.3 (D)
CH2_K_CTRL: R235.1
CH2_K_GATE: Q201.1 (G), R235.2, R236.2
CH2_LAD1: R209.2, R210.1, R237.2, R240.1, U202.14 (A1)
CH2_LAD2: R210.2, R211.1, R240.2, U202.15 (A2)
CH2_LAD3: R211.2, R212.1, U202.12 (A3)
CH2_LAD4: R212.2, R213.1, R243.1, U202.1 (A4)
CH2_LAD5: R213.2, R214.1, R243.2, R244.1, U202.5 (A5)
CH2_MUX_OUT: R217.1, U202.3 (A)
CH2_OFFSET_DAC: R228.1
CH2_RF2_MID: R221.1, R245.2
CH2_ROFF_MID: R228.2, R246.1
CH2_RS_MID: R204.2, R205.1
CH2_SEL: C208.1, D201.3 (K), K201.3 (COM), SW201.4 (T3)
CH2_SENSEL_A: U202.11 (S0)
CH2_SENSEL_B: U202.10 (S1)
CH2_SENSEL_C: U202.9 (S2)
CH2_SUM: C213.1, R227.2, R229.1, R246.2, U206.4 (-)
CH2_TAP: C202.2, C203.2, C204.1, C205.1, K201.2 (NC), R202.2, R203.1, VC201.2
CH2_VCHECK: R215.2, R216.1, U202.4 (A7)
CH2_VMID: C214.2, R230.2, R231.1, U206.3 (+)
CH2_VMID_LO: R231.2, R247.1
CH2_X1: C206.2, K201.4 (NO), K201.8 (COM), R205.2
GND: Q201.2 (S), R236.1, SW201.6 (COM)
RELAY_COM: D204.1 (K), K201.1 (+)
VDDA: C224.1, U206.5 (~DISABLE), U206.6 (V+)
VREF_2V5: R215.1, R230.1

Notes on the sheet:
9 · Driver del relé (Q201, D204, R235, R236) La corriente de la bobina vuelve por GND, no por AGND.
7 · Filtro anti-alias U205 a 1 MHz (dos Sallen-Key)
4 · Buffer U201
ABIERTO (§5 de CH1_PIEZAS_Y_REDES.md y §4 de CH23_PIEZAS_Y_REDES.md), no dibujado: - Circuito común del economizador (P-MOSFET de arranque, Schottky desde 3.3 V, línea RELAY_KICK): va en la hoja de control/alimentación, no en la de CH2. - TVS de riel: es de la hoja de alimentación, no de CH2. - El 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
1 · Entrada: J201, divisor ÷100, rama ×1 y réplica
3 · Sujeción D201, acoplo SW201, C_AC, R_BIAS y R_PROT
2 · Relé K201 TQ2SA-5V-Z, reposo = ÷100
5 · Escalera, VCHECK y U202
6 · Ganancia ×50 U203A ×5.016, U203B ×10.08, R_SER y BAV99
8 · Etapa final U206, VMID y red del pin (CH2_ADC → ADC3, pin por fijar)
