keneth-urbizagastegui/S3G4-LAB/S3G4_LAB_rev2.1/04_esquematicos/kicad/ch3.kicad_sch

## KiCad design S3G4_LAB_rev2.1/04_esquematicos/kicad/ch3.kicad_sch (2026-10-07, an earlier design)

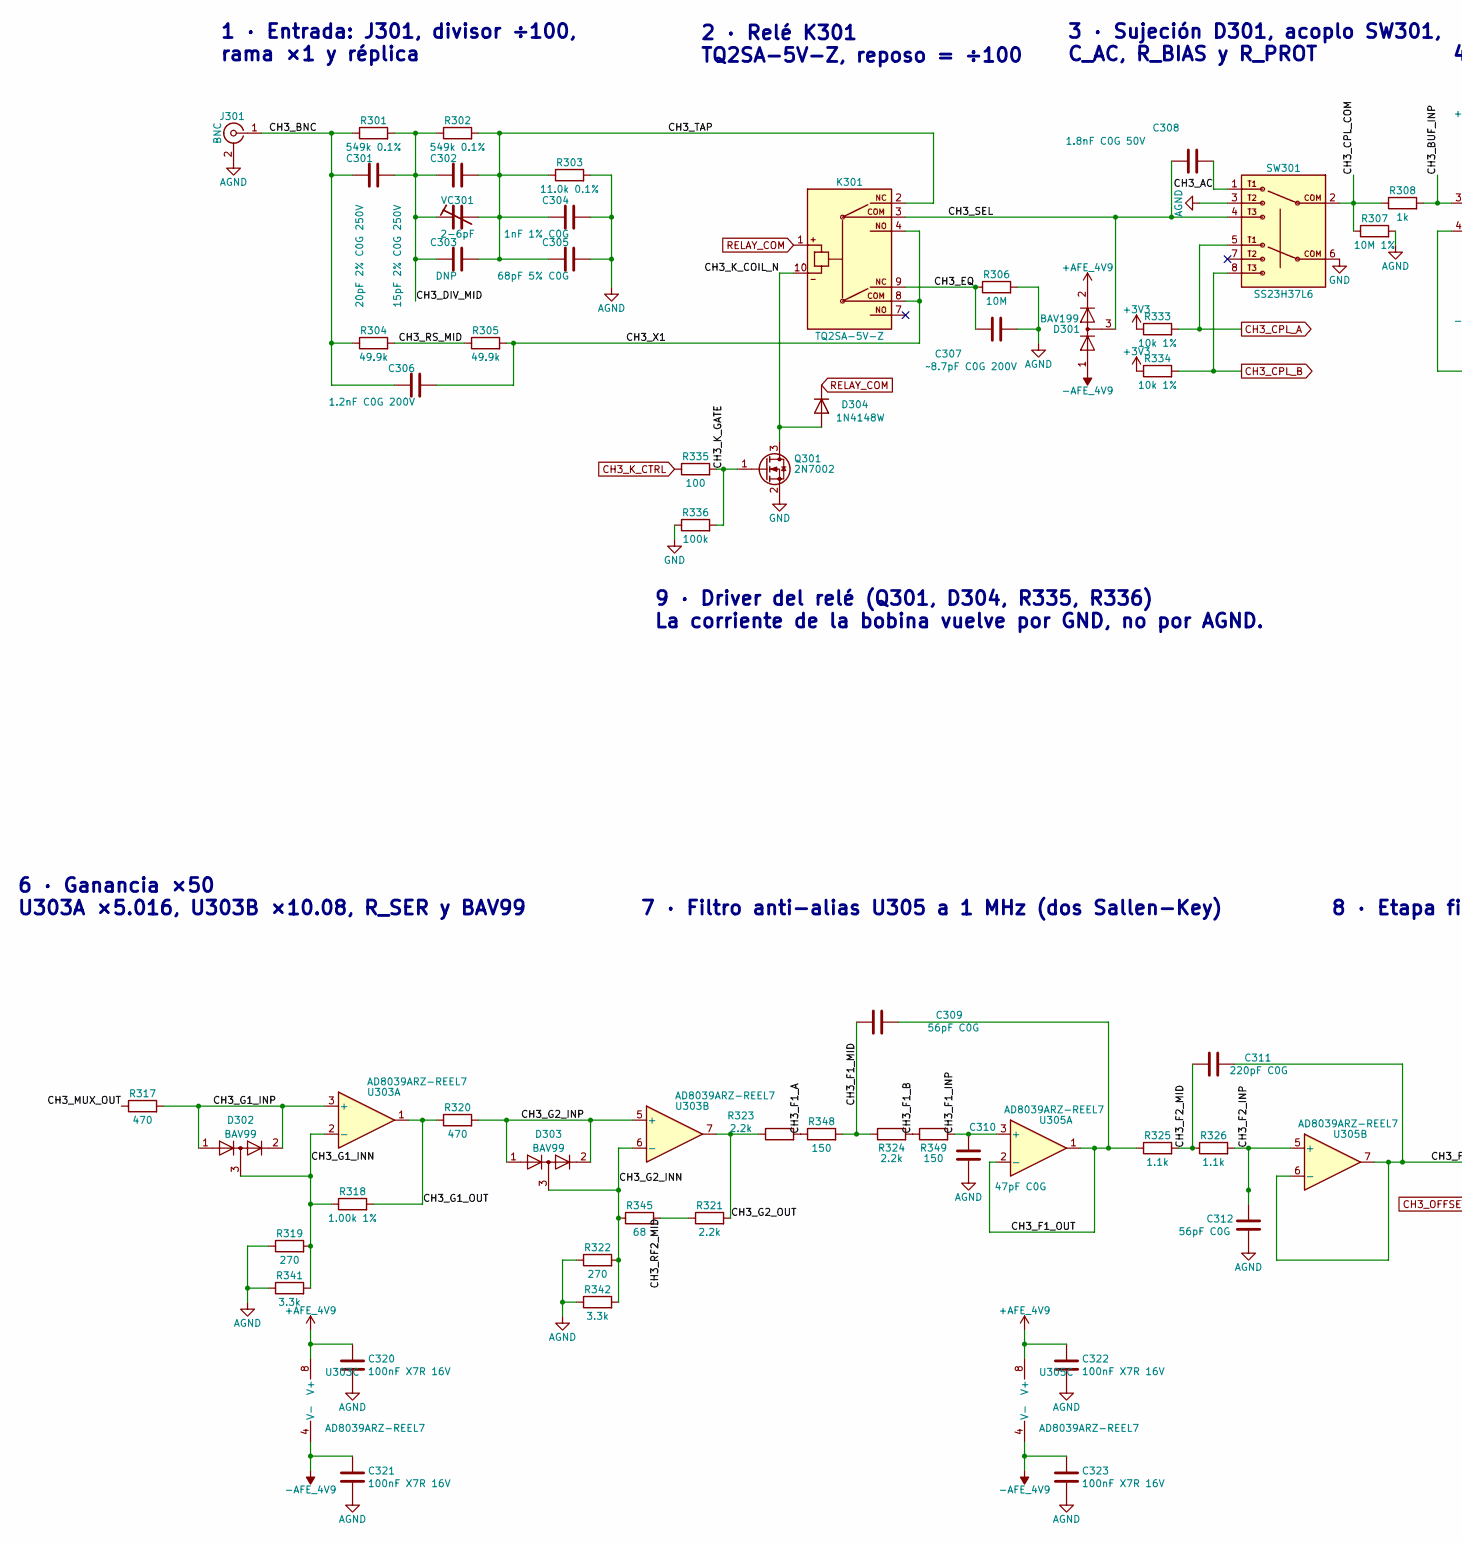
[picture p46: schematic ch3.kicad_sch, part in row 1, column 1]

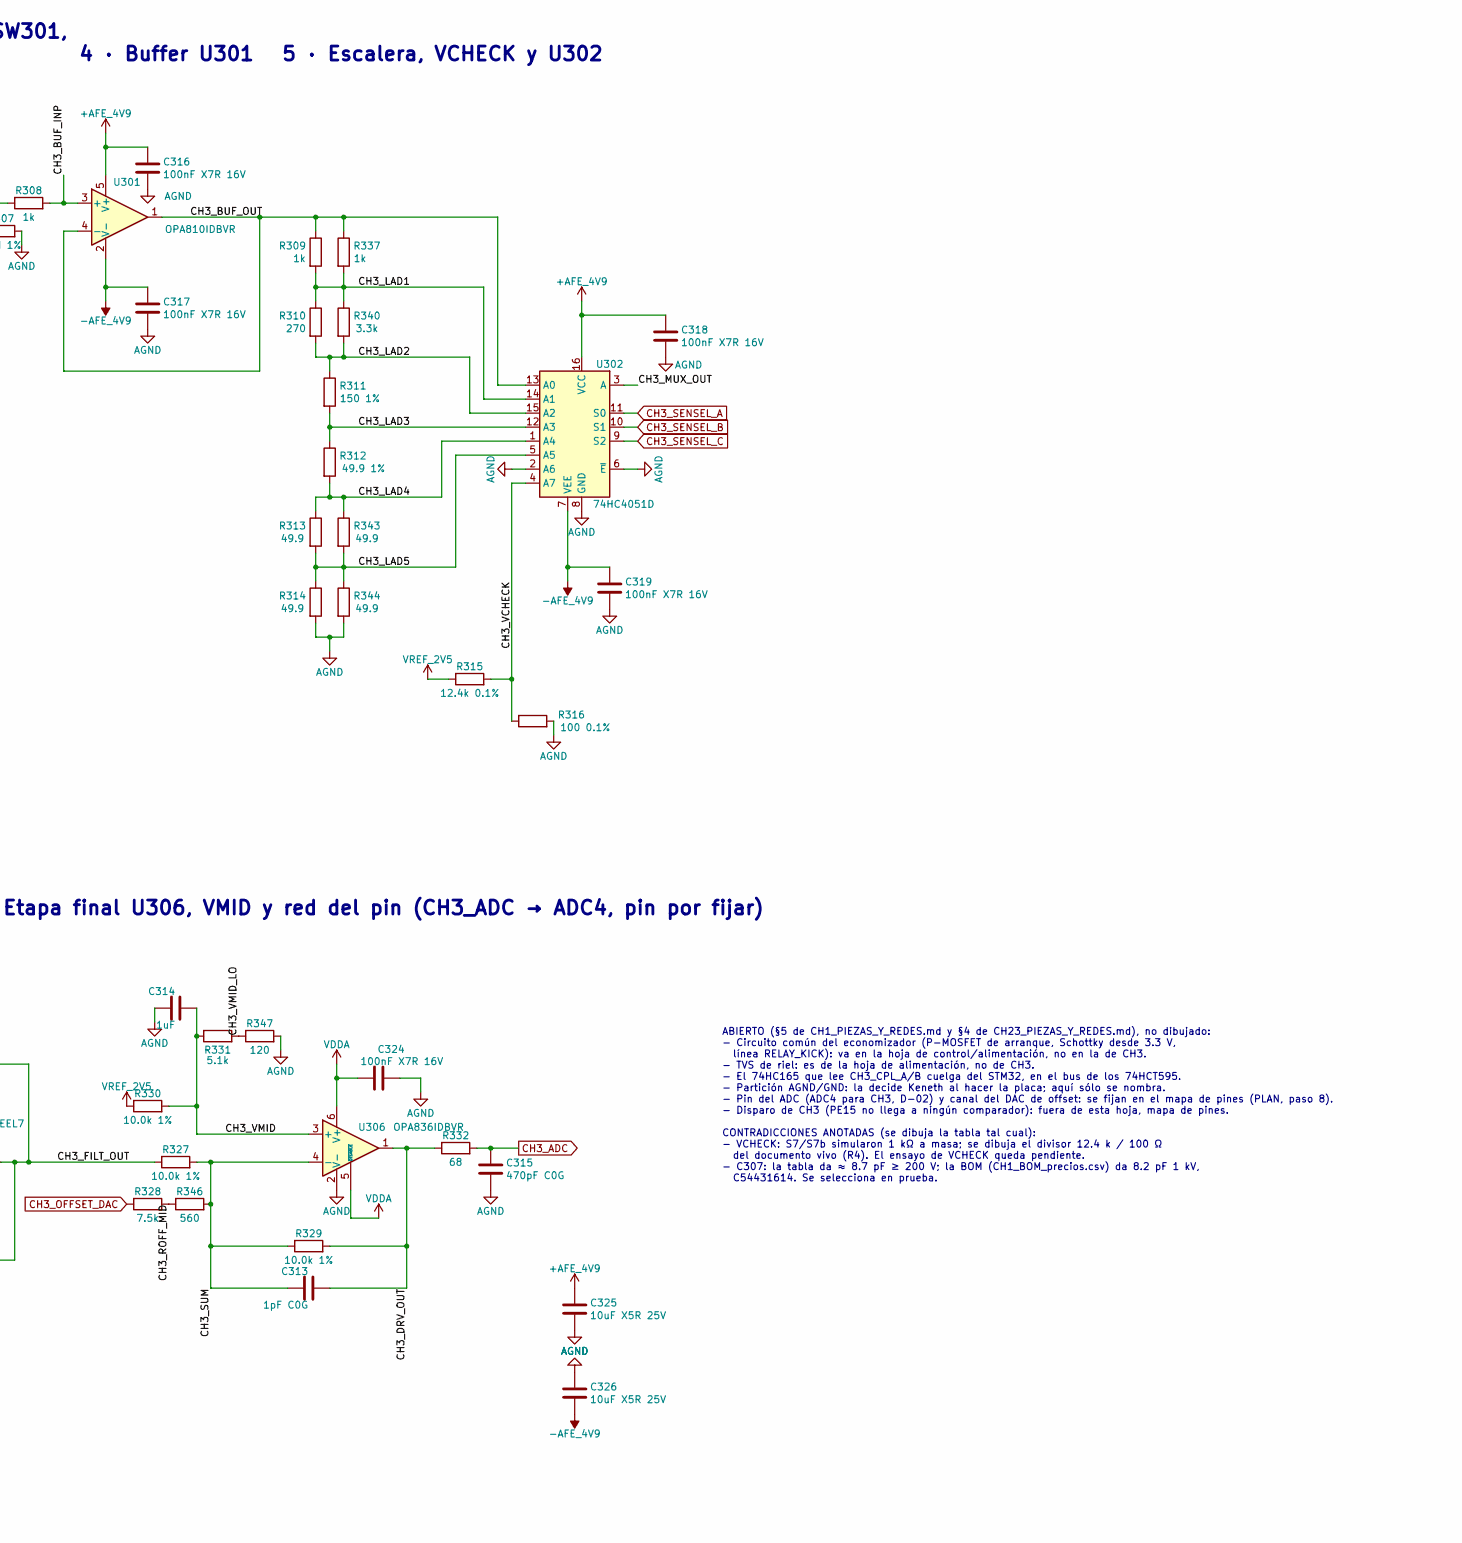
[picture p47: schematic ch3.kicad_sch, part in row 1, column 2]

Parts:
C301: 20pF 2% C0G 250V; C_0603_1608Metric; LCSC C3845779
C302: 15pF 2% C0G 250V; C_0805_2012Metric; LCSC C3836120
C303: DNP; C_0603_1608Metric
C304: 1nF 1% C0G; C_0603_1608Metric; LCSC C507408
C305: 68pF 5% C0G; C_0603_1608Metric; LCSC C28262
C306: 1.2nF C0G 200V; C_1206_3216Metric; LCSC C3851387
C307: ~8.7pF C0G 200V; C_1206_3216Metric; LCSC C54431614
C308: 1.8nF C0G 50V; C_0603_1608Metric; LCSC C97878
C309, C312: 56pF C0G; C_0603_1608Metric; LCSC C39148
C310: 47pF C0G; C_0603_1608Metric; LCSC C1671
C311: 220pF C0G; C_0603_1608Metric; LCSC C388907
C313: 1pF C0G; C_0603_1608Metric; LCSC C5137611
C314: 1uF; C_0603_1608Metric; LCSC C15849
C315: 470pF C0G; C_0603_1608Metric; LCSC C36252
C316, C317, C318, C319, C320, C321, C322, C323, C324: 100nF X7R 16V; C_0402_1005Metric; LCSC C1525
C325, C326: 10uF X5R 25V; C_0805_2012Metric; LCSC C15850
D301: BAV199; SOT-23; MPN BAV199; LCSC C40919
D302, D303: BAV99; SOT-23; MPN BAV99; LCSC C2500
D304: 1N4148W; D_SOD-123; MPN 1N4148W; LCSC C81598
J301: BNC; BNC_Kinghelm_KH-BNC50-3511_Horizontal; MPN KH-BNC50-3511; LCSC C2837587
K301: TQ2SA-5V-Z; Relay_Panasonic_TQ2SA_SMD; MPN TQ2SA-5V-Z; LCSC C22686
Q301: 2N7002; SOT-23; MPN 2N7002; LCSC C8545
R301, R302: 549k 0.1%; R_1206_3216Metric; MPN RT1206BRD07549KL; LCSC C870790
R303: 11.0k 0.1%; R_0805_2012Metric; MPN RT0805BRD0711KL; LCSC C865156
R304, R305: 49.9k; R_1206_3216Metric; LCSC C18017
R306: 10M; R_1206_3216Metric; LCSC C26119
R307: 10M 1%; R_0603_1608Metric; LCSC C7250
R308, R309, R337: 1k; R_0603_1608Metric; LCSC C21190
R310, R319, R322: 270; R_0603_1608Metric; LCSC C22966
R311: 150 1%; R_0603_1608Metric; LCSC C22808
R312: 49.9 1%; R_0603_1608Metric; LCSC C23185
R313, R314, R343, R344: 49.9; R_0603_1608Metric; LCSC C23185
R315: 12.4k 0.1%; R_0402_1005Metric; MPN RT0402BRE0712K4L; LCSC C853011
R316: 100 0.1%; R_0402_1005Metric; LCSC C332259
R317, R320: 470; R_0603_1608Metric; LCSC C23179
R318: 1.00k 1%; R_0603_1608Metric; LCSC C21190
R321, R323, R324: 2.2k; R_0603_1608Metric; LCSC C4190
R325, R326: 1.1k; R_0603_1608Metric; LCSC C22764
R327, R329, R330: 10.0k 1%; R_0603_1608Metric; LCSC C25804
R328: 7.5k; R_0603_1608Metric; LCSC C23234
R331: 5.1k; R_0603_1608Metric; LCSC C23186
R332, R345: 68; R_0603_1608Metric; LCSC C27592
R333, R334: 10k 1%; R_0603_1608Metric; LCSC C25804
R335: 100; R_0603_1608Metric; LCSC C22775
R336: 100k; R_0603_1608Metric; LCSC C25803
R340, R341, R342: 3.3k; R_0603_1608Metric; LCSC C22978
R346: 560; R_0603_1608Metric; LCSC C23204
R347: 120; R_0603_1608Metric; LCSC C22787
R348, R349: 150; R_0603_1608Metric; LCSC C22808
SW301: SS23H37L6; SW_Slide_DP3T_XKB_SS23H37; MPN SS23H37L6; LCSC C883267
U301: OPA810IDBVR; SOT-23-5; MPN OPA810IDBVR; LCSC C2833513
U302: 74HC4051D; SOIC-16_3.9x9.9mm_P1.27mm; MPN 74HC4051D; LCSC C9386
U303, U305: AD8039ARZ-REEL7; SOIC-8_3.9x4.9mm_P1.27mm; MPN AD8039ARZ-REEL7; LCSC C96525
U306: OPA836IDBVR; SOT-23-6; MPN OPA836IDBVR; LCSC C111589
VC301: 2-6pF; C_Trimmer_SEHWA_STC3MA06_3.2x4.5mm; LCSC C22468120

Connections:
+3V3: R333.1, R334.1
+AFE_4V9: C316.1, C318.1, C320.1, C322.1, C325.1, D301.2 (A), U301.5 (V+), U302.16 (VCC), U303.8 (V+), U305.8 (V+)
-AFE_4V9: C317.1, C319.1, C321.1, C323.1, C326.2, D301.1 (K), U301.2 (V-), U302.7 (VEE), U303.4 (V-), U305.4 (V-)
AGND: C304.2, C305.2, C307.2, C310.2, C312.2, C314.1, C315.2, C316.2, C317.2, C318.2, C319.2, C320.2, C321.2, C322.2, C323.2, C324.2, C325.2, C326.1, J301.2 (Ext), R303.2, R306.2, R307.2, R314.2, R316.2, R319.1, R322.1, R341.1, R342.1, R344.2, R347.2, SW301.3 (T2), U302.2 (A6), U302.6 (~E), U302.8 (GND), U306.2 (V-)
CH3_AC: C308.2, SW301.1 (T1)
CH3_ADC: C315.1, R332.2
CH3_BNC: C301.1, C306.1, J301.1 (In), R301.1, R304.1
CH3_BUF_INP: R308.2, U301.3 (+)
CH3_BUF_OUT: R309.1, R337.1, U301.1, U301.4 (-), U302.13 (A0)
CH3_CPL_A: R333.2, SW301.5 (T1)
CH3_CPL_B: R334.2, SW301.8 (T3)
CH3_CPL_COM: R307.1, R308.1, SW301.2 (COM)
CH3_DIV_MID: C301.2, C302.1, C303.1, R301.2, R302.1, VC301.1
CH3_DRV_OUT: C313.2, R329.2, R332.1, U306.1
CH3_EQ: C307.1, K301.9 (NC), R306.1
CH3_F1_A: R323.2, R348.1
CH3_F1_B: R324.2, R349.1
CH3_F1_INP: C310.1, R349.2, U305.3 (+)
CH3_F1_MID: C309.1, R324.1, R348.2
CH3_F1_OUT: C309.2, R325.1, U305.1, U305.2 (-)
CH3_F2_INP: C312.1, R326.2, U305.5 (+)
CH3_F2_MID: C311.1, R325.2, R326.1
CH3_FILT_OUT: C311.2, R327.1, U305.6 (-), U305.7
CH3_G1_INN: D302.3 (K), R318.1, R319.2, R341.2, U303.2 (-)
CH3_G1_INP: D302.1 (K), D302.2 (A), R317.2, U303.3 (+)
CH3_G1_OUT: R318.2, R320.1, U303.1
CH3_G2_INN: D303.3 (K), R322.2, R342.2, R345.1, U303.6 (-)
CH3_G2_INP: D303.1 (K), D303.2 (A), R320.2, U303.5 (+)
CH3_G2_OUT: R321.2, R323.1, U303.7
CH3_K_COIL_N: D304.2 (A), K301.10 (-), Q301.3 (D)
CH3_K_CTRL: R335.1
CH3_K_GATE: Q301.1 (G), R335.2, R336.2
CH3_LAD1: R309.2, R310.1, R337.2, R340.1, U302.14 (A1)
CH3_LAD2: R310.2, R311.1, R340.2, U302.15 (A2)
CH3_LAD3: R311.2, R312.1, U302.12 (A3)
CH3_LAD4: R312.2, R313.1, R343.1, U302.1 (A4)
CH3_LAD5: R313.2, R314.1, R343.2, R344.1, U302.5 (A5)
CH3_MUX_OUT: R317.1, U302.3 (A)
CH3_OFFSET_DAC: R328.1
CH3_RF2_MID: R321.1, R345.2
CH3_ROFF_MID: R328.2, R346.1
CH3_RS_MID: R304.2, R305.1
CH3_SEL: C308.1, D301.3 (K), K301.3 (COM), SW301.4 (T3)
CH3_SENSEL_A: U302.11 (S0)
CH3_SENSEL_B: U302.10 (S1)
CH3_SENSEL_C: U302.9 (S2)
CH3_SUM: C313.1, R327.2, R329.1, R346.2, U306.4 (-)
CH3_TAP: C302.2, C303.2, C304.1, C305.1, K301.2 (NC), R302.2, R303.1, VC301.2
CH3_VCHECK: R315.2, R316.1, U302.4 (A7)
CH3_VMID: C314.2, R330.2, R331.1, U306.3 (+)
CH3_VMID_LO: R331.2, R347.1
CH3_X1: C306.2, K301.4 (NO), K301.8 (COM), R305.2
GND: Q301.2 (S), R336.1, SW301.6 (COM)
RELAY_COM: D304.1 (K), K301.1 (+)
VDDA: C324.1, U306.5 (~DISABLE), U306.6 (V+)
VREF_2V5: R315.1, R330.1

Notes on the sheet:
9 · Driver del relé (Q301, D304, R335, R336) La corriente de la bobina vuelve por GND, no por AGND.
7 · Filtro anti-alias U305 a 1 MHz (dos Sallen-Key)
4 · Buffer U301
ABIERTO (§5 de CH1_PIEZAS_Y_REDES.md y §4 de CH23_PIEZAS_Y_REDES.md), no dibujado: - Circuito común del economizador (P-MOSFET de arranque, Schottky desde 3.3 V, línea RELAY_KICK): va en la hoja de control/alimentación, no en la de CH3. - TVS de riel: es de la hoja de alimentación, no de CH3. - El 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
1 · Entrada: J301, divisor ÷100, rama ×1 y réplica
3 · Sujeción D301, acoplo SW301, C_AC, R_BIAS y R_PROT
2 · Relé K301 TQ2SA-5V-Z, reposo = ÷100
5 · Escalera, VCHECK y U302
6 · Ganancia ×50 U303A ×5.016, U303B ×10.08, R_SER y BAV99
8 · Etapa final U306, VMID y red del pin (CH3_ADC → ADC4, pin por fijar)
