keneth-urbizagastegui/S3G4-LAB/firmware/stm32_firmware/Core/Src/main.c

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
/* Includes ------------------------------------------------------------------*/
#include "main.h"
#include "adc.h"
#include "dac.h"
#include "dma.h"
#include "opamp.h"
#include "spi.h"
#include "tim.h"
#include "gpio.h"

/* USER CODE BEGIN Includes */
#include "scope.h"
#include "wavegen.h"
#include "comm_spi.h"
#include "stm32g4xx_ll_adc.h"
/* USER CODE END Includes */


/* USER CODE BEGIN PV */
#define ADC_BUFFER_LEN (512)
uint16_t buffer1[ADC_BUFFER_LEN];
uint16_t buffer2[ADC_BUFFER_LEN];
uint16_t buffer3[ADC_BUFFER_LEN];
uint16_t buffer4[ADC_BUFFER_LEN];
uint16_t buffer5[ADC_BUFFER_LEN];
uint16_t buffer6[ADC_BUFFER_LEN];
uint16_t buffer7[ADC_BUFFER_LEN];
uint16_t buffer8[ADC_BUFFER_LEN];

#define DAC_BUFFER_LEN (512)
uint16_t dac1_buffer[DAC_BUFFER_LEN];
uint16_t dac2_buffer[DAC_BUFFER_LEN];

tScope scope;
tWaveGen wavegen;
/* USER CODE END PV */

void SystemClock_Config(void);
/* USER CODE BEGIN 0 */
static void scope_force_trigger(tScope *pThis) {
    if (pThis->state == SCOPE_STATE_WAIT_FOR_CONVERSION_COMPLETE ||
        pThis->state == SCOPE_STATE_WAIT_FOR_ARM ||
        pThis->state == SCOPE_STATE_WAIT_FOR_TRIGGER) {
        
        // Clear relevant TIM interrupts and flags
        __HAL_TIM_CLEAR_IT(pThis->horizontal.htim_stop, TIM_IT_CC1);
        __HAL_TIM_CLEAR_IT(pThis->horizontal.htim_stop, TIM_IT_CC2);
        __HAL_TIM_CLEAR_IT(pThis->horizontal.htim_stop, TIM_IT_UPDATE);
        __HAL_TIM_CLEAR_FLAG(pThis->horizontal.htim_stop, TIM_FLAG_CC1);
        __HAL_TIM_CLEAR_FLAG(pThis->horizontal.htim_stop, TIM_FLAG_CC2);
        __HAL_TIM_CLEAR_FLAG(pThis->horizontal.htim_stop, TIM_FLAG_UPDATE);

        // Start the horizontal timer for triggering
        HAL_TIM_Base_Start(pThis->horizontal.htim_stop);
        HAL_TIM_OnePulse_Start_IT(pThis->horizontal.htim_stop, TIM_CHANNEL_1);

        // Disable ADC analog watchdogs
        LL_ADC_DisableIT_AWD1(pThis->trigger.hadc1->Instance);
        LL_ADC_DisableIT_AWD2(pThis->trigger.hadc1->Instance);

        // Transition the scope state to waiting for stop
        pThis->state = SCOPE_STATE_WAIT_FOR_STOP;
    }
}
/* USER CODE END 0 */

/**
  * @brief  The application entry point.
  * @retval int
  */
int main(void)
{

  /* MCU Configuration--------------------------------------------------------*/

  /* Reset of all peripherals, Initializes the Flash interface and the Systick. */
  HAL_Init();

  /* Configure the system clock */
  SystemClock_Config();

  /* Initialize all configured peripherals */
  MX_GPIO_Init();
  MX_DMA_Init();
  MX_ADC1_Init();
  MX_OPAMP1_Init();
  MX_OPAMP3_Init();
  MX_OPAMP5_Init();
  MX_OPAMP6_Init();
  MX_ADC3_Init();
  MX_ADC4_Init();
  MX_ADC5_Init();
  MX_SPI3_Init();
  MX_DAC1_Init();
  MX_TIM2_Init();
  MX_TIM3_Init();
  MX_DAC2_Init();
  MX_TIM4_Init();
  MX_TIM6_Init();
  /* USER CODE BEGIN 2 */
  pScope = &scope;

  // Initialize scope library and link hardware drivers
  scope_init_ll(&scope,
      &htim2,   // clock timer
      &htim3,   // stop timer (one-pulse)
      &hdac2,   // offset DAC (DAC2_OUT1)
      &hopamp1, // PGA Channel 1
      &hopamp3, // PGA Channel 2
      &hopamp5, // PGA Channel 3
      &hopamp6, // PGA Channel 4
      &hadc1,   // ADC Channel 1 (VOPAMP1)
      &hadc3,   // ADC Channel 2 (VOPAMP3)
      &hadc5,   // ADC Channel 3 (VOPAMP5)
      &hadc4    // ADC Channel 4 (VOPAMP6)
  );

  // Bind memory buffers for double-buffering
  scope_init(&scope,
      buffer1, buffer2, buffer3, buffer4,
      buffer5, buffer6, buffer7, buffer8,
      ADC_BUFFER_LEN
  );

  // Set default configurations
  scope_config_horizontal(&scope, 0, 100); // offset = 0, scale = 100kHz
  scope_config_vertical(&scope, 2048, 0, 0, 0, 0); // offset = 1.65V, all gains to x2 (index 0)
  
  scope.vertical.enable1 = 1;
  scope.vertical.scale1 = 0; // gain index 0
  scope.vertical.offset1 = 192; // display midpoint
  
  scope_config_trigger(&scope, 0, 0, 2048, 0); // CH1, Auto mode, level 2048, Rising edge

  // Initialize wave generator (DDS)
  wavegen_init_ll(&wavegen, &hdac1, &htim4, &htim6);
  wavegen_init(&wavegen, dac1_buffer, dac2_buffer, DAC_BUFFER_LEN);
  
  wavegen_config_horizontal(&wavegen, WAVEGEN_CHANNEL_1, 1000); // 1 kHz
  wavegen_config_vertical(&wavegen, WAVEGEN_CHANNEL_1, WAVEGEN_TYPE_SINE, 1551, 1551, 0);
  wavegen_config_horizontal(&wavegen, WAVEGEN_CHANNEL_2, 1000); // 1 kHz
  wavegen_config_vertical(&wavegen, WAVEGEN_CHANNEL_2, WAVEGEN_TYPE_SINE, 1551, 1551, 0);

  // Initialize SPI Slave communication with ESP32-S3
  comm_spi_init(&hspi3);
  /* USER CODE END 2 */

  /* Infinite loop */
  /* USER CODE BEGIN WHILE */
  tScopeState prev_state = SCOPE_STATE_IDLE;
  uint32_t capture_start_tick = 0;

  while (1)
  {
      // Process commands received from ESP32-S3
      comm_spi_process_cmd(&scope, &wavegen);

      // Detect start of capture to record timestamp
      if (scope.state != SCOPE_STATE_IDLE && prev_state == SCOPE_STATE_IDLE) {
          capture_start_tick = HAL_GetTick();
      }
      prev_state = scope.state;

      // Auto trigger timeout (100 ms)
      if (scope.trigger.mode == 0) { // AUTO Mode
          if (scope.state == SCOPE_STATE_WAIT_FOR_CONVERSION_COMPLETE ||
              scope.state == SCOPE_STATE_WAIT_FOR_ARM ||
              scope.state == SCOPE_STATE_WAIT_FOR_TRIGGER) {
              if (HAL_GetTick() - capture_start_tick > 100) {
                  scope_force_trigger(&scope);
              }
          }
      }

      // If scope is in continuous mode and idle, trigger next capture
      if (scope_is_continuous(&scope) && scope.state == SCOPE_STATE_IDLE) {
          scope_start(&scope, scope.continuous);
      }
    /* USER CODE END WHILE */

    /* USER CODE BEGIN 3 */
  }
  /* USER CODE END 3 */
}

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
