keneth-urbizagastegui/S3G4-LAB/firmware/stm32_firmware/s3g4_scope_fw.ioc

Mcu.UserName=STM32G473VETx
PA1.Signal=OPAMP6_VINM0
PA15.Signal=SPI3_NSS
PA3.Signal=OPAMP1_VINM0
PA4.Signal=COMP_DAC11_group
PA5.Signal=COMP_DAC12_group
PA6.Signal=COMP_DAC21_group
PA7.Signal=OPAMP1_VINP
PB0.Signal=OPAMP3_VINP
PB13.Signal=OPAMP6_VINP
PB14.Signal=OPAMP5_VINP
PB15.Signal=OPAMP5_VINM0
PB2.Signal=OPAMP3_VINM0
PC10.Signal=SPI3_SCK
PC11.Signal=SPI3_MISO
PC12.Signal=SPI3_MOSI
PD2.GPIO_Label=DATA_READY
PD2.Signal=GPIO_Output
PF0-OSC_IN.Signal=RCC_OSC_IN
PF1-OSC_OUT.Signal=RCC_OSC_OUT
