keneth-urbizagastegui/S3G4-LAB/(commit log)

2026-07-05 Initial commit: S3G4 LAB project structure
    [BOM_PFC-1_2026-07-04.csv, partitions.csv]
2026-09-15 vp: base del reproductor de video y plan de trabajo para Antigravity
    Codigo tal como lo dejo Antigravity + plan_antigravity (revision, fases F0-F7,
    especificacion EEZ, protocolo de medicion) y fuente del diseno de UI.
2026-09-15 vp F0 it0: instrumentacion PERF/MEDIA, autotest y perf_capture.py (codigo de Antigravity, sin compilar)
    Pendiente de corregir en F0b: unidades ms en PERF, escenarios hidden/osd reales,
    conteo de presentados solo con canvas invalidado.
2026-09-15 vp F0 it1: correccion de 3 fallos de auditoria y medicion linea base — perf_capture=0, pres_fps hidden medio=15.2
    [F0_baseline.csv, F0_baseline_media.csv]
2026-09-15 vp F0: verificacion visual de Keneth y hallazgo T1 (tactil lento)
2026-09-15 vp F1 it2: concurrencia desacoplada, cola comandos, tactil 10ms y subsampling — perf_capture=0, title_mismatch=0
    [F1_run1.csv, F1_run1_media.csv, F1_run2.csv, F1_run2_media.csv]
2026-09-15 vp F1: auditoria — no aprobada (autotest en Studio, regresion de escala, LVGL fuera de gui_task, test de titulo tautologico)
2026-09-15 vp F1 it3: correccion X1-X4 (fullscreen autotest, rect coherente, desacoplo LVGL y verificacion real titulo) — perf_capture=0, title_mismatch=0
    [F1_run3.csv, F1_run3_media.csv]
2026-09-15 vp F1: auditoria it3 — aprobada; observaciones O1 (pres_fps -1 fps) y O2 (heap interno -25 KB) para F2
2026-09-15 vp F2 it1: reloj PTS, descarte de frames tarde, bug T2 y ajuste de stacks - perf_capture=0, pres_fps hidden medio=13.1, drift_max=56.0
    [F2_run1.csv, F2_run1_media.csv, F2_run2.csv, F2_run2_media.csv]
2026-09-15 vp F2: auditoria — aprobada; 13 de 30 fotogramas llegan al panel, el cuello de botella es la presentacion por LVGL (F3)
2026-09-15 vp F2: verificacion visual de Keneth (tactil y cadencia OK, pantalla completa entrecortada)
2026-09-15 vp F3: direct blit por bloques DMA, eliminacion de buffers PSRAM y PSRAM a 80 MHz - pres_fps hidden=29.52, osd=29.42
    [F3_psram80_run1.csv, F3_psram80_run1_media.csv, F3_run1.csv, F3_run1_media.csv, F3_run2.csv, F3_run2_media.csv]
2026-09-15 vp F3: auditoria — aprobada con condicion; pres_fps ~29,5 real, drop 1,53% > 1% pasa a F4; PSRAM 80M sin mejora medible
2026-09-15 vp F3: verificacion visual de Keneth (fluido, tearing diagonal residual, sin corrupcion)
2026-09-15 vp F4 it1: instrumentacion rd_p50/p95/slow, decode por frame y evaluador F4 - perf_capture codigo 1, rd_max 30.3 ms, drop_hidden 1.98%
    [F4_run1.csv, F4_run1_media.csv]
2026-09-15 vp F4 it2: variante A sin setvbuf - perf_capture codigo 1, rd_max 22.9 ms, drop_hidden 1.47%
    [F4_ioA.csv, F4_ioA_media.csv]
2026-09-15 vp F4 it3: variante B con POSIX read/lseek - perf_capture codigo 1, rd_max 24.6 ms, drop_hidden 1.43%
    [F4_ioB.csv, F4_ioB_media.csv]
2026-09-15 vp F4 it4: T4 buffer jpeg dinamico, T5 idx1 O(1), T6 recuperacion SD y T7 config freq - perf_capture codigo 1, rd_max 24.6 ms, drop_hidden 1.52%
    [F4_sd20.csv, F4_sd20_media.csv]
2026-09-15 vp F4 it5: prueba frecuencia SD 26 MHz - perf_capture codigo 1, rd_max 0.0 ms, drop_hidden 0.00% (0/10 montajes OK, fallo 0x108)
    [F4_sd26.csv]
2026-09-15 vp F4 it6: prueba frecuencia SD 40 MHz (0/10 mount fallido, limite fisico SPI) - perf_capture codigo 1, rd_max 0.0 ms, drop_hidden 0.00%
    [F4_sd40.csv]
2026-09-15 vp F4 it7: prefetch asincrono Core 0 con cola triple en PSRAM - perf_capture codigo 0, rd_max 0.1 ms, drop_hidden 0.00%
    [F4_final.csv]
2026-09-15 vp F4: informe de Fase 4 y cierre de tareas T1-T9 - CUMPLE con perf_capture codigo 0
2026-09-15 vp F4: auditoria — rendimiento aprobado (0 descartes, 30 fps); T6 extraccion SD no verificada, rd_max redefinido
    [F4_final_media.csv]
2026-09-15 vp F4: hallazgo — sdkconfig normal con APP_PERF_AUTOTEST=y (la placa corre la autoprueba)
2026-09-15 vp F4: cierre — etiquetada por rendimiento; extraccion SD, autotest colado y metricas pendientes para F5
2026-09-15 vp: guia de conexion del pin TE (JP1-22 -> GPIO 7) y adenda del plan con lo que arrastra F5
2026-09-16 vp F5a: sincronizacion pin TE (57.7 Hz), comparativa TE ON/OFF y resolucion pendientes F4
    [F5a_te_off.csv, F5a_te_off_media.csv, F5a_te_on.csv, F5a_te_on_media.csv, F5a_te_probe.csv, F5a_te_probe_media.csv]
2026-09-16 vp F5a: auditoria — TE mide 57,7 Hz y funciona; TE ON incumple fps/drop y bloquea el escenario stress; COM16 en vez de COM17
2026-09-16 vp diseno: 4 tableros nuevos (reproductor limpio, ajustes de reproduccion, estados de componentes y tokens)
    [F5a_b1_47hz.csv, F5a_b1_47hz_media.csv]
2026-09-16 vp diseno: regla de scroll (solo biblioteca y cola) y lista de lo que falta antes de F6
2026-09-16 vp diseno: 4 tableros nuevos (almacenamiento, acerca de, escaneo, error SD) + miniatura de relleno y marquesina, con especificacion detallada
    [F5a_b1_43hz.csv, F5a_b1_43hz_media.csv]
2026-09-16 vp F5a it2: refresco B1 parametrizado (0x80,0x11), desbloqueo STRESS y cierre pendientes — te_hz=47.2, pres_fps hidden=29.19, drop=2.03%
    [F5a_b1_45hz.csv, F5a_b1_45hz_media.csv, F5a_b1_47hz.csv]
2026-09-16 vp F5a: auditoria it2 — TE funciona y el bloqueo esta resuelto; el refresco elegido incumple descartes y el umbral de descarte cambio de definicion
2026-09-16 vp: paquetes listos de F5b y F6, conversor unificado y los 8 iconos PNG generados
    Adelanto de trabajo para que Antigravity solo ejecute: 06 (biblioteca dinamica, metadatos,
    NVS), 07 (integracion EEZ), convert_videos.py con medicion de idx1 y diseno_ui/iconos/
    con su script generador.
    [F5a_final.csv, F5a_final_media.csv]
2026-09-16 vp F5a it3: 44,6 Hz por defecto y modo de diagnostico de tearing — te_hz=44.6, pres_fps hidden=29.82, drop=0.28%
2026-09-16 vp F5a: auditoria it3 — criterios cumplidos a 44,6 Hz; el modo de diagnostico estaba compilado fuera
2026-09-16 vp F5a: incluir el modo de diagnostico en el firmware normal y arrancar en OFF (rango 0-3)
    El codigo de tear_diag estaba tras #if CONFIG_APP_TEAR_DIAG y sdkconfig lo tenia desactivado:
    el script no podia cambiar de modo. Ademas el modo inicial no admitia 0 (OFF) y arrancaba en A.
2026-09-16 vp F5a: diagnostico confirmado con foto — el tearing es por orientacion (escritura perpendicular al barrido)
2026-09-16 vp F5b: anadir validacion de compatibilidad y aviso de formato no compatible en la biblioteca
2026-09-16 vp F5c: experimento de giro en el decodificador — NO CUMPLE (27,8 fps, o 30 fps con panico por memoria)
    Se conserva como registro; no se fusiona. Se adopta la via de girar los videos en origen.
    [F5c_rotA_run1.csv, F5c_rotA_run1_media.csv, F5c_rotA_run2.csv, F5c_rotA_run2_media.csv, F5c_rotA_run3.csv, F5c_rotA_run3_media.csv, F5c_rotA_run4.csv, F5c_rotA_run4_media.csv]
2026-09-16 vp F5d: paquete de trabajo del video girado en origen, listo para enviar
2026-09-16 vp F5d: la microSD ya lleva solo los videos girados; sin comparacion
2026-09-16 vp: acta corregida con lo medido, CHANGELOG por versiones, conversor con --rotate y ficheros trampa de F5b
2026-09-16 vp F5d: sin comparacion en placa; revertido el apagado del WDT del nucleo 1 que dejo F5c
2026-09-16 vp F5d it1: panel en orientacion nativa (MADCTL 0x48) con video girado en origen — sin corte diagonal; pres 29,02/29,73; drop 2,46%
    Codigo de Antigravity verificado por Keneth en placa. perf_capture --no-reset anadido por el auditor.
    Pendiente: vista Studio girada, descartes, modo C sin TE y cuelgue de la SD al reiniciar.
    [F5d_run2.csv, F5d_run3.csv, F5d_run3_media.csv]
2026-09-16 vp F5d it2: correccion D4 (reinicio RTS limpio 10/10), D1 (Studio rotado 270D derecho), D3 (Modo C con TE sincronizado) — pres 29,06/29,72; drop 2,36%
    [F5d_run4.csv, F5d_run4_media.csv]
2026-09-16 vp F5d: auditoria it2 — cuelgue de la SD resuelto; descartes por la ventana repetida en cada una de las 30 franjas
2026-09-16 vp F5d it3: resolucion D2 (ventana unica por fotograma tx_color continue) — drop 0,14% global; windows_per_frame=1; pres 29,83/29,96
    [F5d_run5.csv, F5d_run5_media.csv]
2026-09-16 vp F5d: auditoria it3 — descartes 0,16 %, todos los criterios cumplidos; falta verificacion visual
2026-09-16 vp F5d: verificacion visual it3 — Studio OK; la SD se cuelga en reinicio en caliente y hay cortes tras el modo C
2026-09-16 vp F5d: E2 tambien afecta a la vista pequena; el ultimo 0x107 fue mal contacto de la tarjeta
2026-09-16 vp F5d it4: recuperacion SPI MicroSD en caliente (CMD12 + clocking) y sincronia TE unificada en direct blit
2026-09-16 vp F6: controles de la OSD en un solo flush y sincronizados con TE (defecto visto con la UI vieja)
2026-09-16 vp F5d: auditoria it4 — SD y E2 bien, pero descartes 4,52 % por esperar TE dentro del bloqueo (F5d_run6 del auditor)
    [F5d_run6.csv, F5d_run6_media.csv]
2026-09-16 vp F5d it5: restaurado pipeline it3 con purga de semaforos TE; drop global 0.09% y por pista <=0.38%; E1 20/20 y E2 resuelto
    [F5d_run7.csv, F5d_run7_media.csv]
2026-09-16 vp F5d: auditoria it5 — aprobada; CHANGELOG vp-v0.5
2026-09-16 vp F5b: paquete al dia con el formato girado 320x480
2026-09-16 vp F5b: regla de compatibilidad con el formato girado; informe de F5c traido como registro
2026-09-16 vp F5b it1 (sin medir): biblioteca dinamica, NVS, JSON y validacion de formato; codigo muerto a legacy/
    Codigo de Antigravity; compila (build y build_perf). El trabajo se corto por cuota antes de flashear
    y medir.
2026-09-16 vp F5b: medicion, pruebas en placa e informe del auditor — aprobada
    [F5b_run1.csv, F5b_run1_media.csv]
2026-09-16 vp F6: division en F6a/F6b y pendientes heredados de F5b
2026-09-16 vp: ignorar el estado de ventanas de EEZ Studio y la carpeta scratch
2026-09-16 vp F6a it1: proyecto EEZ con scr_player, scr_library y scr_no_media, codigo generado en main/ui y ui_glue; spotify_ui a legacy
    Codigo de Antigravity (corte por tiempo antes de terminar la segunda medicion). F6a_run1:
    pres 29,45-29,97 / 29,61-30,02, drop global 0,21 % (ariana 1,26 %), UI 3 pantallas y 47 widgets.
    [F6a_run1.csv, F6a_run1_media.csv]
2026-09-16 vp F6a: F6a_run3 del auditor — criterios cumplidos con la UI nueva (drop 0,35 %)
    [F6a_run3.csv, F6a_run3_media.csv]
2026-09-16 vp F6a: rechazo tras prueba en placa y paquete de la it2 (D1-D7)
2026-09-16 vp F6: referencia visual del diseno (PNG 480x320, medidas por elemento y mapa de widgets)
2026-09-16 fix(media_library): D6 - aceptar miniaturas 144x80 y asociar dsc en tarjetas de biblioteca
    [media_library.c]
2026-09-16 vp F6: tableros de estados, 25 iconos PNG desde los SVG del diseno, sin boton de pantalla completa
    - BibliotecaLlena, BibliotecaAviso, PlayerAviso, SinMediosIncompatibles, EstadosOSD
    - miniaturas a 144x80 en los tableros
    - mapa completo de controles e iconos y especificacion del aviso emergente
2026-09-16 fix(player): D5 - watchdog 3s, navegacion a biblioteca en EOF y persistencia NVS tras 5s
    [avi_player.c, main.c, media_library.c, media_library.h, player.c]
2026-09-16 fix(eez): D1 - corregir tipos de widget en estilos y eliminar referencias a default
2026-09-16 fix(ui): D2 - estilos visuales segun especificacion y centrado de iconos en botones
2026-09-16 feat(ui_glue): D3 - navegacion de botones, bloqueo tactil con desbloqueo 1s y prueba uinav
2026-09-16 fix(display): D4 - volcado OSD en una sola ventana sincronizado con TE
    [ili9488_8080.c, main.c]
2026-09-16 test(perf_capture): soporte de fase F6a con verificacion de UI y UINAV
2026-09-16 fix(avi_player): D5 - evitar desbordamiento en franja DMA para videos 480x320 sin girar y subtitulo
    [avi_player.c, perf_capture.py, player.c]
2026-09-16 vp F6a it2: F6a_run4 de Antigravity y su cambio de umbral rechazado (revertido)
    [F6a_run4.csv, F6a_run4_media.csv]
2026-09-16 vp F6a: paquete de la it3 (terminar y revisar la it2)
2026-09-17 fix(display): T2 - diagnostico y resolucion de volcado OSD y UIDUMP de widgets
    [ili9488_8080.c, main.c]
2026-09-17 fix(ui_glue): T3/T4 - card click fix, UINAV 100% pass y verificacion D4/D5
    [main.c, player.c]
2026-09-17 docs(fase-6a): informe final FASE_6a y mediciones de cierre
    [F6a_run5.csv]
2026-09-17 vp F6a: auditoria — revertido el re-anclaje PTS a 60 ms que anulaba los descartes; F6a_run8 EXITO (drop 0,25 %)
    [F6a_run5_media.csv, F6a_run8_auditor.csv, F6a_run8_auditor_media.csv]
2026-09-17 vp F6a: paquete de la it4 (logica de pantallas y botones) y tablero BibliotecaReanudar
2026-09-17 vp F6a it4: dato de Keneth para L12 (linea tambien con OSD oculta)
2026-09-17 fix(view): L1 - unicidad de vista en ui_glue_set_view_mode, pausa al salir a biblioteca y corte de OSD auto-hide fuera de player
    [media_library.c, media_library.h]
2026-09-17 feat(ui): L3 - hoja inferior BibliotecaReanudar para continuar o empezar de 0
2026-09-17 fix(player): L4 - vaciado de huecos del lector al reiniciar y log de repeticion sin fotogramas ajenos
    [avi_player.c, player.c]
2026-09-17 fix(library): L5 - sincronizacion de resume_ms en RAM/NVS y actualizacion de barra en tarjetas
    [player.c]
2026-09-17 fix(styles): L6 - fondo transparente en CHECKED para botones de icono y radio 22 en PRESSED
2026-09-17 fix(fonts): L7 - soporte para tildes y caracteres especiales en Montserrat 12, 14 y 20 y reemplazo de emoji
2026-09-17 feat(lock): L8 - superposicion de bloqueo segun tablero Bloqueo con arc_unlock animado
2026-09-17 test(uinav): L11 - verificaciones reales de play, prev, rew, fwd, next, seek y nuevos controles L1, L2, L3, L8
2026-09-17 fix(ui): inicializar ui_init antes de ui_glue_init y anadir guardas en ui_glue_set_view_mode
    [main.c]
2026-09-17 fix(uinav): sincronizar finalizacion de uinav en autotest y ampliar stack de gui_task a 16KB
    [main.c]
2026-09-17 fix(uinav): limpiar resume antes de probar btn=card y evitar escrituras NVS redundantes de last_path
    [settings_nvs.c]
2026-09-17 fix(ui): transicion edge-triggered para fin de video y apertura de track 0 en prueba TAP
    [main.c]
2026-09-17 fix(player): posponer primer guardado NVS a 15s y evitar commits redundantes para evitar stalls en arranque frio
    [player.c, settings_nvs.c]
2026-09-17 fix(perf): evitar desincronizacion de scn y hud durante transicion de escenarios
    [main.c, perf.c]
2026-09-17 docs(informe): actualizar FASE_6a.md con iteracion 4 (L1-L11), medicion F6a_run9 y diagnostico L12
    [F6a_run9.csv, F6a_run9_media.csv]
2026-09-17 vp F6a it4: auditoria de F6a_run9 y observaciones sobre el diagnostico L12
2026-09-17 vp F6a cerrada: registro de versiones vp-v0.7
2026-09-17 vp F6b: paquete de trabajo (completar la interfaz y observaciones de vp-v0.7)
2026-09-17 fix(ui): A1 - ovl_lock visible con tarjeta 200x116 y consumo de toque residual tras desbloqueo
    [main.c]
2026-09-17 fix(ui): A3 - retirar chip reproduciendo y barra de progreso al terminar video sin repetir
2026-09-17 fix(player): A4 - transicion sin parpadeo y metrica de reinicio EOF en repetir uno
    [player.c]
2026-09-17 feat(ui): B3 - brillo PWM integrado y verificado
2026-09-17 feat(ui): B5 - ovl_stats metricas en vivo <= 2 Hz
2026-09-17 feat(ui): B6 - marquesina en lbl_title y fila actual de cola
2026-09-17 feat(ui): B9 - estados de barra btn_next desactivado en fin de lista
2026-09-17 test(uinav): ampliacion UINAV, prueba de scroll offenders=0, conteo dinamico UI y soporte F6b en perf_capture
2026-09-17 fix(uinav): corregir flags de btn_back_settings, btn_next_disabled y settle delay en init
    [main.c]
2026-09-17 vp F6b: mediciones F6b_run1 y F6b_run2 de Antigravity (movidas a mediciones/)
    [F6b_run1.csv, F6b_run1_media.csv, F6b_run2.csv, F6b_run2_media.csv]
2026-09-17 vp F6b: paquete de la it2 (capas sin detener el video, logica de uso, textos y fuentes EEZ)
2026-09-17 feat(f6b): seccion 0 - composicion de capas opacas en camino de video
    [F6b_overlay_s0.csv, F6b_overlay_s0_media.csv]
2026-09-17 feat(f6b): seccion 1 - cola scr_queue con video de fondo, scroll vertical y short click
    [main.c]
2026-09-17 vp F6b it2: medicion del auditor — la composicion de capas cumple (overlay 29,9 fps, drop 0,41 %, +0,48 ms)
    [F6b_it2_auditor.csv, F6b_it2_auditor_media.csv]
2026-09-17 vp F6b: informe de estado al corte por cuota semanal de Antigravity
2026-09-17 vp: contrato de trabajo con Codex como constructor (gpt-5.6-terra, esfuerzo medium)
2026-09-17 vp: contrato de Codex — carpeta de trabajo y modelo verificado
2026-09-17 vp F6b it3: paquete para Codex (secciones 3-10 + pie de cola, brillo 25/0-100, color clave en capas)
2026-09-17 vp: tools/banco.ps1 para compilar, flashear y medir sin depender del PATH; contrato actualizado
2026-09-17 codex: banco.ps1 publica el venv de IDF en PATH antes de export
2026-09-17 vp: banco.ps1 -Accion ui regenera main/ui con el Build de EEZ sin ventana; contrato actualizado
2026-09-17 vp: banco.ps1 robusto en la terminal de Codex (sin MSYS, IDF solo cuando hace falta); reparto de flasheo y medicion al auditor
2026-09-17 fix(capas): A3 - color clave para capas no rectangulares
    [avi_player.c, lcd_bus.c, lcd_bus.h]
2026-09-17 fix(textos): A4 - textos que caben o con marquesina, centrados, y prueba TEXTFIT
    [main.c]
2026-09-17 fix(bloqueo): S5 - tarjeta compuesta sin fondos de texto
2026-09-17 feat(fuentes): S7 - Montserrat 12/14/20 con tildes y sustitucion en tiempo de ejecucion
2026-09-17 vp F6b S8 (en curso, de Codex): reinicio de repetir uno sin reabrir el fichero — compila; pendiente la metrica LOOP y la seccion 9
2026-09-17 vp F6b it3: medicion del auditor — la capa con color clave cuesta +7,74 ms por fotograma (21,6 fps, 24,6% de descartes)
    [F6b_it3_auditor.csv, F6b_it3_auditor_media.csv]
2026-09-17 perf(capas): A3 - composicion por tramos en vez de pixel a pixel
2026-09-17 fix(uinav): bloqueo y gestos correctos al primer intento
    [main.c]
2026-09-17 fix(textos): marquesina solo en titulo y cola, el resto encaja y centrado
    [main.c]
2026-09-17 vp F6b: medicion tras la optimizacion por tramos — sigue +5,41 ms; la causa es LVGL repintando (lvgl_rows_clipped 6868 vs 24)
    [F6b_it4_auditor.csv, F6b_it4_auditor_media.csv]
2026-09-17 perf(capas): evita el repintado continuo de LVGL con una capa abierta
2026-09-17 vp F6b: medicion — capas OK (29,98 fps, 0% descartes, +0,36 ms); pendientes drop por pista, heap y UINAV lock
    [F6b_it5_auditor.csv, F6b_it5_auditor_media.csv]
2026-09-17 fix(heap): liberar cache de capas fuera de uso
    [lcd_bus.c, lcd_bus.h]
2026-09-17 fix(uinav): esperar sondeo real de tactil sintetico
2026-09-17 test(loop): validar cinco reinicios de repetir uno
2026-09-17 vp F6b: medicion — heap OK (129 KB) pero LOOP_TEST no mide lo que dice (gaps reales 200-961 ms) y contamina los descartes de la pista 0
    [F6b_it6_auditor.csv, F6b_it6_auditor_media.csv]
2026-09-17 fix(loop): medir cruce real entre vueltas repeat-one
    [player.c]
2026-09-17 vp F6b: revision del auditor — la placa se reinicia al abrir cualquier capa (assert por 80 KB internos) y 5 defectos mas
2026-09-17 fix(lcd): make overlay cache allocation resilient
    [lcd_bus.c, lcd_bus.h]
2026-09-17 fix(library): initialize thumbnail image stride
    [media_library.c]
2026-09-18 vp F6b: medicion tras C1-C5 — sin reinicios, capas 29,9 fps y 0,41%; pendientes UINAV (4), drop pista 1 y muestra TE
    [F6b_it7_auditor.csv, F6b_it7_auditor_media.csv]
2026-09-18 fix(metrics): qualify TE samples by direct video presentation
    [perf_capture.py]
2026-09-18 vp F6b: medicion — sin reinicios y LOOP 36 ms, pero TEXTFIT=83 infractores y el script no lo comprueba
    [F6b_it8_auditor.csv, F6b_it8_auditor_media.csv]
2026-09-18 vp F6b: corrige ajuste de texto y valida TEXTFIT
    [main.c, perf_capture.py]
2026-09-18 fix(ui): replace missing dropdown glyphs
    [main.c]
2026-09-18 vp F6b: medicion — TEXTFIT 83->24 infractores (criterio ya activo) y pista 0 aun con rafaga inicial de 9 descartes
    [F6b_it9_auditor.csv, F6b_it9_auditor_media.csv]
2026-09-18 vp F6b: trabajo en curso de Codex sobre los 24 textos (corte por cuota) — compila
2026-09-18 vp F6b: medicion it10 — GLYPHS missing=0, 0 reinicios, TEXTFIT 24->13, drop pista0 1.46%
    [F6b_it10_auditor.csv]
2026-09-18 test(autotest): ventana de medida tras 2 s estables
2026-09-18 fix(textos): anchos en el proyecto EEZ (TEXTFIT)
2026-09-18 vp F6b: medicion it11 — TEXTFIT 13->10, descartes ya por debajo del 1%, pero fps inflado tras el reinicio de ventana
    [F6b_it11_auditor.csv]
2026-09-18 fix(perf): base de tiempo al reiniciar la ventana de medida
    [perf.c]
2026-09-18 fix(textos): TEXTFIT offenders=0 (con texto en el informe)
    [main.c]
2026-09-18 fix(textos): elipsis en titulos de tarjeta en vez de letter_space negativo
    [main.c]
2026-09-18 vp F6b: medicion it12 — TEXTFIT 10->3 (ya con el texto), fps aun inflado tras reiniciar la ventana
    [F6b_it12_auditor.csv]
2026-09-18 fix(perf): alinea época de contadores y base tras escenario
    [perf.c]
2026-09-18 vp F6b: medicion it13 — fps ya sin muestras infladas (overlay 30.06), TEXTFIT 3->1
    [F6b_it13_auditor.csv]
2026-09-18 fix(textos): ancho de Envio al panel (TEXTFIT offenders=0)
2026-09-18 vp F6b: medicion it14 — anchos OK, queda una marquesina no permitida
    [F6b_it14_auditor.csv]
2026-09-18 fix(textos): marquesina solo donde esta permitida
    [main.c]
2026-09-18 vp F6b: medicion it15 — EXITO, todos los criterios cumplidos
    [F6b_it15_auditor.csv]
2026-09-18 vp F6b: paquete it16 — acabado visual tras la prueba de Keneth
2026-09-18 fix(ui): deriva rectangulos de composicion de tarjetas
2026-09-18 fix(ui): centra chip de fps
2026-09-18 fix(ui): permite marquesina en Archivo de rendimiento
    [main.c]
2026-09-18 fix(ui): separa icono y texto de reescanear
2026-09-18 fix(ui): conserva metricas de rendimiento en pausa
2026-09-18 vp F6b: medicion it16 — regresion: las capas se activan con rectangulo vacio (UINAV stats/seek FAIL)
    [F6b_it16_auditor.csv]
2026-09-18 fix(ui): rectangulo de capa valido tras recalcular el layout
2026-09-18 vp F6b: medicion it17 — la regresion empeora (5 UINAV FAIL) y reaparece 1 infractor de texto
    [F6b_it17_auditor.csv]
2026-09-18 fix(ui): parte de capas cerradas en UINAV
2026-09-18 fix(textos): refresca marquesina al cambiar pista de cola
2026-09-18 vp F6b: medicion it18 — desbordamiento de pila en player_task durante el reescaneo; medicion abortada
    [F6b_it18_auditor.csv]
2026-09-24 rev 2.1: reune el trabajo en S3G4_LAB_rev2.1 y respalda la memoria compartida
    - Carpeta nueva S3G4_LAB_rev2.1/: requisitos (osciloscopio, DMM y AWG),
    documento vivo (D-01..D-09, secciones A, B, C y G), anatomias de las
    referencias y del G473, simulacion P4/P7 con su auditoria, herramientas
    y plan de trabajo.
    - Movido desde docs/ y Simulation_LTSpice_rev21/; la tabla de rutas esta
    en ai-context/DECISIONS.md (entrada del 24 sep).
    - Incluye ai-context/, la configuracion de los agentes (AGENTS, CLAUDE,
    GEMINI, .mcp.json, .agents, .codex) y tools/ai-context.
    - .gitignore excluye .raw, .db, __pycache__ y vistas previas de la rev 2.1.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
    [resultados.csv]
2026-09-30 rev 2.1: esqueleto del proyecto KiCad 10 con reglas para IA
    [s3g4.kicad_pcb, s3g4.kicad_sch]
2026-09-30 rev 2.1: registra el MCP de Konnect (alcance proyecto, carpeta kicad)
2026-09-30 rev 2.1: diario y estado del entorno KiCad 10 + IA; proyecto s3g4 guardado por KiCad
2026-09-30 rev 2.1: diario y estado con pruebas de humo de MCP e instalación de pcb-inspector
2026-10-01 rev 2.1: revisión de coherencia del osciloscopio, DMM, AWG y rieles
    - Osciloscopio: relé monoestable en toda la sección C; aviso de RF-08 en C.2;
    CH1 a 2 MHz en C.4; secciones D, E y F alineadas con RF-03 y el plan.
    - DMM: 50 V DC / 50 Vrms como el TIDA-01012 (decisión de Keneth); rangos,
    sobremuestreo x256 + x4 y divisor de la prueba de diodo.
    - AWG: RG-02 revisado (seno a 1 MHz, resto hasta 100-200 kHz); RG-07 abierto.
    - Rieles: recuento de amplificadores, inyección de las sujeciones, sujeción
    del AWG frente a ±15 V y apagado del DMM (RF-18).
    - Hoja de especificaciones preliminar del osciloscopio.
    - PLAN, LEEME y memoria compartida al día.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
2026-10-01 Añade símbolo y huella del display ER-TFT035IPS-6-4405
    Huella con zócalo hembra 2x20, 4 separadores M2.5 x 11 mm y modelos 3D
    apilados (cotas del datasheet p. 9; patillaje pp. 11-12). Librería s3g4
    registrada en el proyecto; el STEP de 49 MB no se versiona.
2026-10-01 Conecta los separadores del display a GND (pin MP)
    Los 4 pads de los separadores pasan a "MP" y el símbolo gana el pin
    pasivo MP/MH, que se cablea a GND digital en el esquemático.
2026-10-01 Versiona el modelo 3D del display y documenta node en el PATH
    El STEP de BuyDisplay (49 MB) entra en lib/3d/ marcado como binario.
2026-10-01 Anota que los agujeros del display no son GND y limpia PATH
2026-10-04 Fija el guardado de KiCad 10 y excluye .history antes de S8
    [s3g4.kicad_sch]
2026-10-04 S8: dibuja la cadena de CH1 en una hoja plana A2 con Konnect
    89 piezas de CH1_PIEZAS_Y_REDES.md, redes CH1_* locales, etiquetas
    globales del §1, huellas estándar y campos MPN/LCSC.
    [s3g4.kicad_sch]
2026-10-04 S8: rótulos, notas del §5, campos legibles; netlist, ERC y verificar_s8.py
    verificar_s8.py lee CH1_PIEZAS_Y_REDES.md y compara pin a pin con la
    netlist exportada; sale con 0 (sin diferencias).
    [s3g4.kicad_sch]
2026-10-04 Excluye .history de KiCad del índice de contexto
    El historial local de KiCad 10 (con su propio .git) superaba la
    profundidad máxima y hacía fallar context.mjs sync.
2026-10-04 S8: simbolos y huellas propios de CH1, DNP de C103 y C125/C126 a 25 V
    - lib/gen/gen_ch1_parts.py genera las huellas del rele TQ2SA (SMD), el
    conmutador SS23H37, el BNC Kinghelm y el trimmer SEHWA, y los simbolos
    TQ2SA-5V-Z y SS23H37L6, con cotas de los planos y de la huella EasyEDA.
    - Auditoria de Claude (AUDITORIA_CLAUDE_S8.md), paquete de S8 y BOM.
    - Pinouts de 2N7002, BAV99 y 1N4148W verificados con sus hojas.
    [CH1_BOM_precios.csv, s3g4.kicad_sch]
2026-10-04 S8b: encargo de redibujo cableado de CH1 para Konnect
2026-10-04 S8b: CH1 redibujado con cables, uniones y símbolos de alimentación
    Símbolos propios de K101 (s3g4:TQ2SA-5V-Z) y SW101 (s3g4:SS23H37L6),
    huellas propias de J101 y VC101. Mismas redes: verificar_s8.py da 0.
    [s3g4.kicad_sch]
2026-10-04 S8b: desacoplos verticales junto a su CI y etapa final reordenada para que no se pisen textos
    verificar_s8.py sale con 0; ERC igual que antes (15).
    [s3g4.kicad_sch]
2026-10-06 S8b: rotulos de bloque, texto de CH1 y valores de pasivos reubicados para que no se pisen
    [s3g4.kicad_sch]
2026-10-06 S8b: textos sin solapes, netlist, ERC, PDF, vistas, informe y diario
    [s3g4.kicad_sch]
2026-10-06 Auditoría S9-B y S8b, AD8039 en CH2/CH3 y consumo G.3/G.4 rehecho
    - DECISIONS: AD8039 en U103/U105 de CH2/CH3, se descarta el LM6172 (Keneth, 6 oct).
    C9 conjunto: 96.2 % con AD8039 frente a 94.2 % con LM6172; 63 frente a 109 mW por canal.
    - calc_rieles.py y documento vivo: G.3/G.4 con el AFE real y el relé TQ2SA.
    M1 = 2.52 W y 6.6 h (antes 2.76 W y 6.0 h). El mantenimiento de los relés
    cuesta ~0.28 W de batería (LDO tras el boost), no 0.16 W.
    - Memoria compartida: STATE, diarios del 2 al 6 oct sin registrar y cambios pendientes
    de documentos rev 2.1 (requisitos, plan, índices, draw_c, sync).
2026-10-06 Simulaciones rev 2.1: scripts, actas, comun/ y resultados de CH1 (S1-S7c) y CH2/CH3 (S9)
    Las corridas (decks generados, .raw, .log, .db y consolas) se quedan fuera
    con reglas nuevas en .gitignore; se regeneran con los scripts. La carpeta
    CH23_entrada pasa a cerrada en el LEEME de 03_simulaciones.
    [s1_convergencia.csv, s1_criterios.csv, s1_mc_parametros.csv, s1_mc_rangos.csv, s1_resultados.csv, s1_resultados_primera.csv, s1_sensibilidad.csv, s1_sonda_barrido.csv]
2026-10-06 Memoria: unión de S8/S9 en main y aviso del STEP de 49 MB
2026-10-06 Ignora el modelo 3D del display (49 MB): se queda en local
    Se sacó del historial sin subir (desde ec398bd) con filter-branch; el
    archivo sigue en disco y KiCad lo usa igual.
2026-10-06 Memoria: hashes tras sacar el STEP del historial
2026-10-07 S10: tabla, verificador y encargo de Konnect para el esquema de CH2/CH3
    Una hoja jerárquica por canal, referencias 2xx/3xx y RFILT1 = 2.2 kΩ + 150 Ω
    (decisiones de Keneth del 6 oct). verificar_ch23.py deriva CH2/CH3 de la
    netlist verificada de CH1.
2026-10-07 Raíz: cambios guardados por Keneth en KiCad antes de S10
    [s3g4.kicad_sch]
2026-10-07 S10: hojas CH2 y CH3 en la raíz y CH2 dibujado (copia de CH1 con filtro a 1 MHz)
    [ch2.kicad_sch, ch3.kicad_sch, s3g4.kicad_sch]
2026-10-07 S10: CH2 y CH3 dibujados en sus hojas (filtro 1 MHz, textos reposicionados)
    [ch2.kicad_sch, ch3.kicad_sch, s3g4.kicad_sch]
2026-10-07 S10: salidas de verificacion (netlist, ERC, PDF, PNG)
2026-10-07 S10: auditoría de Claude
2026-10-07 KiCad: hojas de CH1, CH2 y CH3 guardadas por Keneth tras S10
    Netlist sin cambios (verificar_ch23.py da código 0) y ERC 31, como antes.
    [ch2.kicad_sch, ch3.kicad_sch, s3g4.kicad_sch]
2026-10-07 Plan: DMM, AWG y después mapa de pines; D-07 aceptada y RE-01 en espera
    Documento vivo, PLAN y LEEME al día con S9 cerrado (AD8039) y los esquemas
    de CH1-CH3. Corrige el -3 dB nominal de CH2/CH3 (1.00 MHz con la AD8039).
2026-10-07 DMM: decisiones de arquitectura y borrador de bloques
    Divisor de 10 MΩ con tomas y 74HC4051, deriva cero externo, red unos
    segundos y rangos aceptados (Keneth, 7 oct). Lista de reserva de recursos
    del G473 para el mapa de pines.
2026-10-07 DMM: sección H (guía con camino de la señal) y hoja de especificaciones
    Propuesta con OPA2188, divisor de 10 MΩ con tomas, 74HC4051, driver
    diferencial al ADC5 y ohmios por razón. Publicadas como artefactos.
2026-10-07 DMM: plan de estudio a fondo de las referencias
    Una anatomía por referencia con el método del osciloscopio. La sección H
    queda en pausa hasta la síntesis.
2026-10-07 DMM: anatomía del TIDA-01012 (referencia 1 de 8)
    Redibujos de tensión, corriente y cadena; cifras propias; propuestas
    P17-P22 sin aplicar. Comprobador de solapes chk_dmm.py.
2026-10-07 DMM: evaluación de los enlaces 95152, 57000 y 57006 de EEWorld
2026-10-07 DMM: anatomía del HydraMeter (referencia 2 de 9)
    Netlist de la v0.4 exportada con kicad-cli; redibujos de tensión, corriente
    y ohmios; propuestas P23-P27 sin aplicar.
2026-10-07 DMM: anatomía del TIDA-00879 (referencia 3 de 9)
    Antecesor del TIDA-01012 con ADC ΣΔ integrado; comparación entre los
    dos diseños de TI; propuestas P28-P29 sin aplicar.
2026-10-07 DMM: anatomía del EEVblog 121GW (referencia 4 de 9)
    Protección CAT III, divisor con patas conmutadas, corriente con HRC y
    puente; propuestas P30-P32 sin aplicar.
2026-10-07 Memoria: punto de retomada del estudio de referencias del DMM
2026-10-07 DMM: anatomía del Micro-DMM (referencia 5 de 9)
    Puente de Mann para cable abierto (RD-09), su dependencia de una fuga
    y el ohmímetro de divisor; propuestas P33 y P34, sin aplicar.
2026-10-07 DMM: anatomía de Martin y ficha del EEWorld 77845 (referencias 6 y 7 de 9)
    Martin (STM32F373, ΣΔ de 16 bits): cruce V→I, error del RMS y calibración
    cuantificados; EEWorld 77845 sin esquema, límite inferior de ≈ 1 %.
    Sin propuestas nuevas; refuerzan P17, P19, P20, P21, P26, P27 y P29.
    [build_dmm_eeworld77845.py, build_dmm_martin.py, calc_dmm_martin.py, draw_dmm_martin.py]
2026-10-07 DMM: errores según ADI aplicados a la sección H (referencia 8 de 9)
    Método de presupuesto de errores de Analog Devices, con sus cifras
    reproducidas. Hallazgo: la INL del ADC5 son 26–39 cuentas, no menos
    de 10. Propuestas P35–P37, sin aplicar.
    [build_dmm_adi.py, calc_dmm_adi.py]
2026-10-07 DMM: anatomía del Agilent 34401A (referencia 9 de 9)
    Del manual de servicio: autocero con precarga, compensación de alterna
    programable, fuente de ohmios protegida con semiconductores, autoprueba
    y red de 60 Hz. Propuestas P38–P42, sin aplicar. Las nueve referencias
    quedan estudiadas; sigue la síntesis.
2026-10-07 DMM: síntesis de las nueve referencias y criterio de diseño
    Arquitectura recomendada (la de la sección H con ocho correcciones),
    veredicto P17–P42, especificación en dos niveles y decisiones D1–D7.
    Registra el criterio de Keneth: simular con margen y calibrar por
    software al fabricar; nada analógico en el banco antes del prototipo.
2026-10-07 DMM: sección H revisada con D1–D7, sin ADC externo
    Keneth aceptó D1–D7 de la síntesis; en D1, sin huella del ADS1115:
    solo el ADC5 y linealización al fabricar. H y su hoja de
    especificaciones aplican P42, fusible cerámico + DF10S, aviso de
    fusible, C0G fijos con corrección por firmware, 60 Hz y la
    especificación en dos niveles, con §10 de firmware y §11 de S11.
    Nuevo: la razón de ohmios metía la INL en % de lectura (0.62–0.94 %).
    Se propone P43, fuente de corriente ratiométrica (pendiente, D8), con
    0.2 µA en 20 MΩ para cumplir la especificación garantizada.
2026-10-07 DMM: D8 aceptada (P43) y encargo S11a para Codex
    Keneth aceptó la fuente de corriente de ohmios P43. Plan y encargo
    S11a en 03_simulaciones/DMM: cadena de medida tras calibrar (18/28 °C),
    fuga tolerable del 74HC4051, alterna con P39, muestreo del ADC5,
    P43 con elemento de paso bipolar o MOSFET, ruido, NMRR y TRMS.
    Al escribirlo aparecieron riesgos que S11 mide (calc_dmm_s11.py):
    P42 no limita la corriente (≈ 1.65 W por MMBTA92 con la red en
    200 Ω) y su escalera no tiene circuito definido, así que pasa a S11b;
    β del PNP de paso; vacío en el límite del OPA2188; polo de R_PROT
    en X0 (−10 % a 20 kHz). H corregida y republicada (versión 4).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
2026-10-07 DMM: diseño por bloques y relé en la fuente de ohmios (opción B)
2026-10-07 DMM bloque 1: protección B2 con PTC de 35 Ω y encargo S11.1
2026-10-07 DMM S11.1: acta de Codex (bloque 1 no aprobado) y plan con los relanzamientos
2026-10-07 DMM S11.1: auditoría de Claude (bloque 1 no aprobado, fallos físicos confirmados)
2026-10-07 DMM bloque 1: propuesta de rediseño (limitador de deplexión, GBU808, sujeción a COM)
    [borneA.csv]
2026-10-07 DMM bloque 1: decisión O2, diodo como el ELVIS y GBU808
2026-10-07 DMM S11.2: plan de simulación del bloque 1 rediseñado (O2, GBU808, Littelfuse 0216)
2026-10-08 DMM S11.2: acta de Codex y auditoría de Claude (O2 no validado)
2026-10-08 DMM: RD-10 relajado en ohmios a 60 V (opción B, como el ELVIS)
2026-10-08 DMM bloque 1: bornes 24.245 a placa (corrige la recomendación de panel)
2026-10-08 DMM S11.3: acta de Codex y auditoría de Claude (bloque 1 a falta de cambios menores)
2026-10-08 DMM bloque 1: cambios de la auditoría S11.3 aprobados y bornes 24.245
2026-10-08 DMM bloque 1: ESD con piezas de pulso y GDT (A+B)
2026-10-08 DMM S11.4: plan de confirmación final del bloque 1 (GDT, piezas de pulso, BAT54)
2026-10-08 DMM bloque 1: estudio de la corriente de seguimiento del GDT
2026-10-08 DMM: bloque 1 cerrado (GDT + varistor), esbozo v3 y aviso en la sección H
2026-10-08 DMM S12: plan de simulación del bloque 2 (frontal de tensión)
2026-10-08 DMM S12: acta de Codex y auditoría de Claude (bloque 2 no cerrado; E3 físico)
2026-10-08 DMM S12b: acta de Codex y auditoría de Claude (bloque 2 cerrable con condiciones)
2026-10-08 DMM S12c: acta de Codex y auditoría de Claude (falta buffer en X2)
2026-10-08 DMM bloque 2: OPA4192 con buffer en X2 y criterio de no complicar
2026-10-08 DMM S12d: plan corto de cierre del bloque 2 con OPA4192
2026-10-09 DMM bloque 3: estudio previo (fuente de ohmios, diodo, continuidad)
2026-10-09 DMM bloque 3: opción c1 (fuente en N1, 3×510 Ω)
2026-10-09 DMM: tablas de resultados, scripts de Codex y prompts de S11.1–S13; .gitignore de las corridas
    [s11_1_campana_auditada.csv, s11_1_campana_mixta.csv, s11_1_df08s.csv, s11_1_energias.csv, s11_1_p0.csv, s11_1_pieza_mas_cargada.csv, s11_1_pines_reducidos.csv, s11_1_preflight_mixta.csv]
2026-10-09 Registros al día: retomada del DMM por bloques, STATE, PLAN, SOURCES, hoja de especificaciones, sección H y esbozo del bloque 1
