keneth-urbizagastegui/S3G4-LAB/(notices)

Notices in the files:
firmware/stm32_firmware/Core/Src/main.c:
Copyright (c) 2026 STMicroelectronics.
All rights reserved.
This software is licensed under terms that can be found in the LICENSE file
